VVCi/Graduate_Thesis/04_Multimedia/02_Images/2_08_2020/118745707_314784669589244_3505886685573848428_n.jpg

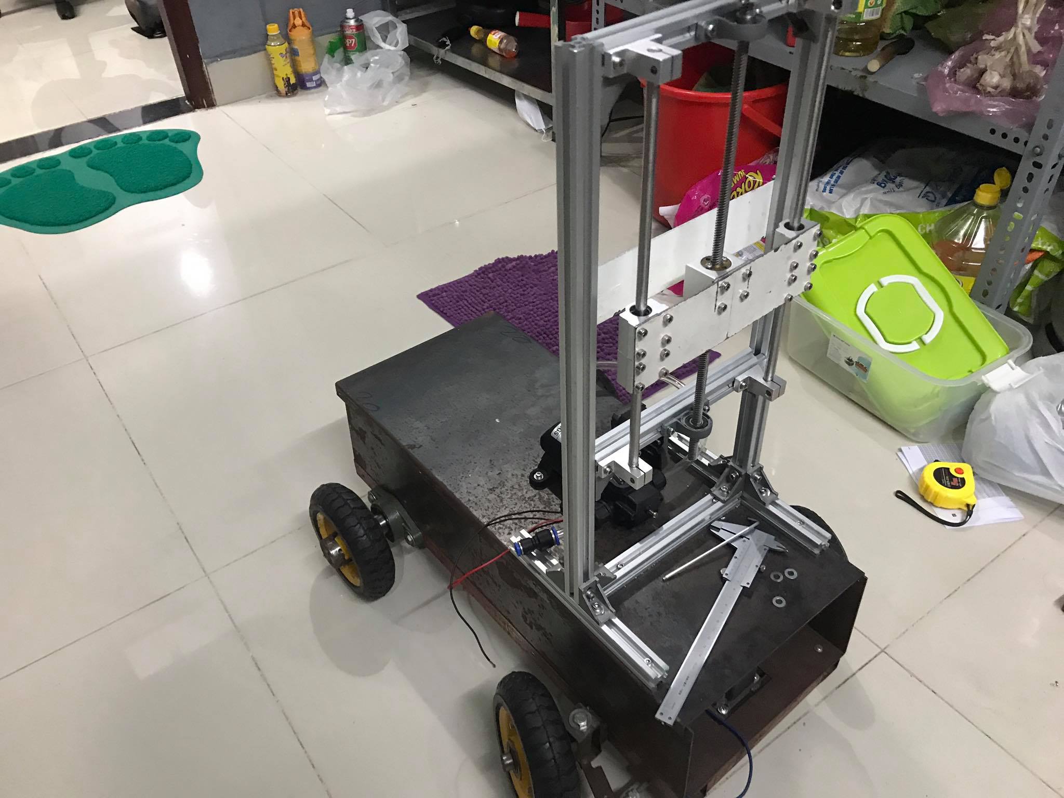
04_Multimedia/02_Images/2_08_2020/118745707_314784669589244_3505886685573848428_n.jpg
