VVCi/Graduate_Thesis/README.md

# Graduate_Thesis

/*
* @Mentor: PhD.Nguyen Vien Quoc - IUH
* @Research Subject: Semi-Automatic Pesticide Spraying Robot With Computer Vision Application (Thesis)
* @Author:
* - Vu Van Co
* - Nguyen Bao An
* - Nguyen Minh Hung
* - Nguyen Phuc Tho
* @Date: 12/2019 - 12/2020
*/
