VVCi/Graduate_Thesis/08_Report/Chapter05/Chapter05.docx

Chương 5 TÍNH TOÁN VÀ THIẾT KẾ GIẢI THUẬT ĐIỀU KHIỂN

5.1 Giới thiệu về giải thuật điều khiển động cơ

5.1.1 Giới thiệu tổng quan

Hệ thống (System) bao gồm nhiều phần tử vật lí được sắp xếp trật tự theo một thể thống nhất nhằm đáp ứng các yêu cầu cụ thể. Hệ thống này có thể là nhân tạo: Hệ thống điều khiển nhà máy thủy điện, Hệ thống pin năng lượng mặt trời, Hệ Cơ điện tử,.. hoặc là tự nhiên: Hệ mặt trời, Hệ thần kinh con người,…

Về điều khiển (Control) thường được mang nghĩa là hành động điều chỉnh, hành động này hướng đến những tác vụ hay mục tiêu nào đó có chủ ý. Điều khiển có thể là sự chủ động của con người và cả sự vận hành tự nhiên. Đối với tầm nhìn của đề tài, chúng ta chỉ xét đến những Hệ thống điều khiển nhân tạo do con người làm chủ.

Như vậy, hệ thống điều khiển được hiểu là một tập hợp sắp xếp trật tự các phần tử vật lý theo một thể, để nó có thể tự điều chỉnh, định hướng và thực thi tác vụ cho riêng bản thân nó hoặc cho các hệ thống khác.

Đối với mỗi hệ thống điều khiển tự động thì việc tìm ra giải thuật điều khiển là vô cùng quan trọng. Nó quyết định tính đúng đắn và khả năng đáp ứng của hệ thống. Về thực tế, hệ thống có thể “đơn giản” hay “phức tạp” cũng phụ thuộc vào mức độ phức tạp của giải thuật điều khiển.

Tuy nhiên, một hệ thống có thể hoạt động được mà không cần có một giải thuật điều khiển tốt hoặc thậm chí không cần đến giải thuật điều khiển, ta nói nó thuộc dạng hệ thống điều khiển hở hoặc hệ thống tự do hoạt động theo mức logic, theo sự điều khiển trực tiếp bằng con người. Các hệ thống muốn hoạt động ổn định hơn hoặc cần phải xử lí nhiều tác vụ cho các ngõ vào/ra khác nhau thì nên xem xét và được đưa vào các hệ thống điều khiển riêng biệt.

5.1.2 Thành phần cơ bản của hệ thống điều khiển

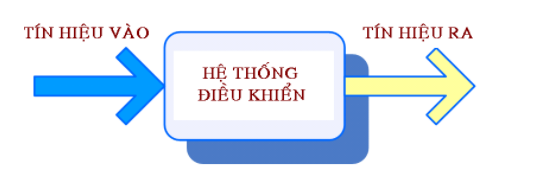
[picture p7: figure]

Hình 5 – Tổng quan về hệ thống điều khiển

Mục tiêu điều khiển còn được gọi là tín hiệu vào (input), hay các tín hiệu kích thích và kết quả nhận được từ hệ thống điều khiển còn được gọi là tín hiệu ra (output) hay các biến điều khiển.

Một cách tổng quát, đối tượng của hệ thống điều khiển được điều khiển để có các tín hiệu ra tuân theo qui định của tín hiệu vào thông qua các phần tử trong hệ thống điều khiển.

Tín hiệu vào là các tác nhân (hay kích thích) từ nguồn năng lượng ngoài cấp đến hệ thống điều khiển để tạo ra các đáp ứng mong muốn. Tín hiệu ra là các đáp ứng thực sự từ hệ thống điều khiển, có thể giống hay không giống đáp ứng mong muốn được xác định bởi các tín hiệu vào.

5.1.3 Lựa chọn giải thuật, phương pháp đề xuất

Đối với đề tài nghiên cứu, do đặc thù phải sử dụng nhiều loại động cơ với những chức năng khác nhau nên đòi hỏi cần phối hợp các bộ điều khiển khác nhau phù hợp với đặc tính tải của động cơ (được trình bày ở chương 2), có thể là “đơn giản” và cả “phức tạp”. Về cơ bản, chúng tôi sử dụng 2 bộ điều khiển chính, tạm thời được gọi là Bộ điều khiển vòng hở (open - loop) và Bộ điều khiển vòng kín (closed-loop). Cả hai bộ điều khiển này cũng thường được sử dụng trong kĩ thuật điều khiển, ứng dụng thực tiễn trong các hệ thống tự động của các ngành điện tử, viễn thông, cơ khí, ..

Bộ điều khiển vòng hở được sử dụng cho các động cơ sau trong đề tài:

- Động cơ bước DC (Stepper DC Motor) dùng cho cơ cấu nâng hạ dàn phun.

- Động cơ DC máy bơm (Normal DC Motor) dùng cho bộ phận bơm thuốc.

- Động cơ DC giảm tốc (Greared DC Motor) dùng cho tải chính robot.

Bộ điều khiển vòng kín được sử dụng cho các động cơ sau trong đề tài: Động cơ DC Servo (DC Servo Motor) cho bộ phận chuyển hướng robot.

5.1.4 Bộ điều khiển vòng hở

Đặc thù điều khiển của các dạng động cơ Stepper DC Motor, Normal DC Motor, Greared DC Motor như đã trình bày ở trên về cơ bản là gần giống nhau. Hơn thế, động cơ DC giảm tốc là động cơ chính của hệ robot nên chúng tôi chỉ khảo sát và trình bày rõ về bộ điều khiển hở cho động cơ này.

Về cơ bản, Bộ điều khiển vòng hở có tác động điều khiển độc lập với tín hiệu ngõ ra. Ưu điểm hơn cả của bộ điều khiển này là có khả năng đạt độ chính xác bằng phương pháp thử (calibrate). Việc thử là thành lập hoặc tái thiết quan hệ giữa ngõ ra và ngõ vào theo mức chính xác mong muốn. Hệ thống điều khiển vòng hở có ưu điểm nối trổi là dễ thiết lập quy tắc điều khiển và gọn nhẹ. Tuy nhiên, độ chính xác điều khiển thấp và không đem đến khả năng đáp ứng tốt của hệ thống là nhược điểm cố hữu của bộ điều khiển dạng này.

Controller
Object

Tín hiệu tác động (u)

Biến được kiểm soát (c)

Tín hiệu tham chiếu (r)

Hình 5 Tổng quan về bộ điều khiển hở

Để điều khiển động cơ Greared DC Motor (tạm gọi là động cơ DC), chúng tôi sử dụng phương pháp PWM (Điều chế độ rộng xung – Pulse Width Modulation).

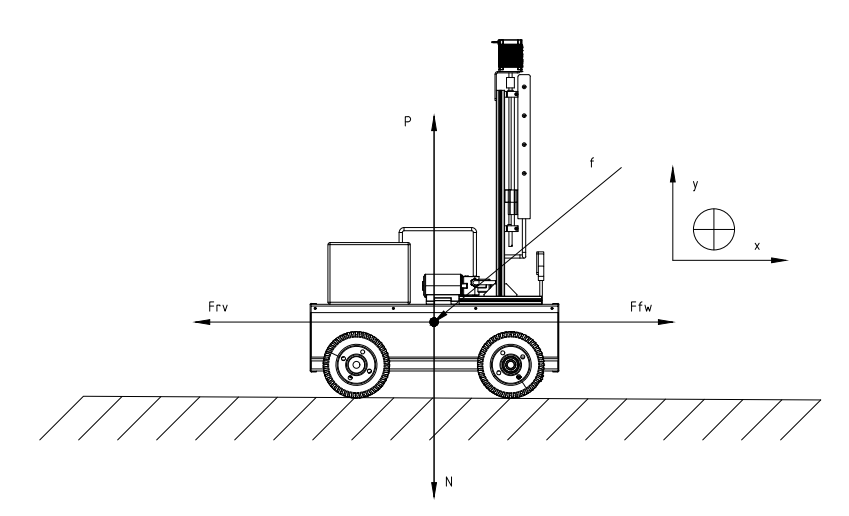
[picture p8: figure]

Hình 5 Mô hình chuyển động tới – lui của robot phun thuốc BVTV với các nội lực và ngoại lực

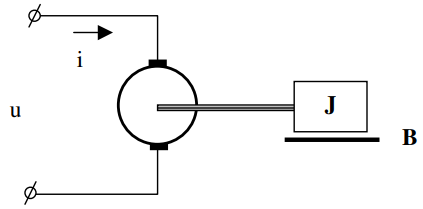
[picture p9: figure]

Trước hết, ta sẽ tìm hàm truyền đạt của động cơ, một mô hình của động cơ DC được khái quát với dạng như sau:

Giả sử từ thông Φ=const , J là moment quán tính quy về trục động cơ, B là hệ số ma sát của trục.

Phương trình quan hệ điện áp phần ứng:

u=Ri+L(di)/(dt)+e_u

e_u = K_e Φω

Suy ra:

u=Ri+L(di)/(dt)+ K_e Φω (5.1)

Phương trình quan hệ moment trên trục động cơ:

K_i Φω=J(dω)/(dt)+Bω (5.2)

Thay (5.1) vào (5.2), ta được:

u= R/(K_i) ( J(dω)/(dx)+Bω)+L/(K_i Φ) (J(d^2 ω)/(dt^2)+B(dω)/(dx))+ K_e Φω

- u=(LJ)/(K_i Φ) (d^2 ω)/(dt^2)+ (RJ+LB)/(K_i Φ) (dω)/(dt)+ ((RB)/(K_i Φ)+ K_e Φ)ω

Vậy:

U(p)= (a_2 p^2 +a_2 p+a_o ) ω(p)

Với a_2 = (LJ)/(K_i Φ) ; a_1 = (RJ+LB)/(K_i Φ) ; a_0 = ((RB)/(K_i Φ)+ K_e Φ)

Vậy hàm truyền đạt của động cơ là:

W(p)= (ω (p))/(U (p))= 1/(a_2 p^2 + a_2 p+ a_0) (5.3)

Ta sẽ thiết lập nguyên lí điều khiển động cơ với:

u: Tín hiệu vào là điện áp phần ứng động cơ

ω: Tín hiệu ra là góc quay của trục động cơ

e(t)=u.(t_H)/T (5.4)

Trong đó:

t_H (Time HIGH): Tần số động cơ được vận hành (s)

T : Chu kì điều khiển (s)

e(t): Hàm truyền đạt

Quan hệ ngõ vào – ra này trên lí thuyết có thể xem là tuyến tính, tuy nhiên trong điều kiện thực tế, giá trị đáp ứng của động cơ DC sẽ là phi tuyến, đồ thị duty sẽ xuất hiện nhiễu gai.

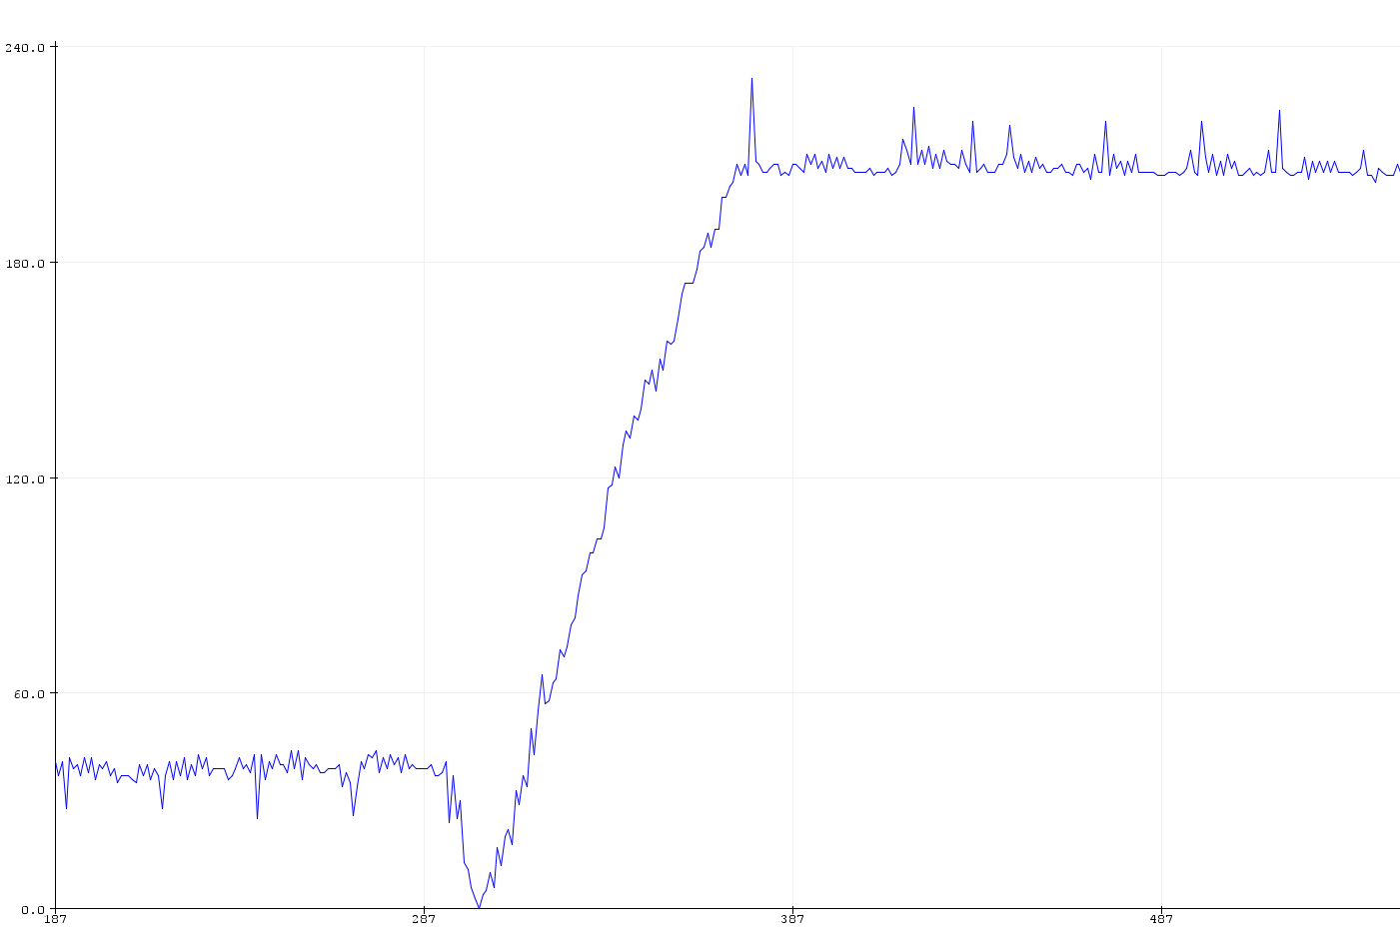
[picture p10: figure]

Nhiễu phi tuyến

Vùng hoạt động

Timing

Duty

Vùng “điểm chết” (dead zone) của động cơ

Hình 5 Đồ thị đáp ứng dạng phi tuyến của động cơ DC trong thực tế

Có thể tham khảo phần khảo sát đặc tính tải của động cơ DC tại chương 2 và phần thực nghiệm tại chương 6 để hiểu rõ hơn. Do đó với bộ điều khiển hở cho động cơ DC, cần có phương pháp tuyến tính hóa (Liner Regession) để quy về dạng tuyến tính, thuận tiện cho việc điều khiển.

Theo như sơ đồ nguyên lí của hệ thống được thiết kế từ đầu, động cơ DC hoàn toàn được điều khiển từ xung PPM từ tay cầm. Do đó chúng ta sẽ xét sự ảnh hưởng của xung này đến duty của động cơ theo thời gian. Xung PPM từ tay cầm FlySky FS – TH9X được trả về giá trị timing (ms) ( thời gian tín hiệu ở mức cao hoặc xung thấp)

Khảo sát lí thuyết từ MCU bằng hàm pulseIn(channel, timeout), trong đó

- channel: Kênh tín hiệu trả về từ bộ thu Reciever (chúng tôi sử dụng channel 1 ~ channel 4)

- timeout: Thời gian chờ

Hàm pulseIn() sẽ trả về data là một giá trị số (s) biến thiên tuyến tính từ thấp đến cao. Do đó chúng tôi dễ dàng mô hình phương thức điều khiển từ tay cầm về động cơ DC bằng bảng tham số của 3 trường hợp điều khiển như sau:

Trạng thái tay cầm | Gạt xuống thấp | Trạng thái ban đầu | Gạt lên cao
Xung PPM(s) - HIGH | 1050 | 1490 - 1510 | 1910
Duty Cycle (%) | 100 | 0 | 100
Điện áp cung cấp cho DC Motor (V) | 24 | 0 | 24
Trạng thái vận hành động cơ DC | Nhanh – Chạy nghịch | Chờ (Standby) - OFF | Nhanh – Chạy thuận

Việc chuyển đổi từ tín hiệu xung PPM từ tay cầm FlySky FS – TH9X sang tín hiệu Duty như mong muốn được thực hiện theo tiến trình như sau:

Digital I/O - Hàm đọc PPM pulseIn() từ Reciever
Chặn biên xung PPM - hàm chặn biên constrain()
Chuyển đổi tam suất tuyến tính - hàm chuyển đổi map()
Điều chế độ rộng xung PWM digitalWrite()Hình 5 – Tiến trình xử lí tín hiệu PPM thành tín hiệu PWM

Hàm đọc PPM pulseIn(): Hàm số đọc tín hiệu PPM từ bộ thu Reciever.

Hàm chặn biên constrain(): Hàm số ràng buộc giá trị nằm trong khoảng cho trước thường được sử dụng trong MCU Mega2560.

Cú pháp constrain (x, a, b);

- x: giá trị cần xét
- a: Chặn dưới (a là giá trị nhỏ nhất của khoảng)
- b: Chặn trên (b là giá trị lớn nhất của khoảng)

Hàm chuyển đổi tuyến tính map(): Hàm số chuyển đổi thang đo từ giá trị này sang thang đo khác, giá trị trả về của hàm này là một số nguyên.

Cú pháp map(value, a1, a2, b1, b2);

- value: Giá trị cần chuyển đổi
- a1, a2: Giới hạn trên dưới của thang đo cần chuyển đổi
- b1, b2: Giới hạn trên dưới của thang đó hiện tại

Hàm chiều đế độ rộng xung analogWrite(): Hàm số xuất tín hiệu analog (phát xung PWM) thường được dùng trên MCU Mega2560

Cú pháp analogWrite([chân phát xung PWM], [giá trị xung PWM]);

Giá trị xung PWM nằm khoảng 0 đến 255, tương ứng mức Duty Cycle từ 0% đến 100%

Từ phương trình điều khiển hở cho Greared DC Motor (5.4) và quan hệ giữa tín hiệu PPM - Duty Cycle của động cơ DC Motor đã trình bày ở trên, ta có thể sử dụng để điều khiển lực thông qua Duty Cycle.

Bảng dưới mô tả cách thức sử dụng tay cầm FlySky FS – TH9X điều khiển vòng hở động cơ DC với kênh số 2. Tín hiệu truyền đi thông qua sóng RF phát từ tay cầm.

Trạng thái tay cầm | | Duty

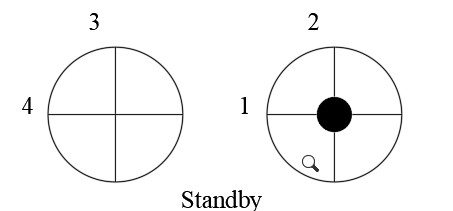
[picture p11: figure]
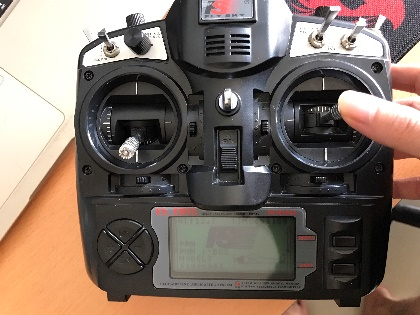
[picture p12: figure]

| | 0%

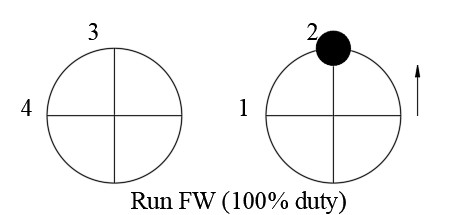
[picture p13: figure]
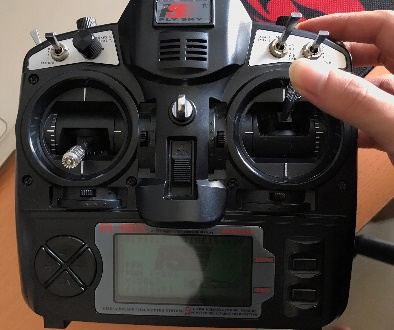
[picture p14: figure]

| | 100% (chạy thuận)

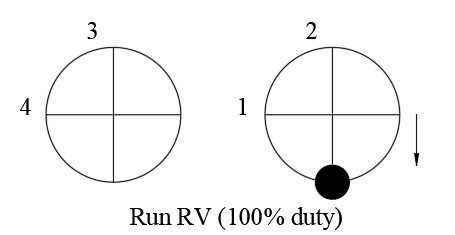
[picture p15: figure]
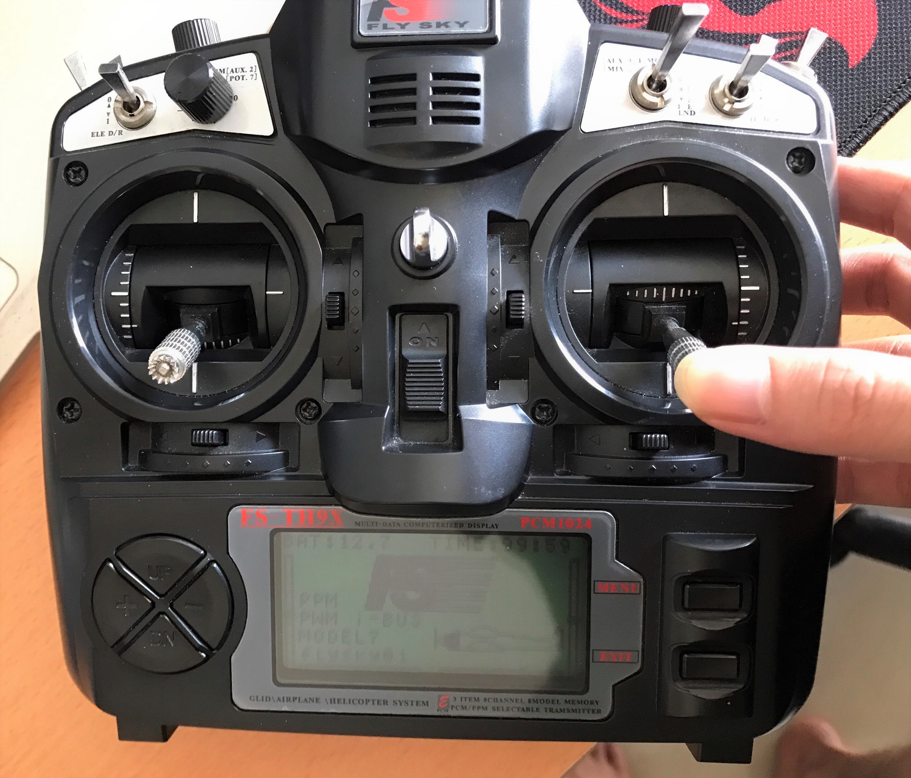
[picture p16: figure]

| | 100% (chạy nghịch)

Tuy nhiên thí nghiệm chương 2 đã chứng tỏ khả năng điều khiển động cơ bằng phương pháp PWM thông thường đem đến độ chính xác không cao. Do đó, nó chỉ phù hợp cho các cơ cấu không đòi hỏi độ chính xác cao trong đề tài: Cơ cấu tải chính, Cơ cấu nâng hạ dàn phun, Bộ phận máy bơm. Vì bản thân độ chính xác của hệ thống cơ khí là không lí tưởng như điều kiện của phương trình và bản thân của phương trình điều khiển lực theo Duty Cycle chỉ chính xác tương đối do các sai số trong đo lường.

5.1.5 Bộ điều khiển kín – Giải thuật PID/PI/PD

5.1.5.1 Bộ điều khiển kín

Xét một mô hình điều khiển vòng kín chuẩn như sau:

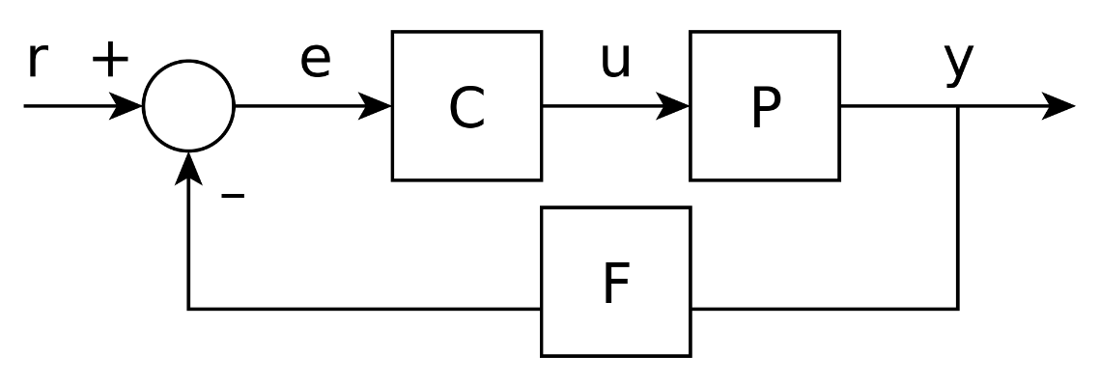
[picture p17: figure]

Hình 5 – Mô hình hệ thống điều khiển chuẩn thường dùng trong kĩ thuật

Trong đó:

- P (Object): Đối tượng điều khiển của hệ thống
- C (Controller): Bộ điều khiển, hiệu chỉnh
- F (Measurement): Cơ cấu đo lường

Các tín hiệu có trong hệ thống điều khiển dạng này thường thấy:

- u: Tín hiệu vào (Tín hiệu điều khiển)
- y: Tín hiệu ra
- f: Các tác động ngoại lực bên ngoài
- z: Tín hiệu phản hồi (đối với hệ thống điều khiển vòng kín)
- e: Sai lệch điều khiển (đối với hệ thống điều khiển vòng kín)

Đầu ra của hệ thống y(t) được hồi tiếp qua một cảm biến đo lường F (có thể là encoder, tahometer,..) để so sánh với giá trị đặt trước r(t). Bộ điều khiển C lấy sai số e (độ chênh lệch) giữa giá trị đặt và tín hiệu đầu ra để thay đổi đầu vào u(t) cho đối tượng mục tiêu P. Điều này được thể hiện như trong hình vẽ bên trên. Loại này là điều khiển vòng kín hay còn gọi là điều khiển hồi tiếp.

Nếu chúng ta giả thiết bộ điều khiển C, cơ cấu P, và cảm biến F là tuyến tính và bất biến theo thời gian (ví dụ: các yếu tố trong hàm truyền C(s), P(s), và F(s) của chúng không phụ thuộc vào thời gian), hệ thống trên có thể được phân tích sử dụng phép biến đổi Laplace vào các biến. Điều này đưa tới những quan hệ sau:

Y(s)=P(s)U(s)

U(s)=C(s)E(s)

E(s)=R(s)E(s)

Tìm Y(s) theo R(s) ta được:

Y(s)= ((P(s)C(s))/(1+F(s)P(s)C(s)))R(s)=H(s)R(s)

Biểu thức H(s)=(P(s)C(s))/(1+F(s)P(s)C(s)) chính là hàm truyền vòng kín của hệ thống. Tử số là độ lợi phía trên (vòng hở) thu được từ r đến y, mẫu số là 1 cộng dồn với độ lợi xung quanh hồi tiếp (gọi là độ lợi vòng lặp). Nếu P(s)C(s) >> 1 có nghĩa là nó có một tiêu chuẩn lớn với mỗi giá trị của s, và nếu |F(s)| ≈0 thì Y(s) xấp xỉ bằng R(s) . Do đó hệ thống này thường được cài giá trị đặt trước để điều khiển ngõ ra.

Hệ trên là một hệ điều khiển một đầu vào, một đầu ra (SISO); hệ thống MIMO (Nhiều đầu vào, nhiều đầu ra), với nhiều hơn một đầu vào/đầu ra thì phổ biến hơn. Trong trường hợp này các biến được biểu diễn qua các vector thay vì các giá trị vô hướng đơn giản. Trong vài hệ thống tham số phân thán, các vector có thể là có chiều vô hạn (các hàm đặc trưng – hàm truyền). Tuy nhiên xét về phạm vi của đề tài, chúng tôi chỉ sử dụng hệ SISO cho duy nhất động cơ bẻ lái DC Servo Motor (tạm gọi là động cơ Servo) với bộ điều khiển hồi tiếp PI.

5.1.5.2 Bộ điều khiển PID/PI/PD

5.1.5.2.1 Tổng quan

Bộ điều khiển PID viết tắt của Proportional (tỉ lệ) – Integral (tích phân) – Derivative (đạo hàm), được xem là bộ điều khiển hồi tiếp được sử dụng nhiều nhất trong ứng dụng điều khiển tự động với độ chính xác (accurate), đáp ứng nhanh (fast response) với độ ổn định cao (small overshoot). PID là từ đề cập đến 3 khâu hoạt động trên tín hiệu sai số để tạo ra một tín hiệu điều khiển.

Nếu u(t) là tín hiệu điều khiển gửi tới hệ thống, y(t) là đầu ra đo được và r(t) là đầu ra mong muốn, thì sai số theo dõi được hình thành là e(t)=r(t)-y(t) . Việc triển khai bộ điều khiển với sự đáp ứng nhanh thì đơn giản hóa là sử dụng hàm tuyến tính:

u(t)=K_P e(t)

Viết lại với hệ thống điều khiển động cơ Servo: F(t)=K_P e(t)

Trong đó:

u(t) : Hàm ngõ ra (hàm F(t) )

K_P : Độ lợi tỉ lệ

e : Độ sai lệch ( e(t)=r(t)-y(t) )

t : Thời gian

K_P là một hằng số (dương) nào đó mà chúng ta gọi là P (Proportional Gain), e là sai số cần điều khiển. Mục tiêu ở đây là đưa e (sai số) tiến về 0 càng nhanh càng tốt. Chúng ta nhận thấy, nếu K_P lớn thì sự tác động nhanh của bộ điều khiển cũng lớn. Tuy nhiên, do quán tính nên việc điều khiển nhanh này dễ gây ra hiện tượng mất ổn định, điều này xảy ra do lực quán tính của động cơ và lực điều khiển tạo ra 2 dao động liên tiếp nhau, điều này gây ra dao động mất kiểm soát và ảnh hưởng cực kì xấu đến chất lượng điều khiển cũng như tuổi thọ của động cơ.

Như vậy, chúng ta sẽ sử dụng đạo hàm của sai số e để làm tăng giá trị nhưng ngược chiều lực của động cơ. Đạo hàm này sẽ hãm lại vọt lố (overshoot) trong quá trình điều khiển. Đây chính là thành phần D (Derivative Gain) trong bộ PID. Chúng ta thu được bộ điều khiển như sau: F(t)=K_P e(t)+ K_D d/(dt)e(t)

Trong đó:

u(t) : Hàm ngõ ra (hàm F(t) )

K_D : Độ lợi vi phân

e : Độ sai lệch ( e(t)=r(t)-y(t) )

t : Thời gian

Trong đó, d/(dt)e(t) chính là vận tốc thay đổi của sai số e(t) theo thời gian và K_D là một hằng số không âm, gọi là hệ số D. Thành phần hệ số D này làm giảm overshoot của đối tượng điều khiển khi nó tiến về trạng thái cân bằng – vị trí ổn định. Lực F bao gồm 2 thành phần K_P e >= 0 (thành phần P) và K_D d/(dt)e(t) <= 0 (thành phần D). Đôi khi thành phần D có giá trị lớn hơn hẳn thành phần P và lực F của động cơ đổi chiều, hãm tốc lại, lúc này yếu tố cần điều khiển (vị trí, tốc độ,…) của đối tượng giảm mạnh tại vị trí cân bằng. Điều này dẫn đến vấn đề nảy sinh là nếu thành phần D lớn hơn thành phần P hoặc bản thân thành phần P nhỏ thì sẽ xảy ra hiện tượng khi tiến gần đến vị trí cân bằng (thực tế là trong trường hợp này sẽ không bao giờ đến vị trí cân bằng) thì động cơ đã dừng, thành phần D về 0 (vì e không còn thay đổi nữa). Khi này lực của động cơ là F = K_P e(t) , thêm vào đó, K_P và e lúc này đều nhỏ nên không thắng được ma sát tĩnh của động cơ (điểm chết - Dead Zone của động cơ). Sai số e lúc này được gọi là sai số trạng thái tĩnh (Steady State Error). Để tránh xảy ra trường hợp này, người ta lại thêm một thành phần có khả năng cộng dồn sai số.

Khi steady state error xảy ra, 2 thành phần P và D mất tác dụng điều khiển, thành phần điều khiển mới này sẽ cộng dồn sai số theo thời gian, do đó lực F sẽ tăng lên theo thời gian. Đến một lúc nào đó, lực F đủ lớn để thắng ma sát tĩnh, đẩy đối tượng đến vị trí mong muốn. Thành phần cộng dồn này chính là I (Intergral Gain) trong bộ điều khiển PID. Đến đây, chúng ta đã hoàn thiện bộ điều khiển PID với dạng tổng quát như sau:

F(t)=K_P e(t)+K_I ∫ e(t)dt+ K_D d/(dt)e(t)

Trong đó:

u(t) : Hàm ngõ ra (hàm F(t) )

K_I : Độ lợi tích phân

e : Độ sai lệch ( e(t)=r(t)-y(t) )

t : Thời gian

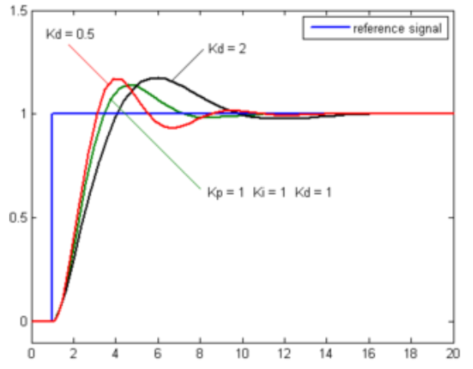
[picture p18: figure]
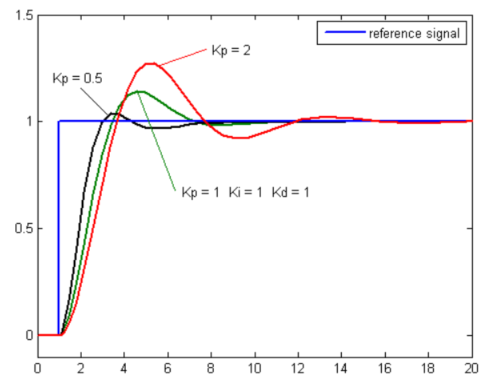
[picture p19: figure]

Tuy nhiên, tùy vào mục đích sử dụng cụ thể, có thể tùy chỉnh sử dụng bộ PID, PD, PI bằng cách cho các hệ số không dùng về 0.

Figure 2 Đồ thị hàm số theo thời gian,
ba giá trị Kd (Ki, Kp là hằng số)

Figure 3 – Đồ thị hàm số theo thời gian,
ba giá trị Kp (Ki, Kd là hằng số)

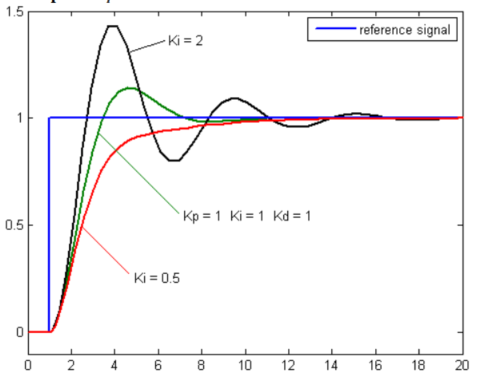
[picture p20: figure]

Figure 4 Đồ thị hàm số theo thời gian,
ba giá trị Ki (Kd, Kp là hằng số)

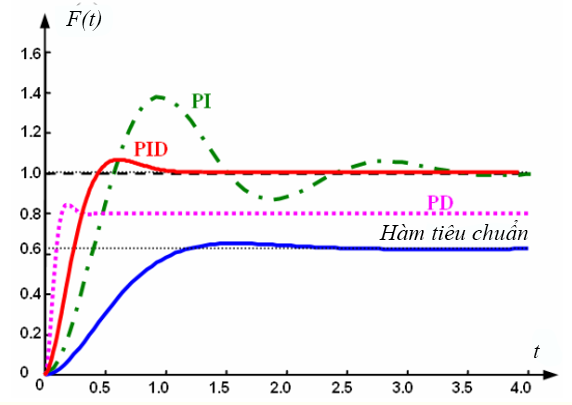
[picture p21: figure]

Hình 5 – Đồ thị mô phỏng đáp ứng của bộ PID, PD, PI và bộ điều khiển hở tiêu chuẩn

Đối với đề tài nghiên cứu, chúng tôi sử dụng bộ điều khiển PI vì những lí do sau:

- Giảm tính phức tạp của bộ điều khiển
- Robot di chuyển chậm với tốc độ dao động 1.3 ~ 3km/h do đó không cần yêu cầu xử lí bẻ lái động cơ nhanh. Yêu cầu về thời gian xác lập không cao.
- Robot cần bẻ lái với góc tương đối chính xác do yêu cầu thực địa từ nhà màng với diện tích nhỏ, bán kính bẻ lái bị giới hạn.

Bộ PI tuy có thời gian xác lập chậm nhưng đem đến khả năng đáp ứng chính xác, do đó sẽ lựa chọn phù hợp cho đề tài để giảm thiểu độ phức tạp và gánh nặng cho MCU. Đến đây, công việc chính của việc thiết kế là chuyển đổi (porting) lí thuyết của hàm PID vào mã nguồn của MCU và lựa chọn các hệ số K_P , K_I , K_D sao cho hợp lí nhất.

Việc lựa chọn K_P , K_I , K_D thực ra đòi hỏi tuân theo các tiêu chuẩn ổn định (stability criteria) hoặc các phương pháp chọn hệ số (Ziegler – Nichols, bằng tay, bằng phần mềm,…). Tuy nhiên, việc áp dụng các tiêu chuẩn này thường phức tạp và mất thời gian, thay vào đó, chúng tôi sử dụng phương án chọn hệ số bằng tay (chọn theo kinh nghiệm).

Quả khảo sát đã thực nghiệm được xem xét ở chương số 6 và kinh nghiệm chọn hệ số K_P , K_I , K_D đã tổng hợp được, chúng tôi xin được tóm tắt cơ bản cách chọn hệ số như sau:

- Đặt hệ số K_P K_D , K_I = 0.
- Chọn hệ số K_P trước, thử hệ thống với đối tượng thật (động cơ DC Servo) và đọc các giá trị hồi tiếp (Encoder, biến trở..). Chọn giá trị nhỏ nhất cho K_P (thông thường là từ 0.01 đối với hệ thống thông dụng). Tăng K_P đến khi vọt lố (overshoot) xảy ra. Điều chỉnh tăng K_P sao cho thời gian đáp ứng đủ nhanh và overshoot nhỏ trong mức cho phép (vọt lố không còn xuất hiện hoặc chu kì xuất hiện vọt lố thấp nhất có thể). Việc chọn K_P ngay từ ban đầu được xem là quan trọng nhất, kinh nghiệm là tăng K_P đến khi overshoot thì giảm đi 1/2, tiến hành tăng K_I .
- Nếu sử dụng bộ PD thì không chọn K_I và ngược lại, sử dụng bộ PI thì không chọn K_D .
- Tăng K_I từ bé đến lớn (thông thường là từ 0.01 đối với hệ thống thông dụng) và ngăn không cho overshoot xuất hiện.
- Tăng K_D để loại bỏ hẳn overshoot, tăng K_D từ từ kết hợp thử sai để chọn giá trị thích hợp. Khả năng hiện tượng Steady State Error sẽ xảy ra, lúc này dừng chọn K_D . Theo kinh nghiệm, nên chọn K_D ≈1/1000 K_P .

Như đã trình bày, nếu có thể chọn các hệ số K_P , K_I , K_D bằng các tiêu chuẩn ổn định hoặc bằng phương pháp hiệu chỉnh Ziegler – Nichols thì sẽ cho ra các hệ số chính xác và tốt hơn hẳn phương pháp chọn bằng kinh nghiệm.

5.1.5.2.2 Ứng dụng bộ điều khiển PI vào DC Servo Motor trong Robot

Bộ PI sẽ được chọn sử dụng điều khiển trong đề tài, nhưng trước hết cần có phương pháp chuyển đổi (porting) lí thuyết điều khiển PI về dạng số rời rạc để thuận tiện cho việc lập trình trên MCU. Ở đây, để tổng quát hóa, chúng tôi vẫn sẽ trình bày cách thức chuyển đổi số cả bộ PID, mặc định khi chọn hệ số K_D chúng tôi sẽ cho bằng 0.

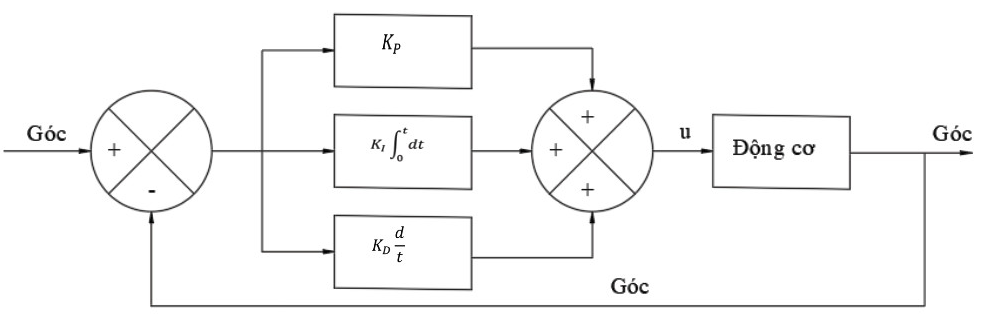
[picture p22: figure]

Encoder

Figure 5 Mô hình điều khiển DC Servo bẻ lái

Dạng mô hình điều khiển PID liên tục có được:

G_(PID) (s)= K_P + (K_I)/s+ K_D s (1)

Trong đó:

- K_P (hệ số tỉ lệ)
- K_I (hệ số tích phân), K_I = (K_P)/(T_i)
- K_D (hệ số vi phân), K_D = K_P * T_D
- T_i : Thời gian tích phân

Chuyển đổi thành bộ PID rời rạc:

- Rời rạc hóa khâu tích phân: s→ 2/T× (z-1)/(z+1)

- Rời rạc hóa khâu vi phân: s→ (z-1)/(T*z)

Thay vào bộ điều khiển PID liên tục (1), ta được:

G_(PID) (z)= (U(z))/(E(z))=K_P + K_I × T/2 × (z+1)/(z-1)+ (K_D)/T× (z-1)/z

G_(PID) (z)= (a_0 + a_1 ×z^(-1) + a_2 × z^(-2))/(1- z^(-1))

Trong đó:

Đặt a_0 = K_P + (K_I T)/2+ (K_D)/T ;

a_1 =-K_P + (K_I T)/2- (K_D)/T

a_2 = (K_D)/(2T)

Khi này, hàm ngõ ra điều khiển sẽ có dạng: u(k)= G_(PID) (z)e(k)

→ Công thức hàm điều khiển PID số:

u(k)=u(k-1)+ a_0 e(k)+ a_1 e(k-1)+a_2 e(k-2) ) (2)

Trong đó:

e(k) : Sai số hiện tại

e(k-1) : Sai số trước lần thứ k

e(k-2) : Sai số trước lần thứ k-1

Trên thực tế sử dụng, đôi khi người ta sử dụng bộ PID số mà chỉ lấy mẫu sai số hiện tại e(k) , bỏ qua các sai số quá khứ, điều này là không sai nhưng chưa phát huy hết tính chính xác và khả năng lấy mẫu của bộ điều khiển. Bộ PID số theo công thức (2) trên có thành phần I càng ngày càng nhỏ và phù hợp hơn. Do đó với đặc thù của đề tài, chúng tôi điều khiển động cơ DC Servo với setpoint thay đổi lớn và liên tục (trong trường hợp này là điều khiển vị trí encoder với độ phân giải lên đến 1000 xung/vòng), nếu chỉ dùng phương pháp lấy mẫu một lần thì sai số tích lũy cộng dồn sẽ rất lớn, lớn đến một mức nào đó mà khi đã xác lập rồi thành phần I vẫn dương dẫn đến vọt lố, sau một thời gian vọt lố, thành phần I mới giảm dần về trạng thái cân bằng. Sử dụng bộ PID số theo công thức (2) sẽ hạn chế được điểm yếu này.

Thời gian lấy mẫu: Bộ PID số rời rạc trình bày theo công thức (2) và cũng như các bộ PID lí thuyết khác ngoài việc phụ thuộc rất lớn vào các hệ số K_P , K_I , K_D thì còn phụ thuộc vào chu kì lấy mẫu T (chu kì T càng nhỏ là càng tốt). Trong MCU Mega2560, chúng tôi sử dụng cơ chế ngắt (Interrupt) với hàm attachInterrupt() và thư viện định thời timer3.h(open source), bộ ngắt này tuy chúng tôi chưa thể can thiệp sâu vào quá trình như trên các dòng MCU lõi ARM mới hơn như STM32, TI nhưng có thể cài đặt timeout định thời lấy mẫu.

Cú pháp hàm ngắt lấy mẫu Encoder: attachInterrupt( interrupt, ISR, mode )

- Interrupt: Số thứ tự chân ngắt, ở đây sử dụng 1 chân ngắt số 2 cho kênh A của Encoder, chân digital thông thường số 4 sử dụng cho kênh B của Encoder
- ISR(Interrupt Service Routine): Trình phục vụ ngắt, tên hàm gọi đến khi sự kiện ngắt xảy ra sẽ được thực thi (ở đây là chuỗi hàm target xử lí tính toán PI)
- mode: Kiểu kích hoạt ngắt

+ LOW: Kích hoạt liên tục khi trạng thái chân digital mức thấp.

+ HIGH: Kích hoạt liên tục khi trạng thái chân digital mức cao.

+ RISING: Kích hoạt khi trạng thái của chân digital chuyển từ mức điện áp thấp sang mức điện áp cao.

+ FALLING: Kích hoạt khi trạng thái của chân digital chuyển từ mức điện áp cao sang mức điện áp thấp.

Ở đây chúng tôi sử dụng cấu hình: attachInterrupt( channelA, PIDCompute(), HIGH ). Trong đó, channelA được cấu hình là chân digital số 2 để đọc xung channel A từ đĩa encoder quang của động cơ DC Servo, PIDCompute() là chuỗi hàm xử lí bộ điều khiển sau ngắt, kiểu kích hoạt ngắt là HIGH.

Các hàm ngắt và định thời này sẽ được đặt kết hợp trong phần setup của chương trình (bên ngoài chương trình chính) và bên trong chương trình chính. Hình bên dưới mô tả quá trình sự kiện ngắt diễn ra trên chương trình với một chu kì T.

Bật cờ, cài định thời:
Timer3.initialize()

Cho phép ngắt: interrupts()

Đọc giá trị Encoder hồi tiếp
Hàm xử lí số liệu PI
Hàm PWM động cơ Servo
Các hàm cần thiết, thời gian dự phòng
Chu kì mới

Thanh ghi MCU

Hủy ngắt:
noInterrupts()

Chu trình xử lí
hàm ISR

Hàm ngắt đọc Encoder:
Timer3.attachInterrupt()

`

Chu kì T

t_1

t_2

t_3

t_4

Đối với cách thức điều khiển động cơ DC Servo, động cơ có 2 chế độ vận hành là tự động dẫn hướng bằng hình ảnh và điều khiển bằng tay cầm. Hình dưới đây mô tả 2 cách thức điều khiển động cơ bằng cách đặt setpoint (ở đây là góc đặt) cho động cơ.

Hình dưới mô tả cách sử dụng tay cầm FlySky FS – TH9X điều khiển động cơ vòng kín động cơ DC Servo với kênh số 4. Tín hiệu truyền đi thông qua sóng RF phát đi từ tay cầm.

Trạng thái tay cầm | | Góc

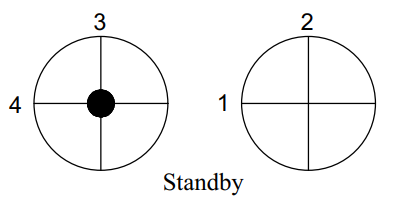
[picture p23: figure]
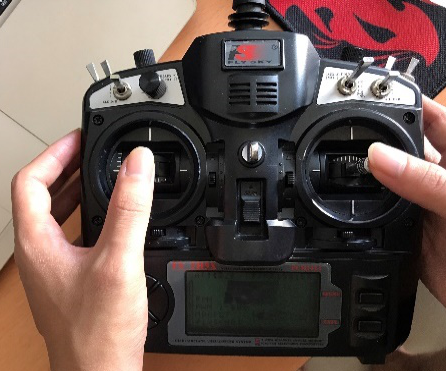
[picture p24: figure]

| | 0°

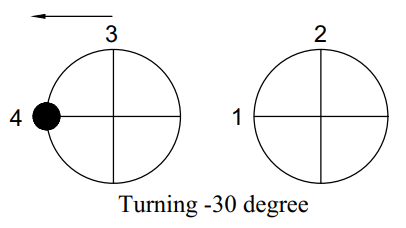
[picture p25: figure]
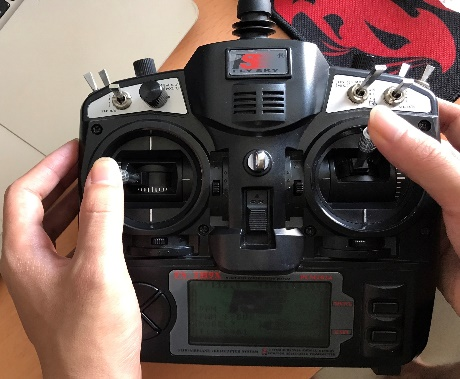
[picture p26: figure]

| | -30°

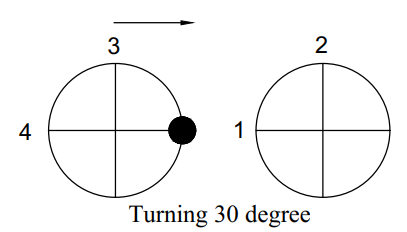
[picture p27: figure]
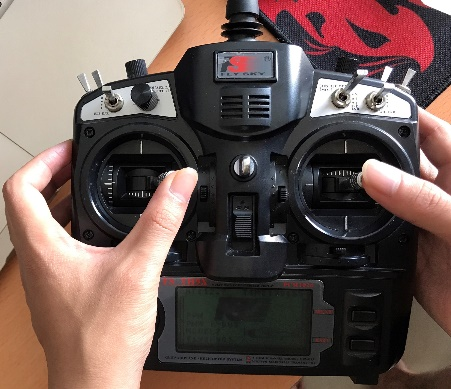
[picture p28: figure]

| | 30°

Hình dưới mô tả cách robot tự điều khiển động cơ servo thông qua tín hiệu UART hồi tiếp từ camera. Hình ảnh tín hiệu được trích xuất từ giao diện đồ họa Qt Creator trên Linux OS.

Trạng thái hình ảnh của đối tượng | Góc

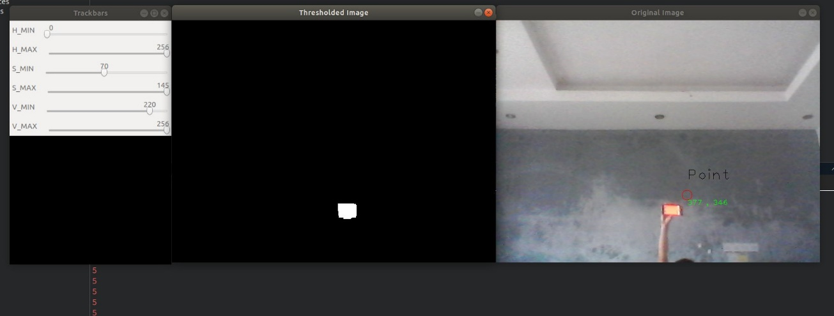
[picture p29: figure]

| 0°

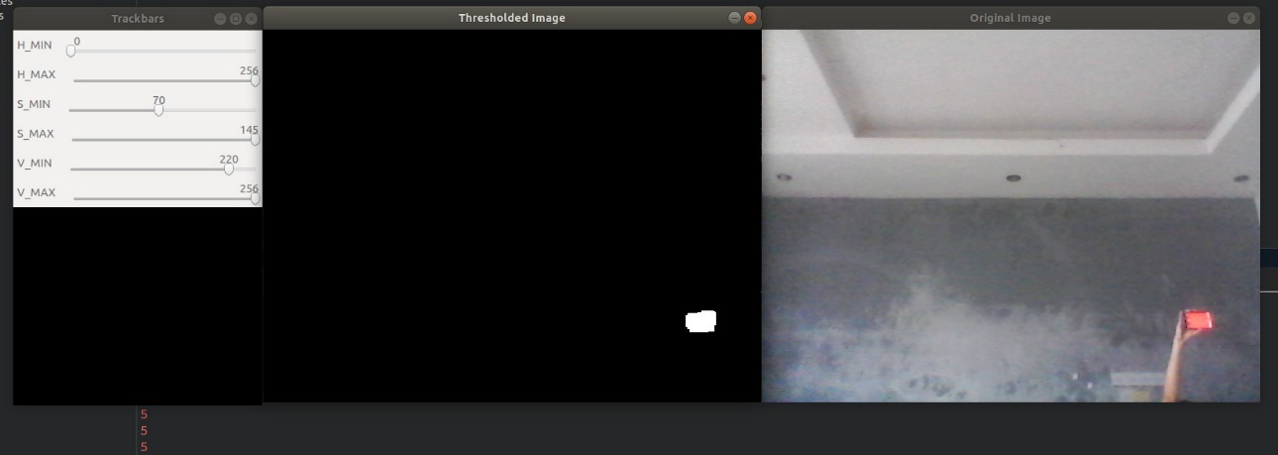
[picture p30: figure]

| -30°

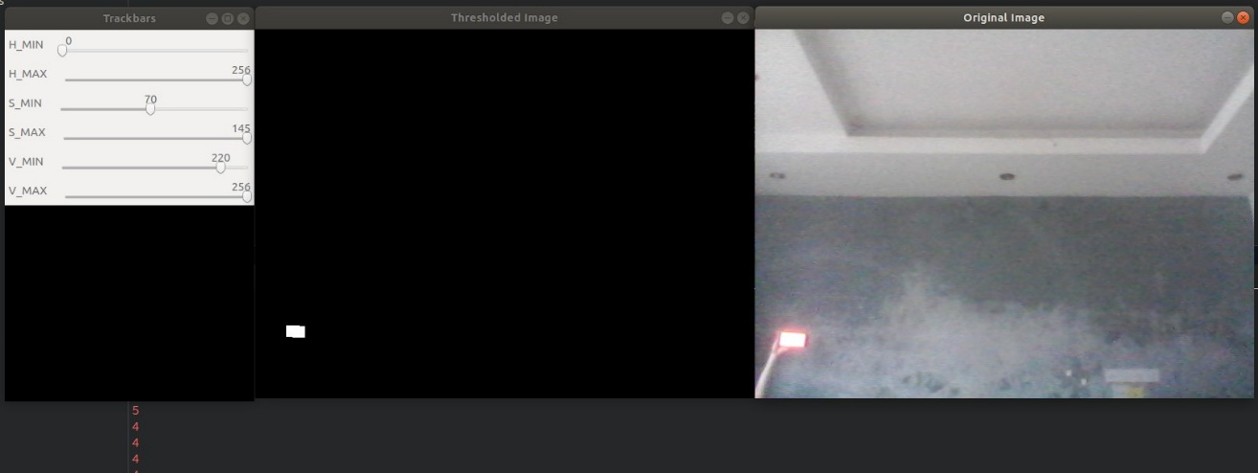
[picture p31: figure]

| 30°
