VVCi/Graduate_Thesis/08_Report/Chapter06/Chapter6.docx

THÍ NGHIỆM VÀ KẾT QUẢ THỰC NGHIỆM

6.1 Thực nghiệm đặc tính tải và giải thuật điều khiển

6.1.1 Bộ điều khiển hở

Kiểm nghiệm đặc tính tải động cơ DC giảm tốc với điều kiện ban đầu:

- Điện áp cung cấp: 12VDC, tốc độ vòng quay ước lượng tối đa 150 vòng/phút (giảm ~ ½ so với vòng quay tối đa định mức).
- Bộ điều khiển hở, MCU Mega2560, driver mạch cầu H BTS7960.
- Điều khiển thông qua tay cầm FlySky FS – TH9X
- Phương pháp thu thập dữ liệu: Giao tiếp UART Serial Plotter tích hợp sẵn trên IDE

Trường hợp 1: Trạng thái chờ (Standy), Duty đặt: 17.5% ~ AnalogWirte: 50

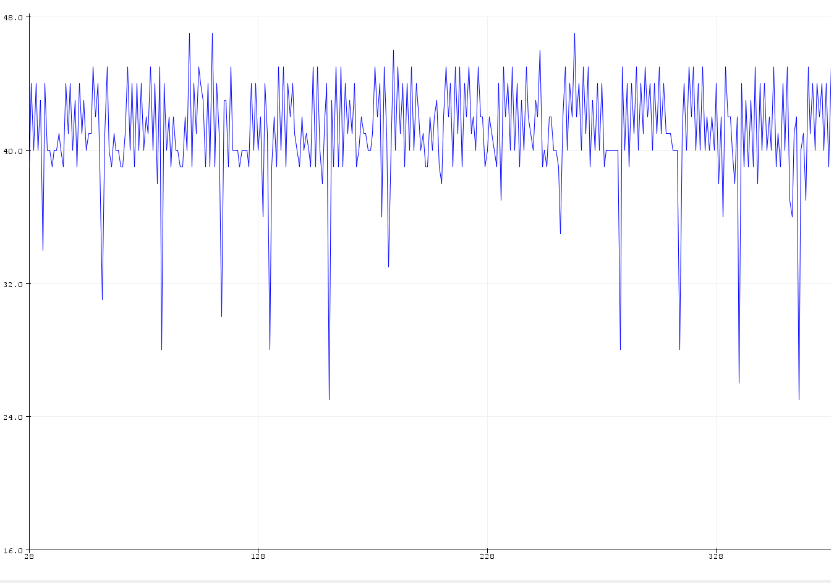
[picture p32: figure]

Xung PPM trung bình: Duty 15.6%

Các nhiễu phi tuyến không mong muốn

Kết quả:

Trạng thái | Duty (%) | AnalogWrite(0 ~ 255) | Điện áp động cơ | Sai số (%)
Trước | 17.5 | 45 | 2.11V | 11.1
Sau | 15.6 | 40 | 1.88V

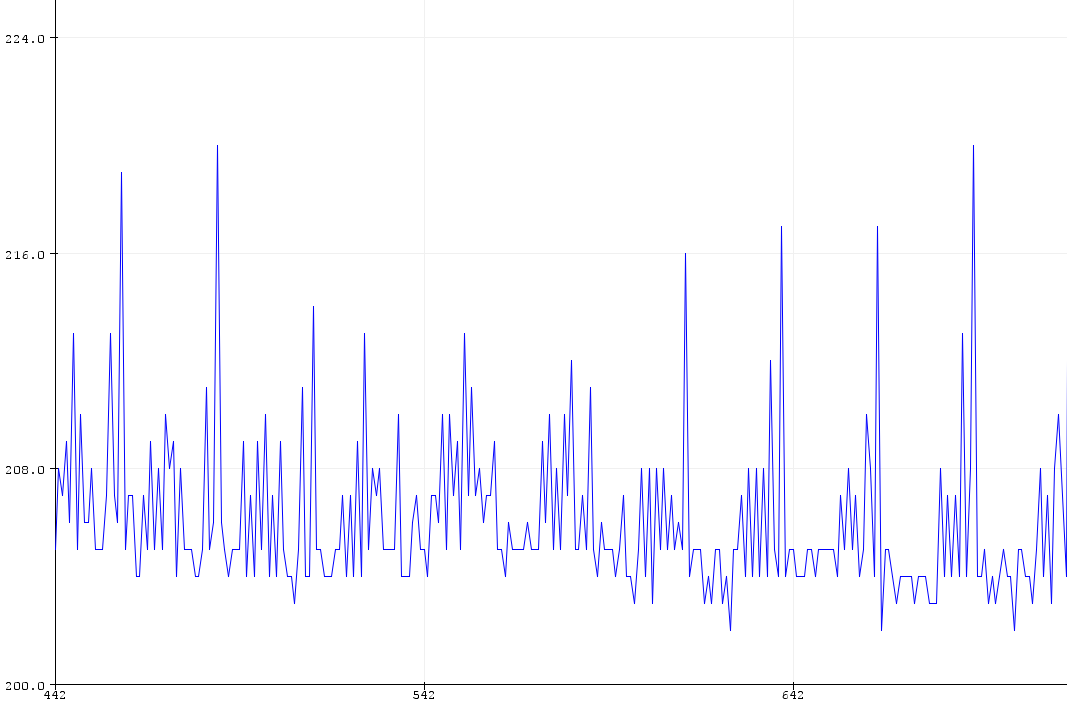
[picture p33: figure]

Trường hợp 2: Trạng thái hoạt động full-load, Duty đặt 90% ~ AnalogWrite: 225

Xung PPM trung bình: Duty: 80.1%

Kết quả:

Trạng thái | Duty (%) | AnalogWrite(0 ~ 255) | Điện áp động cơ | Sai số (%)
Vào | 90 | 225 | 10.59V | 8.4
Ra | 80.1 | 206 | 9.69V

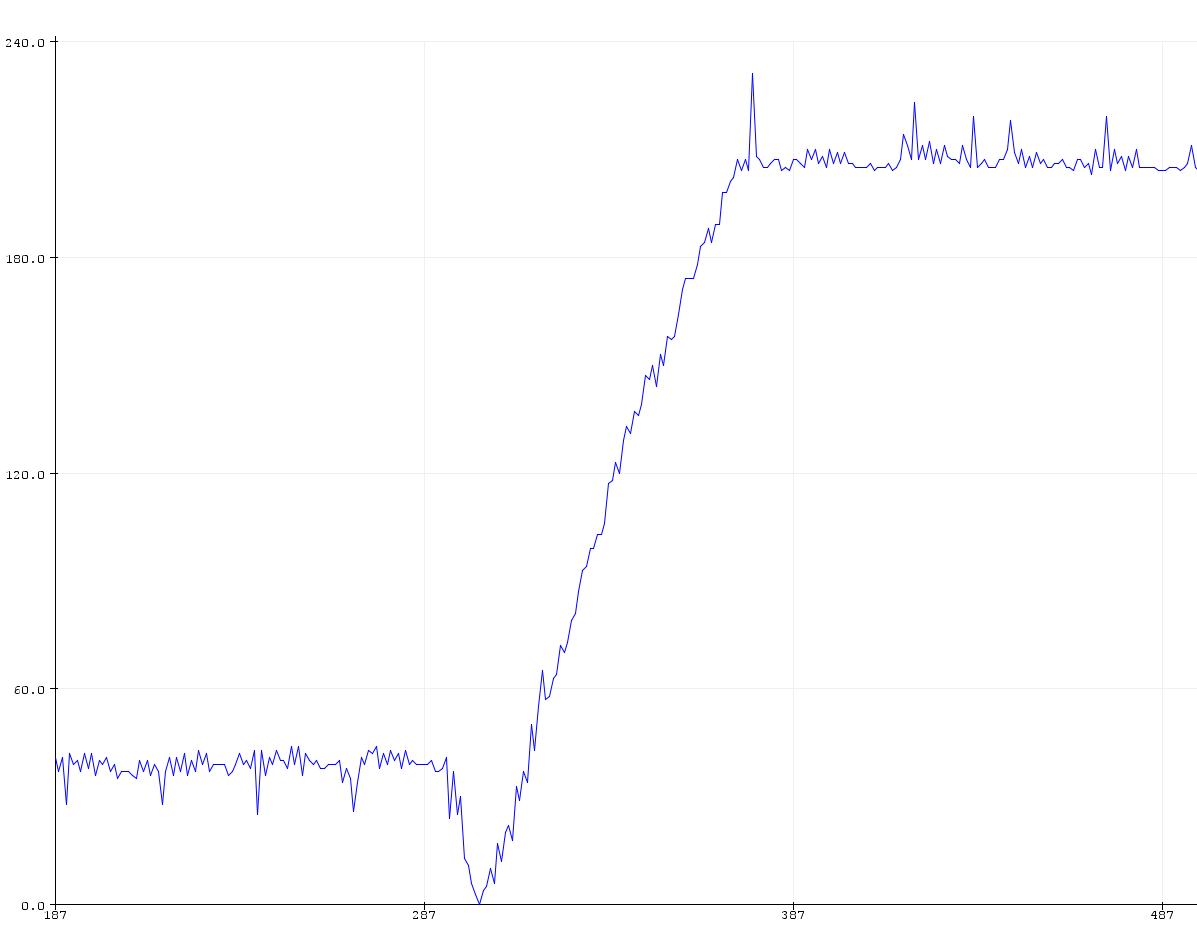
[picture p34: figure]

Trường hợp 3: Trạng thái chuyển tiếp tốc độ chậm lên tốc độ nhanh

Xung PPM mức thấp: Duty 15.6%

Nhiễu xung do tín hiệu kích PPM từ tay cầm

Thời gian chuyển tiếp trạng thái

t ~ 100ms

Xung PWM mức cao: Duty: 80.1%

Trường hợp 4: Trạng thái chuyển tiếp từ tốc độ nhanh xuống tốc độ chậm

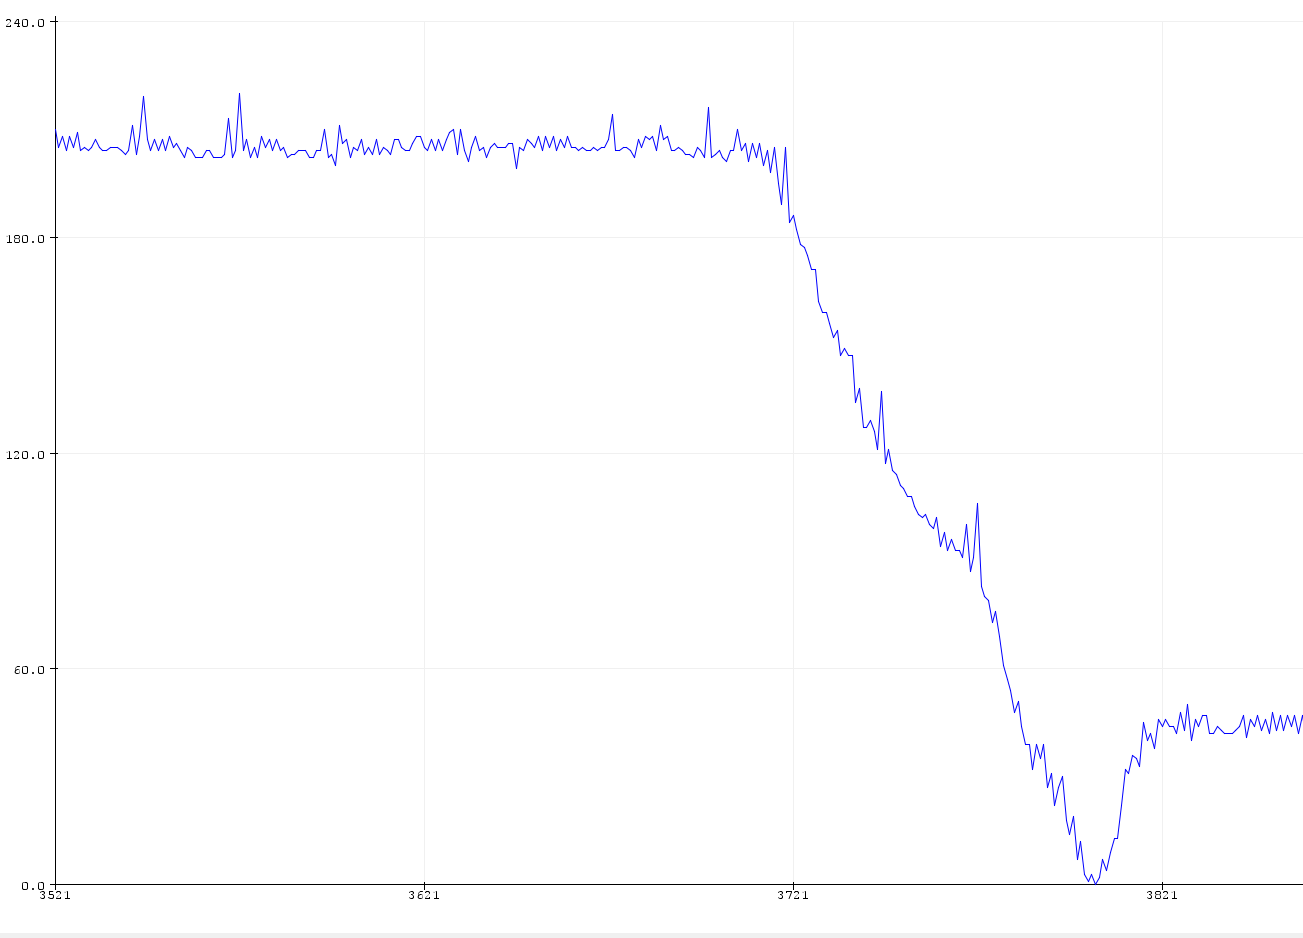
[picture p35: figure]

Nhiễu xung do tín hiệu kích PPM từ tay cầm

Thời gian chuyển tiếp trạng thái

t ~ 100ms

Xung PWM mức thấp: Duty 15.6%

Xung PWM mức cao: Duty: 80.1%

Nhận xét:

- Phương pháp điều khiển vòng hở mô phỏng được đường đặc tuyến mong muốn điều khiển cho động cơ tải chính phía sau robot, tuy nhiên xảy ra nhiễu phi tuyến không mong muốn. Thêm vào đó, tín hiệu nhiễu (xung gai) khách quan từ tay cầm (do nhà sản xuất) đem đến sai số điều khiển lớn.
- Về mặt thực tế, các nhiễu xung sẽ chỉ thấy thông qua đo lường, khi vận hành robot thực tế các nhiễu này ít gây ảnh hưởng đến quá trình điều khiển.

Phương án cải tiến:

- Nếu có thể áp dụng phương pháp điều khiển vòng kín thì đường đáp ứng bám theo hình dạng của đường đặc tuyến mong muốn của động cơ.
- Nâng cấp các dòng động cơ DC giảm tốc Servo công suất lớn cho động cơ tải chính.
- Tìm phương án giảm nhiễu tối đa từ xung PPM từ tay cầm FlySky FS – TH9X hoặc nâng cấp bộ tay cầm chất lượng hơn.

6.1.2 Bộ điều khiển kín

Kiểm nghiệm đặc tính tải động cơ bẻ lái DC Servo RH-11D với các điều kiện ban đầu

- Điện áp cung cấp: 12VDC, tốc độ vòng quay ước lượng tối đa 35 vòng/phút (giảm ~ ½ so với vòng quay tối đa định mức).
- Bộ điều khiển kín PI, MCU Mega2560, driver mạch cầu H BTS7960, Encoder quang tích hợp 1000 xung/vòng.
- Phương pháp điều khiển đo đạc: Đặt góc quay bằng giao tiếp UART
- Phương pháp điều khiển thực tế: Thông qua tay cầm FlySky FS – TH9X.
- Phương pháp thu thập dữ liệu: Giao tiếp UART Serial Plotter tích hợp sẵn trên IDE

a. Khảo sát lựa chọn hệ số KP, KI

Khảo sát lựa chọn hệ số KP, KI với góc đặt 3.6⁰ tương đương 1000 xung encoder.

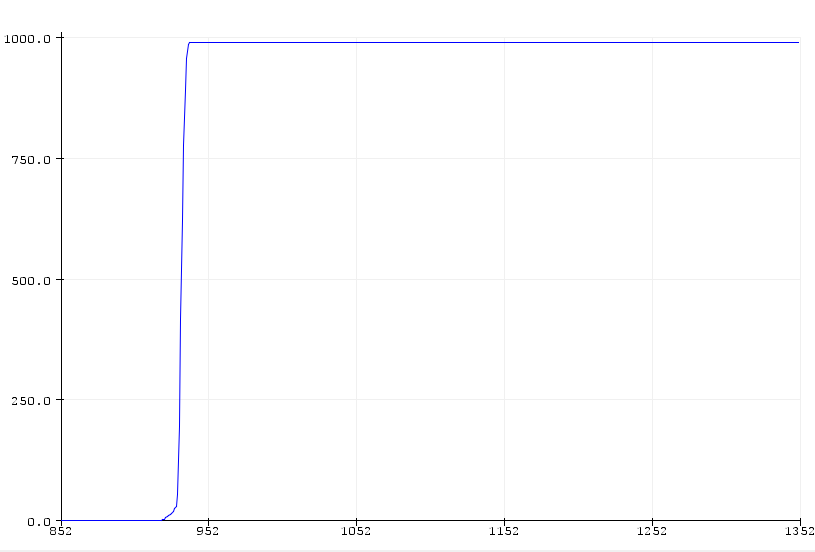
[picture p36: figure]

Trường hợp 1: Chọn hệ số KP = 0.198, KI = 0, KD = 0

Kết quả:

- Thời gian xác lập: txl = (ms)
- Xung đáp ứng: ~990 xung
- Vọt lố: PO ~ 0

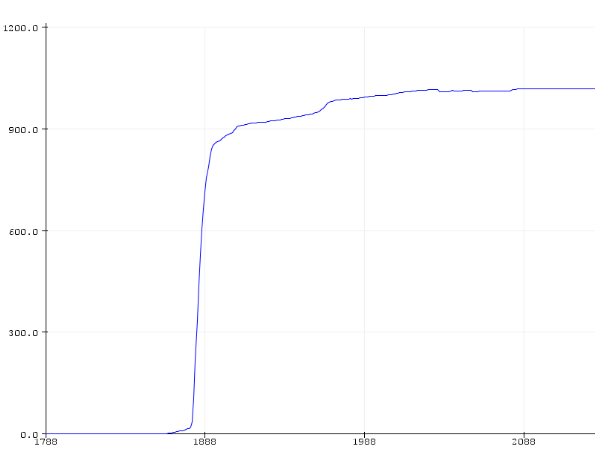
[picture p37: figure]

Trường hợp 2: Chọn hệ số KP = 0.099, KI = 0.0001, KD = 0

Kết quả:

- Thời gian xác lập:
- Xung đáp ứng: 1018 xung
- Vọt lố:

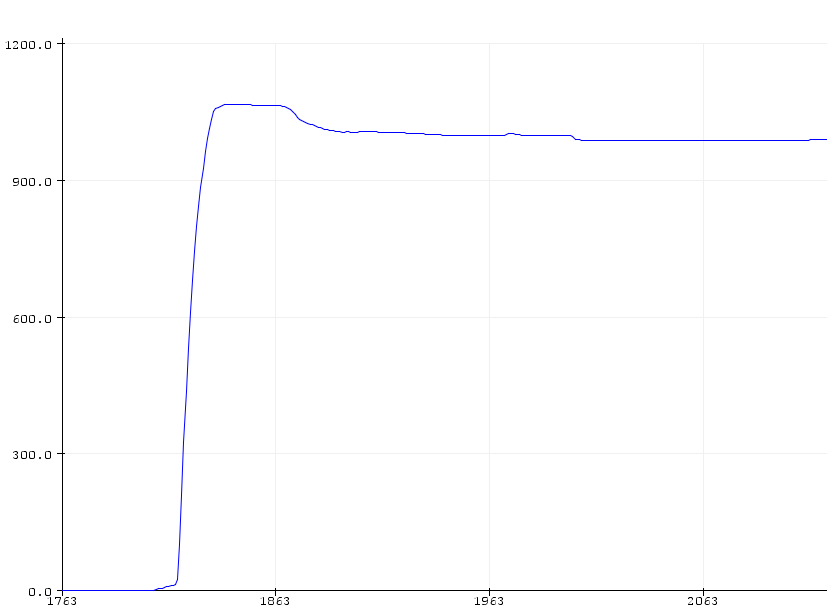
[picture p38: figure]

Trường hợp 3: Chọn hệ số KP = 0.099, KI = 0.001, KD = 0

Kết quả:

- Thời gian xác lập:
- Xung đáp ứng: 1021 xung
- Vọt lố PO:

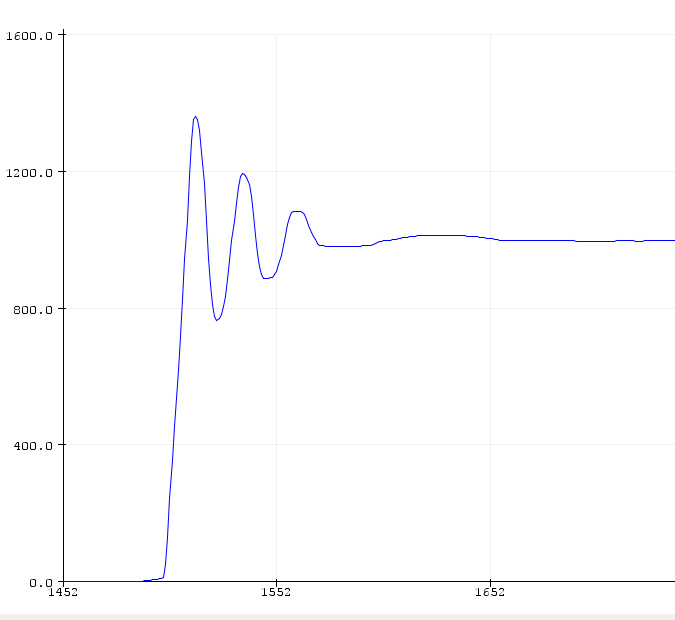
[picture p39: figure]

Trường hợp 4: Chọn hệ số KP = 0.099, KI = 0.00011, KD = 0

Kết quả:

- Thời gian xác lập:
- Xung đáp ứng: 1008 xung
- Vọt lố:

Nhận xét:

Bộ PI số 3 và số 4 có xung đáp ứng tốt nhất nhưng xảy ra vọt lố PO do thành phân KI cao (vọt lố cao hơn cả là bộ số 4) và thời gian xác lập cũng cao.

Bộ P số 1 và PI số 2 có độ vọt lố thấp, thời gian xác lập trong mức cho phép. Tuy nhiên để tránh trạng thái Steady State Error xảy ra như đã đề cập ở chương số 5, chúng tôi lựa chọn bộ PI trong trường hợp số 2 với các thông số sau:

Hệ số: KP = 0.099, KI = 0.0001, KD = 0

Thời gian xác lập:

Độ vọt lố:

Xung đáp ứng: 1018 xung

b. Khảo sát đáp ứng đảo chiều quay động cơ

Trường hợp 1: Góc đặt 3.6⁰ tương đương 1000 xung encoder, chiều thuận

Thông số khảo sát | Giá trị
Góc | 3.6⁰
Xung mong muốn | +1000 pulse
Hệ số KP, KI, KD | 0.099, 0.0001, 0

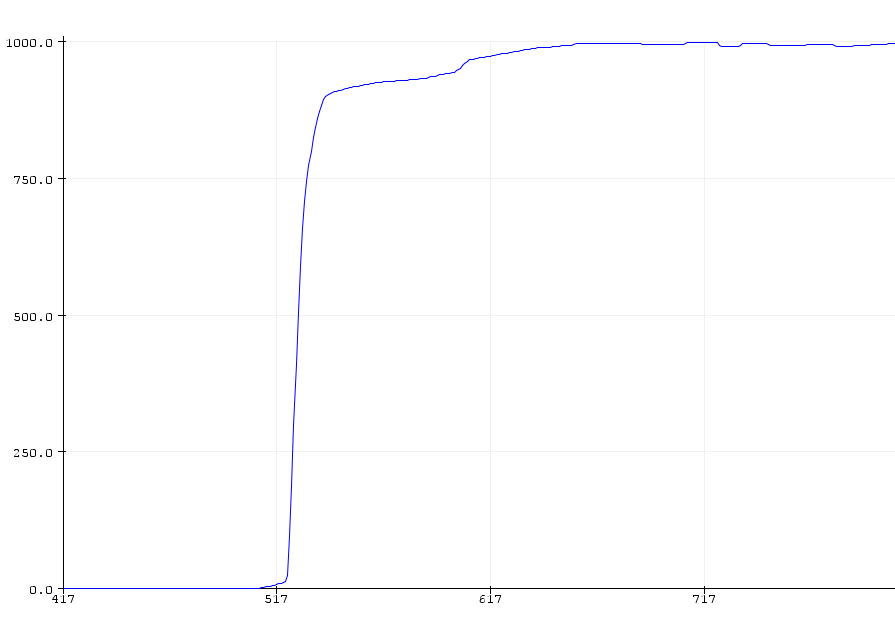
[picture p40: figure]
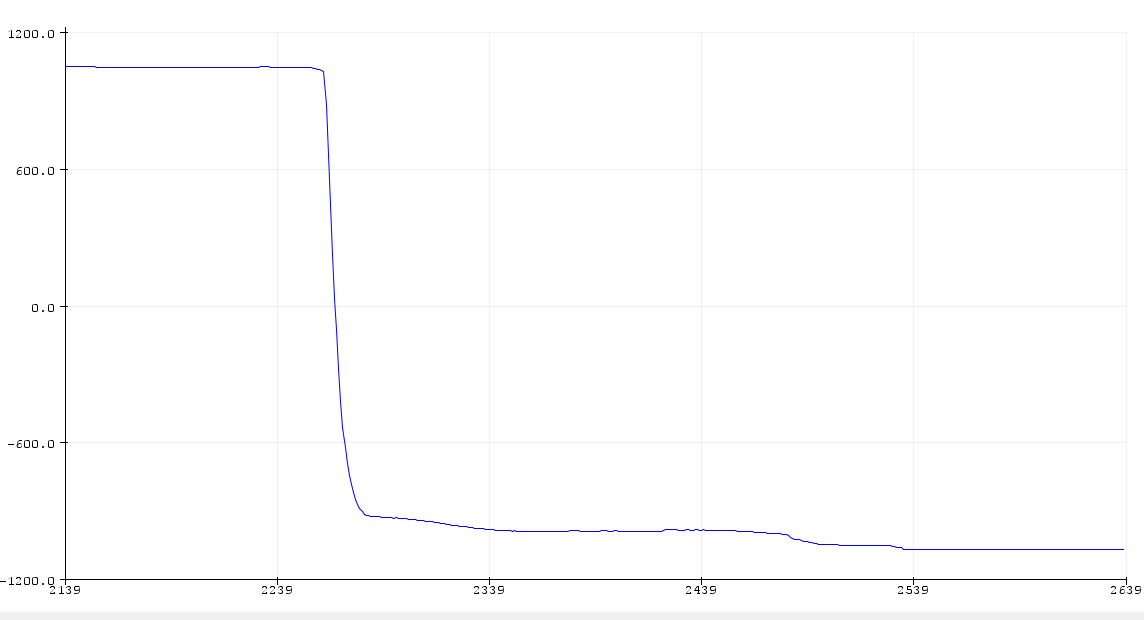
[picture p41: figure]

Trường hợp 2: Góc đặt -3.6⁰, tương đương 1000 xung encoder, chiều nghịch

Thông số khảo sát | Giá trị
Góc | -3.6⁰
Xung mong muốn | -1000 pulse
Hệ số KP, KI, KD | 0.099, 0.0001, 0

Trường hợp 3: Góc đặt -7.2⁰, tương đương 2000 xung encoder, chiều nghịch

Thông số khảo sát | Giá trị
Góc | -7.2⁰
Xung mong muốn | -2000 pulse
Hệ số KP, KI, KD | 0.099, 0.0001, 0

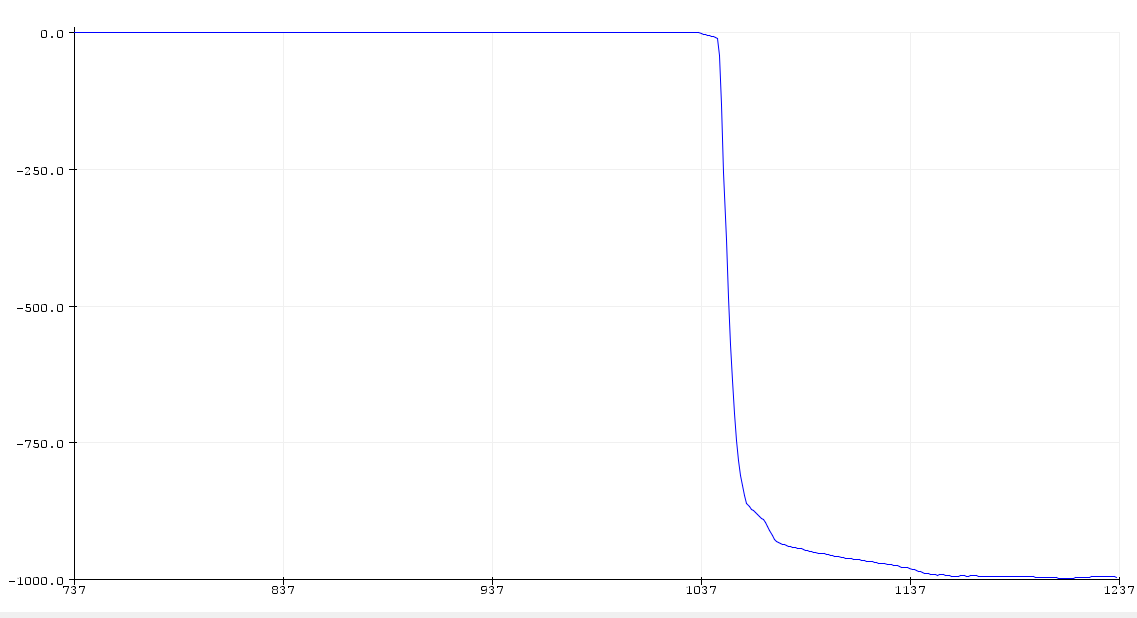
[picture p42: figure]
