VVCi/Graduate_Thesis/05_Reference_Documents/02_Report/01_Bia_bao_cao.docx

BỘ CÔNG THƯƠNG

TRƯỜNG ĐẠI HỌC CÔNG NGHIỆP TP.HCM

KHOA CÔNG NGHỆ CƠ KHÍ

BỘ MÔN CƠ ĐIỆN TỬ

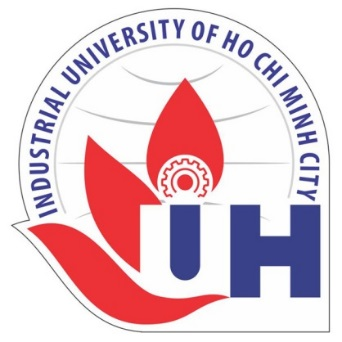
[picture p86: figure]
UInWMhe
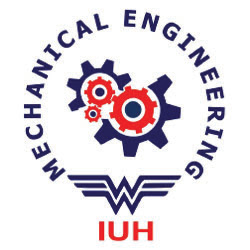
[picture p87: figure]
KHOA CƠ KHÍ - ĐẠI HỌC CÔNG NGHIỆP TPHCM

----o0o----

ĐỒ ÁN TỐT NGHIỆP

TÊN ĐỀ TÀI: THIẾT KẾ VÀ CHẾ TẠO CÁNH

TAY SCARA ROBOT ỨNG DỤNG THUẬT TOÁN PID ĐIỀU KHIỂN GÓC QUAY

Giảng viên hướng dẫn: ThS. HOÀNG VĂN VINH

Sinh viên thực hiện:

TRẦN THANH SỬ MSSV: 16033451

ĐOÀN MINH TOÀN MSSV: 16062901

LÊ SƠN DY MSSV: 16069841

VŨ TÙNG DƯƠNG MSSV: 16048221

DƯƠNG VĂN CƯỜNG MSSV: 16038821

Thông tin liên lạc: ĐT: 0944447328

Email:tranthanhsu0902@gmail.com

TP. Hồ Chí Minh, tháng 7 năm 2020
