VVCi/Graduate_Thesis/01_Deliverable/01_Report/Report_v0.4/Chapter07.docx

# CHƯƠNG 7 KẾT LUẬN VÀ KIẾN NGHỊ

## 7.1 Kết luận

Sau quá trình nghiên cứu, tính toán và thiết kế, nhóm đã chế tạo ra mô hình robot thực tế đáp ứng được cơ bản yêu cầu bài toán.

Bảng dưới đây mô tả chi tiết thông số kĩ thuật của robot

Thông số | Giá trị | Đơn vị
Kích thước | 600 × 400 × 1000 | D × R × C (mm)
Trọng lượng lớn nhất (khi cấp đủ thuốc BVTV) | 45 | kg
Dung tích bình chứa | 10 | lít
Thời gian vận hành cho một chu kì xạc accu | 30 | phút
Năng suất vận hành (trung bình) | 0.35 | ha/ giờ
Điện áp sử dụng | 24 | volt

Kết quả mong muốn:

- Hệ thống điều khiển: robot có thể tự hành trong đường luống dưa thẳng, có thể tự động bẻ lái và bám mục tiêu bằng việc lấy tín hiệu xử lý từ cảm biến gia tốc góc nghiêng MPU6050. Cơ cấu bẻ lái chủ động có thể vận hành không bị lỗi, chuyển từ tự động sang bẻ lái chủ động tốt và ngược lại.

- Hệ thống cơ khí: Hệ thống cơ khí chế tạo trên thực tế hoàn thiện trên 90% như trên thiết kế. Trong quá trình vận hành, các khâu khớp của robot hoạt động ổn định, độ chịu tải và cứng vững tốt.

## 7.2 Nhược điểm

- Đáp ứng của hệ thống dẫn hướng chưa tốt, còn xảy ra rung động.

- Chưa thể thiết kế robot hoàn toàn tự động bẻ lái tại các khúc cua.

- Robot vận hành thường xuyên xảy ra hiện tượng trơn trượt

- Độ thẩm mĩ của robot chưa cao.

## 7.3 Phương án cải tiến

- Nâng cấp thiết bị cảm biến bằng việc sử dụng các camera chuyên dụng.

- Cải tiến thiết kế hệ thống cơ khí đáp ứng tốt hơn yêu cầu thực địa, thay đổi các loại bánh xe nhằm hạn chế trơn trượt.

- Giảm trơn trượt tại địa hình bằng việc tăng cường độ thông thoáng của nền trải bạt.

TÀI LIỆU THAM KHẢO

[1] Nguyễn Hữu Lộc, Giáo trình cơ sở thiết kế máy, NXB. ĐHQG TP.HCM, 2016.

[2] Trịnh Chất, Lê Văn Uyển, Tính toán thiết kế hệ dẫn động cơ khí tập 1, 2, NXB Giáo dục Việt Nam.

[3] Nguyễn Viễn Quốc, Bài giảng kĩ thuật điều khiển, ĐH Công nghiệp TP.HCM.

[4] Ümit Özgüner, Tankut Acarman, Keith Alan Redmill, Autonomous Ground Vehicles¸ Artech House, 2011.

[5] Roland S.Burns, Advanced Control Engineering, 2001

[6] The MPU6050 Explained, https://mjwhite8119.github.io/Robots
