VVCi/Graduate_Thesis/01_Deliverable/01_Report/Report_v0.4/Chapter03_02.docx

  3.2 Tính toán hệ thống dẫn động cơ khí
    3.2.1 Tính toán tải chính động cơ

Dựa theo những gì đã tham khảo và cơ sở lý thuyết ở chương 2, chúng tôi đã đưa ra các quyết định sau:

Đối với động cơ dẫn động cầu sau chúng tôi sẽ lựa chọn động cơ DC có hộp giảm tốc và sẽ sử dụng động cơ servo cho cơ cấu dẫn động phía trước.

    3.2.2 Yêu cầu kỹ thuật của robot

Giới hạn kích thước (mm) | Vận tốc m/s | Đường kính bánh xe (mm) | Trọng lượng (kg) | Công suất động cơ | Nguồn cấp
<800x1000x1500 (mm) | 0.3-0.8m/s | <200 mm | <60kg | <120w | 12V

N_G =(v.60)/(π.D)=((300÷800).60)/(π.160)=(35.8~95.4) (vòng/phút)

Trong đó:

- N_G : Tốc độ tại trục đầu ra
- v : Vận tốc đi được (m/s)
- D: Đường kính bánh xe (mm)

Chọn sơ bộ tỷ số của hệ thống:

TST | 6 | 8 | 10 | 12 | 14 | 16 | 18 | 20 | 22 | 24 | 26 | 28 | 30

- Ta chọn 26

Số vòng quay cần thiết của động cơ

N_(CT) = N_G .U_(ht) =(35.8~95.4).26=(930,8~2480) (vòng/phút)

# Ta chọn Động cơ GR-08SGN Hộp số M9GA18B

STT | Thông số kỹ thuật | Trị số | Đơn vị
1 | Điện áp sử dụng | 12 | V
2 | Kích thước | | mm
3 | Tỉ số truyền | 26:1
4 | Dòng không tải: | 60 | mA
5 | Dòng chịu đựng tối đa khi có tải: | 5,5 | A
6 | Tốc độ không tải: | 100 | Rpm
8 | Lực kéo Moment định mức: | 5,6 | Kg.cm
9 | Lực léo Moment tối đa: | 24 | Kg.cm
10 | Vận tốc quay | 2500 | Vòng/phút

Bảng 2.0 Thông số động cơ GR-08SGN và hộp giảm tốc M9GA18B

# Vận tốc thực tế khi chọn động cơ GR-08SGN Hộp số M9GA18B

N=(D.π.N_0)/(60000.i)=(160.π.2500)/60000.26=0,8((mm)/s)(Thỏa điều kiện ban đầu)

Trong đó:

- N: vận tốc quay thực tế (mm/s)
- N_0 : Vận tốc quay của động cơ (vòng/phút)
- i: tỷ số truyền

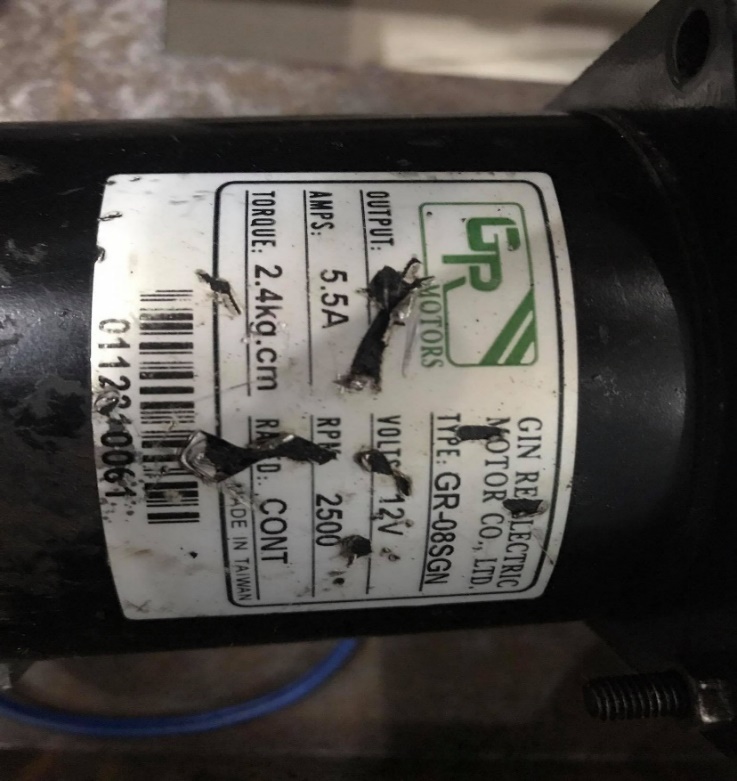
[picture p89: figure]

Hình 2.0 Động cơ GR-08SGN

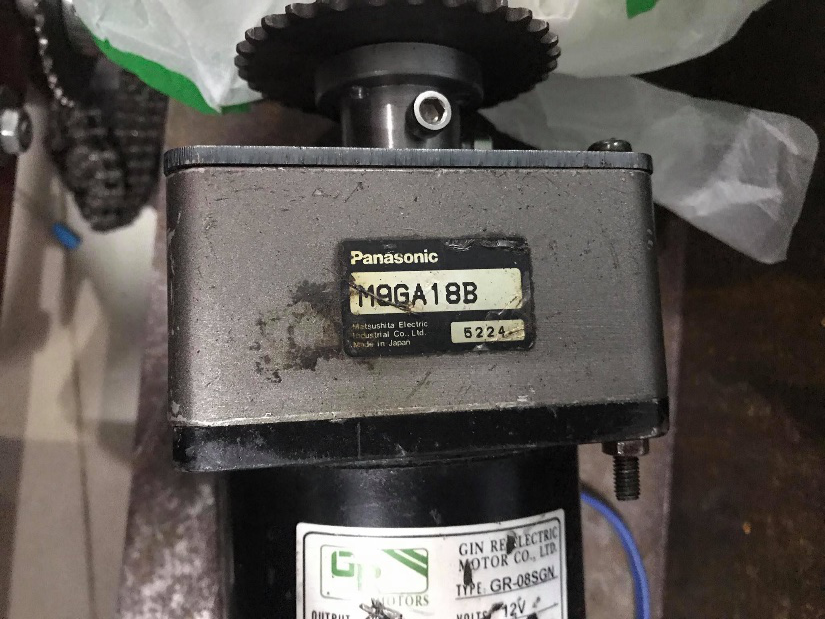
[picture p90: figure]

Hình 2.1 Hộp số M9GA18B

# Hệ số ma sát của mặt trượt F

F=F_A +m.g(sinθ+0,3.cosθ)=0+45.10(sin0°+0,3.cos0°)=135(N)

# Khảo sát công suất động cơ

Thông số | Kí hiệu | Trị số | Đơn vị
Tổng khối lượng của đai và tải | m | 45 | kg
Ngoại lực | F_A | 0 | N
Hệ số ma sát của bề mặt trượt | μ | 0.3
Đường kính bánh xe | D | 160 | mm
Hệ số con lăn | η | 0.8
Tốc độ | V | 150 | mm/s

Trong đó :

- F: hệ số ma sát trượt (N)
- F_A : Ngoại lực
- m: trọng lượng riêng (kg)
- g: gia tốc trọng trường

# Tải mô-men xoắn

T_L^(') =(F.D)/(2.η)=(135.160.10^(-3))/(2.0,9)=12 (M.m)

Trong đó

- T_L^(') : Tải momen xoắn
- F: Hệ số ma sát trượt (N)
- D: Đường kính bánh xe (mm)
- η: Hiệu suất con lăn
- S_f : Hệ số an toàn

# Cho phép hệ số an toàn là 2 lần.

T_L =T_L^(') .S_f =12.1,5=18(N.m)

Dựa trên tải mômen xoắn T_L =18 (N.m) ta tìm được động cơ phù hợp

# Công suất của động cơ

P_0 =(2π.N_M .T_L)/60=(2π.295,4.24)/60=179(W)

    3.2.3 Tính toán truyền động xích
      3.2.3.1 Các yêu cầu để chọn xích

- Với vận tốc làm việc bằng 0,8 m/s nhỏ hơn 10 đến 15 m/s nên ta chọn xích ống
con lăn. Xích ống con lăn gọi tắt là xích con lăn, về kết cấu giống như xích ống, chỉ
khác phía ngoài lắp thêm con lăn, nhờ đó có thể thay thế ma sát trượt giữa ống và
răng đĩa (ở xích ống) bằng ma sát lăn giữa con lăn và răng đĩa (ở xích con lăn).
Kết quả là độ bền mòn của xích con lăn cao hơn xích ống, chế tạo nó không phức
tạp bằng xích răng, do đó xích con lăn được dùng khá rộng rãi. Nó thích hợp khi
vận tốc làm việc dưới khoảng 10 đến 15 m/s nên ưu tiên dùng xích một dãy, nhưng ở các bộ truyền quay nhanh, tải trọng lớn nếu dùng xích 2, 3 hoặc 4 dãy sẽ làm giảm tải trọng động và kích thước khuôn khổ của bộ truyền. Trang 191 [1]

      3.2.3.2 Tính toán xích

3.2.3.2.1 Chọn số răng đĩa xích

Nếu số răng càng nhỏ thì góc xoay bản lề lớn làm xích mòn nhanh. Ngoài ra, khi số răng đĩa xích nhỏ làm tăng tải trọng động, gây nên va đập, xích và đĩa xích mau hỏng, gây nên tiếng ồn lớn.

Khi làm việc xích bị mòn cho nên để tránh tuông xích hoặc ( (∆P_c)/(P_c) ≤ 3%), ta phải
chọn giới hạn số răng đĩa xích : Trang 192 [1]

Chọn z_(max) ≤ 100 ÷ 120 đối với xích con lăn- Z_(max) ≤ 120 ÷ 140 đối với xích răng.
Số răng đĩa xích nên lấy số lẻ vì khi đó mỗi răng của đĩa xích sẽ ăn khớp lần lượt với tất cả mắt xích và do đó răng đĩa xích sẽ mòn đều hơn. Tuy nhiên trong thực tế, người ta sử dụng số răng chẵn. ví dụ, cặp dĩa xích xe đạp Z1=48, Z2=18. Cặp đĩa xích xe máy là Z1=14; Z2=32 hoặc Z1=13, Z2=36

=> Để tối ưu hóa chi phí và thời gian gia công nhóm chúng tôi đã quyết định sử dụng cặp đĩa xích bộ cam xe máy dùng trong robot, cùng với đó để không thay đổi tốc độ quá nhiều nên đã lựa chọn 2 cặp bánh răng giống nhau Z1=Z2=32 răng

      3.2.3.3 Xác định các hệ số

- Hệ số k được tính từ các hệ số thành phần : K=K_0 .K_a .K_(đc) .K_(bt) .K_đ .K_c

Với : K_0 =1 hệ số ảnh hưởng của vị trí bộ truyền (đường nối hai tâm đĩa xích so với đường nằm ngang <60°).

Trong đó:

K_a = 1 hệ số kể đến khoảng cách trục và chiều dài xích, a = (30÷ 50) p_c .

K_(đc) = 1 hệ số ảnh hưởng của việc điều chỉnh lực căng xích (vị trí điều chỉnh được).
K_đ = 1 (tải trọng ngoài tác động lên bộ truyền tương đối êm).

K_(bt) = 1,5 hệ số ảnh hưởng của bôi trơn (định kì, gián đoạn)

K_c = 1 (làm việc 1 ca)

→ K=1.1.1.1.1,5.1=1,5

Hệ số K_x = 1 (xích 1 dãy)

❖ Công suất tính toán xích :

P_t =(K.K_z .K_n .P_3)/(K_x)=(1,5.1.0,416.0,179)/1=0,117 (Kw)≤ [P]trang81[3]

Với {, n_01 =50 (vòng/phút), [P]≥5,357Kw)

Ta chọn công suất cho phép [P]= 0,75Kw và bước xích p_c =8 (mm) tra bảng 5.5[3].

      3.2.3.4 Kiểm tra điều kiện quay tới hạn

n_x < n_(th) ↔120,207<630 (thỏa) với n_(th) số vòng quay tới hạn, Tra bảng 5.2[1]
Vận tốc trung bình

v =(n_x .z_1 .p_c)/60000=(95,4.32.8)/60000=0,4(m/s) Trong đó,

❖ n_x : số vòng quay đĩa xích (vg/ph).

❖ z_1 : số răng đĩa xích nhỏ

❖ p_c : số bước xích (mm)

Lực vòng có ích Ft

F_t =(1000.p_x)/v=(1000.0,179)/(0,4)=447,5(KN) trang195[1] Tính toán kiểm nghiệm bước xích pc

Chọn [ P_0 ]=29 dựa vào n_1 và bước xích bảng P_c 5.3 [1]

P_c ≥600.³√((P_3 .K)/(z_1 .n_x .[P_0 ].K_x))=600.³√((0,179.1,5)/(32.95,4.29.1))=8,6(mm) chọn 8

## 3.2.3.5 Các thông số hình học cơ bản của xích.

Vận tốc trung bình

## v =(n_x .z_1 .p_c)/60000=(95,4.32.8)/60000=0,4(m/s)

Khoảng cách trục a sơ bộ.

a=(30÷ 50). P_c = 30 . 8 = 240(mm) trang 192 [1]

## 3.2.3.6 Số mắt xích X

X=L/(P_c)=(2a)/(P_c)+(Z_1 + Z_2)/2+(Z_2 - Z_1)/(2π))^2 .(P_c)/a

=2.240/8+(32+32)/2+(32-32)/(2π))^2 .8/240=92(mm)

Giá trị X làm tròn đến số chẵn gần nhất (để thuận tiện nối xích), tốt nhất không
được chọn là bội số của số răng đĩa xích ta chọn X= 92 (mm) trang 193 [1].

## 3.2.3.7 Chiều dài xích L

X=L/(P_c)→L=X. P_c =92.8=736 (mm)

## 3.2.3.8 Khoảng cách trục chính xác a

a = 0,25. P_c [X-(Z_1 +Z_2)/2+√((X-(Z_1 +Z_2)/2)^2 -8.((Z_2 - Z_1)/(2π))^2)]

=0,25.8.[92-(32+32)/2+√((92-(32+32)/2)^2 -8.((32-32)/(2π))^2)]=240 (mm)

    3.2.4 Tính tải động cơ, cơ cấu dẫn hướng

Yêu cầu kĩ thuật cơ cấu dẫn hướng

Tổng khối lượng của tải m=25 (kg)

Gia tốc a=1m/s^2

Hệ số ma sát của bề mặt trượt μ=0,02

Gia tốc trọng trường g=10m/s^2

Hiệu suất khớp nối η=0,9

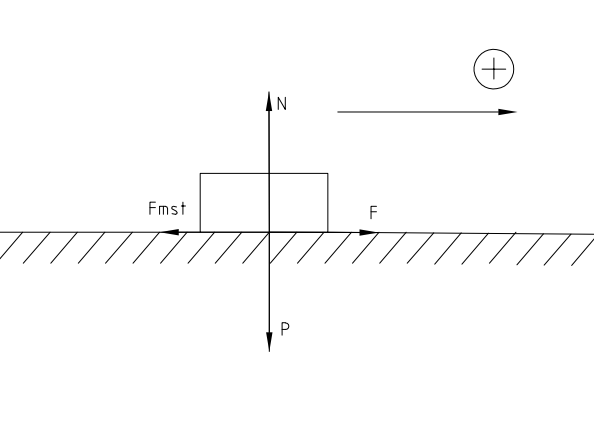
[picture p91: figure]

Hình 2.5 Hệ tọa độ

N=P=m.g

F_(mst) =μ.m.g=0,02.45.10=5 (N)

F_(hl) =m.a=25.1=25(N)

F_(hl) =F-F_(mst) ↔F=F_(hl) +F_(mst) =30+9=39 (N)

M=F.159/2=39.159/2= 3.177(kg.cm)

Kết luận nếu ta tác động một lực 3,177Kg.cm thì có thể dẫn động được vật có trọng lượng 25kg

Từ đó ta chọn động cơ Động Cơ DC Servo RH-11D

STT | Thông số kỹ thuật | Trị số | Đơn vị
1 | Điện áp định mức | 24 | V
2 | Dòng điện định mực | 2.1 | A
3 | Dòng chịu đựng tối đa khi có tải | 5 | A
4 | Tốc độ không tải | 50 | RPM
5 | Tốc độ chịu đựng tối đa khi có tải | 30 | RPM
6 | Lực kéo moment định mức | 4 | N.m
7 | Lực kéo moment tối đa | 4.4 | N.m

Bảng 2.2 Thông số động cơ DC Servo RH-11D

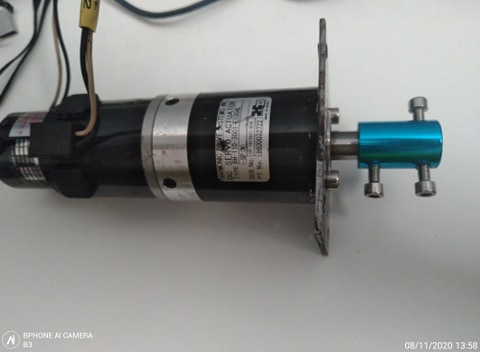
[picture p92: figure]

Hình 2.6 Hình ảnh thực tế động cơ DC Servo RH-11D

    3.2.5 Sơ đồ phân bố momen ở trục chính

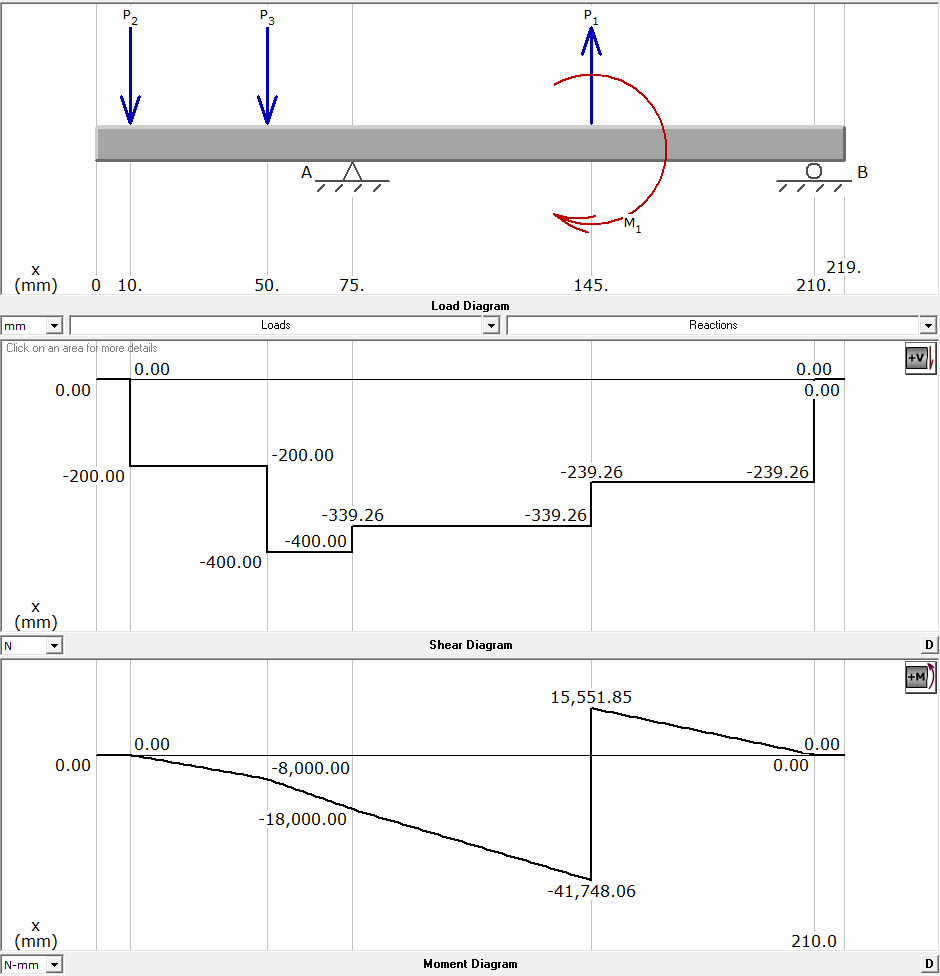
[picture p93: figure]

Hình 2.7 Biểu đồ momen trục chính

    3.2.6 Sơ đồ phân bố momen trục bị động

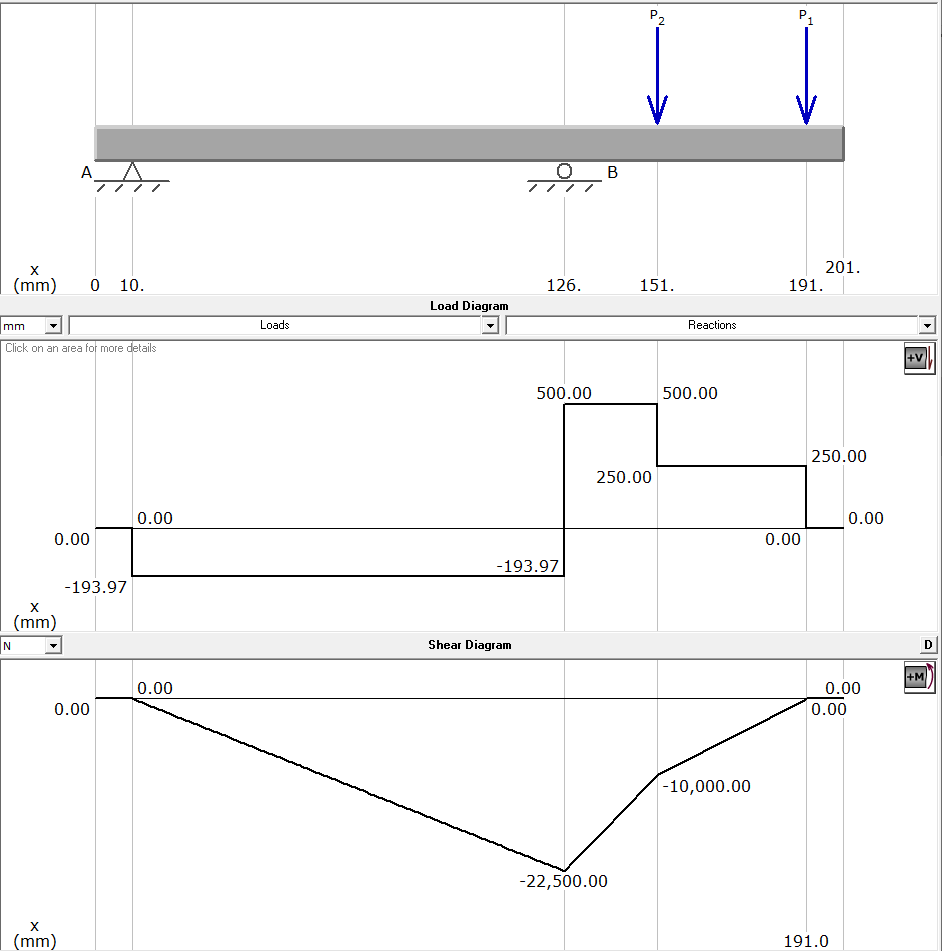
[picture p94: figure]

Hình 2.8 Biểu đồ momen trục bị động sau

    3.2.7 Sơ đồ phân bố momen cơ cấu lái trục phải

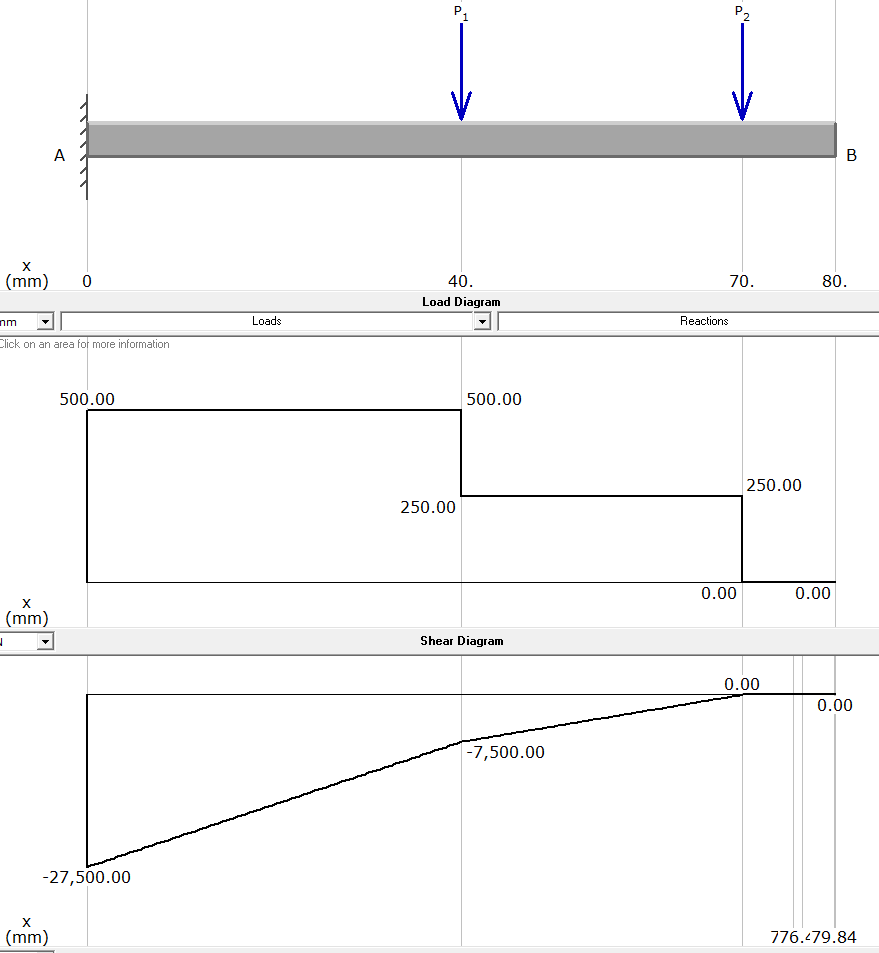
[picture p95: figure]

Hình 2.9 Biểu đồ momen bánh lái phải

    3.2.8 Sơ đồ phân bố momen cơ cấu lái trục trái

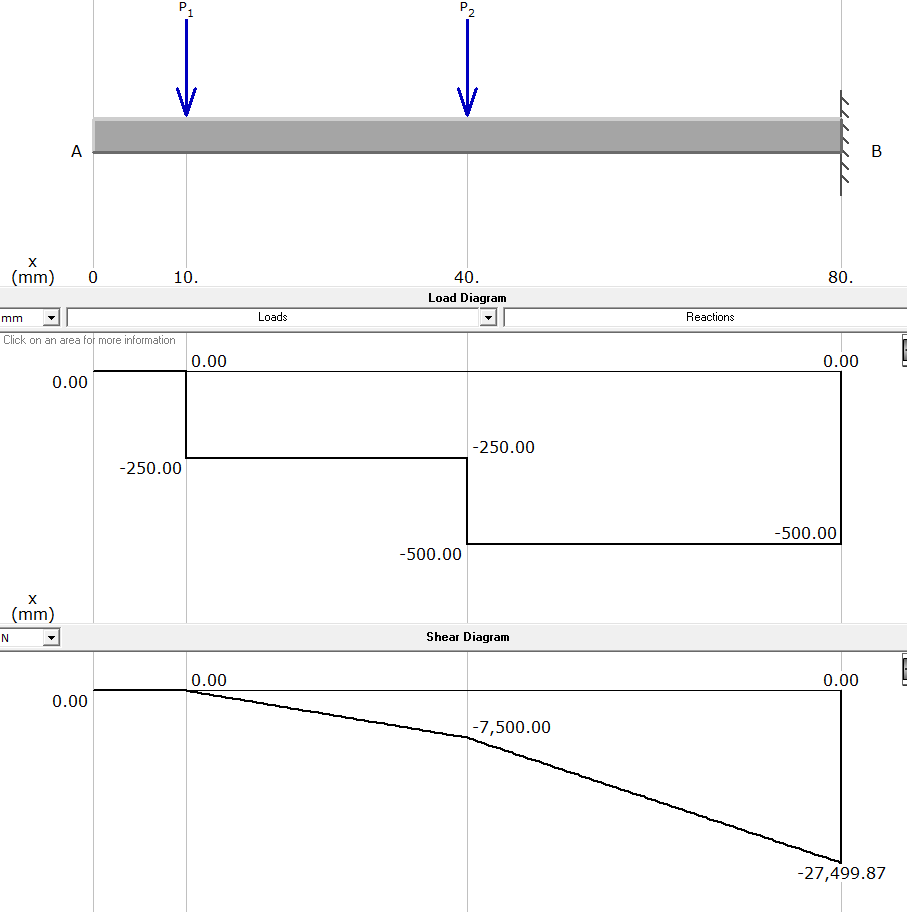
[picture p96: figure]

Hình 2.10 Biểu đồ momen bánh lái trái

3.2 Tính toán và lựa chọn máy bơm phun sương

Bơm phun sương hay còn gọi là bơm tạo sương được kết hợp bởi những ưu điểm của máy bơm tự mồi và bơm hóa chất. Trong đề tài này, với yêu cầu về lựa chọn máy bơm không quá khắt khe nên chúng tôi lựa chọn luôn dòng máy bơm phun sương DC 12V 60W BOJIN.

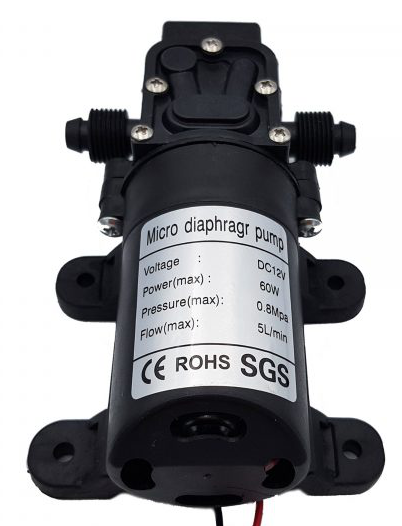
[picture p97: figure]

(máy bơm phun sương 12 VDC 60W BOJIN)

Bơm được sản xuất bằng nhiều loại vật liệu nhập khẩu có khả năng chống ăn mòn. Bơm có kích thước nhỏ gọn, dòng điện tiêu thụ thấp, áp suất cao, tiếng ồn thấp, tuổi thọ dài. Với khả năng chịu dầu, chịu nhiệt, kháng axit, kháng kiềm, kháng hóa chất, chống ăn mòn… Thân máy bơm được tách ra khỏi động cơ và không có bộ phận cơ học nên không có sự ăn mòn trong thân máy bơm.

Thông số kĩ thuật chi tiết máy bơm phun sương 12 VDC 60W BOJIN

STT | Thông số kỹ thuật | Trị số | Đơn vị
1 | Điện áp định mức | 12 | V
2 | Dòng điện định mực | 2.1 | A
3 | Công suất | 60 | W
4 | Lực hút | 1 | m
5 | Lực đẩy tối đa | 35 | m
6 | Lưu lượng | 2.6 | lít/phút
7 | Trọng lượng | 0.58 | kg

(thông số kĩ thuật máy bơm phun sương 12 VDC 60W BOJIN)

3.4 Tính toán thời gian sử dụng ắc quy

Việc tính toán thời gian sử dụng ắc quy khá quan trọng trong điều kiện vận hành tại nhà màng. Chúng ta sẽ phải tính toán và chuẩn bị các bình ắc quy thay thể để phù hợp cho một lần vận hành tại trang trại.

Thông qua các bước tính toán và lựa chọn động cơ, chúng tôi đưa ra bảng kết luận các động cơ đã lựa chọn được như sau:

Động cơ | Công suất (W)
Động cơ giảm tốc Động cơ GR-08SGN và hộp giảm tốc M9GA18B | 60W
Động cơ Servo RH – 11D | 13W
Động cơ máy bơm phun sương 12VDC BOJIN | 60W

Chúng ta có các thông số của ắc quy như sau:

Thông số | Kí hiệu | Trị số | Đơn vị
Hiệu suất ắc quy | η | 0.7
Điện áp ắc quy | U | 24 | V
Dung lượng ắc quy | Ah | 3

Ta có công thức tính thời gian sử dụng ắc quy (theo https://acquy.info/):

T_(sd) =(V.A.η)/(P _(tổng tải))=(24.3.0,7)/133=0,378(giờ)=22.68 (phút)

Trong đó:

T_(sd) : Thời gian sử dụng ắc quy

A: Dung lượng ắc quy (Ah)

V: Điện áp ắc quy (W)

η : Hệ số sử dụng ắc quy, thông thường được chọn là η = 0.7

Thời gian sạc đầy ắc quy:

T_(sạc) =A/(dòng điện nạp)=(3Ah)/(dòng điện nạp)=3/3=1(giờ)

Trong đó:

T_(sạc) : Thời gian sạc của ắc quy

A: Dung lượng ắc quy (Ah)

Dòng điện nạp: Dòng điện nạp vào ắc quy
