VVCi/Graduate_Thesis/04_Multimedia/02_Images/2_08_2020/2020_08_02_10_46_IMG_2630.JPG

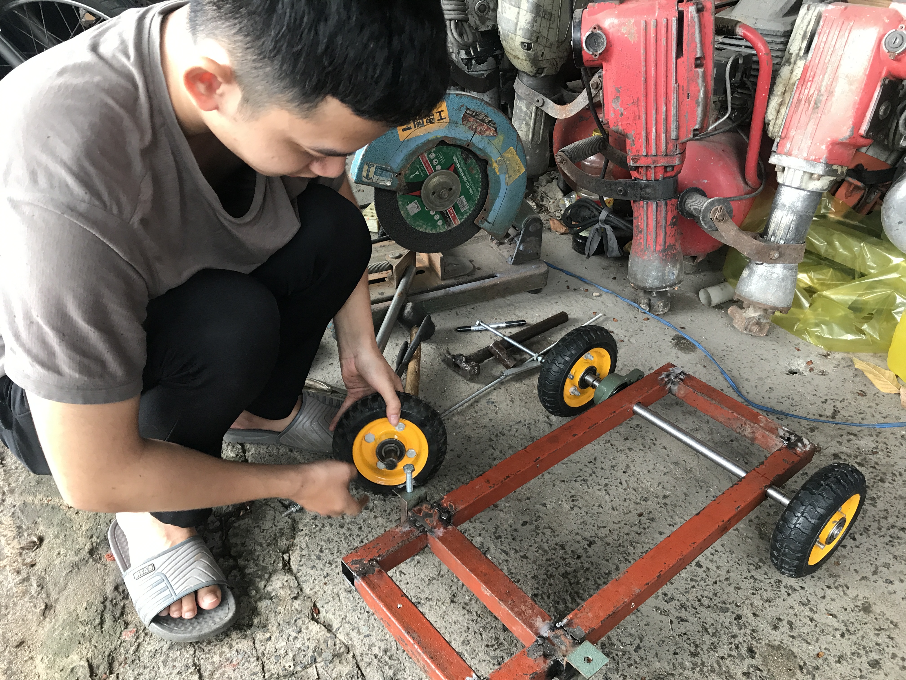
04_Multimedia/02_Images/2_08_2020/2020_08_02_10_46_IMG_2630.JPG
