VVCi/Graduate_Thesis/04_Multimedia/02_Images/2_08_2020/2020_08_02_12_55_IMG_2636.JPG

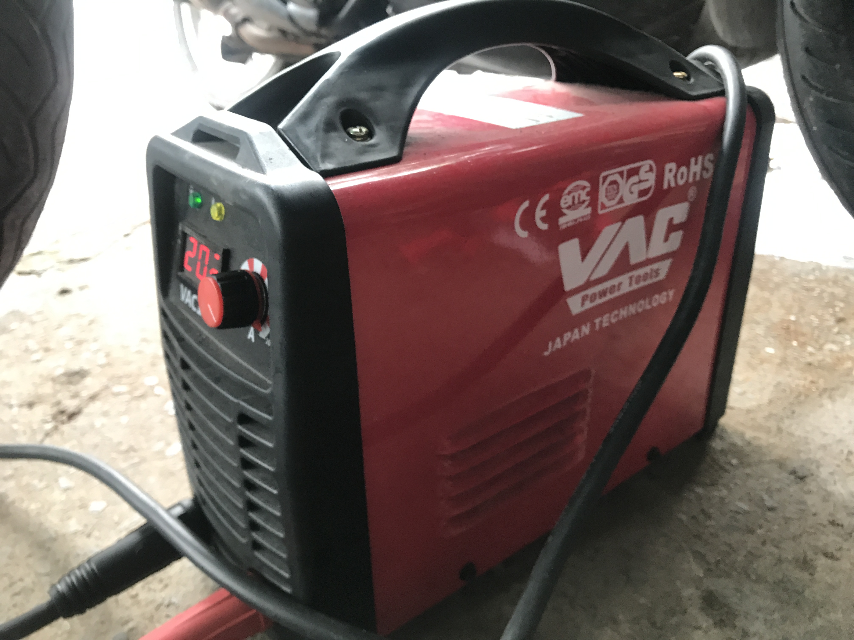
04_Multimedia/02_Images/2_08_2020/2020_08_02_12_55_IMG_2636.JPG
