VVCi/Graduate_Thesis/04_Multimedia/02_Images/2_08_2020/2020_08_02_14_32_IMG_2637.JPG

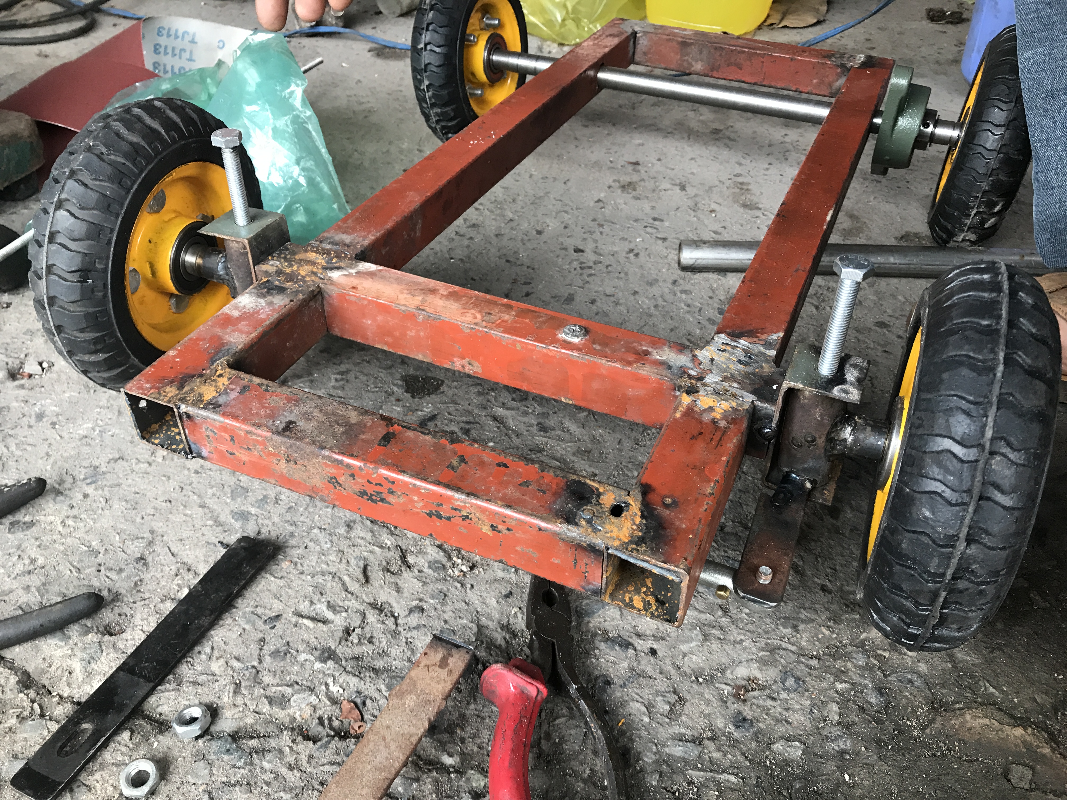
04_Multimedia/02_Images/2_08_2020/2020_08_02_14_32_IMG_2637.JPG
