VVCi/Graduate_Thesis/04_Multimedia/02_Images/2_08_2020/118119074_745801166255777_1977283931276239185_n.jpg

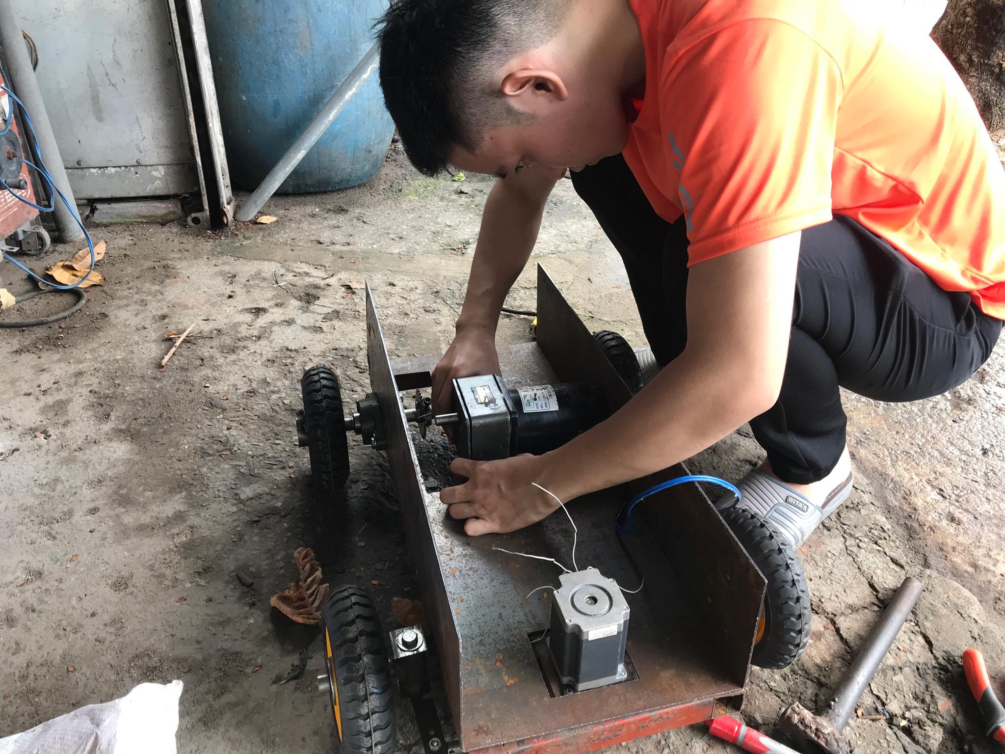
04_Multimedia/02_Images/2_08_2020/118119074_745801166255777_1977283931276239185_n.jpg
