VVCi/Graduate_Thesis/04_Multimedia/02_Images/2_08_2020/118123040_1194866364217402_2873226219597705747_n.jpg

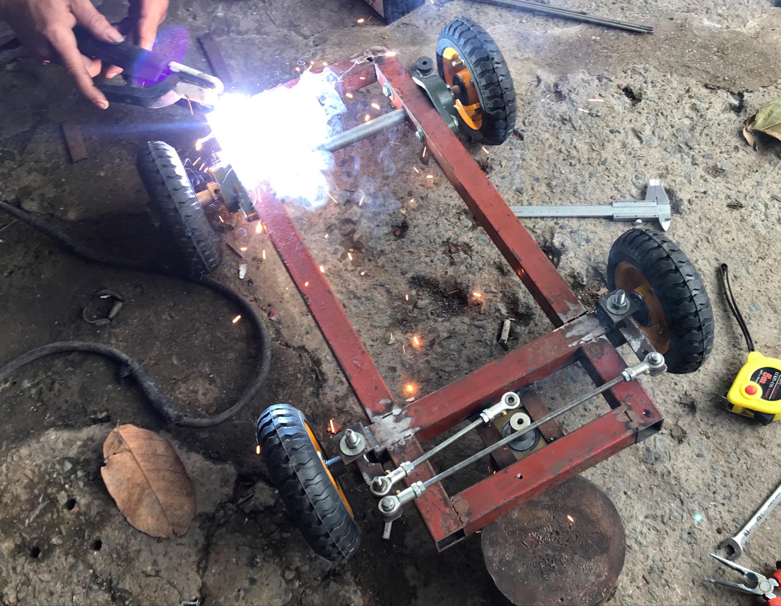
04_Multimedia/02_Images/2_08_2020/118123040_1194866364217402_2873226219597705747_n.jpg
