VVCi/Graduate_Thesis/04_Multimedia/02_Images/2_08_2020/118873934_742301743290310_1053837143780202273_n.jpg

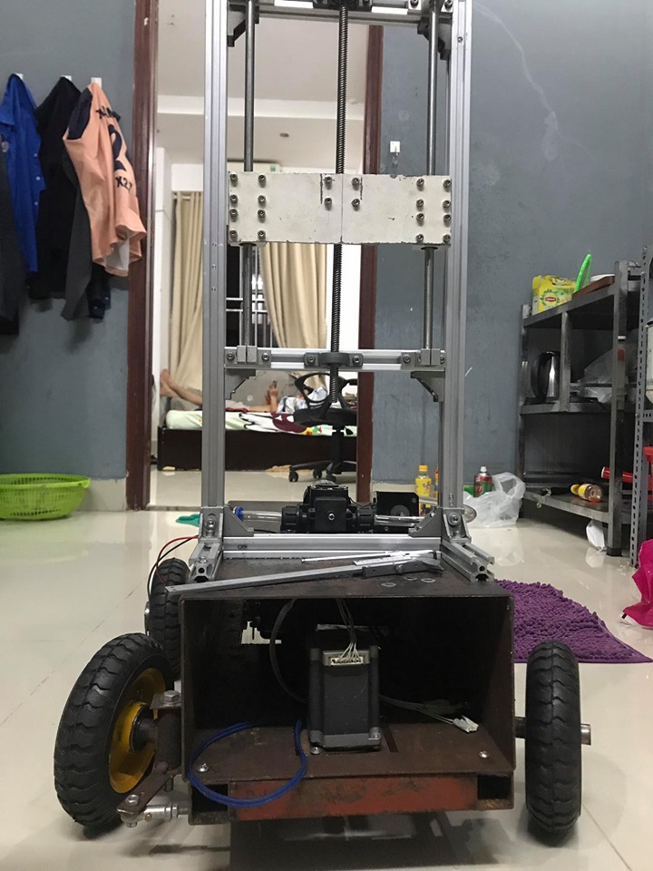
04_Multimedia/02_Images/2_08_2020/118873934_742301743290310_1053837143780202273_n.jpg
