VVCi/Graduate_Thesis/04_Multimedia/02_Images/10_18_2020/2020_08_23_14_09_IMG_2926.JPG

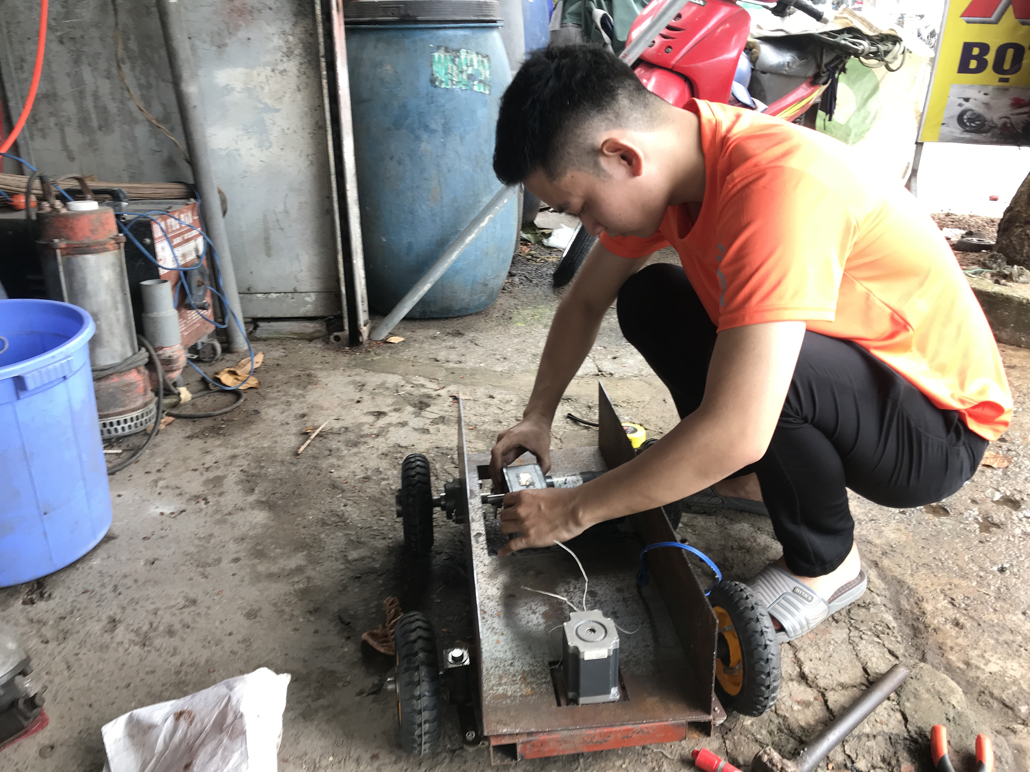
04_Multimedia/02_Images/10_18_2020/2020_08_23_14_09_IMG_2926.JPG
