VVCi/Graduate_Thesis/04_Multimedia/02_Images/10_18_2020/2020_09_06_16_52_IMG_3023.JPG

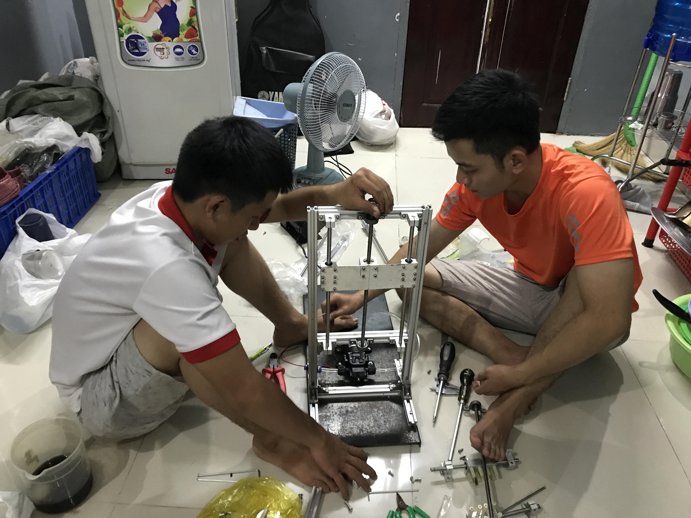
04_Multimedia/02_Images/10_18_2020/2020_09_06_16_52_IMG_3023.JPG
