VVCi/Graduate_Thesis/04_Multimedia/02_Images/10_18_2020/2020_10_18_11_05_IMG_3364.JPG

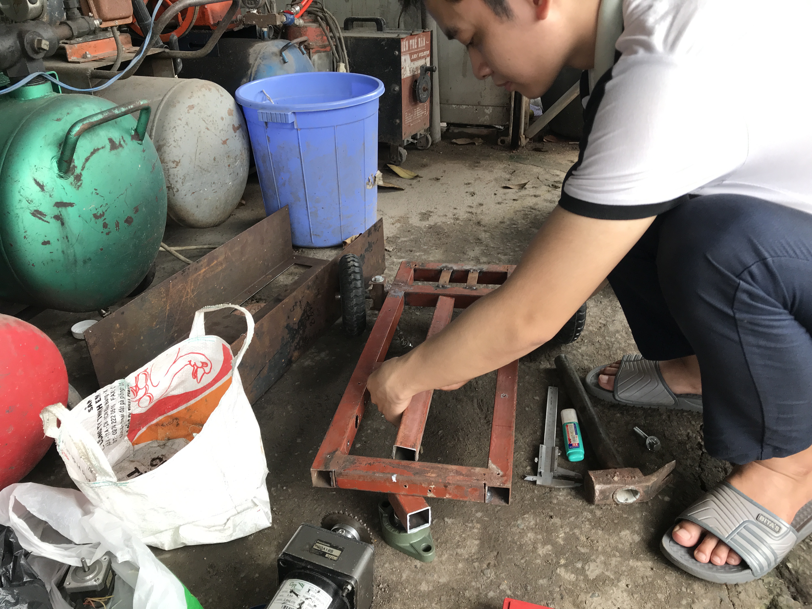
04_Multimedia/02_Images/10_18_2020/2020_10_18_11_05_IMG_3364.JPG
