VVCi/Graduate_Thesis/04_Multimedia/02_Images/10_18_2020/2020_10_18_12_15_IMG_3365.JPG

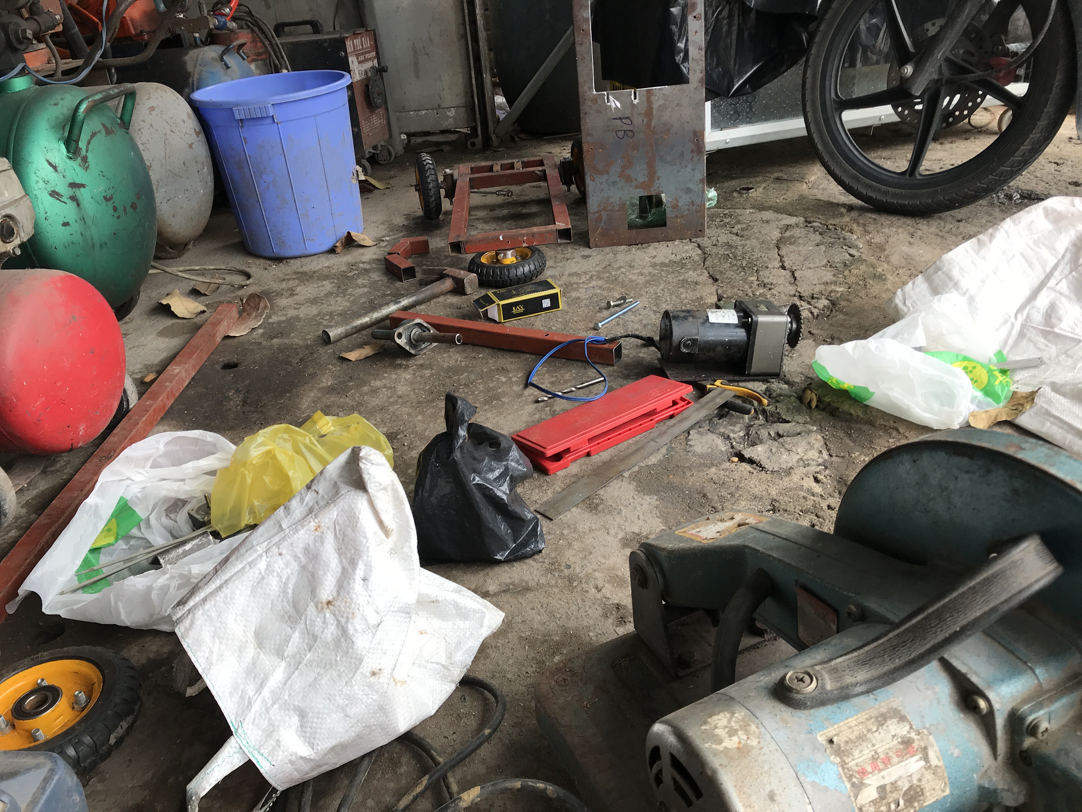
04_Multimedia/02_Images/10_18_2020/2020_10_18_12_15_IMG_3365.JPG
