VVCi/Graduate_Thesis/04_Multimedia/02_Images/10_18_2020/2020_10_18_13_15_IMG_3366.JPG

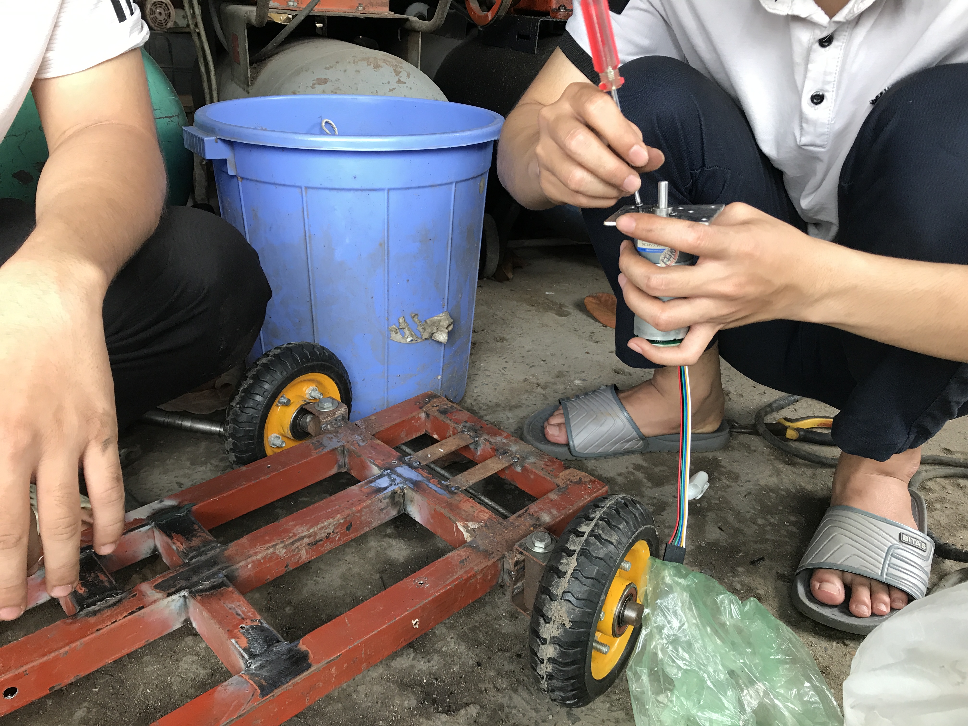
04_Multimedia/02_Images/10_18_2020/2020_10_18_13_15_IMG_3366.JPG
