VVCi/Graduate_Thesis/04_Multimedia/02_Images/10_18_2020/2020_10_18_14_22_IMG_3368.JPG

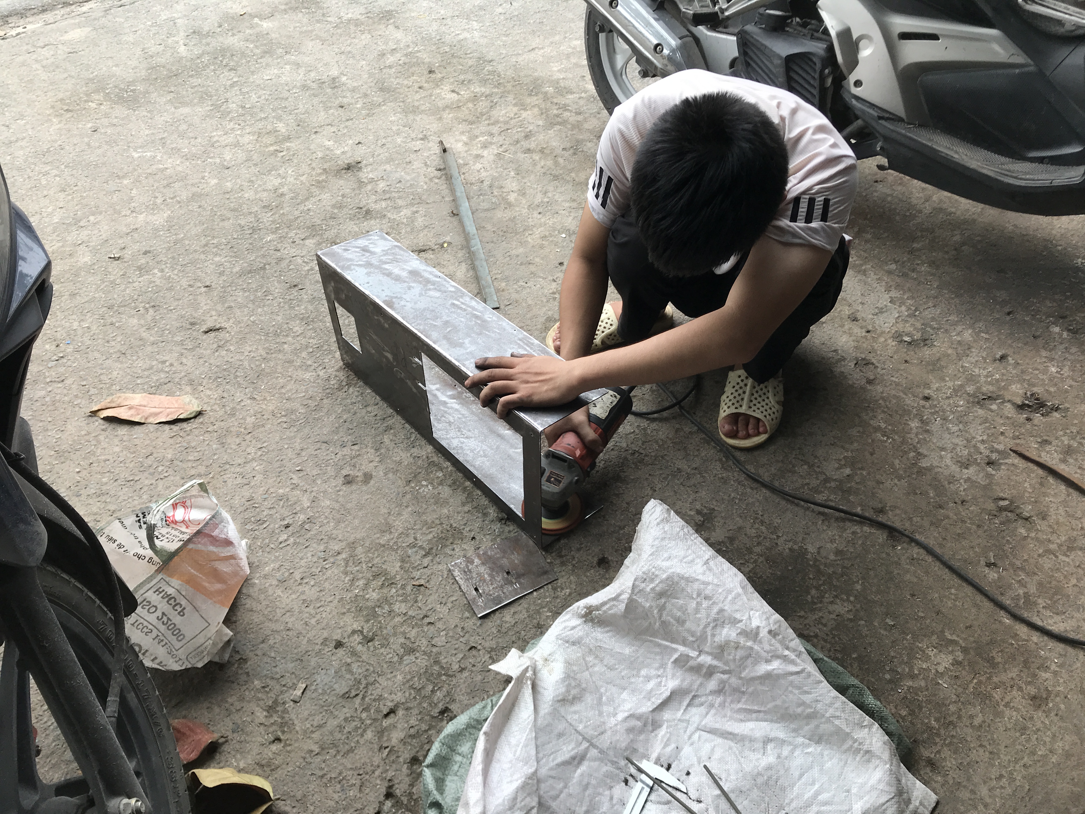
04_Multimedia/02_Images/10_18_2020/2020_10_18_14_22_IMG_3368.JPG
