VVCi/Graduate_Thesis/04_Multimedia/02_Images/Lab/914be6b64270b32eea61.jpg

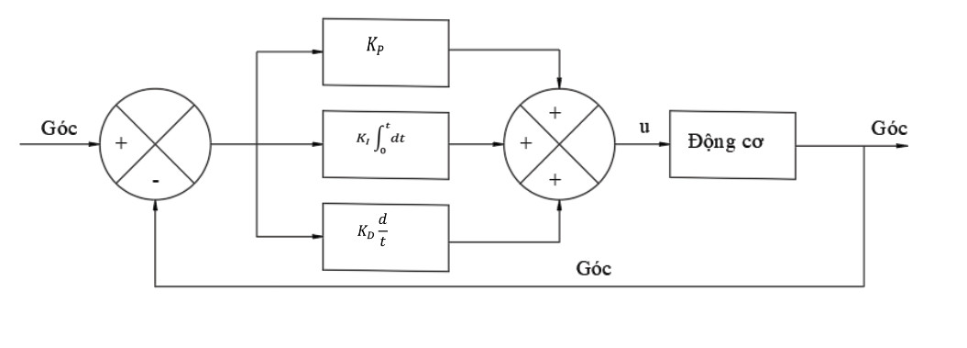
04_Multimedia/02_Images/Lab/914be6b64270b32eea61.jpg
