VVCi/Graduate_Thesis/04_Multimedia/02_Images/Lab/bshcbs.PNG

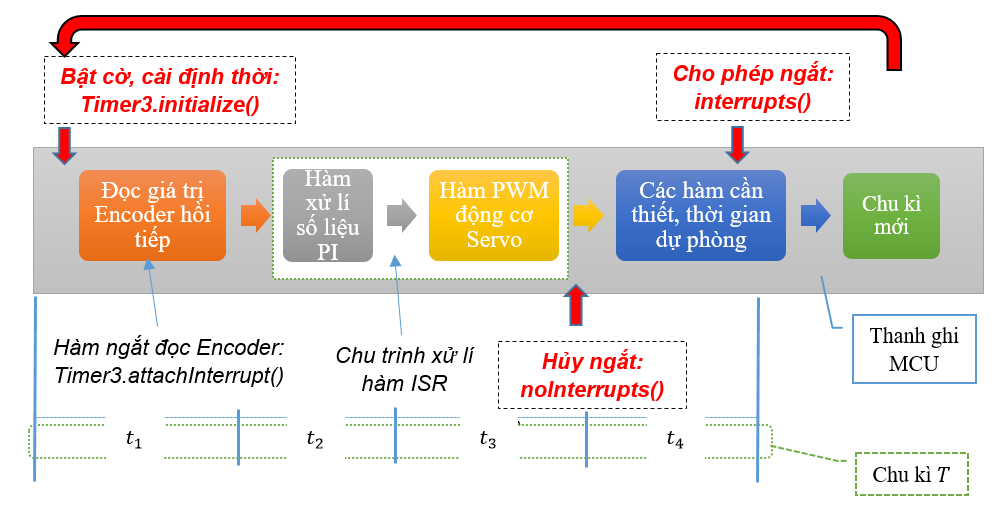
04_Multimedia/02_Images/Lab/bshcbs.PNG
