VVCi/Graduate_Thesis/04_Multimedia/02_Images/Lab/FS-TH9X_03.jpeg

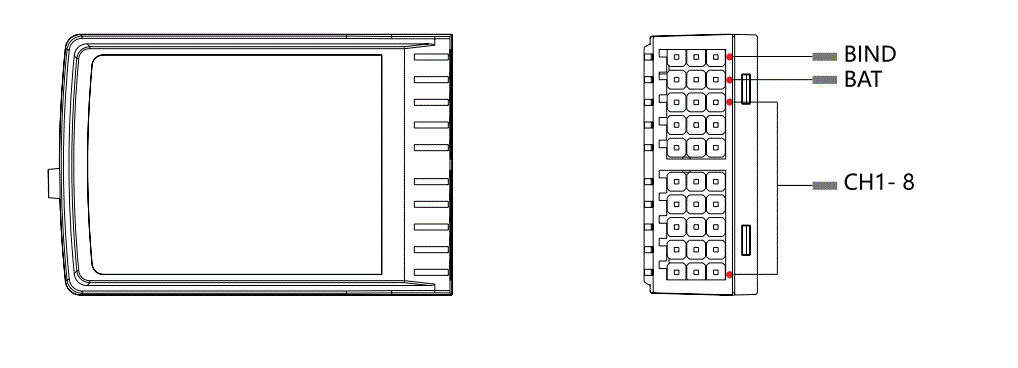
04_Multimedia/02_Images/Lab/FS-TH9X_03.jpeg
