VVCi/Graduate_Thesis/04_Multimedia/02_Images/Lab/Pi-Camera-NoIR-V2-2.jpg

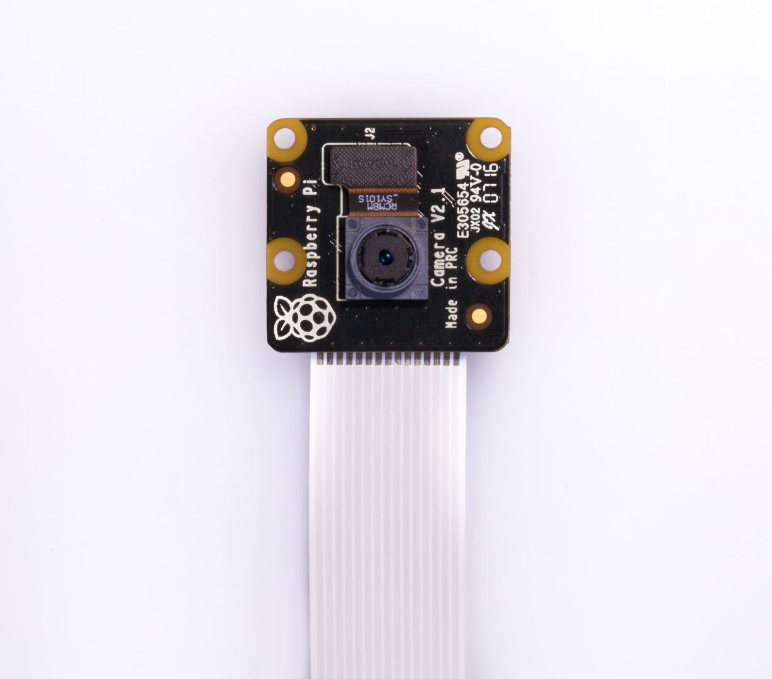
04_Multimedia/02_Images/Lab/Pi-Camera-NoIR-V2-2.jpg
