VVCi/Graduate_Thesis/04_Multimedia/02_Images/Open_Control_Lab/6ba27b56c49235cc6c83.jpg

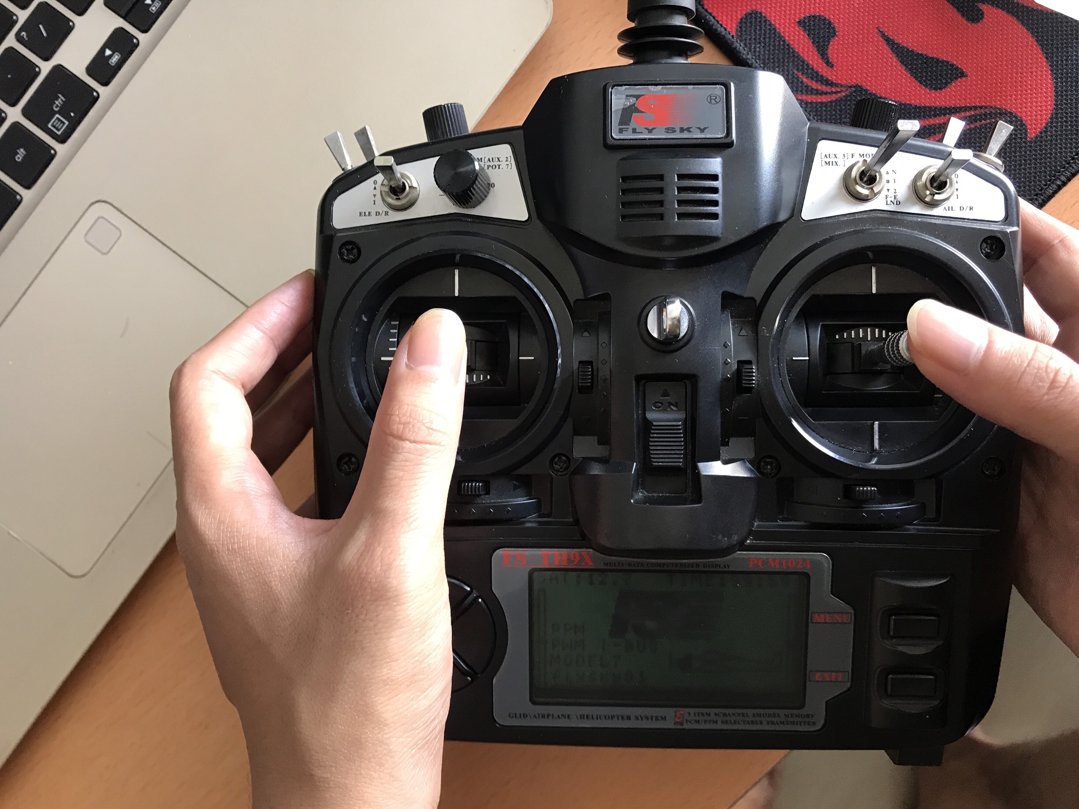
04_Multimedia/02_Images/Open_Control_Lab/6ba27b56c49235cc6c83.jpg
