VVCi/Graduate_Thesis/04_Multimedia/02_Images/Open_Control_Lab/30ee2e1c91d8608639c9.jpg

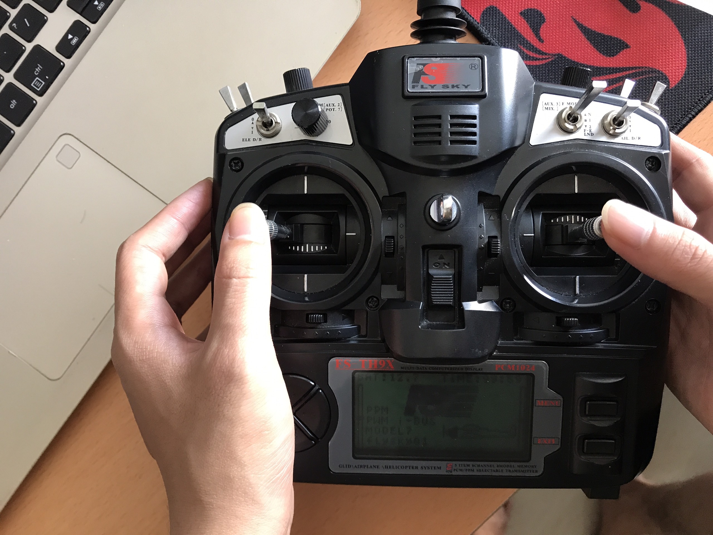
04_Multimedia/02_Images/Open_Control_Lab/30ee2e1c91d8608639c9.jpg
