VVCi/Graduate_Thesis/04_Multimedia/02_Images/Open_Control_Lab/DC_BaseMax.png

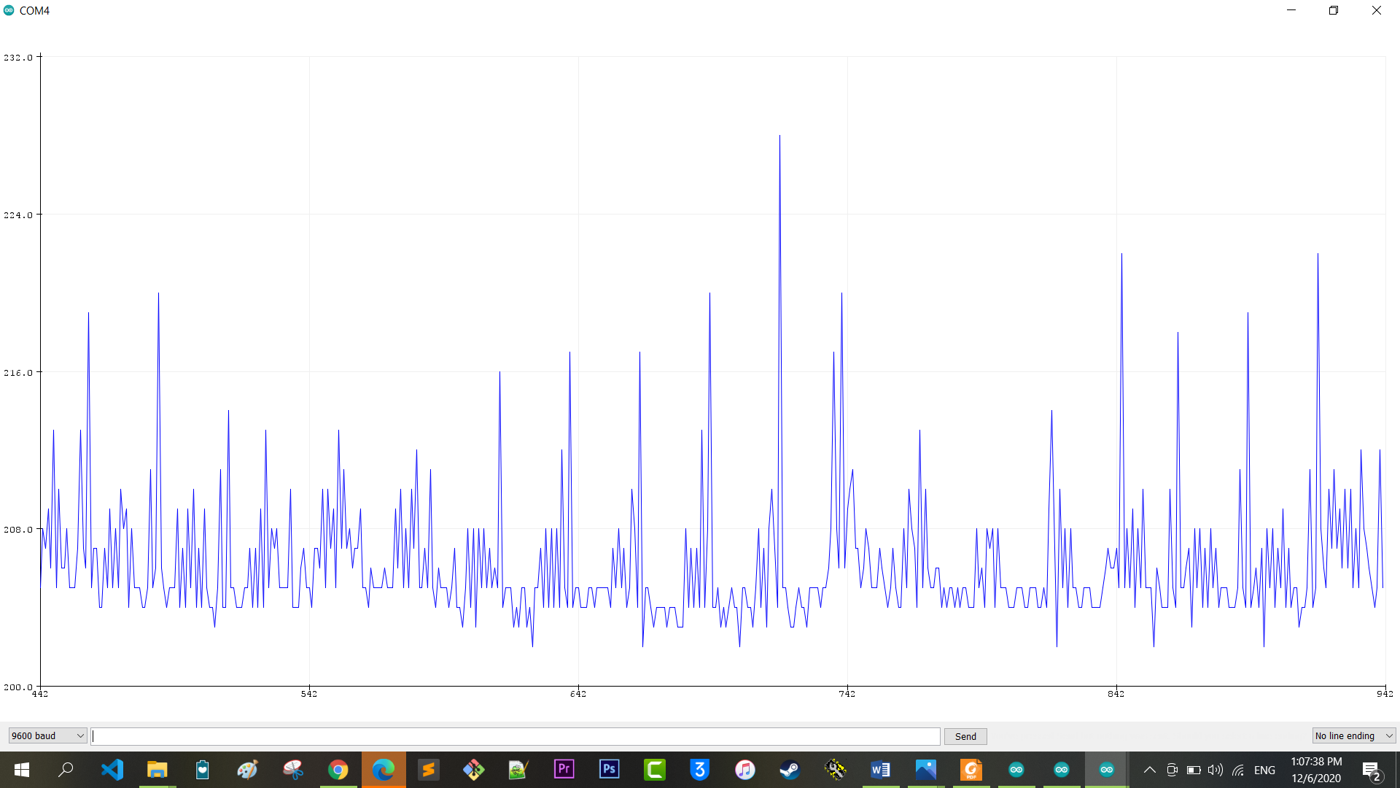
04_Multimedia/02_Images/Open_Control_Lab/DC_BaseMax.png
