VVCi/Graduate_Thesis/04_Multimedia/02_Images/Open_Control_Lab/DC_BaseUp.png

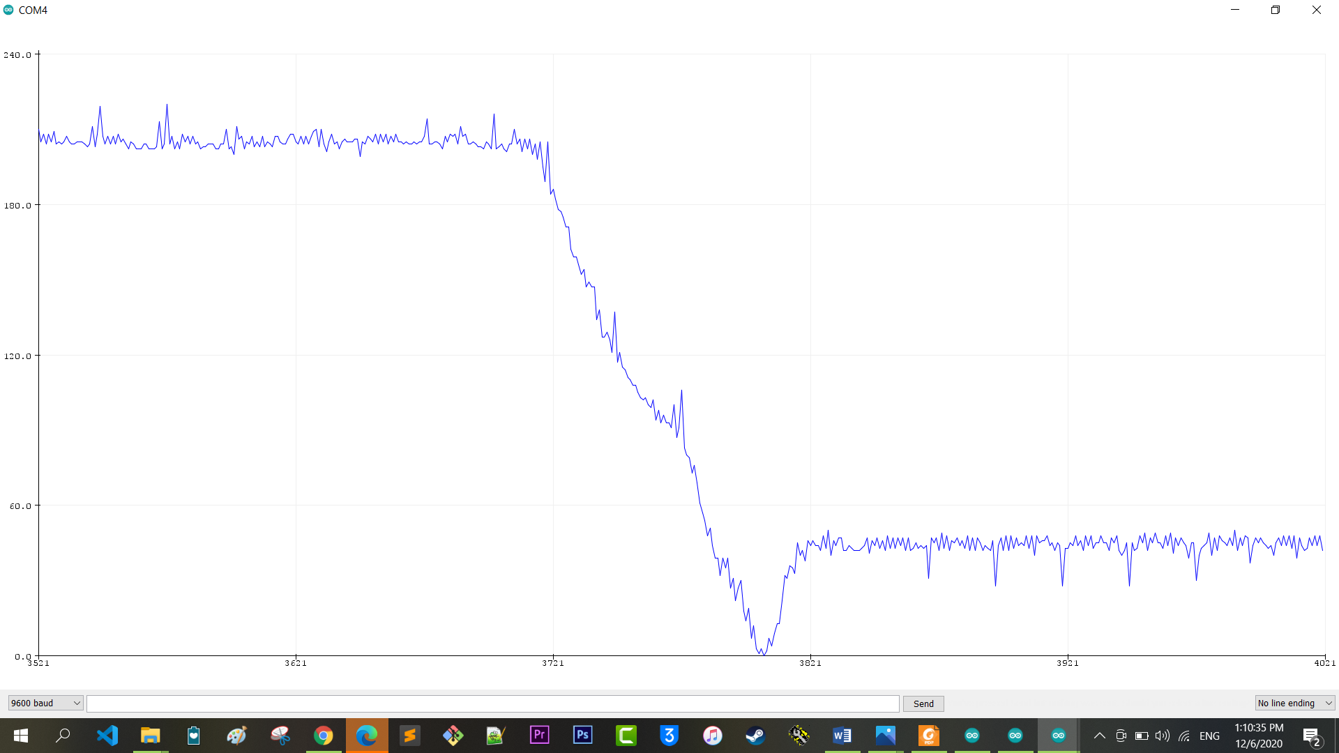
04_Multimedia/02_Images/Open_Control_Lab/DC_BaseUp.png
