VVCi/Graduate_Thesis/04_Multimedia/02_Images/PID_Control_Lab/1(0.01-0.5-100).png

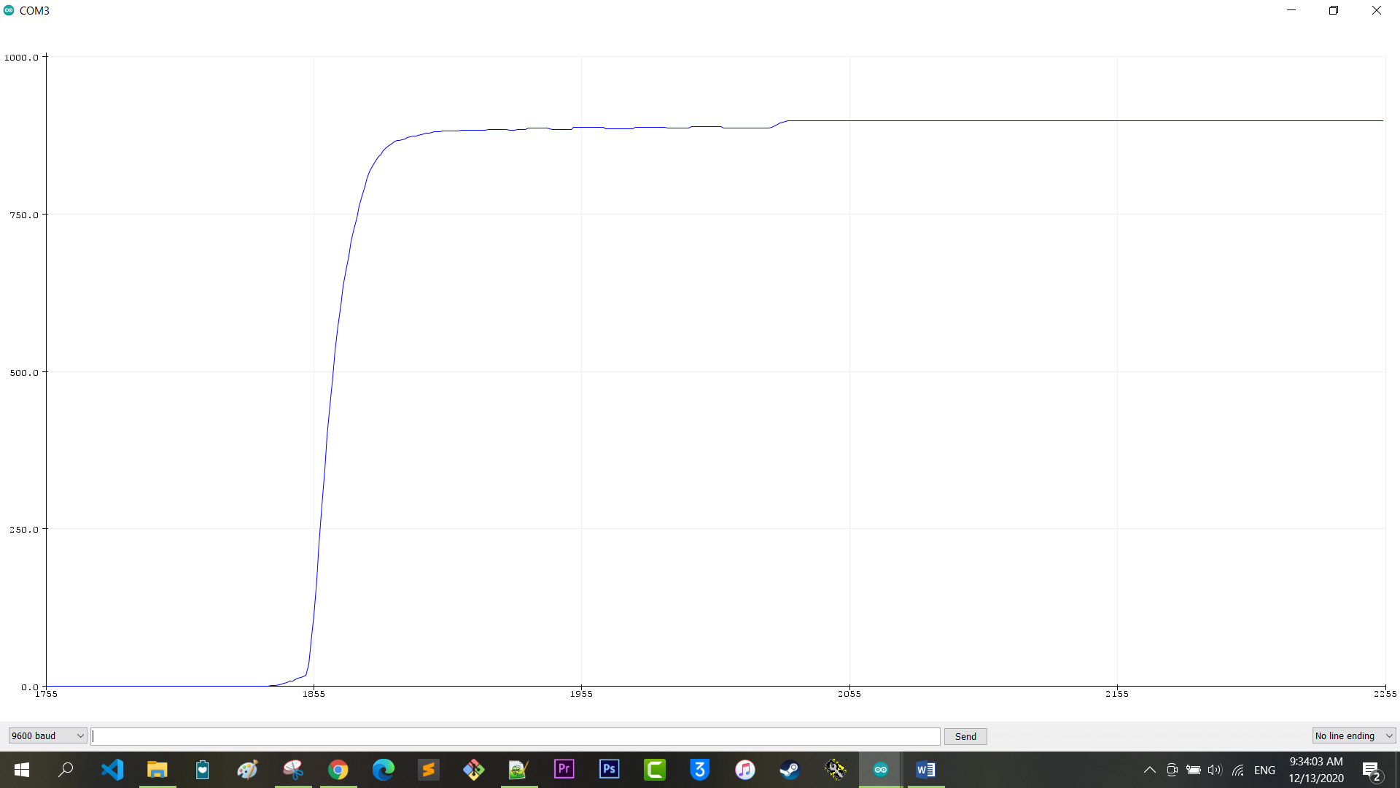
04_Multimedia/02_Images/PID_Control_Lab/1(0.01-0.5-100).png
