VVCi/Graduate_Thesis/04_Multimedia/02_Images/PID_Control_Lab/1_3.png

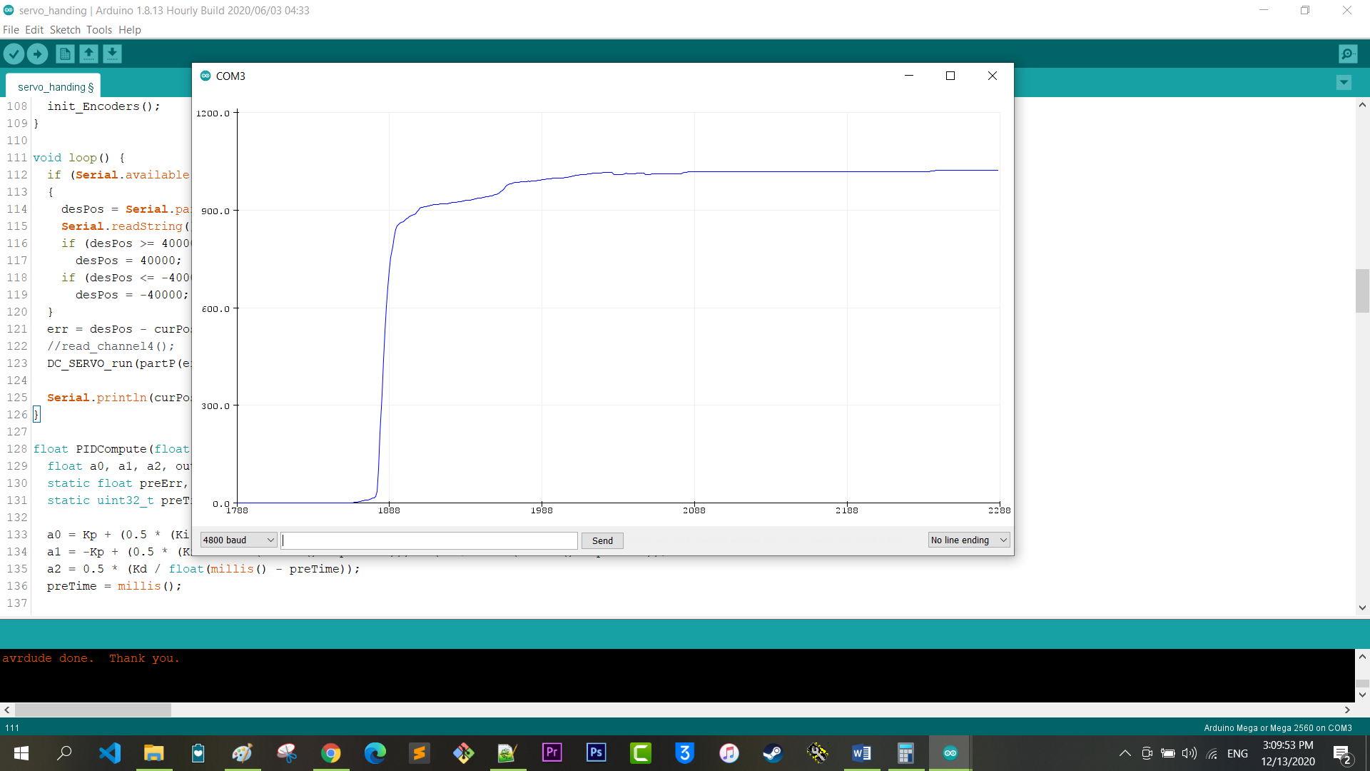
04_Multimedia/02_Images/PID_Control_Lab/1_3.png
