VVCi/Graduate_Thesis/04_Multimedia/02_Images/PID_Control_Lab/Nghich_PI3.png

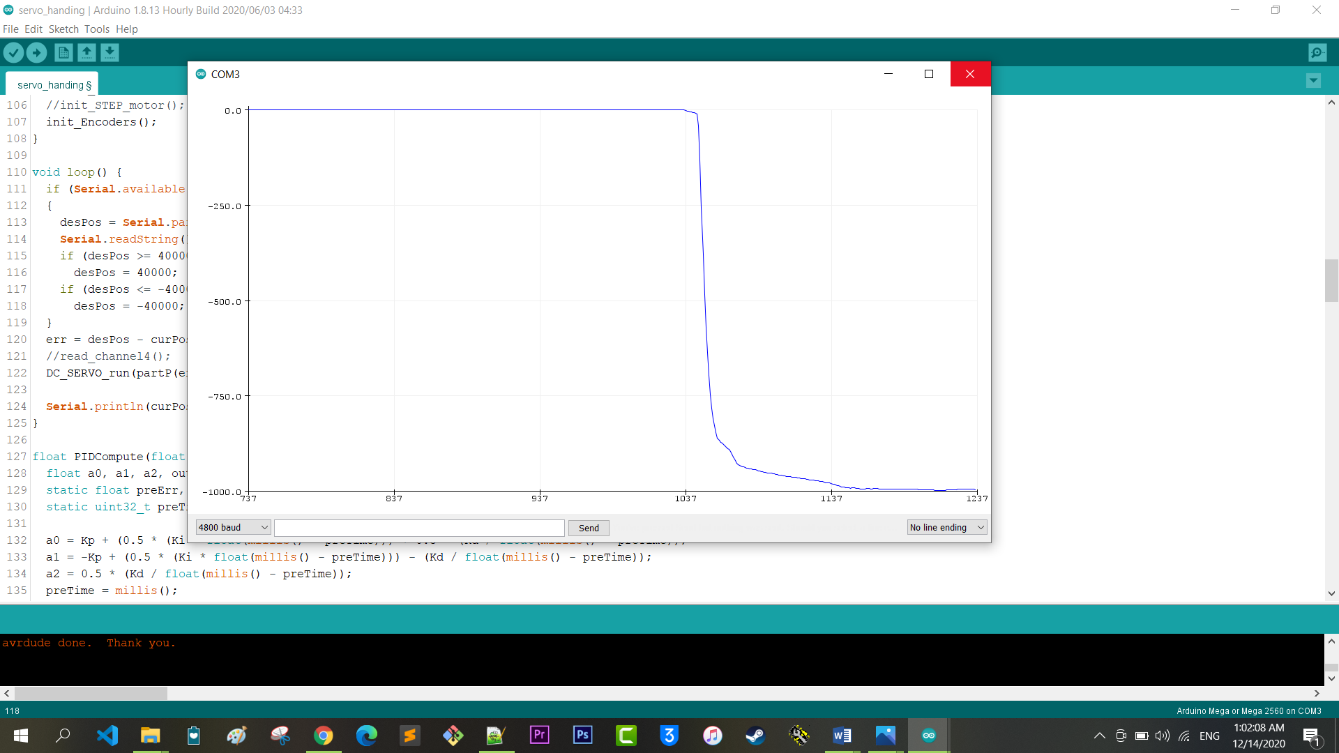
04_Multimedia/02_Images/PID_Control_Lab/Nghich_PI3.png
