VVCi/Graduate_Thesis/04_Multimedia/02_Images/Target_Sample_Farm/122807139_10158562412457696_9049287381240732057_n.jpg

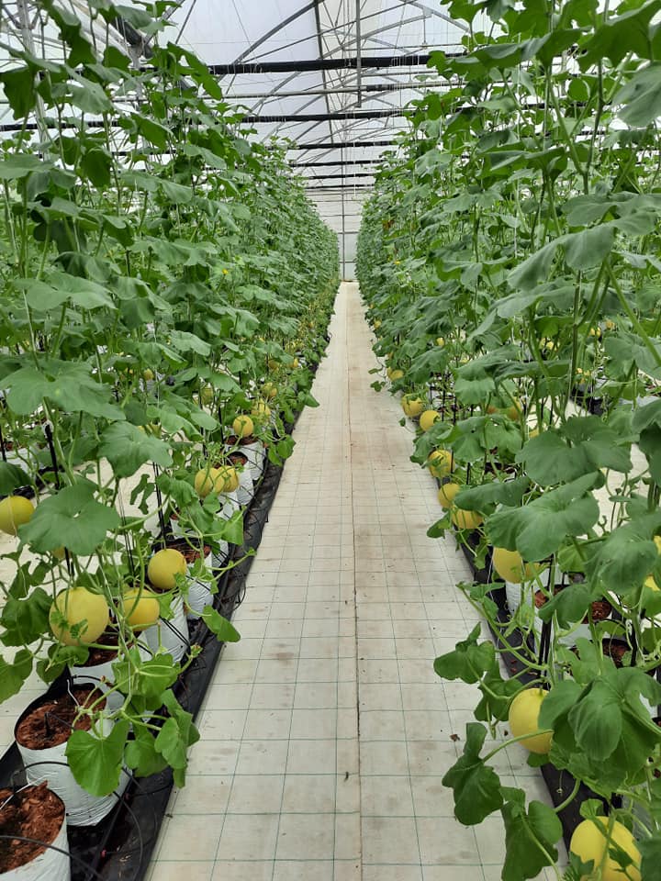
04_Multimedia/02_Images/Target_Sample_Farm/122807139_10158562412457696_9049287381240732057_n.jpg
