VVCi/Graduate_Thesis/04_Multimedia/02_Images/Target_Sample_Farm/123052480_10158562412667696_1506999510866760232_n.jpg

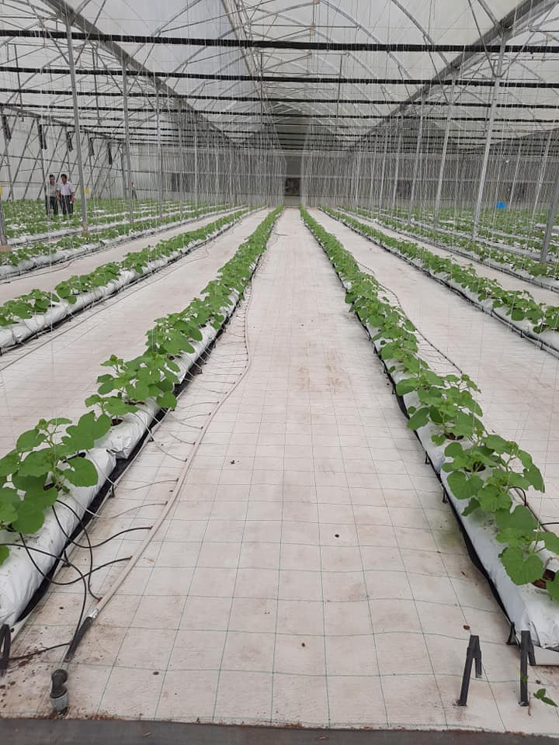
04_Multimedia/02_Images/Target_Sample_Farm/123052480_10158562412667696_1506999510866760232_n.jpg
