VVCi/Graduate_Thesis/04_Multimedia/02_Images/Target_Sample_Farm/123136608_10158562412572696_4543292786012771199_n.jpg

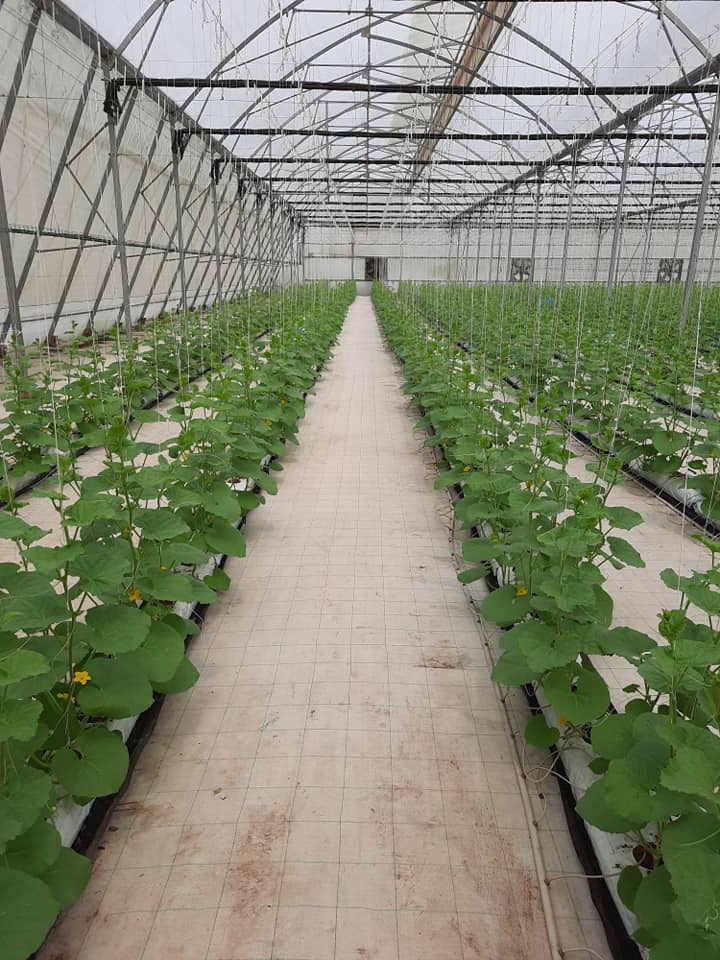
04_Multimedia/02_Images/Target_Sample_Farm/123136608_10158562412572696_4543292786012771199_n.jpg
