VVCi/Graduate_Thesis/03_CAD/CAM/de-camera-3.stl

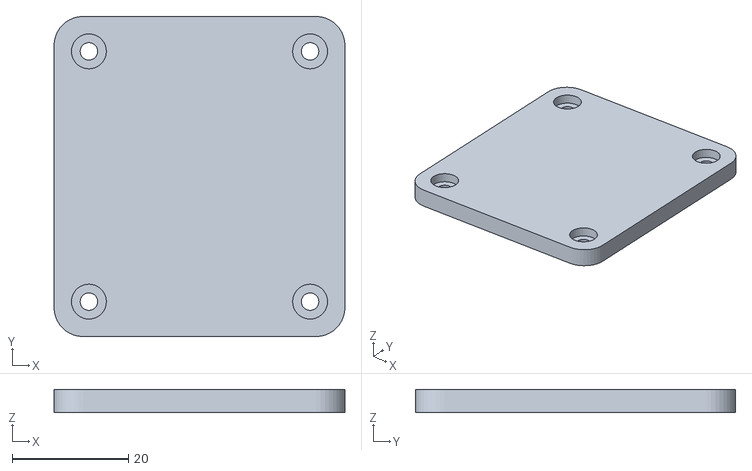
[picture p202: CAD file, 2020-12-15]
03_CAD/CAM/de-camera-3.stl
50.0 x 55.0 x 4.00
