VVCi/Graduate_Thesis/06_Src/temp/MPU6050/Toxiclib/toxiclibscore/examples/mesh/STLImportTest/mesh-flipped.stl

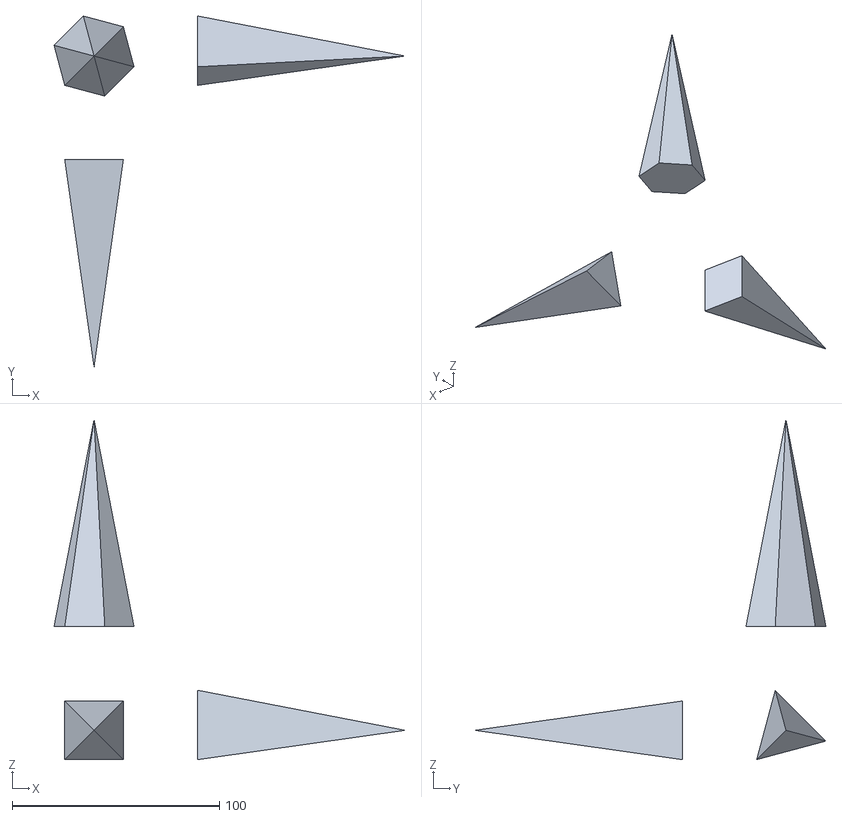
[picture p203: CAD file, 2020-12-28]
06_Src/temp/MPU6050/Toxiclib/toxiclibscore/examples/mesh/STLImportTest/mesh-flipped.stl
169.3 x 169.3 x 164.1
