VVCi/Graduate_Thesis/03_CAD/CAM/de-camera-2.stl

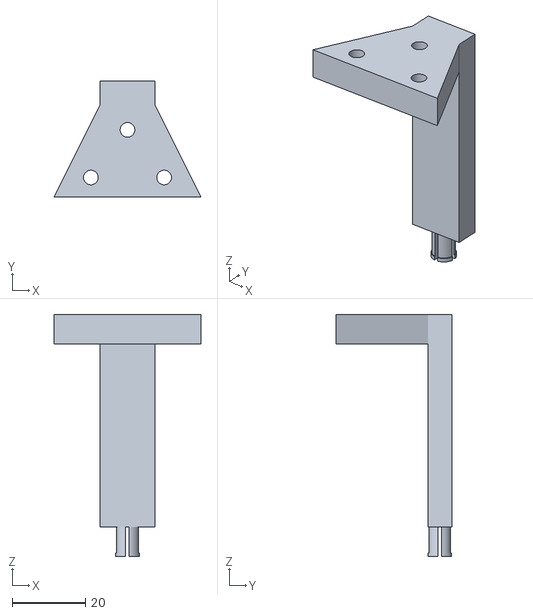
[picture p204: CAD file, 2020-12-15]
03_CAD/CAM/de-camera-2.stl
40.0 x 31.5 x 66.0
