VVCi/Graduate_Thesis/03_CAD/CAM/de-camera-1.stl

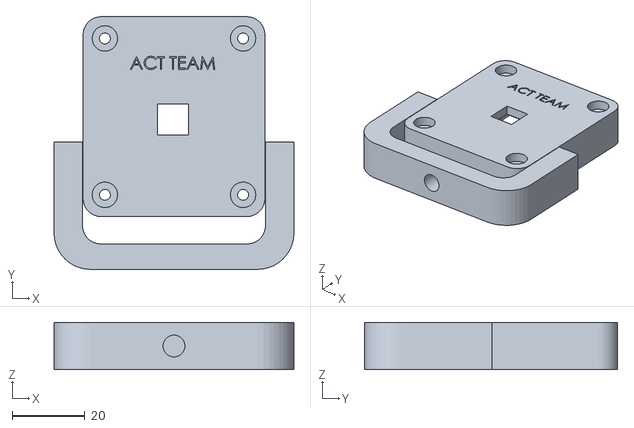
[picture p205: CAD file, 2020-12-15]
03_CAD/CAM/de-camera-1.stl
66.0 x 69.5 x 13.0
