VVCi/Graduate_Thesis/(list of files, cad)

Other CAD files:
06_Src/temp/MPU6050/Toxiclib/toxiclibscore/examples/mesh/STLImportTest/mesh.stl
