VVCi/Graduate_Thesis/05_Reference_Documents/Food_3D_Printer/CD/Tập bản vẽ.PDF

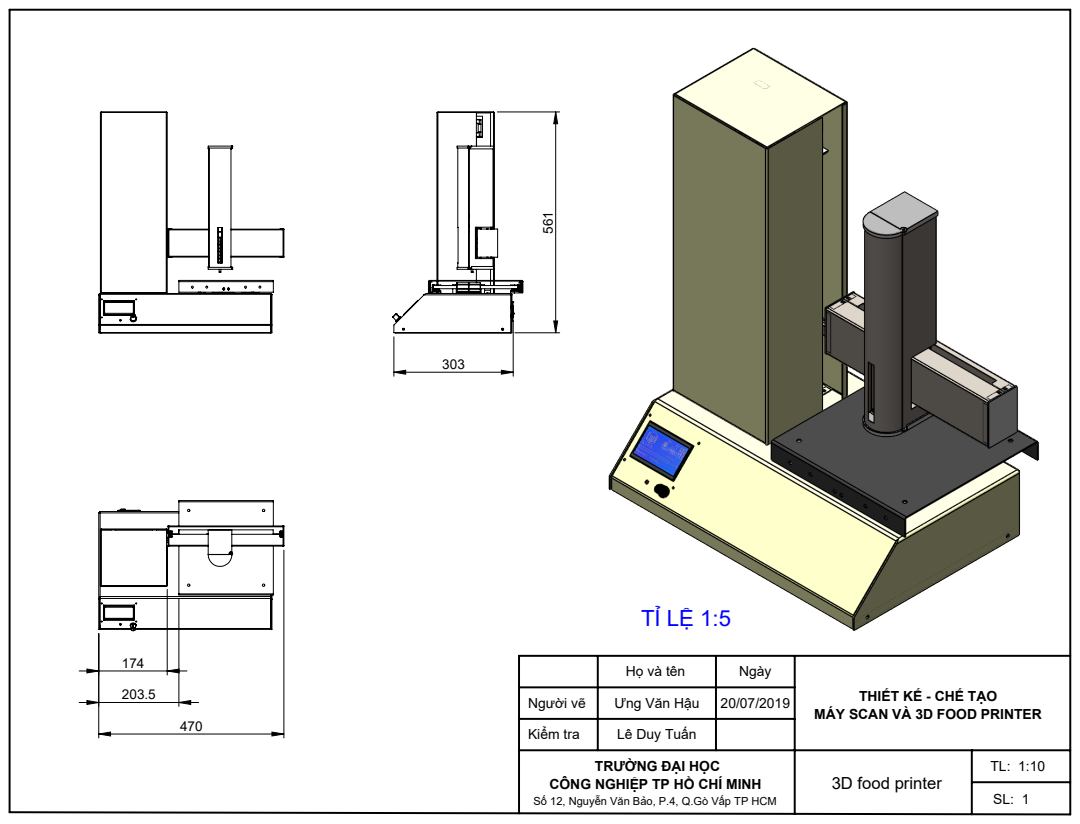
[picture p206: page 1]

Họ và tên | Ngày | THIẾT KẾ - CHẾ TẠO MÁY SCAN VÀ 3D FOOD PRINTER

Người vẽ | Ưng Văn Hậu | 20/07/2019
Kiểm tra | Lê Duy Tuấn
TRƯỜNG ĐẠI HỌC CÔNG NGHIỆP TP HỒ CHÍ MINH Số 12, Nguyễn Văn Bảo, P.4, Q.Gò Vấp TP HCM | 3D food printer | TL: 1:10

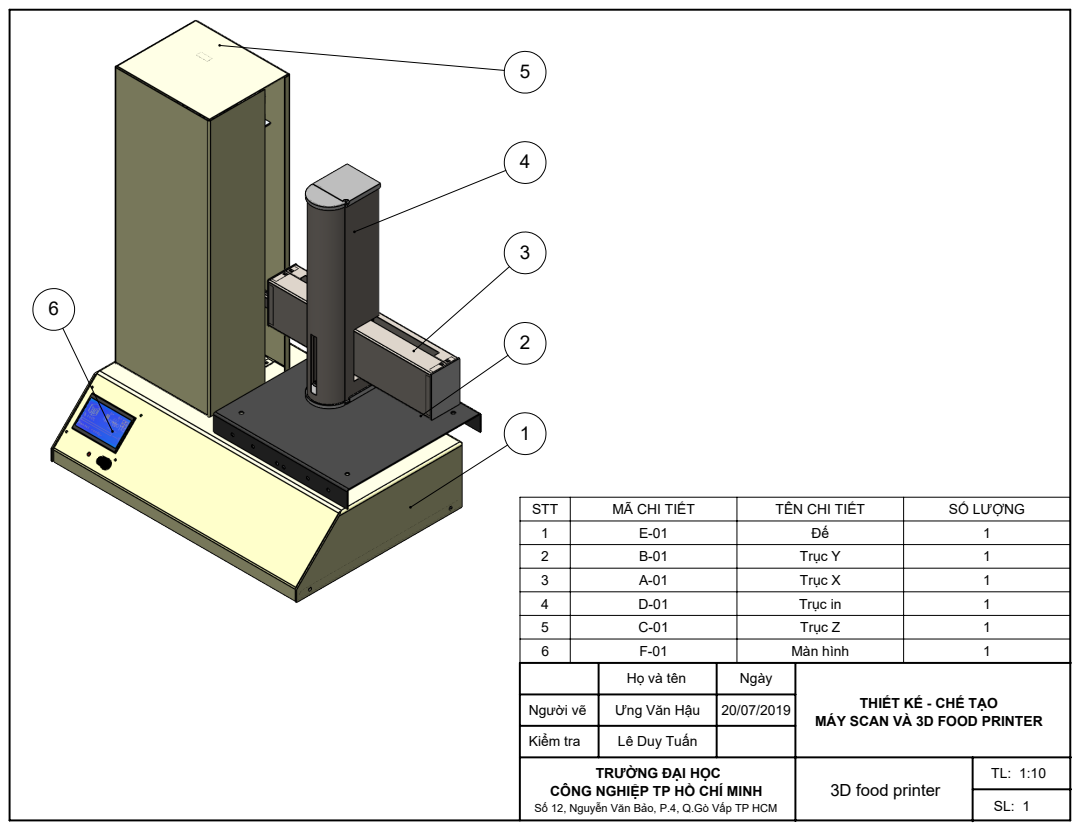
[picture p207: page 2]

STT | MÃ CHI TIẾT | TÊN CHI TIẾT | SỐ LƯỢNG
1 | E-01 | Đế | 1
2 | B-01 | Trục Y | 1
3 | A-01 | Trục X | 1
4 | D-01 | Trục in | 1
5 | C-01 | Trục Z | 1
6 | F-01 | Màn hình | 1

Họ và tên | Ngày | THIẾT KẾ - CHẾ TẠO MÁY SCAN VÀ 3D FOOD PRINTER

Người vẽ | Ưng Văn Hậu | 20/07/2019
Kiểm tra | Lê Duy Tuấn

TRƯỜNG ĐẠI HỌC | 3D food printer | TL: 1:10

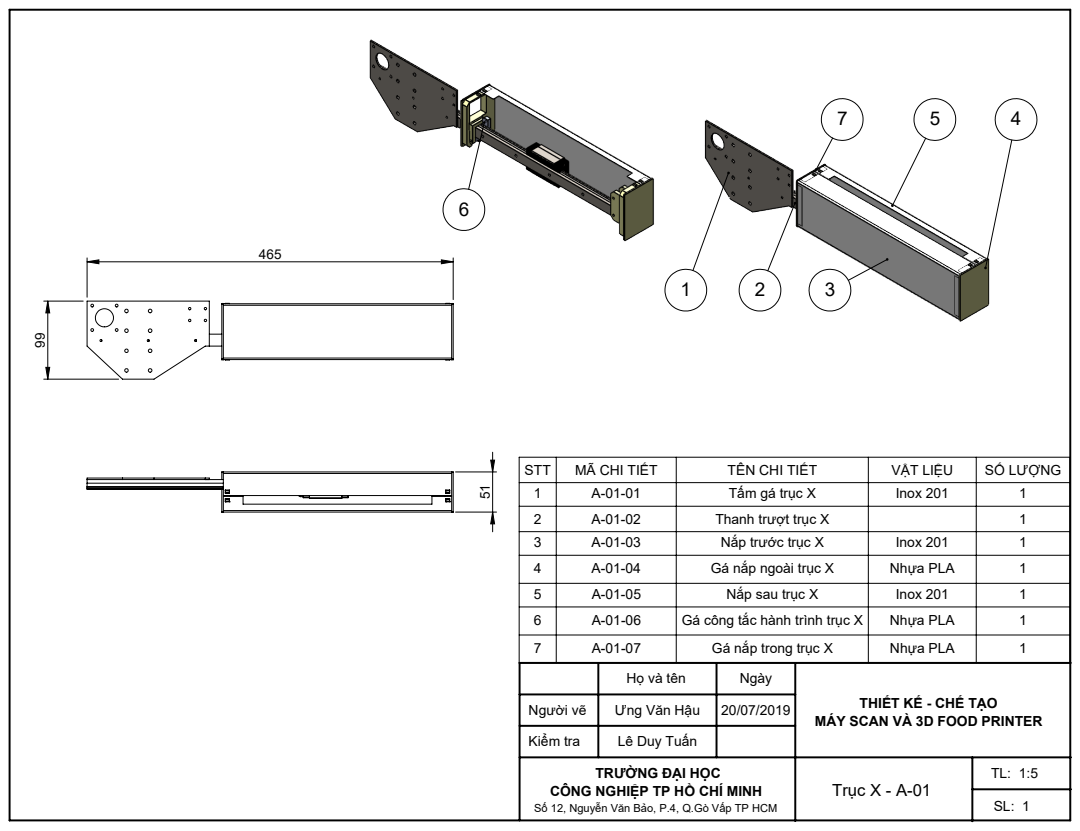
[picture p208: page 3]

STT | MÃ CHI TIẾT | TÊN CHI TIẾT | VẬT LIỆU | SỐ LƯỢNG
1 | A-01-01 | Tấm gá trục X | Inox 201 | 1
2 | A-01-02 | Thanh trượt trục X | | 1
3 | A-01-03 | Nắp trước trục X | Inox 201 | 1
4 | A-01-04 | Gá nắp ngoài trục X | Nhựa PLA | 1
5 | A-01-05 | Nắp sau trục X | Inox 201 | 1
6 | A-01-06 | Gá công tắc hành trình trục X | Nhựa PLA | 1
7 | A-01-07 | Gá nắp trong trục X | Nhựa PLA | 1

Họ và tên | Ngày | THIẾT KẾ - CHẾ TẠO MÁY SCAN VÀ 3D FOOD PRINTER

Người vẽ | Ưng Văn Hậu | 20/07/2019
Kiểm tra | Lê Duy Tuấn

TRƯỜNG ĐẠI HỌC | Trục X - A-01

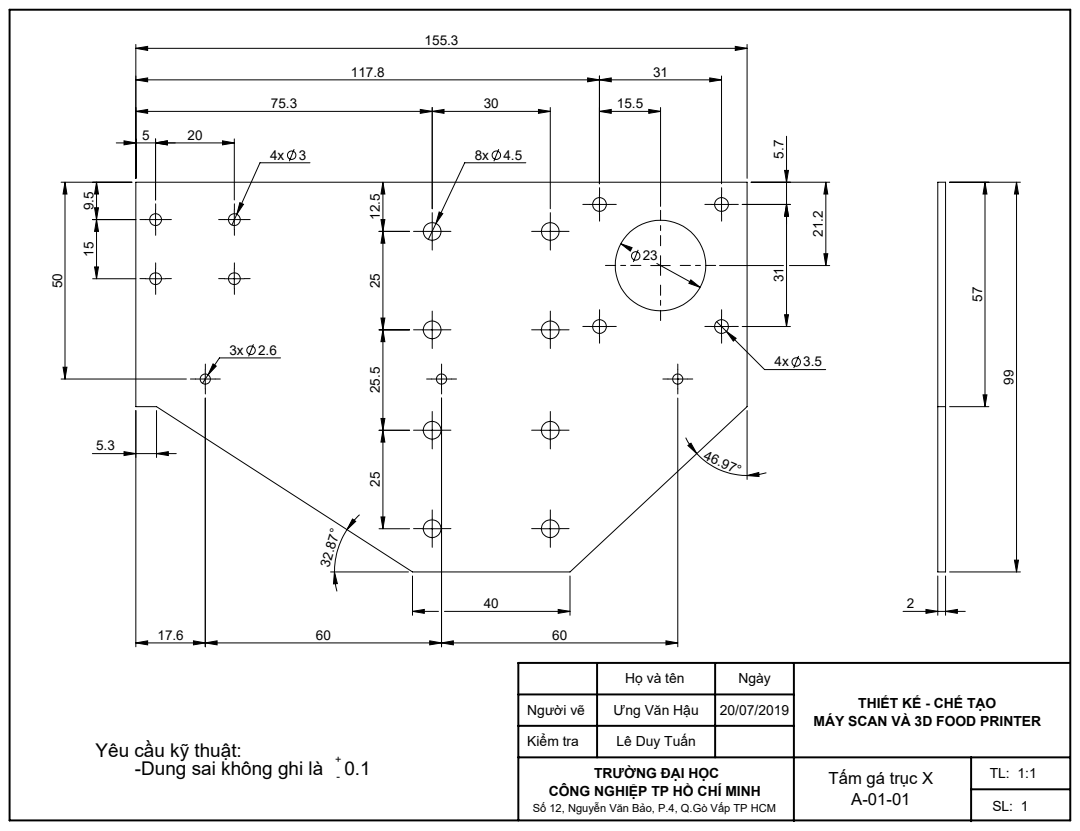
[picture p209: page 4]

Họ và tên | Ngày | THIẾT KẾ - CHẾ TẠO MÁY SCAN VÀ 3D FOOD PRINTER

Người vẽ | Ưng Văn Hậu | 20/07/2019
Kiểm tra | Lê Duy Tuấn

Yêu cầu kỹ thuật:
-Dung sai không ghi là 0.1 +

- Tấm gá trục X

TRƯỜNG ĐẠI HỌC

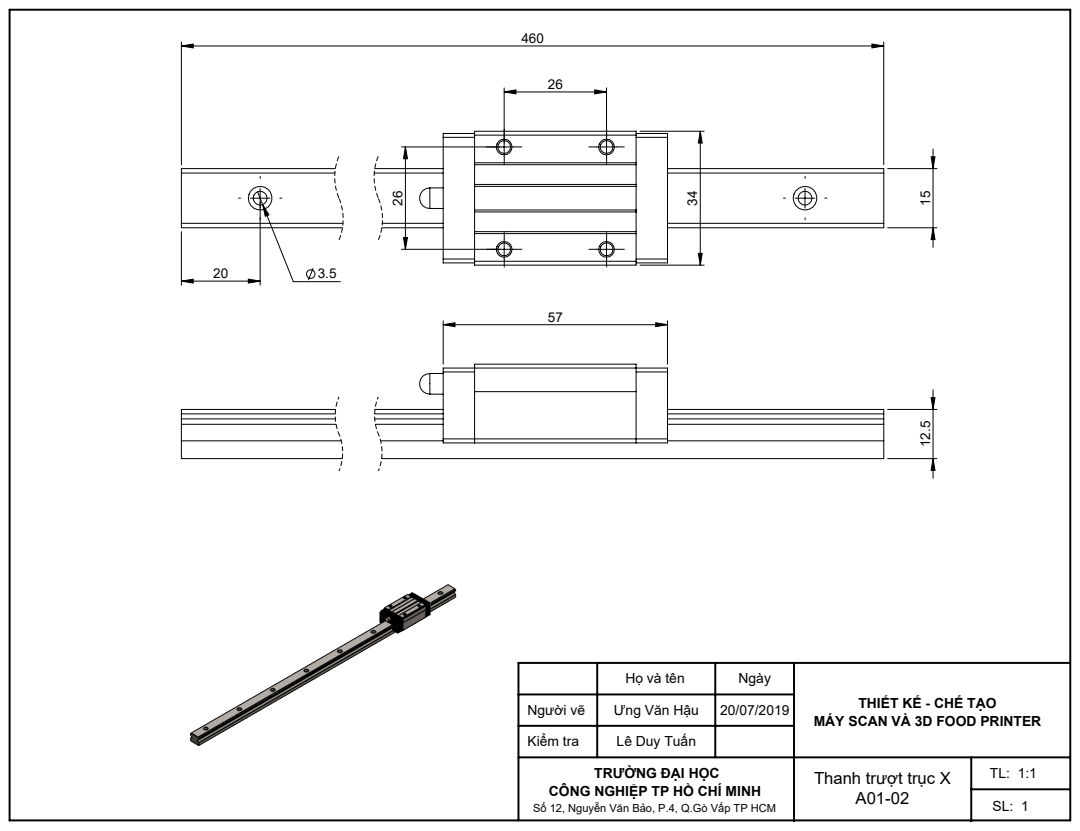
[picture p210: page 5]

Họ và tên | Ngày | THIẾT KẾ - CHẾ TẠO MÁY SCAN VÀ 3D FOOD PRINTER

Người vẽ | Ưng Văn Hậu | 20/07/2019
Kiểm tra | Lê Duy Tuấn
TRƯỜNG ĐẠI HỌC | Thanh trượt trục X A01-02

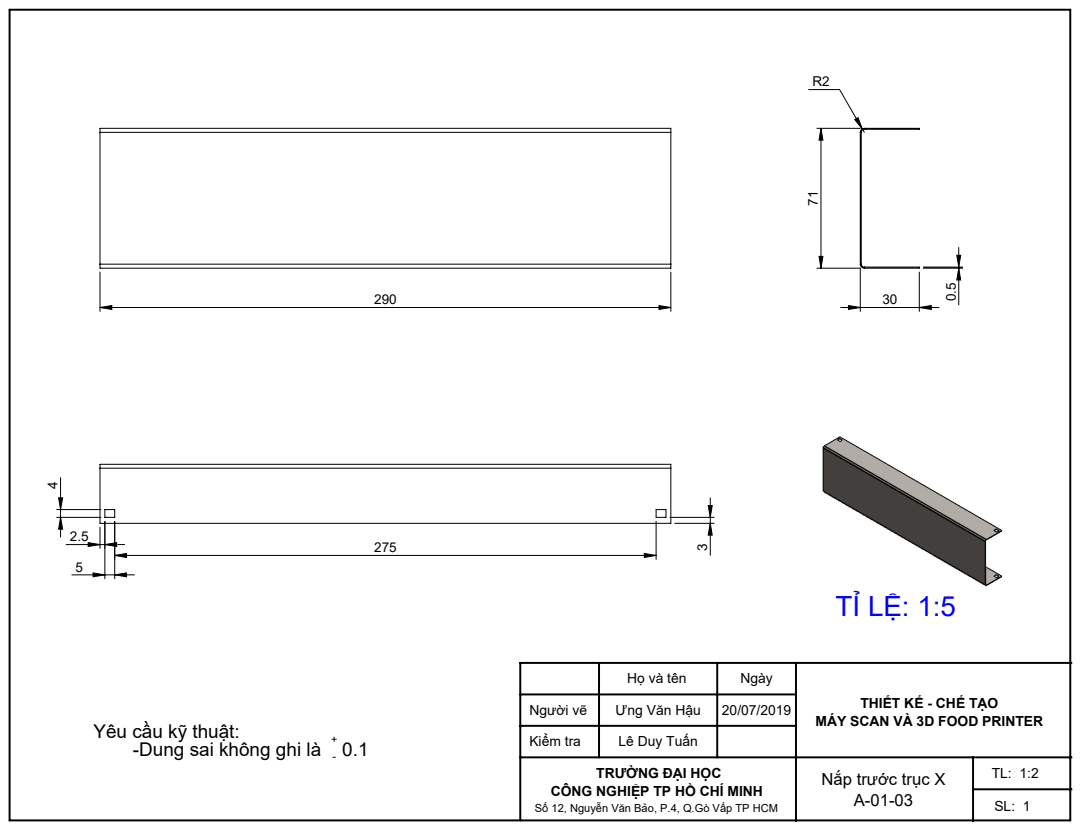
[picture p211: page 6]

Họ và tên | Ngày | THIẾT KẾ - CHẾ TẠO MÁY SCAN VÀ 3D FOOD PRINTER

Người vẽ | Ưng Văn Hậu | 20/07/2019
Kiểm tra | Lê Duy Tuấn
TRƯỜNG ĐẠI HỌC | Nắp trước trục X A-01-03

Yêu cầu kỹ thuật:
-Dung sai không ghi là 0.1

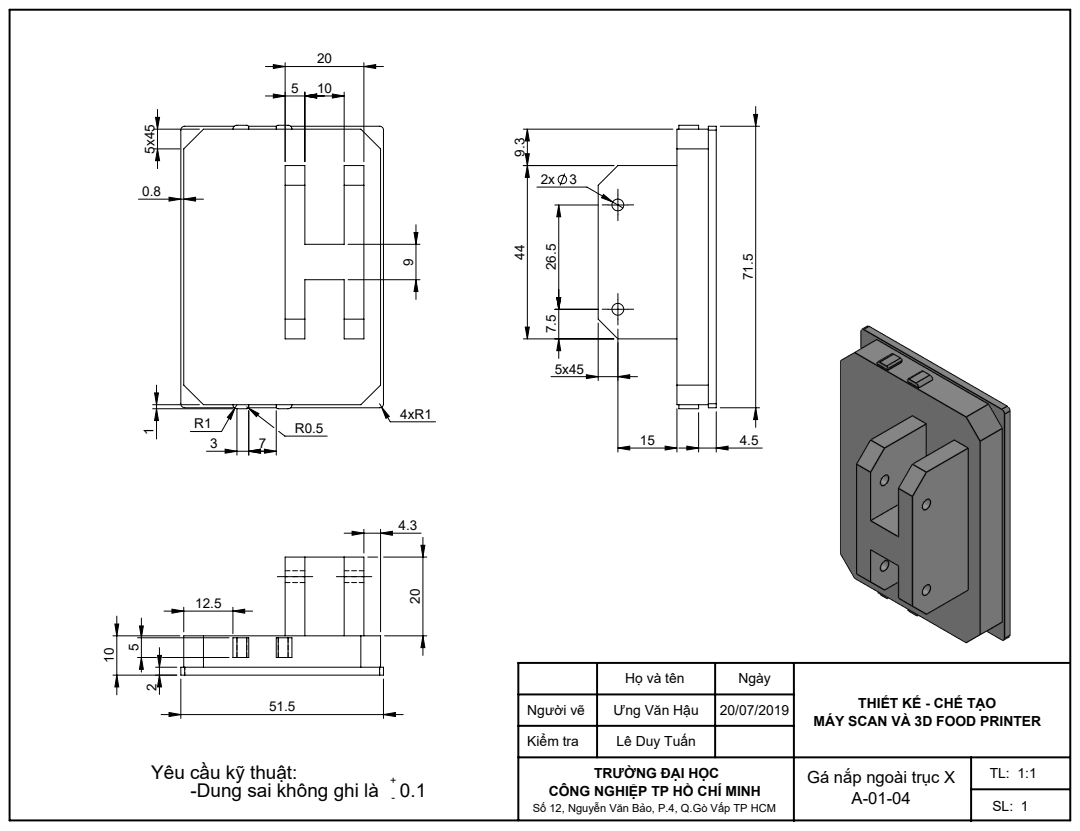
[picture p212: page 7]
-Dung sai không ghi là 0.1; Gá nắp ngoài trục X

Họ và tên | Ngày | THIẾT KẾ - CHẾ TẠO MÁY SCAN VÀ 3D FOOD PRINTER

Người vẽ | Ưng Văn Hậu | 20/07/2019
Kiểm tra | Lê Duy Tuấn

Yêu cầu kỹ thuật:

TRƯỜNG ĐẠI HỌC

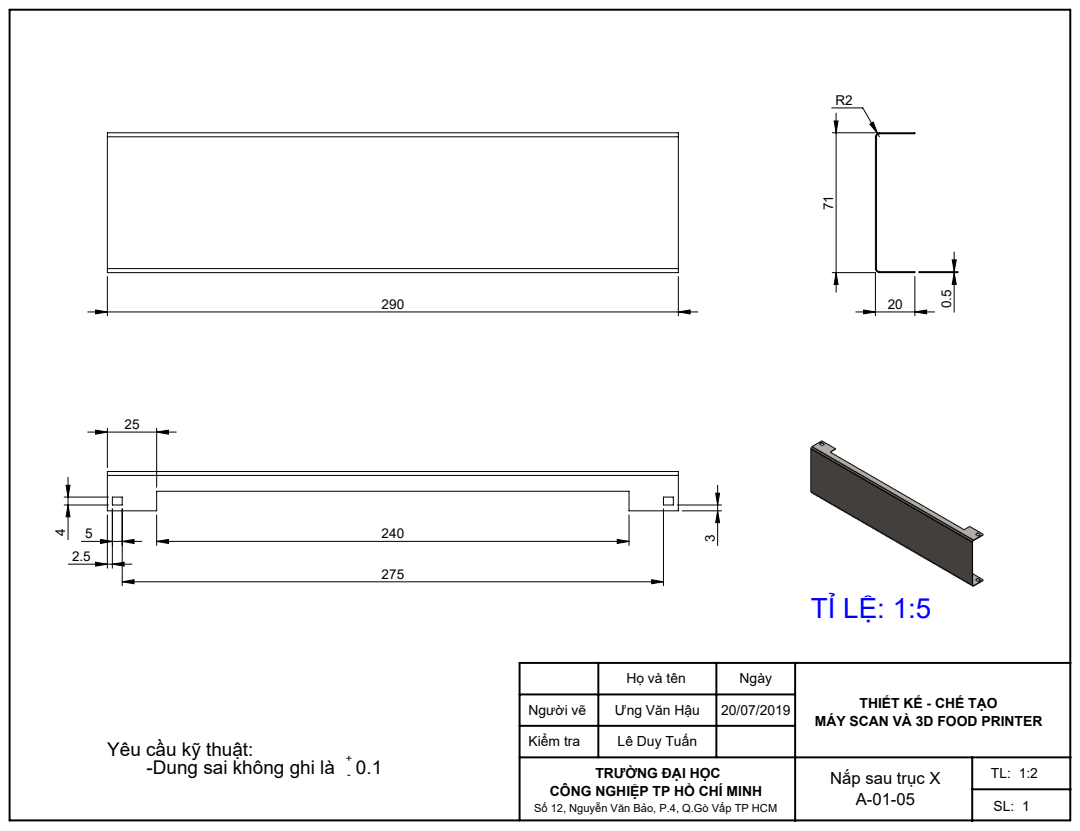
[picture p213: page 8]
-Dung sai không ghi là 0.1; Nắp sau trục X

Họ và tên | Ngày | THIẾT KẾ - CHẾ TẠO MÁY SCAN VÀ 3D FOOD PRINTER

Người vẽ | Ưng Văn Hậu | 20/07/2019
Kiểm tra | Lê Duy Tuấn
TRƯỜNG ĐẠI HỌC | A-01-05

Yêu cầu kỹ thuật:

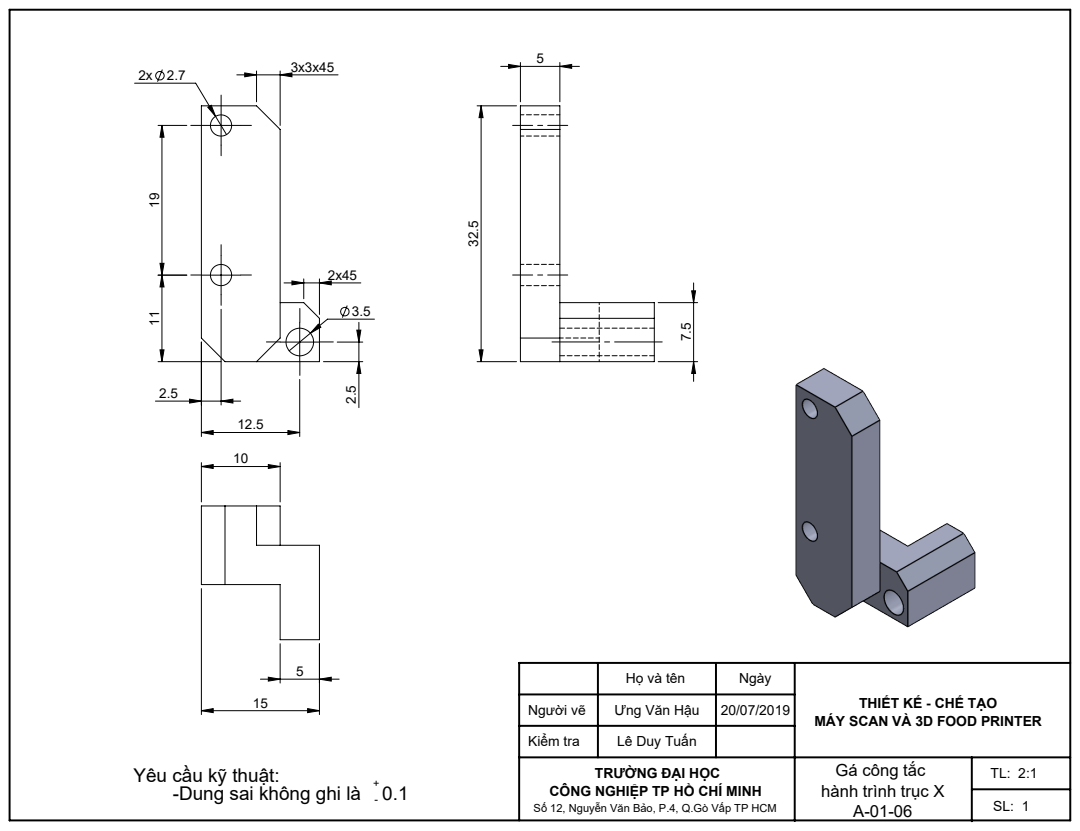
[picture p214: page 9]

Họ và tên | Ngày | THIẾT KẾ - CHẾ TẠO MÁY SCAN VÀ 3D FOOD PRINTER

Người vẽ | Ưng Văn Hậu | 20/07/2019
Kiểm tra | Lê Duy Tuấn
TRƯỜNG ĐẠI HỌC | Gá công tắc hành trình trục X A-01-06 | TL: 2:1

Yêu cầu kỹ thuật:
-Dung sai không ghi là 0.1

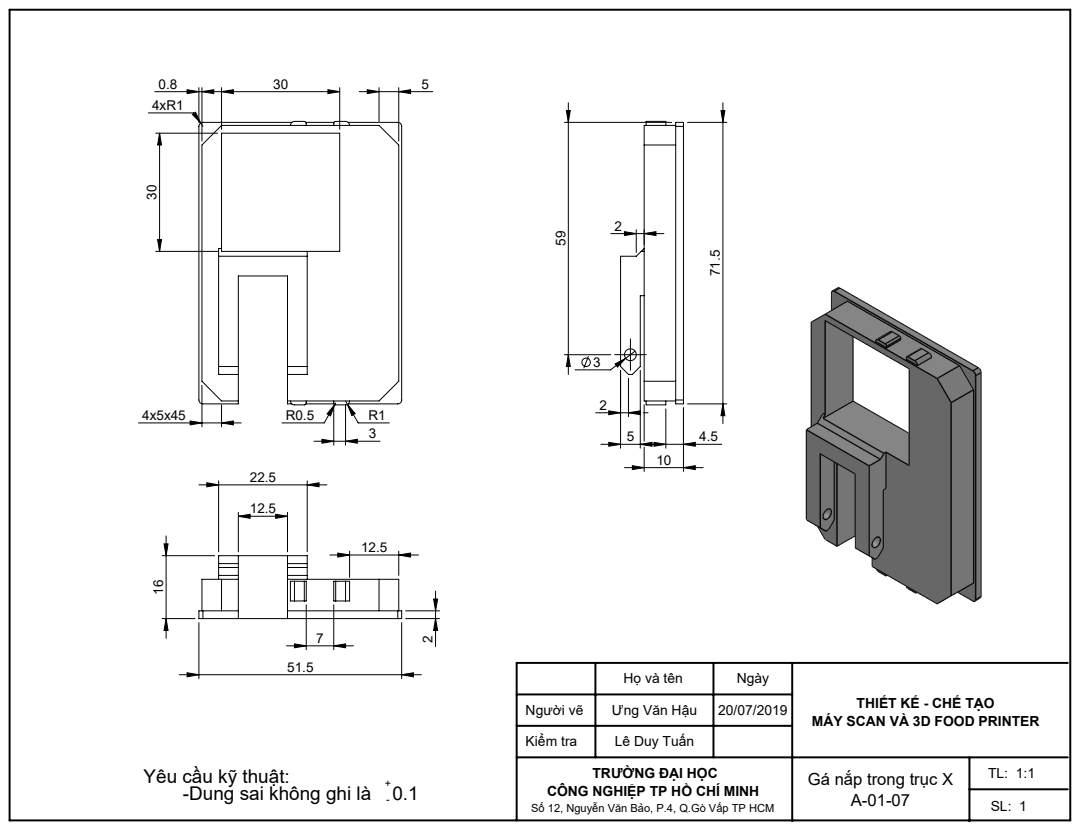
[picture p215: page 10]
-Dung sai không ghi là 0.1; Gá nắp trong trục X

Họ và tên | Ngày | THIẾT KẾ - CHẾ TẠO MÁY SCAN VÀ 3D FOOD PRINTER

Người vẽ | Ưng Văn Hậu | 20/07/2019
Kiểm tra | Lê Duy Tuấn
TRƯỜNG ĐẠI HỌC | A-01-07

Yêu cầu kỹ thuật:

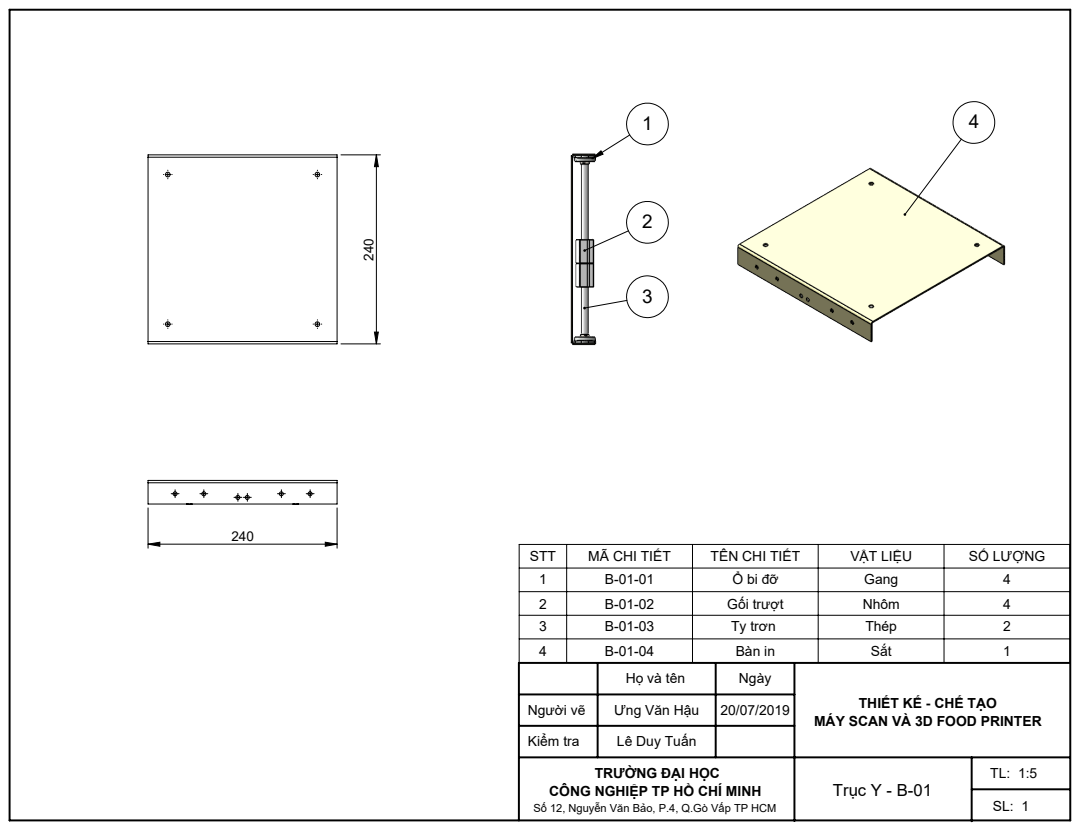
[picture p216: page 11]

STT | MÃ CHI TIẾT | TÊN CHI TIẾT | VẬT LIỆU | SỐ LƯỢNG
1 | B-01-01 | Ổ bi đỡ | Gang | 4
2 | B-01-02 | Gối trượt | Nhôm | 4
3 | B-01-03 | Ty trơn | Thép | 2
4 | B-01-04 | Bàn in | Sắt | 1

Họ và tên | Ngày | THIẾT KẾ - CHẾ TẠO MÁY SCAN VÀ 3D FOOD PRINTER

Người vẽ | Ưng Văn Hậu | 20/07/2019
Kiểm tra | Lê Duy Tuấn
TRƯỜNG ĐẠI HỌC | Trục Y - B-01

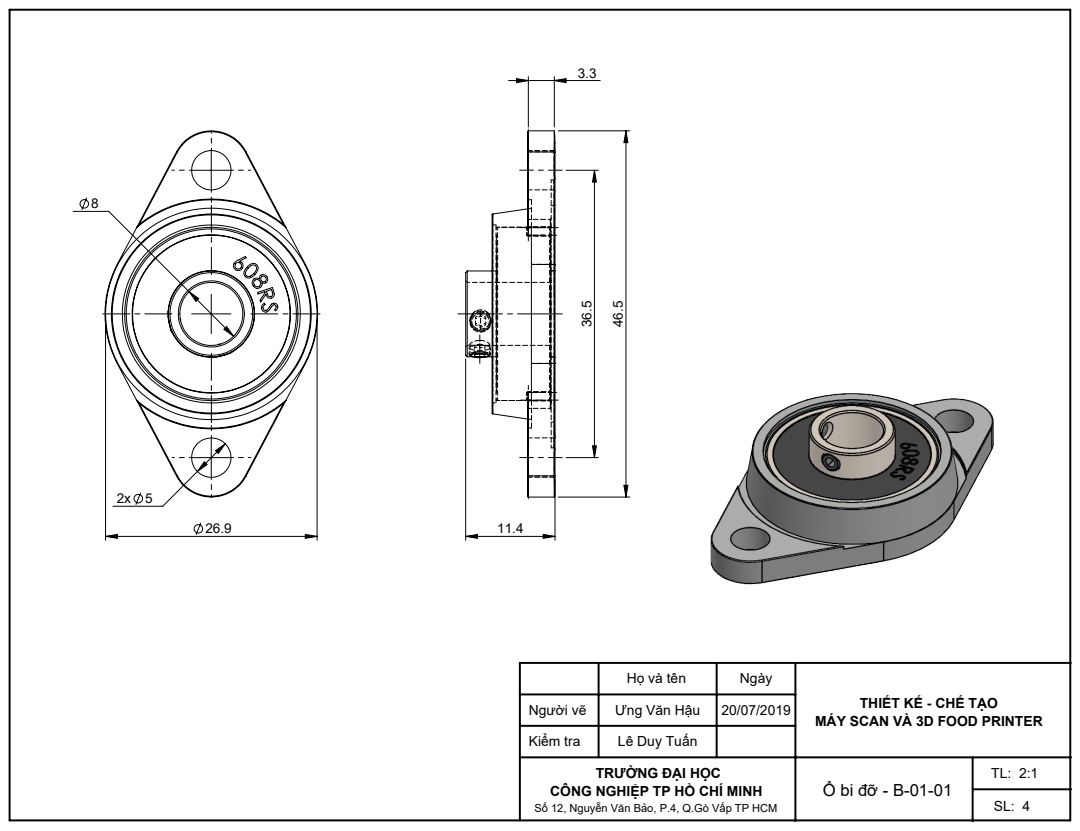
[picture p217: page 12]

Họ và tên | Ngày | THIẾT KẾ - CHẾ TẠO MÁY SCAN VÀ 3D FOOD PRINTER

Người vẽ | Ưng Văn Hậu | 20/07/2019
Kiểm tra | Lê Duy Tuấn
TRƯỜNG ĐẠI HỌC | Ổ bi đỡ - B-01-01 | TL: 2:1

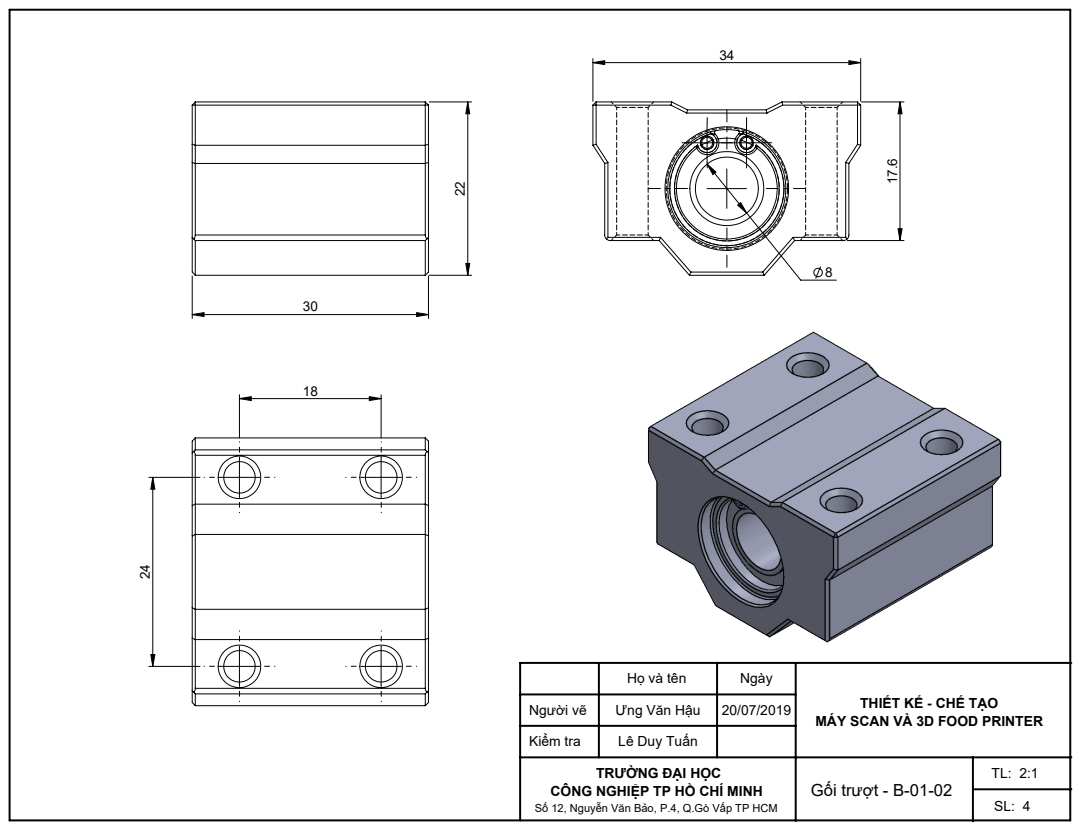
[picture p218: page 13]

Họ và tên | Ngày | THIẾT KẾ - CHẾ TẠO MÁY SCAN VÀ 3D FOOD PRINTER

Người vẽ | Ưng Văn Hậu | 20/07/2019
Kiểm tra | Lê Duy Tuấn
TRƯỜNG ĐẠI HỌC | Gối trượt - B-01-02 | TL: 2:1

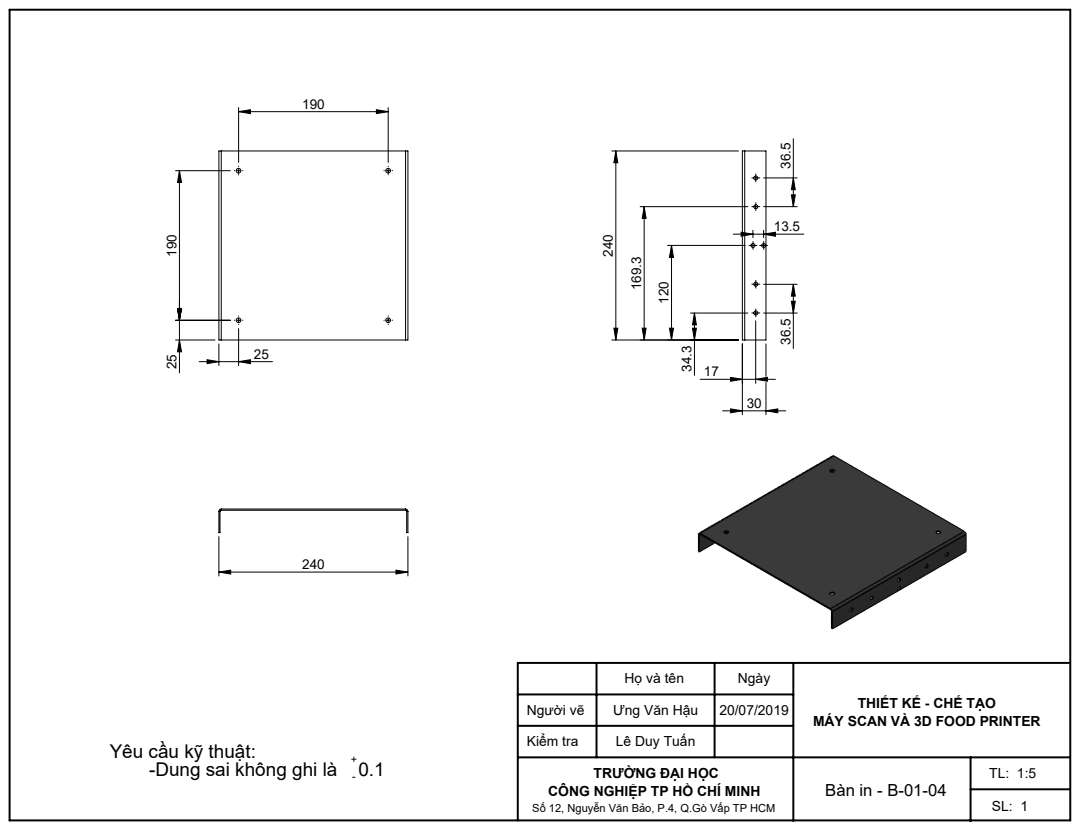
[picture p219: page 14]

Họ và tên | Ngày | THIẾT KẾ - CHẾ TẠO MÁY SCAN VÀ 3D FOOD PRINTER

Người vẽ | Ưng Văn Hậu | 20/07/2019
Kiểm tra | Lê Duy Tuấn
TRƯỜNG ĐẠI HỌC | Bàn in - B-01-04

Yêu cầu kỹ thuật:
-Dung sai không ghi là 0.1 +

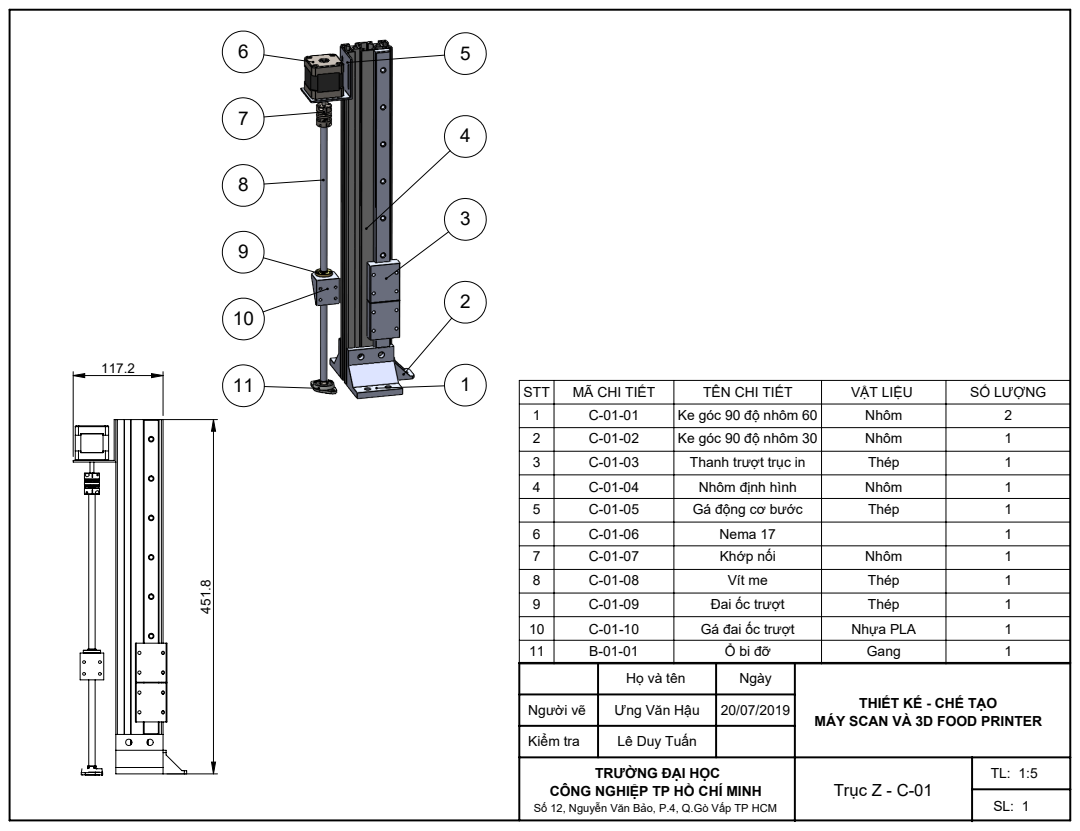
[picture p220: page 15]
STT; MÃ CHI TIẾT; TÊN CHI TIẾT; VẬT LIỆU; SỐ LƯỢNG

1 | C-01-01 | Ke góc 90 độ nhôm 60 | Nhôm | 2
2 | C-01-02 | Ke góc 90 độ nhôm 30 | Nhôm | 1
3 | C-01-03 | Thanh trượt trục in | Thép | 1
4 | C-01-04 | Nhôm định hình | Nhôm | 1
5 | C-01-05 | Gá động cơ bước | Thép | 1
6 | C-01-06 | Nema 17 | | 1
7 | C-01-07 | Khớp nối | Nhôm | 1
8 | C-01-08 | Vít me | Thép | 1
9 | C-01-09 | Đai ốc trượt | Thép | 1
10 | C-01-10 | Gá đai ốc trượt | Nhựa PLA | 1
11 | B-01-01 | Ổ bi đỡ | Gang | 1

Họ và tên | Ngày | THIẾT KẾ - CHẾ TẠO MÁY SCAN VÀ 3D FOOD PRINTER

Người vẽ | Ưng Văn Hậu | 20/07/2019
Kiểm tra | Lê Duy Tuấn
TRƯỜNG ĐẠI HỌC | Trục Z - C-01

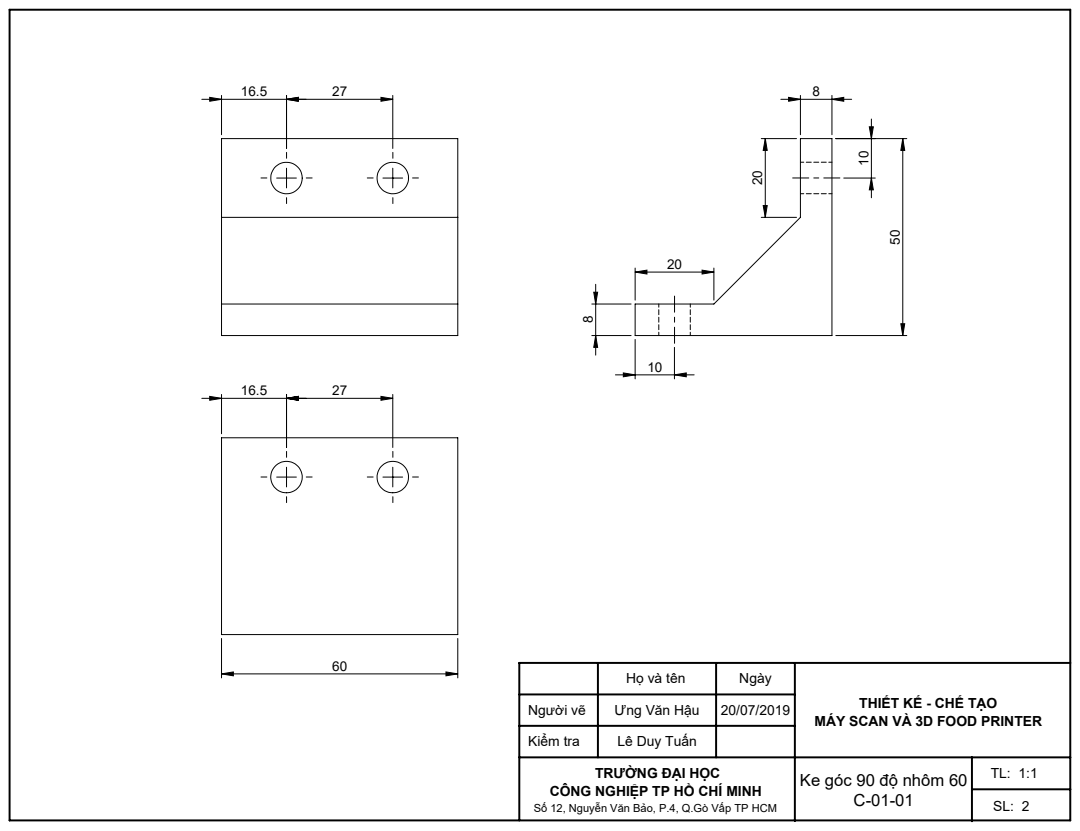
[picture p221: page 16]

Họ và tên | Ngày | THIẾT KẾ - CHẾ TẠO MÁY SCAN VÀ 3D FOOD PRINTER

Người vẽ | Ưng Văn Hậu | 20/07/2019
Kiểm tra | Lê Duy Tuấn
TRƯỜNG ĐẠI HỌC | Ke góc 90 độ nhôm 60 C-01-01

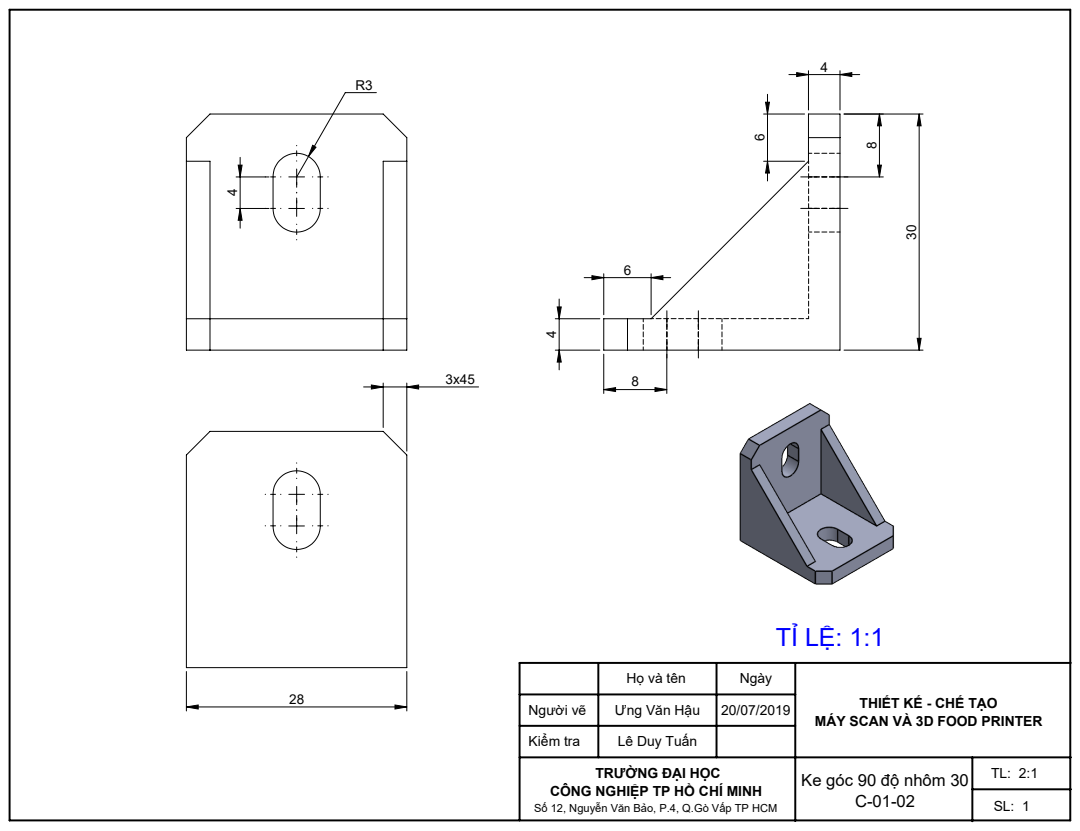
[picture p222: page 17]

Họ và tên | Ngày | THIẾT KẾ - CHẾ TẠO MÁY SCAN VÀ 3D FOOD PRINTER

Người vẽ | Ưng Văn Hậu | 20/07/2019
Kiểm tra | Lê Duy Tuấn
TRƯỜNG ĐẠI HỌC | Ke góc 90 độ nhôm 30 C-01-02 | TL: 2:1

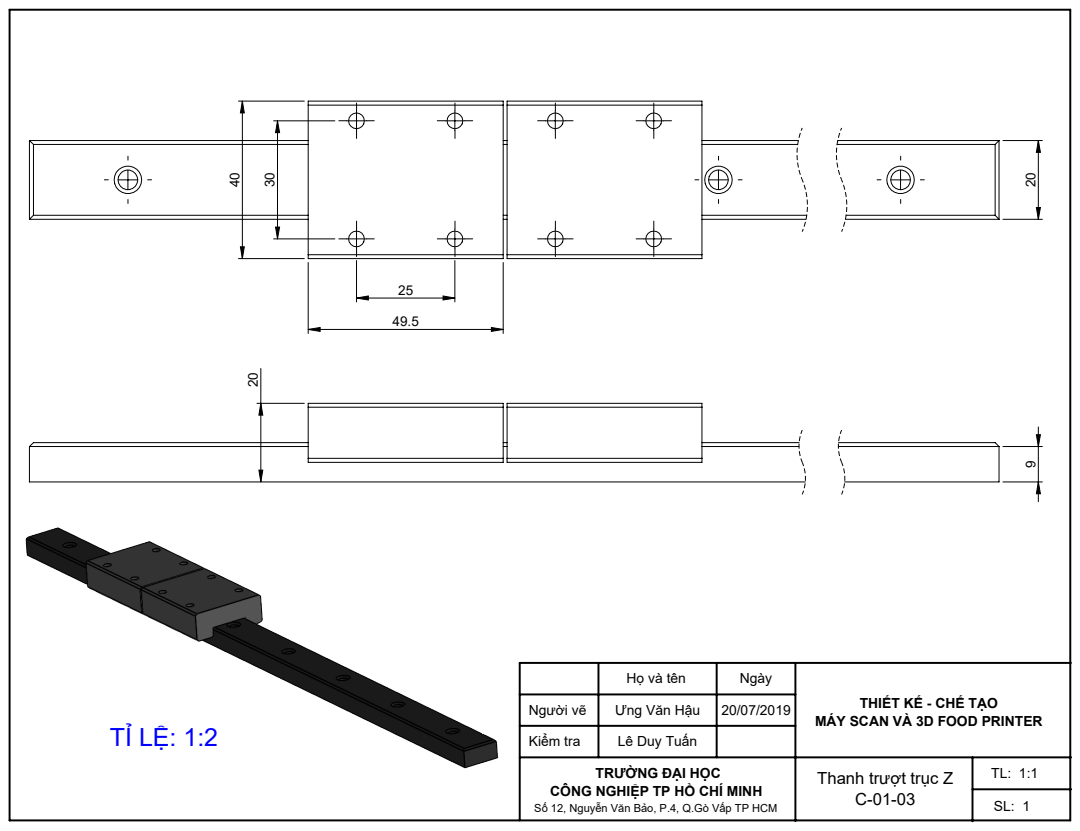
[picture p223: page 18]

Họ và tên | Ngày | THIẾT KẾ - CHẾ TẠO MÁY SCAN VÀ 3D FOOD PRINTER

Người vẽ | Ưng Văn Hậu | 20/07/2019
Kiểm tra | Lê Duy Tuấn
TRƯỜNG ĐẠI HỌC | Thanh trượt trục Z C-01-03

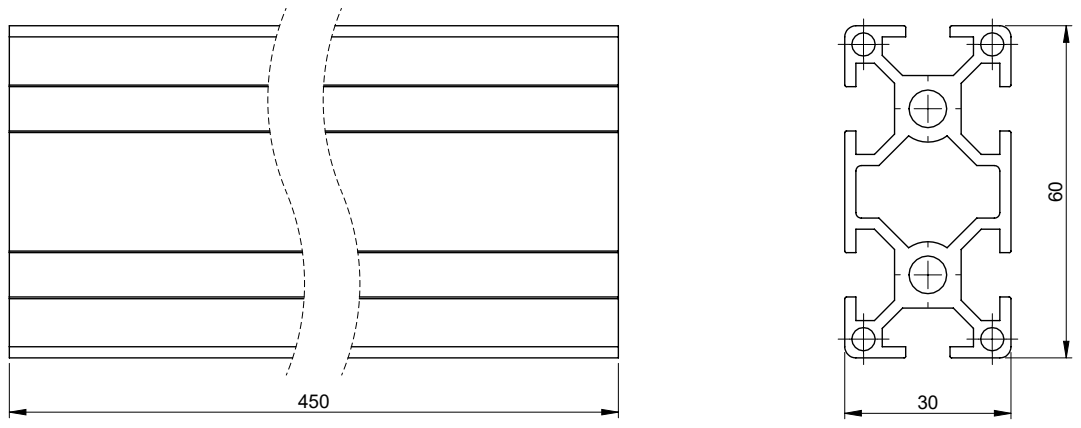
[picture p224: page 19]

Họ và tên | Ngày | THIẾT KẾ - CHẾ TẠO MÁY SCAN VÀ 3D FOOD PRINTER

Người vẽ | Ưng Văn Hậu | 20/07/2019
Kiểm tra | Lê Duy Tuấn
TRƯỜNG ĐẠI HỌC | Nhôm định hình C-01-04

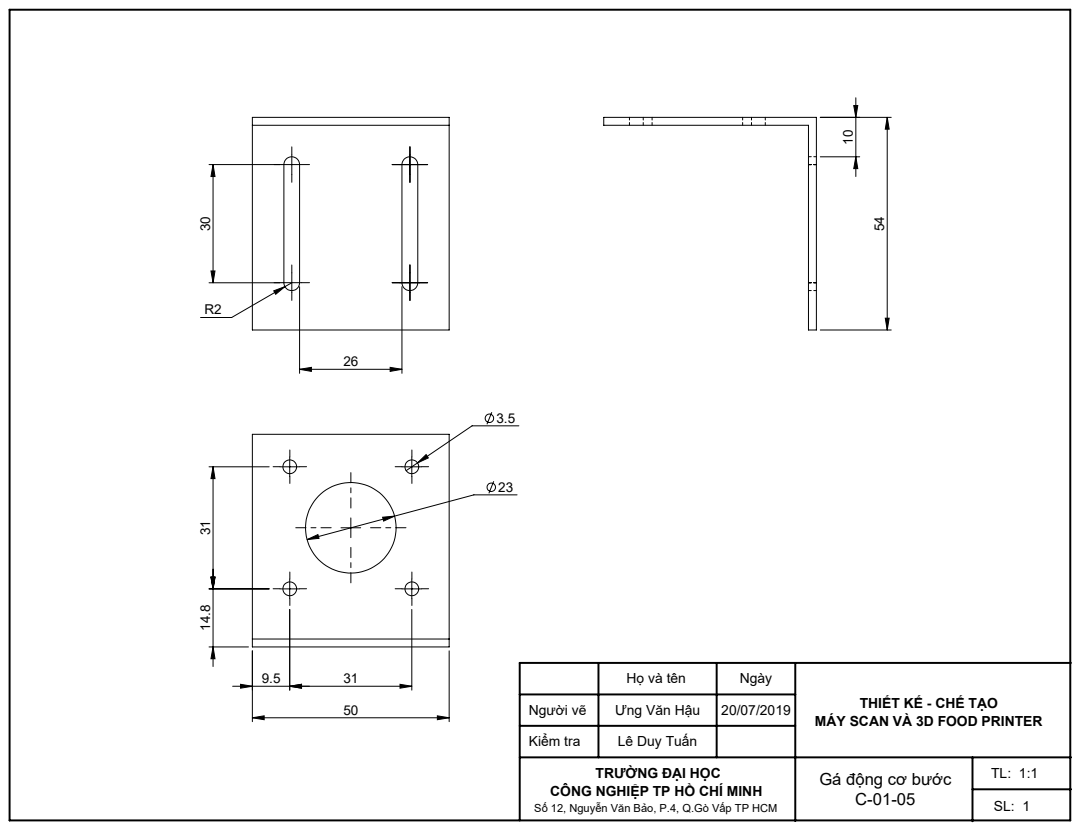
[picture p225: page 20]

Họ và tên | Ngày | THIẾT KẾ - CHẾ TẠO MÁY SCAN VÀ 3D FOOD PRINTER

Người vẽ | Ưng Văn Hậu | 20/07/2019
Kiểm tra | Lê Duy Tuấn
TRƯỜNG ĐẠI HỌC | Gá động cơ bước C-01-05

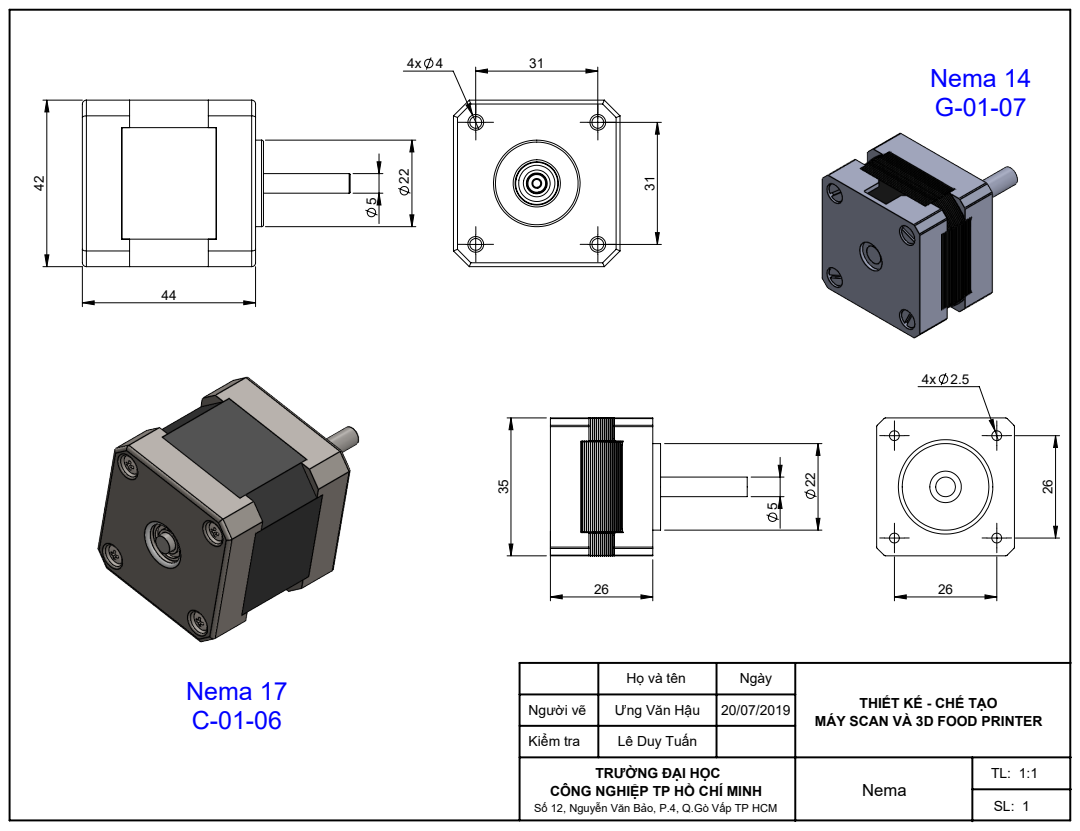
[picture p226: page 21]
Nema 14; Nema 17

Họ và tên | Ngày | THIẾT KẾ - CHẾ TẠO MÁY SCAN VÀ 3D FOOD PRINTER

Người vẽ | Ưng Văn Hậu | 20/07/2019
Kiểm tra | Lê Duy Tuấn
TRƯỜNG ĐẠI HỌC | Nema

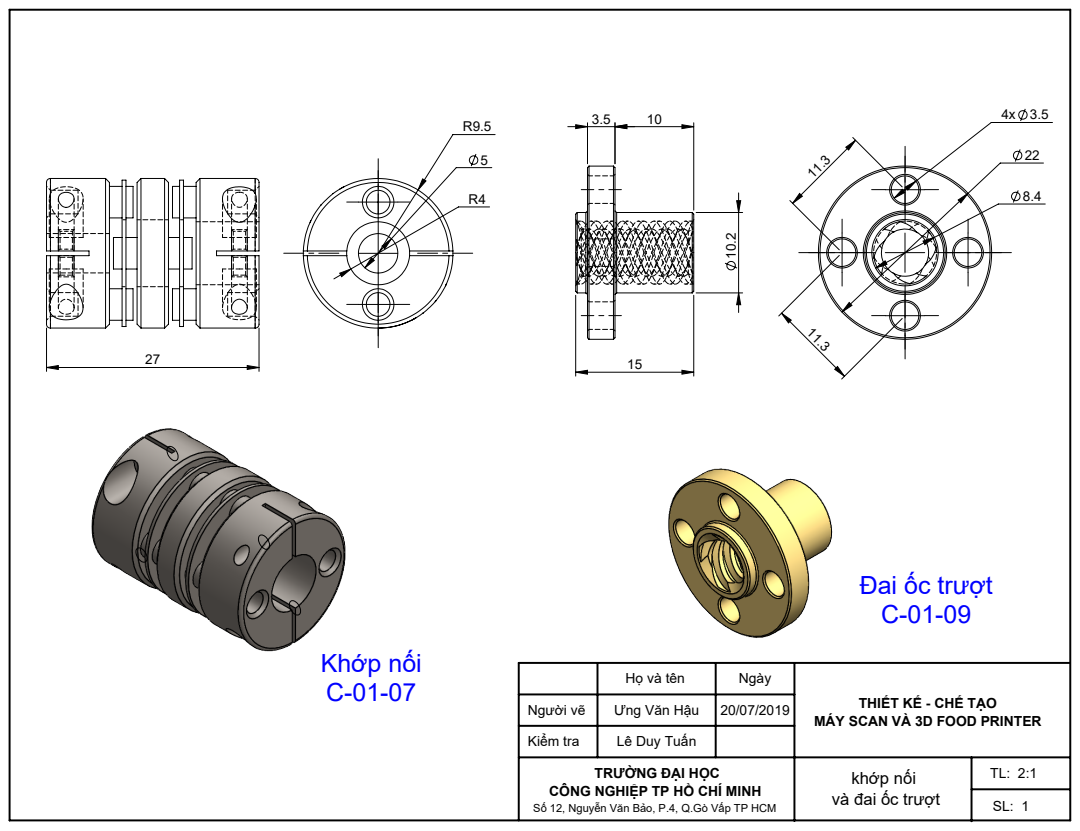
[picture p227: page 22]
Khớp nối

Đai ốc trượt

Họ và tên | Ngày | THIẾT KẾ - CHẾ TẠO MÁY SCAN VÀ 3D FOOD PRINTER

Người vẽ | Ưng Văn Hậu | 20/07/2019
Kiểm tra | Lê Duy Tuấn
TRƯỜNG ĐẠI HỌC | khớp nối và đai ốc trượt | TL: 2:1

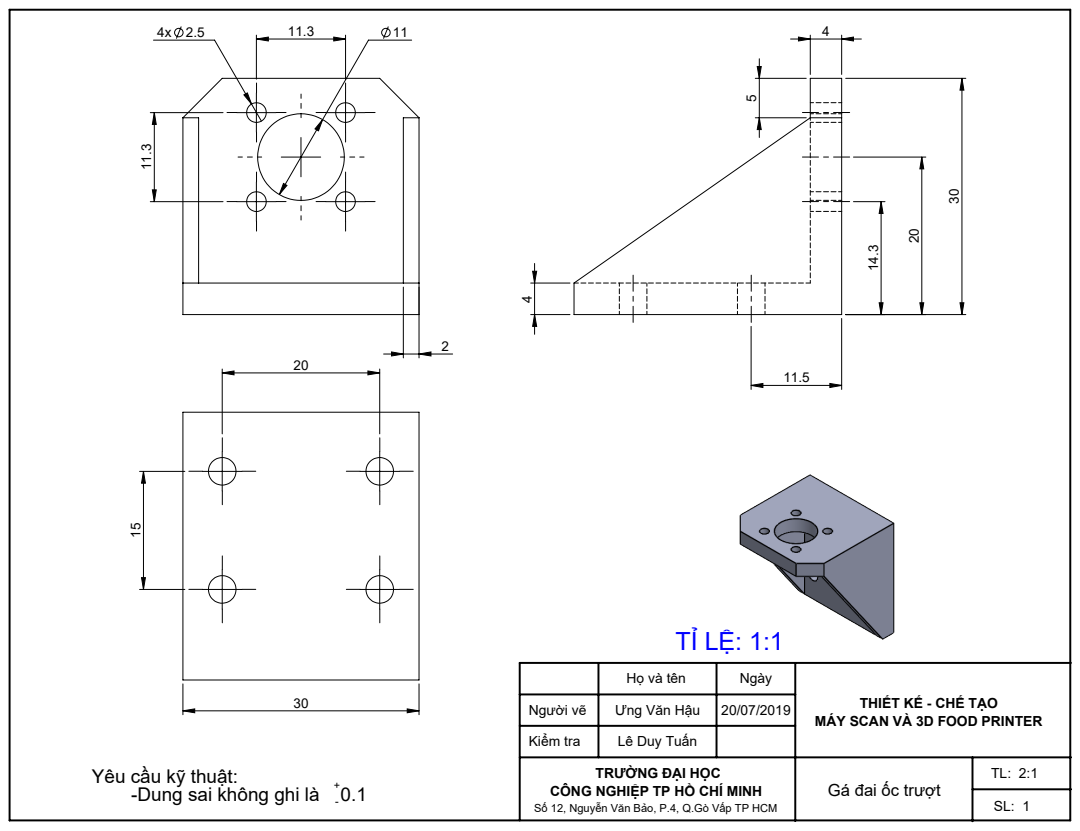
[picture p228: page 23]

Họ và tên | Ngày | THIẾT KẾ - CHẾ TẠO MÁY SCAN VÀ 3D FOOD PRINTER

Người vẽ | Ưng Văn Hậu | 20/07/2019
Kiểm tra | Lê Duy Tuấn

Yêu cầu kỹ thuật:
-Dung sai không ghi là 0.1 +

TRƯỜNG ĐẠI HỌC

- Gá đai ốc trượt

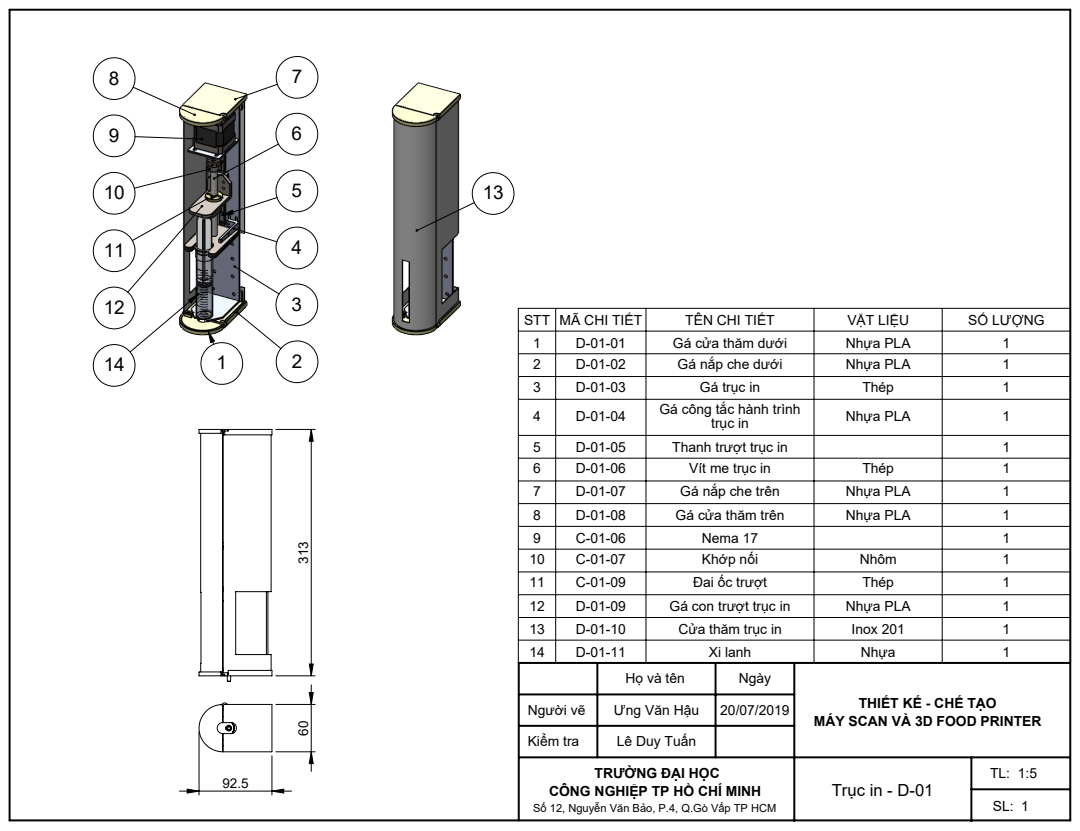
[picture p229: page 24]

STT | MÃ CHI TIẾT | TÊN CHI TIẾT | VẬT LIỆU | SỐ LƯỢNG
1 | D-01-01 | Gá cửa thăm dưới | Nhựa PLA | 1
2 | D-01-02 | Gá nắp che dưới | Nhựa PLA | 1
3 | D-01-03 | Gá trục in | Thép | 1
4 | D-01-04 | Gá công tắc hành trình trục in | Nhựa PLA | 1

5 | D-01-05 | Thanh trượt trục in | | 1
6 | D-01-06 | Vít me trục in | Thép | 1
7 | D-01-07 | Gá nắp che trên | Nhựa PLA | 1
8 | D-01-08 | Gá cửa thăm trên | Nhựa PLA | 1
9 | C-01-06 | Nema 17 | | 1
10 | C-01-07 | Khớp nối | Nhôm | 1
11 | C-01-09 | Đai ốc trượt | Thép | 1
12 | D-01-09 | Gá con trượt trục in | Nhựa PLA | 1
13 | D-01-10 | Cửa thăm trục in | Inox 201 | 1
14 | D-01-11 | Xi lanh | Nhựa | 1

Họ và tên | Ngày | THIẾT KẾ - CHẾ TẠO MÁY SCAN VÀ 3D FOOD PRINTER

Người vẽ | Ưng Văn Hậu | 20/07/2019
Kiểm tra | Lê Duy Tuấn
TRƯỜNG ĐẠI HỌC | Trục in - D-01

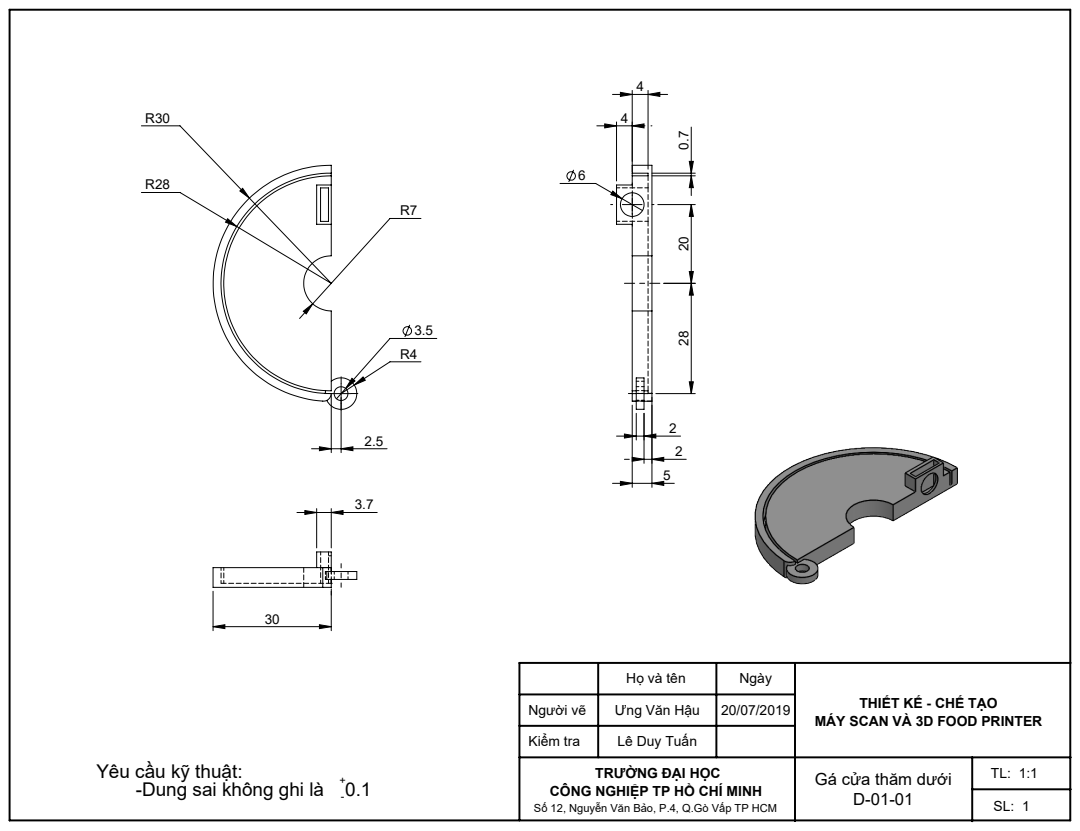
[picture p230: page 25]

Họ và tên | Ngày | THIẾT KẾ - CHẾ TẠO MÁY SCAN VÀ 3D FOOD PRINTER

Người vẽ | Ưng Văn Hậu | 20/07/2019
Kiểm tra | Lê Duy Tuấn
TRƯỜNG ĐẠI HỌC | Gá cửa thăm dưới D-01-01

Yêu cầu kỹ thuật:
-Dung sai không ghi là 0.1 +

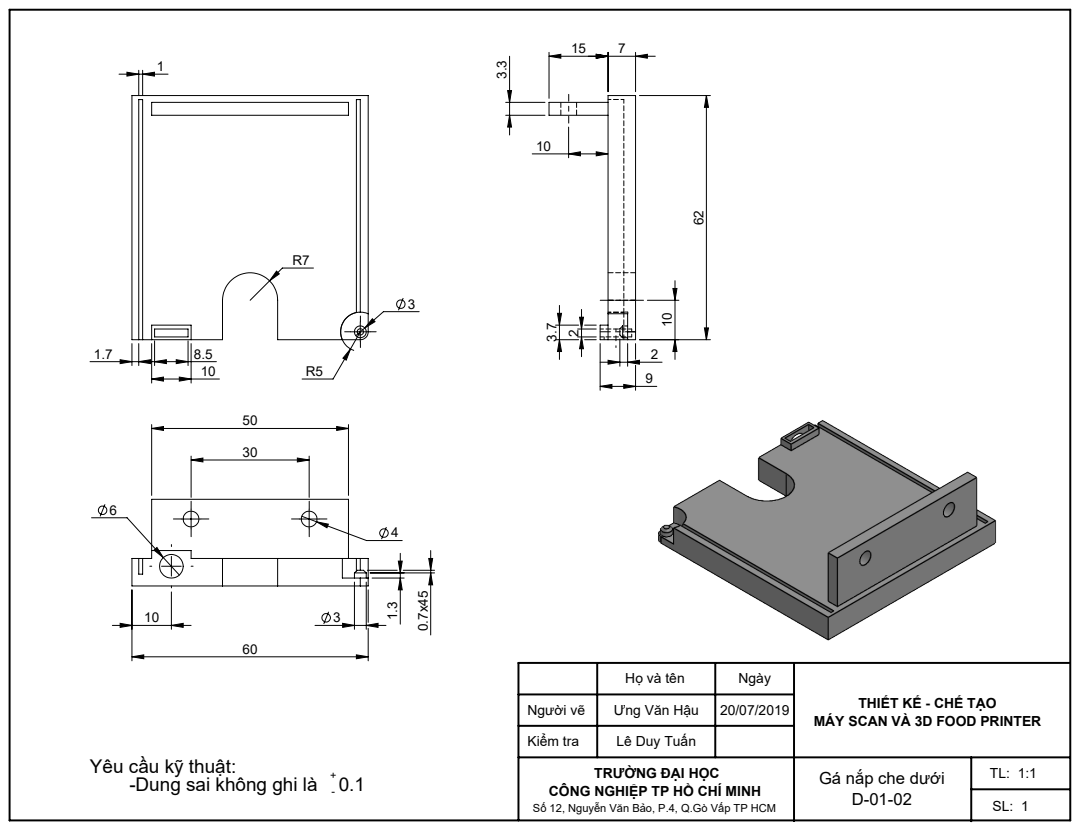
[picture p231: page 26]

Họ và tên | Ngày | THIẾT KẾ - CHẾ TẠO MÁY SCAN VÀ 3D FOOD PRINTER

Người vẽ | Ưng Văn Hậu | 20/07/2019
Kiểm tra | Lê Duy Tuấn
TRƯỜNG ĐẠI HỌC | Gá nắp che dưới D-01-02

Yêu cầu kỹ thuật:
-Dung sai không ghi là 0.1 +

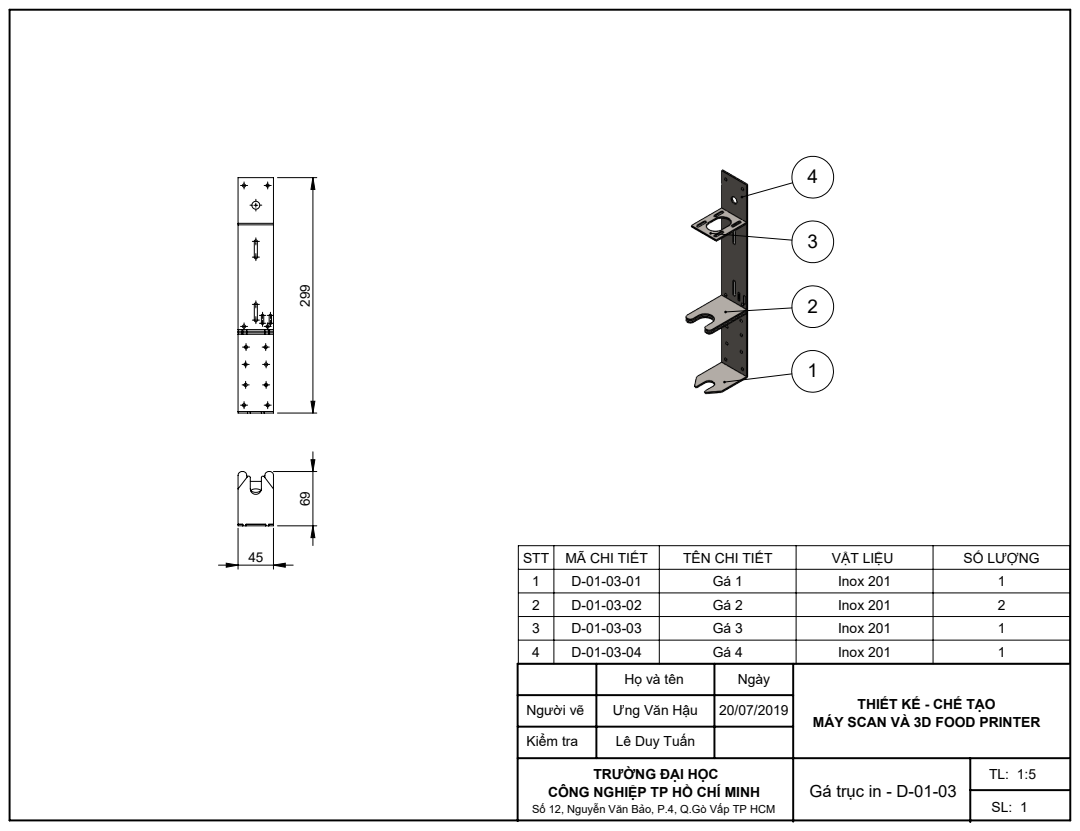
[picture p232: page 27]

STT | MÃ CHI TIẾT | TÊN CHI TIẾT | VẬT LIỆU | SỐ LƯỢNG
1 | D-01-03-01 | Gá 1 | Inox 201 | 1
2 | D-01-03-02 | Gá 2 | Inox 201 | 2
3 | D-01-03-03 | Gá 3 | Inox 201 | 1
4 | D-01-03-04 | Gá 4 | Inox 201 | 1

Họ và tên | Ngày | THIẾT KẾ - CHẾ TẠO MÁY SCAN VÀ 3D FOOD PRINTER

Người vẽ | Ưng Văn Hậu | 20/07/2019
Kiểm tra | Lê Duy Tuấn
TRƯỜNG ĐẠI HỌC | Gá trục in - D-01-03

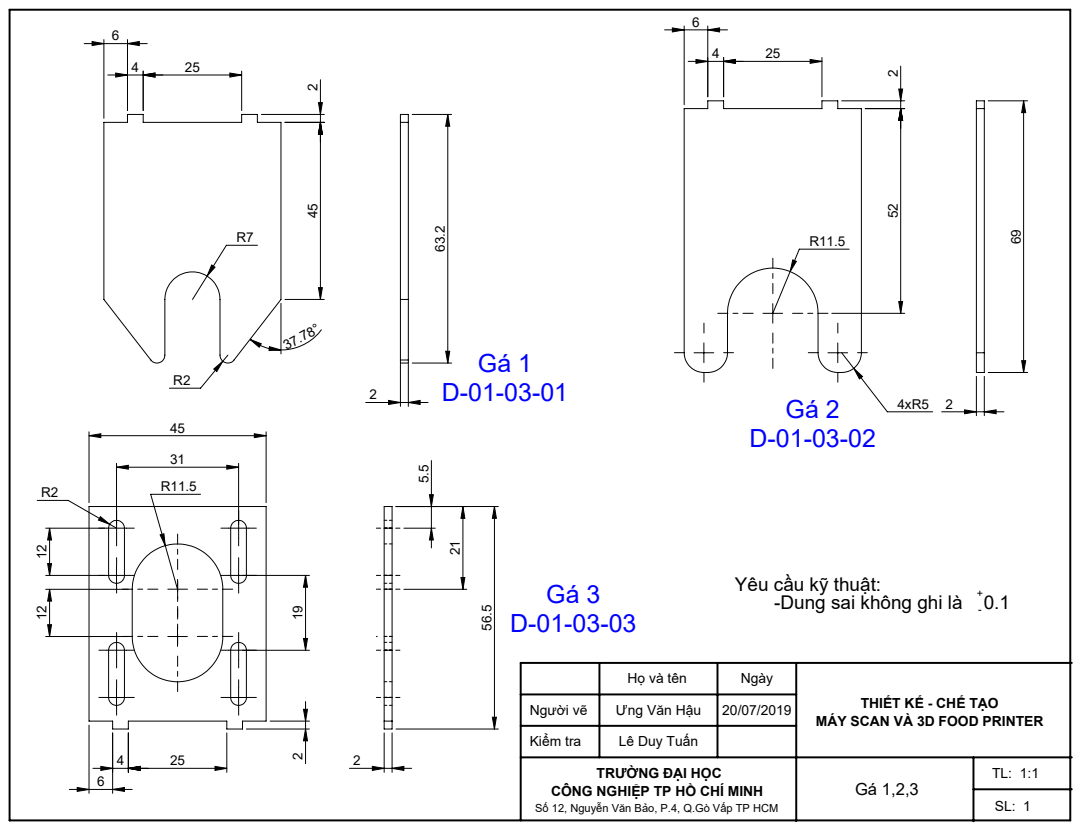
[picture p233: page 28]

Yêu cầu kỹ thuật:
-Dung sai không ghi là 0.1 +

Họ và tên | Ngày | THIẾT KẾ - CHẾ TẠO MÁY SCAN VÀ 3D FOOD PRINTER

Người vẽ | Ưng Văn Hậu | 20/07/2019
Kiểm tra | Lê Duy Tuấn
TRƯỜNG ĐẠI HỌC | Gá 1,2,3

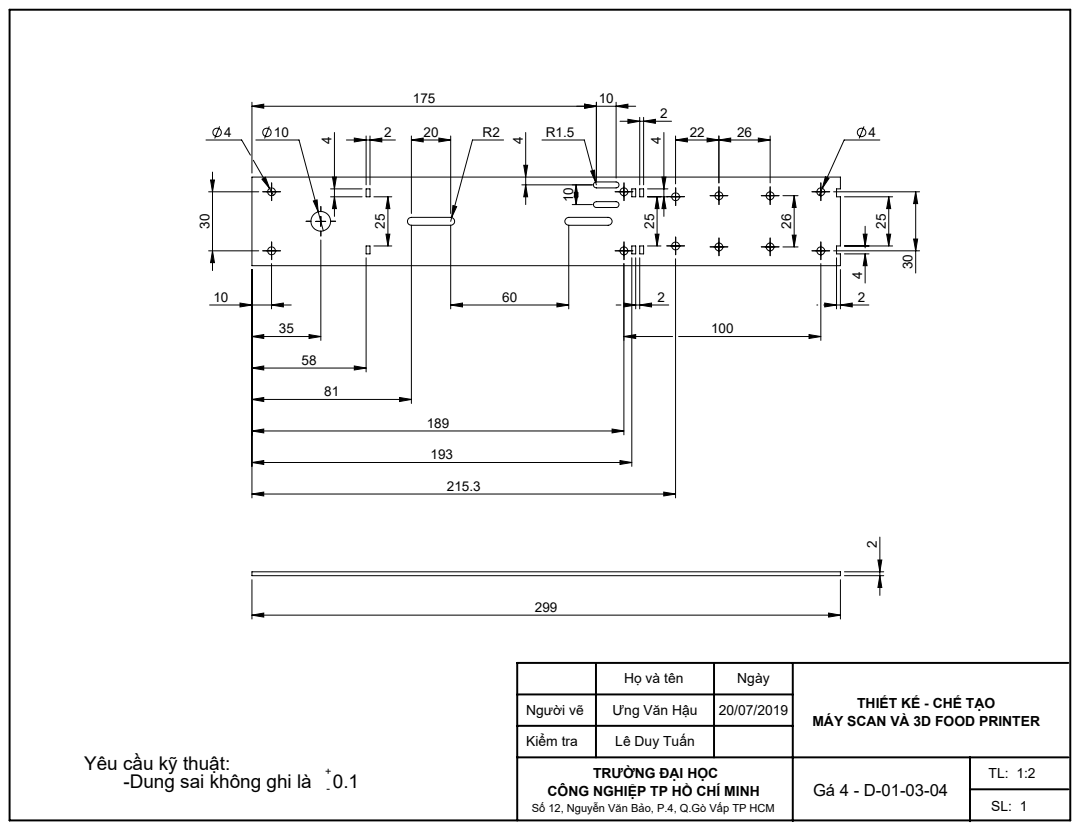
[picture p234: page 29]

Họ và tên | Ngày | THIẾT KẾ - CHẾ TẠO MÁY SCAN VÀ 3D FOOD PRINTER

Người vẽ | Ưng Văn Hậu | 20/07/2019
Kiểm tra | Lê Duy Tuấn

Yêu cầu kỹ thuật:
-Dung sai không ghi là 0.1 +

TRƯỜNG ĐẠI HỌC

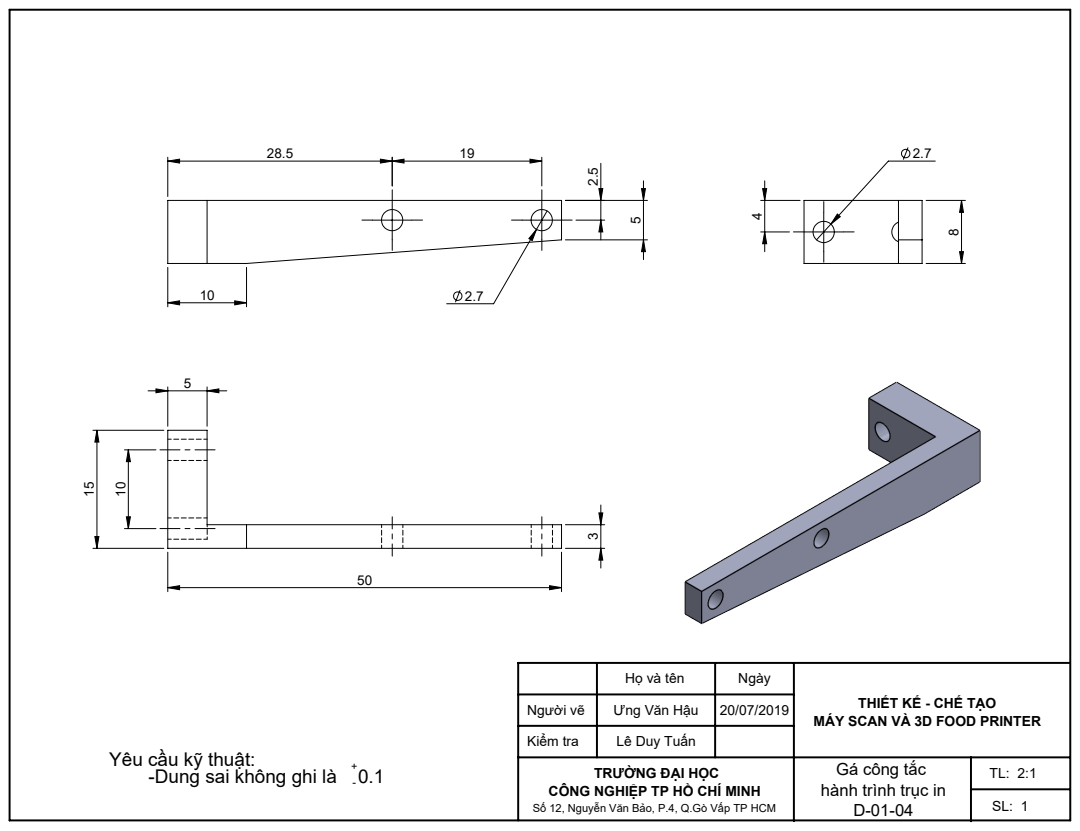
[picture p235: page 30]

Họ và tên | Ngày | THIẾT KẾ - CHẾ TẠO MÁY SCAN VÀ 3D FOOD PRINTER

Người vẽ | Ưng Văn Hậu | 20/07/2019
Kiểm tra | Lê Duy Tuấn
TRƯỜNG ĐẠI HỌC | Gá công tắc hành trình trục in D-01-04 | TL: 2:1

Yêu cầu kỹ thuật:
-Dung sai không ghi là 0.1 +

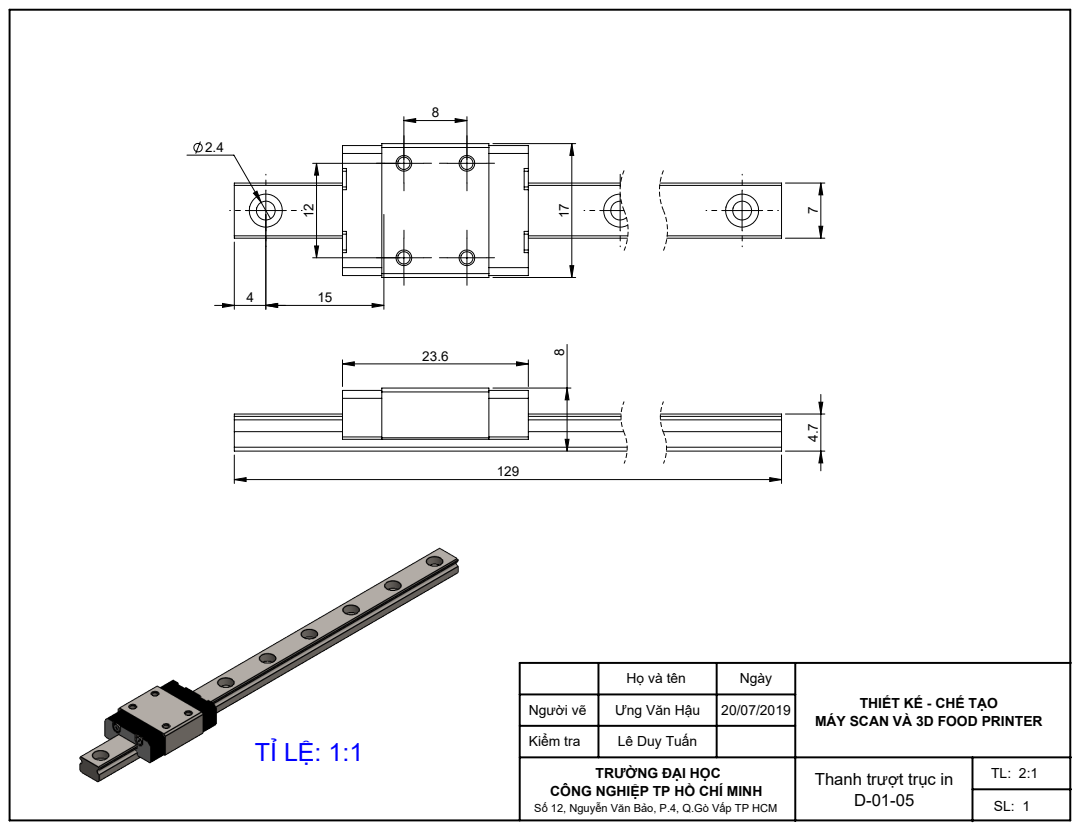
[picture p236: page 31]

Họ và tên | Ngày | THIẾT KẾ - CHẾ TẠO MÁY SCAN VÀ 3D FOOD PRINTER

Người vẽ | Ưng Văn Hậu | 20/07/2019
Kiểm tra | Lê Duy Tuấn
TRƯỜNG ĐẠI HỌC | Thanh trượt trục in D-01-05 | TL: 2:1

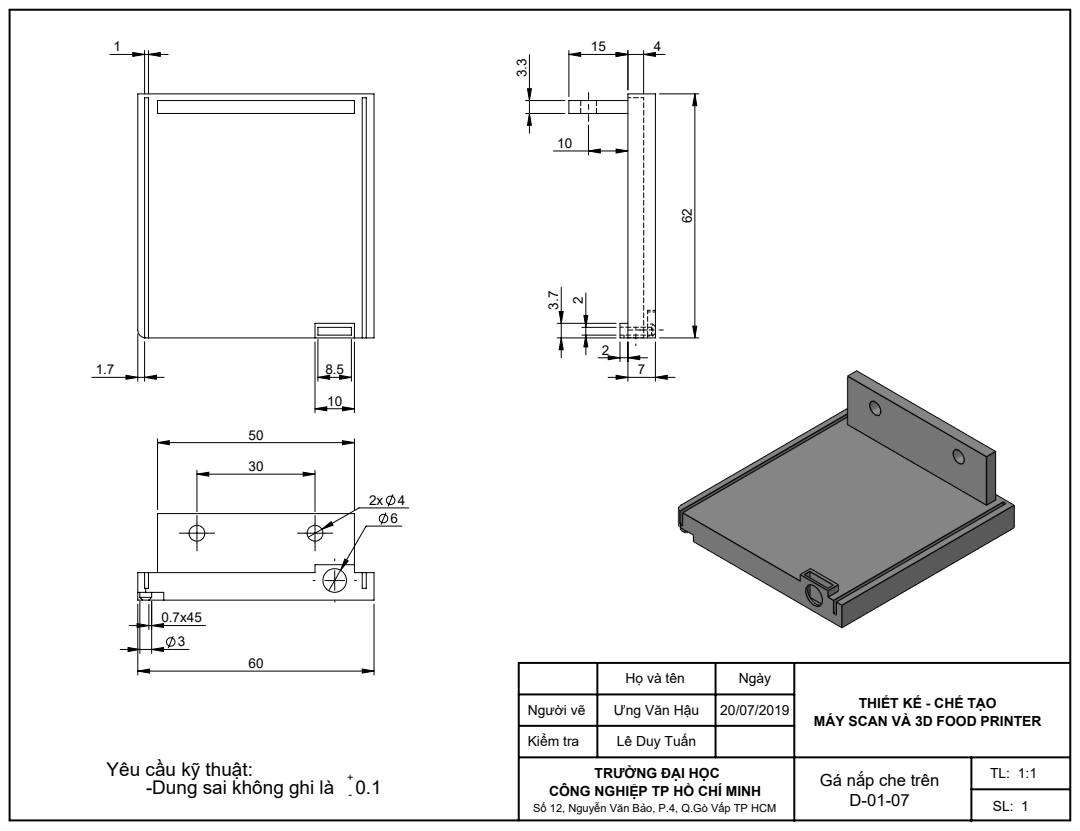
[picture p237: page 32]

Họ và tên | Ngày | THIẾT KẾ - CHẾ TẠO MÁY SCAN VÀ 3D FOOD PRINTER

Người vẽ | Ưng Văn Hậu | 20/07/2019
Kiểm tra | Lê Duy Tuấn
TRƯỜNG ĐẠI HỌC | Gá nắp che trên D-01-07

Yêu cầu kỹ thuật:
-Dung sai không ghi là 0.1 +

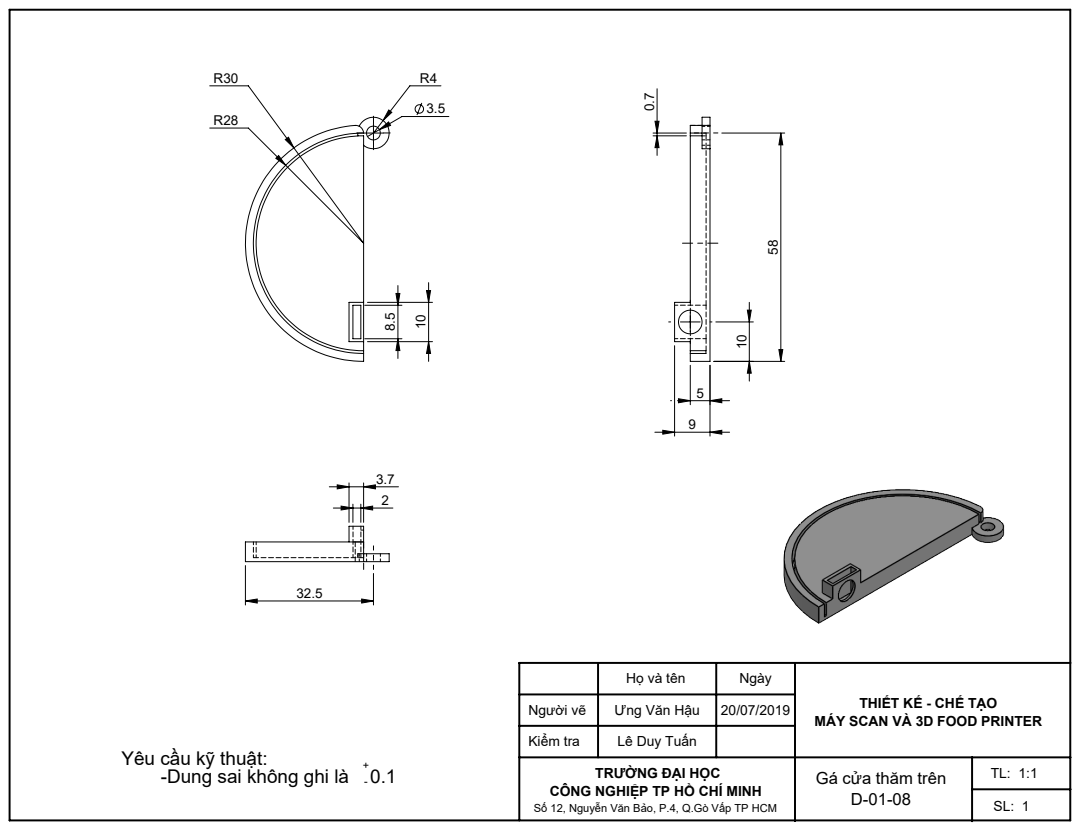
[picture p238: page 33]

Họ và tên | Ngày | THIẾT KẾ - CHẾ TẠO MÁY SCAN VÀ 3D FOOD PRINTER

Người vẽ | Ưng Văn Hậu | 20/07/2019
Kiểm tra | Lê Duy Tuấn

Yêu cầu kỹ thuật:
-Dung sai không ghi là 0.1 +

- Gá cửa thăm trên

TRƯỜNG ĐẠI HỌC

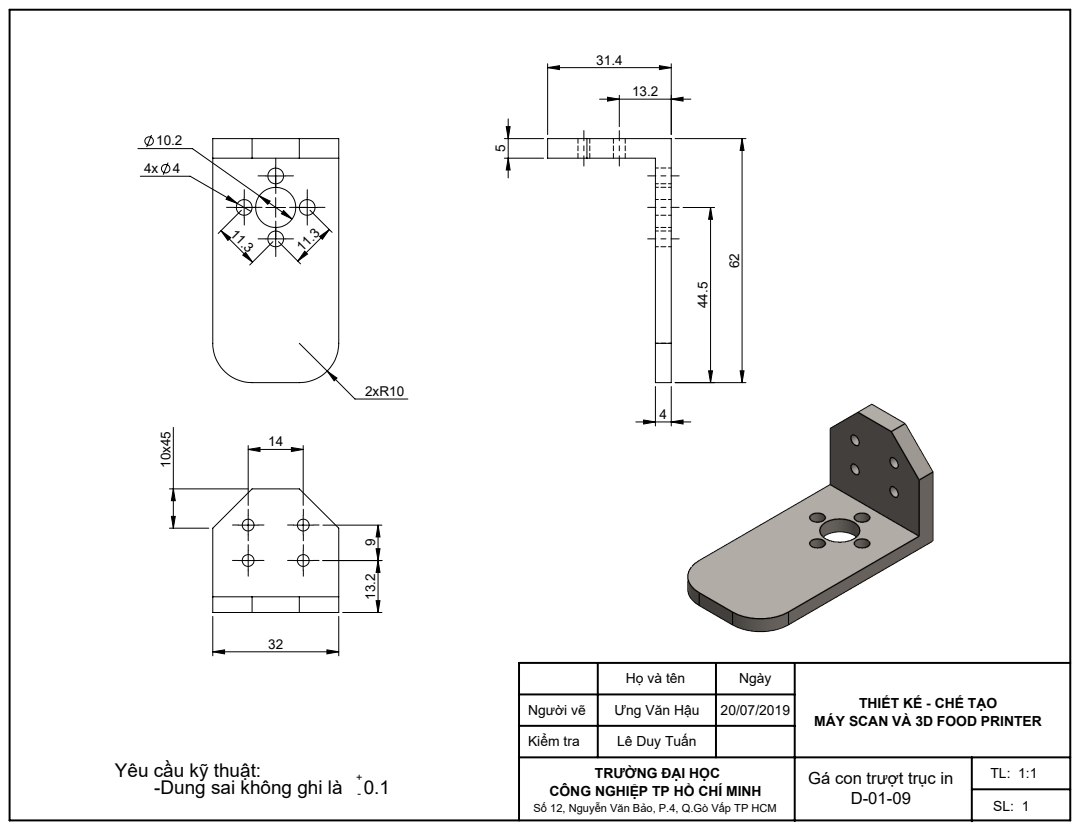
[picture p239: page 34]

Họ và tên | Ngày | THIẾT KẾ - CHẾ TẠO MÁY SCAN VÀ 3D FOOD PRINTER

Người vẽ | Ưng Văn Hậu | 20/07/2019
Kiểm tra | Lê Duy Tuấn
TRƯỜNG ĐẠI HỌC | Gá con trượt trục in D-01-09

Yêu cầu kỹ thuật:
-Dung sai không ghi là 0.1 +

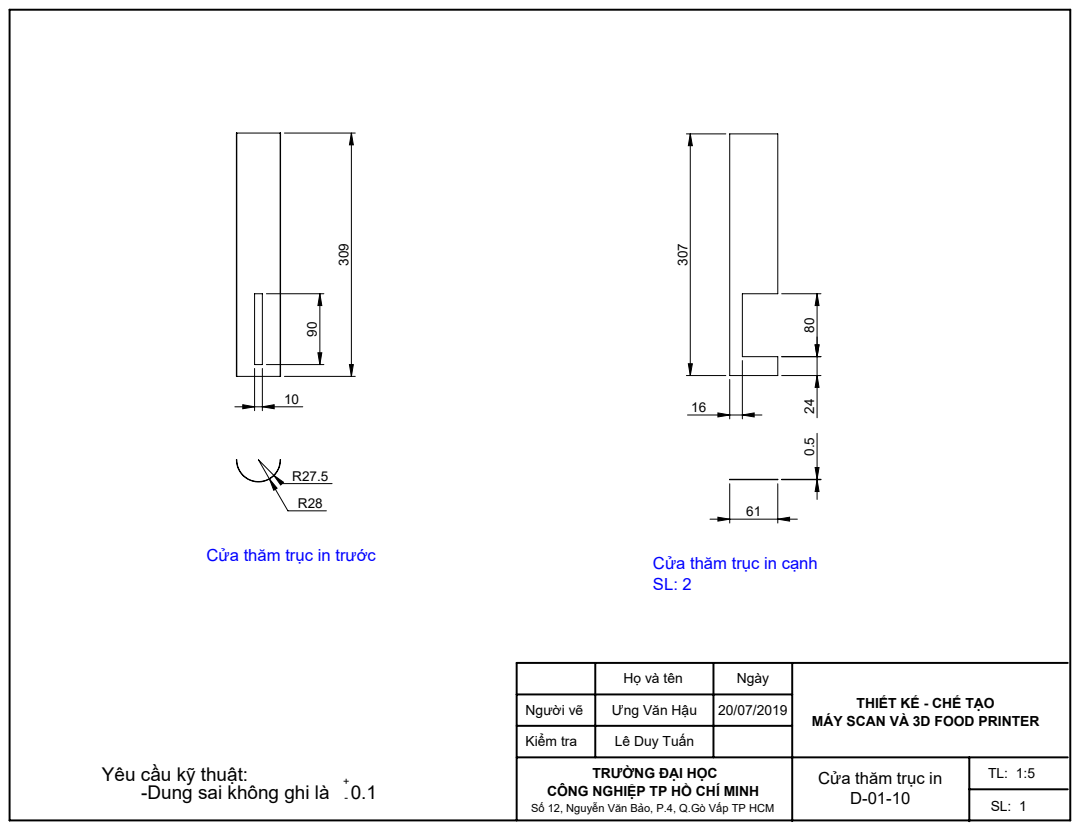
[picture p240: page 35]
Cửa thăm trục in trước; Cửa thăm trục in cạnh

Họ và tên | Ngày | THIẾT KẾ - CHẾ TẠO MÁY SCAN VÀ 3D FOOD PRINTER

Người vẽ | Ưng Văn Hậu | 20/07/2019
Kiểm tra | Lê Duy Tuấn
TRƯỜNG ĐẠI HỌC | Cửa thăm trục in D-01-10

Yêu cầu kỹ thuật:
-Dung sai không ghi là 0.1 +

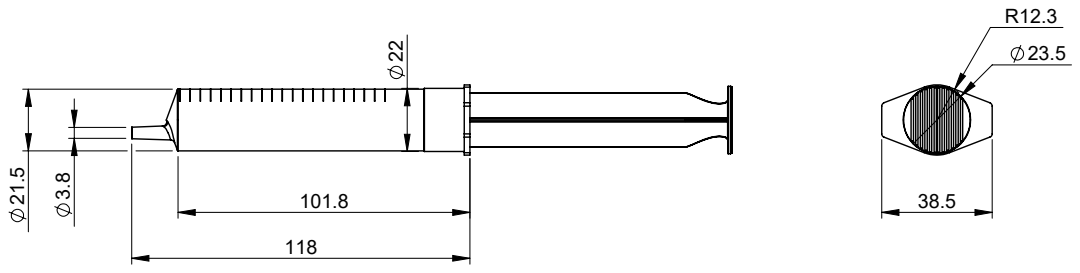
[picture p241: page 36]

Họ và tên | Ngày | THIẾT KẾ - CHẾ TẠO MÁY SCAN VÀ 3D FOOD PRINTER

Người vẽ | Ưng Văn Hậu | 20/07/2019
Kiểm tra | Lê Duy Tuấn
TRƯỜNG ĐẠI HỌC | Xi lanh - D-01-11

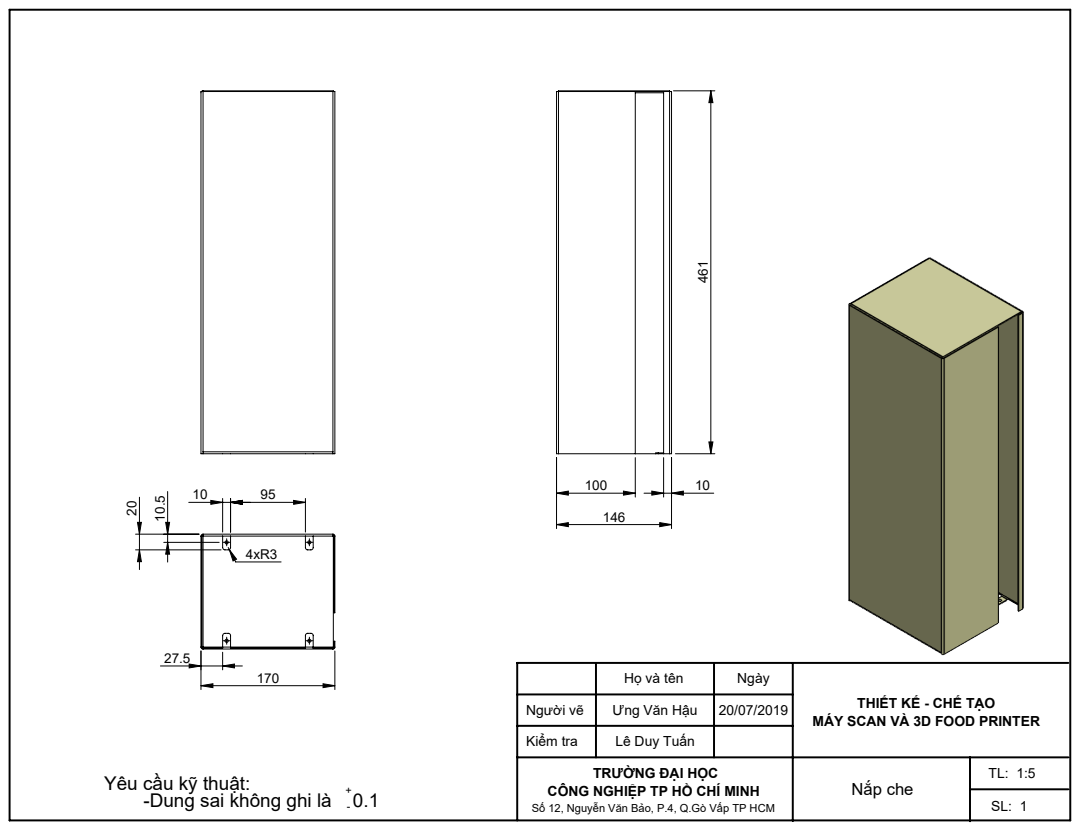
[picture p242: page 37]

Họ và tên | Ngày | THIẾT KẾ - CHẾ TẠO MÁY SCAN VÀ 3D FOOD PRINTER

Người vẽ | Ưng Văn Hậu | 20/07/2019
Kiểm tra | Lê Duy Tuấn
TRƯỜNG ĐẠI HỌC | Nắp che

Yêu cầu kỹ thuật:
-Dung sai không ghi là 0.1 +

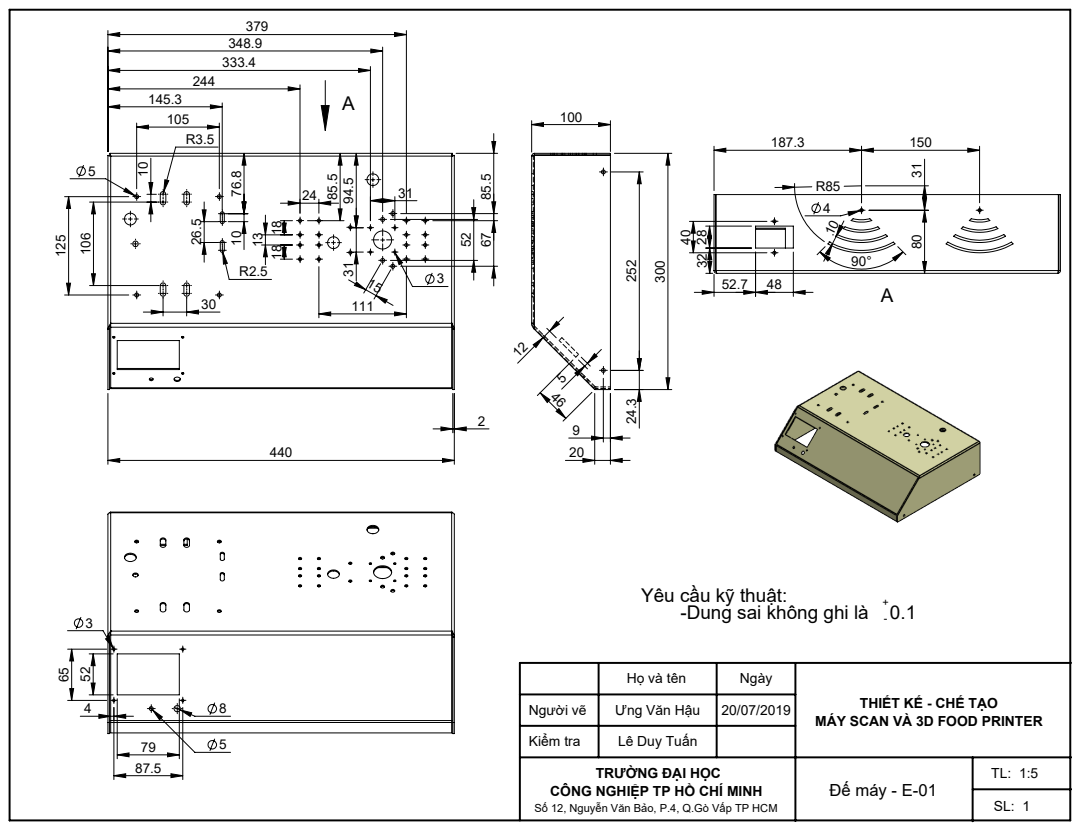
[picture p243: page 38]
Đế máy - E-01

Yêu cầu kỹ thuật:
-Dung sai không ghi là 0.1 +

Họ và tên | Ngày | THIẾT KẾ - CHẾ TẠO MÁY SCAN VÀ 3D FOOD PRINTER

Người vẽ | Ưng Văn Hậu | 20/07/2019
Kiểm tra | Lê Duy Tuấn

TRƯỜNG ĐẠI HỌC

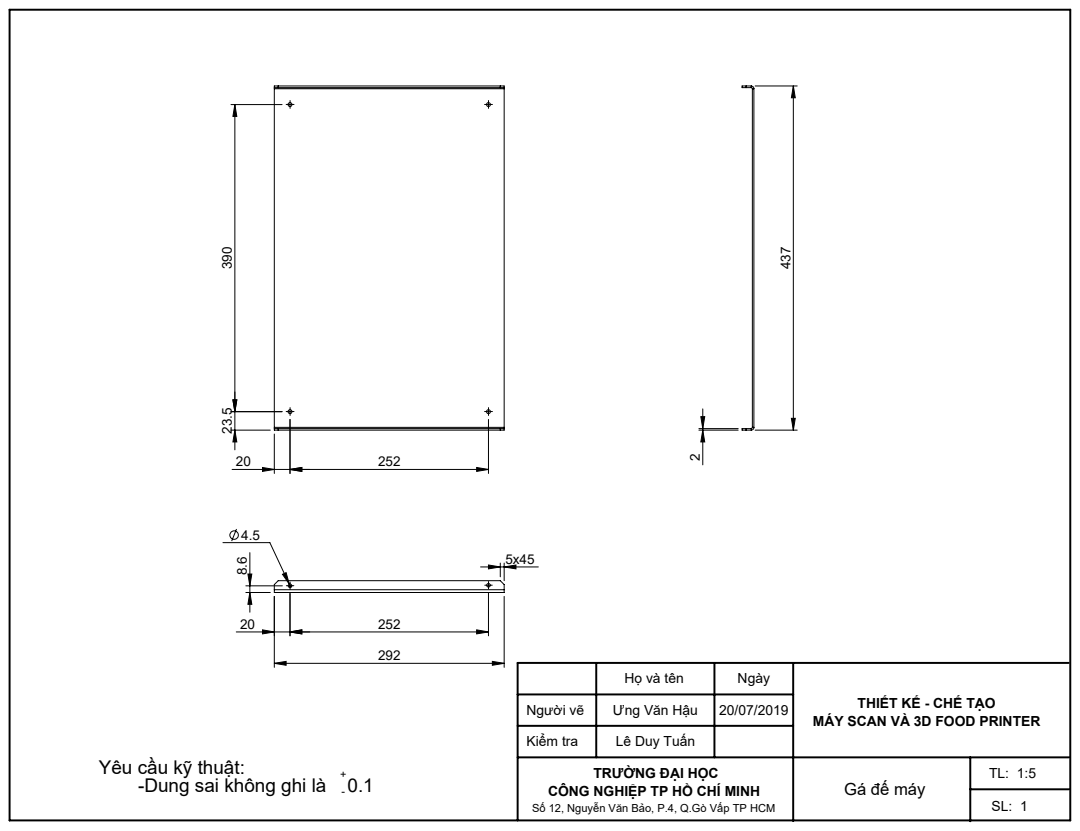
[picture p244: page 39]

Họ và tên | Ngày | THIẾT KẾ - CHẾ TẠO MÁY SCAN VÀ 3D FOOD PRINTER

Người vẽ | Ưng Văn Hậu | 20/07/2019
Kiểm tra | Lê Duy Tuấn

Yêu cầu kỹ thuật:
-Dung sai không ghi là 0.1 +

TRƯỜNG ĐẠI HỌC

- Gá đế máy

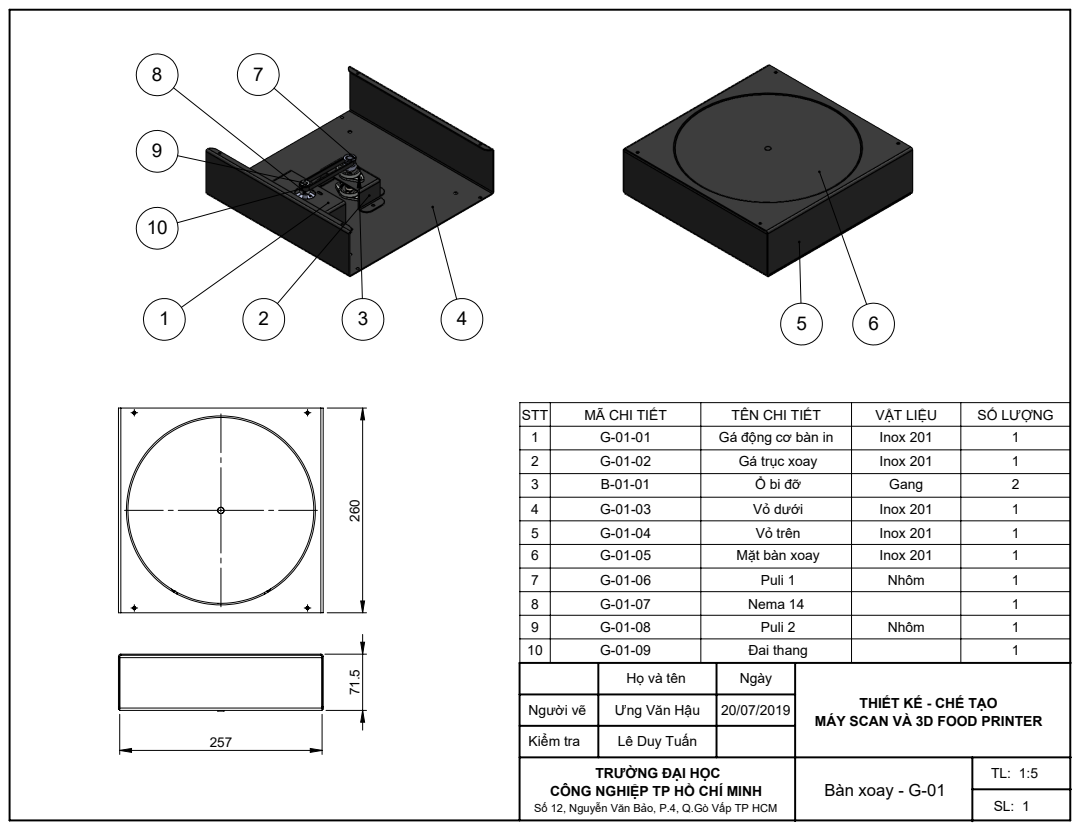
[picture p245: page 40]

STT | MÃ CHI TIẾT | TÊN CHI TIẾT | VẬT LIỆU | SỐ LƯỢNG
1 | G-01-01 | Gá động cơ bàn in | Inox 201 | 1
2 | G-01-02 | Gá trục xoay | Inox 201 | 1
3 | B-01-01 | Ổ bi đỡ | Gang | 2
4 | G-01-03 | Vỏ dưới | Inox 201 | 1
5 | G-01-04 | Vỏ trên | Inox 201 | 1
6 | G-01-05 | Mặt bàn xoay | Inox 201 | 1
7 | G-01-06 | Puli 1 | Nhôm | 1
8 | G-01-07 | Nema 14 | | 1
9 | G-01-08 | Puli 2 | Nhôm | 1
10 | G-01-09 | Đai thang | | 1

Họ và tên | Ngày | THIẾT KẾ - CHẾ TẠO MÁY SCAN VÀ 3D FOOD PRINTER

Người vẽ | Ưng Văn Hậu | 20/07/2019
Kiểm tra | Lê Duy Tuấn
TRƯỜNG ĐẠI HỌC | Bàn xoay - G-01

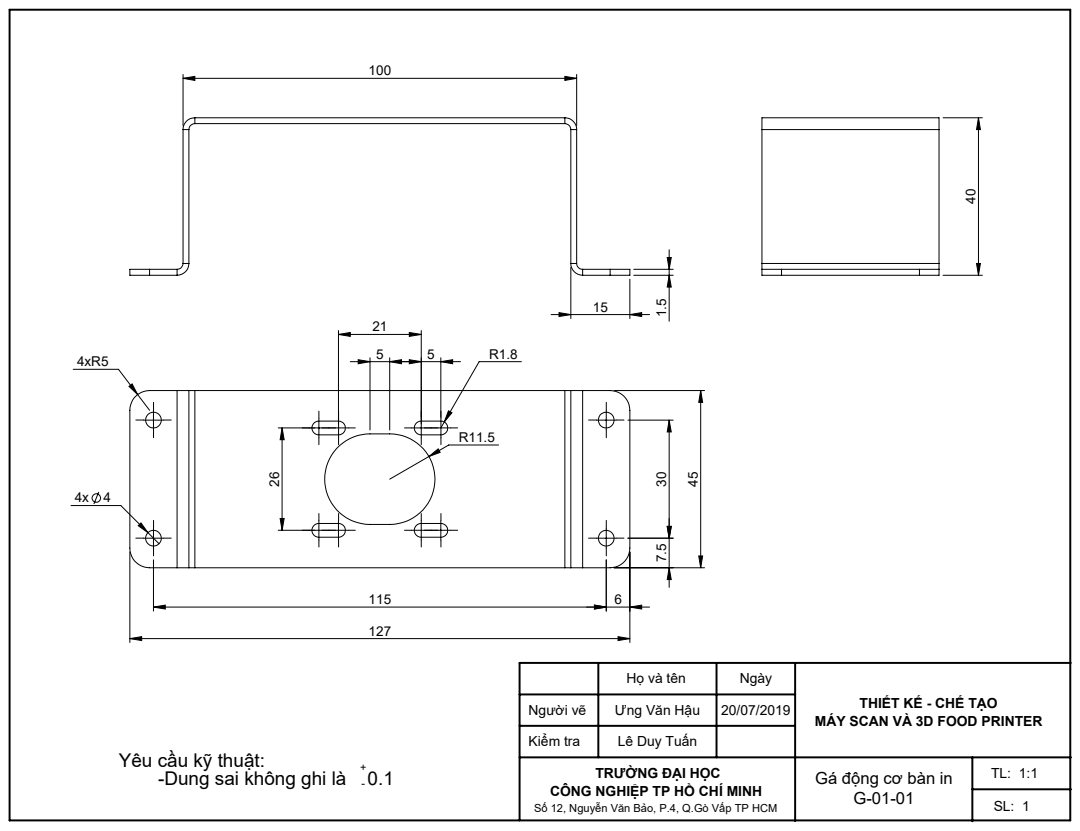
[picture p246: page 41]

Họ và tên | Ngày | THIẾT KẾ - CHẾ TẠO MÁY SCAN VÀ 3D FOOD PRINTER

Người vẽ | Ưng Văn Hậu | 20/07/2019
Kiểm tra | Lê Duy Tuấn

Yêu cầu kỹ thuật:
-Dung sai không ghi là 0.1 +

- Gá động cơ bàn in

TRƯỜNG ĐẠI HỌC

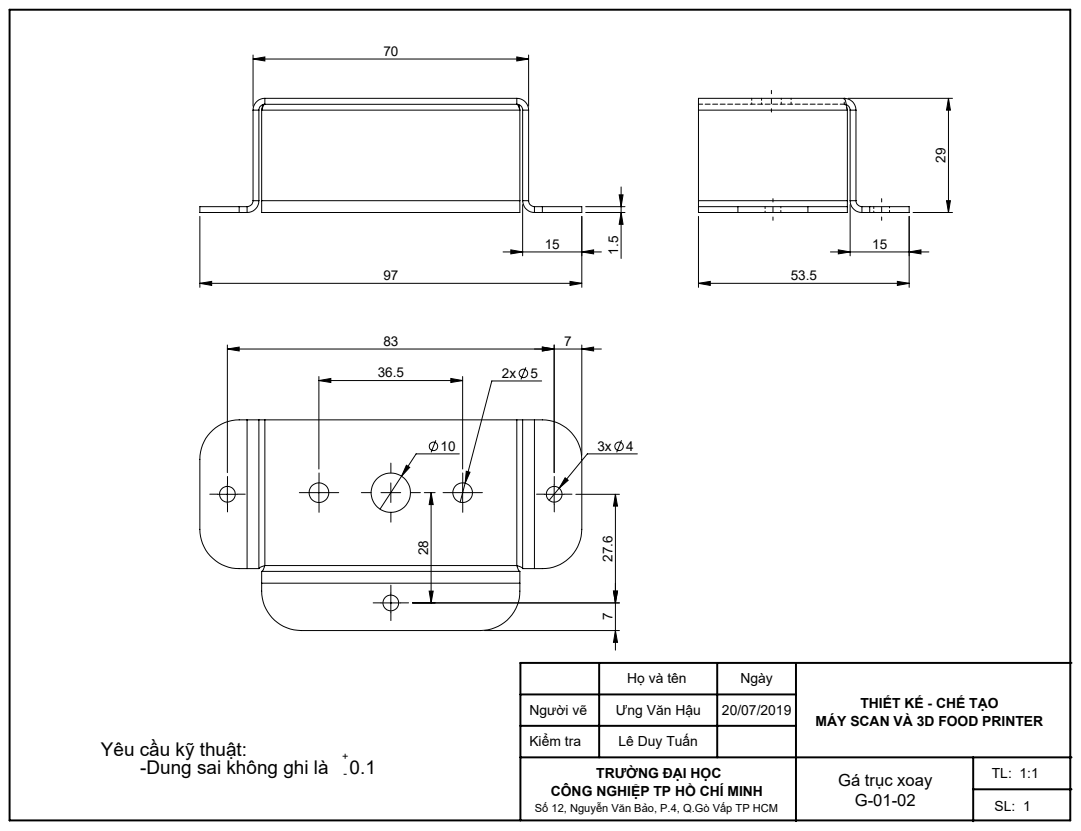
[picture p247: page 42]

Họ và tên | Ngày | THIẾT KẾ - CHẾ TẠO MÁY SCAN VÀ 3D FOOD PRINTER

Người vẽ | Ưng Văn Hậu | 20/07/2019
Kiểm tra | Lê Duy Tuấn

Yêu cầu kỹ thuật:
-Dung sai không ghi là 0.1 +

- Gá trục xoay

TRƯỜNG ĐẠI HỌC

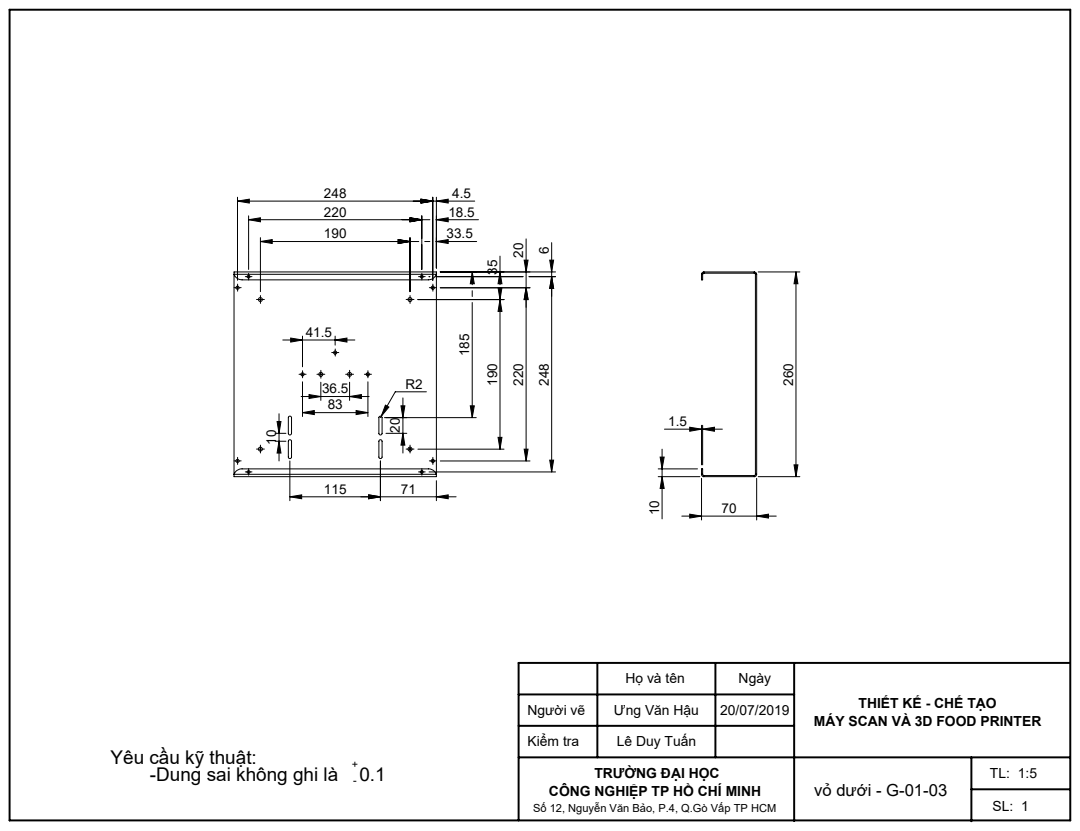
[picture p248: page 43]

Họ và tên | Ngày | THIẾT KẾ - CHẾ TẠO MÁY SCAN VÀ 3D FOOD PRINTER

Người vẽ | Ưng Văn Hậu | 20/07/2019
Kiểm tra | Lê Duy Tuấn
TRƯỜNG ĐẠI HỌC | vỏ dưới - G-01-03

Yêu cầu kỹ thuật:
-Dung sai không ghi là 0.1 +

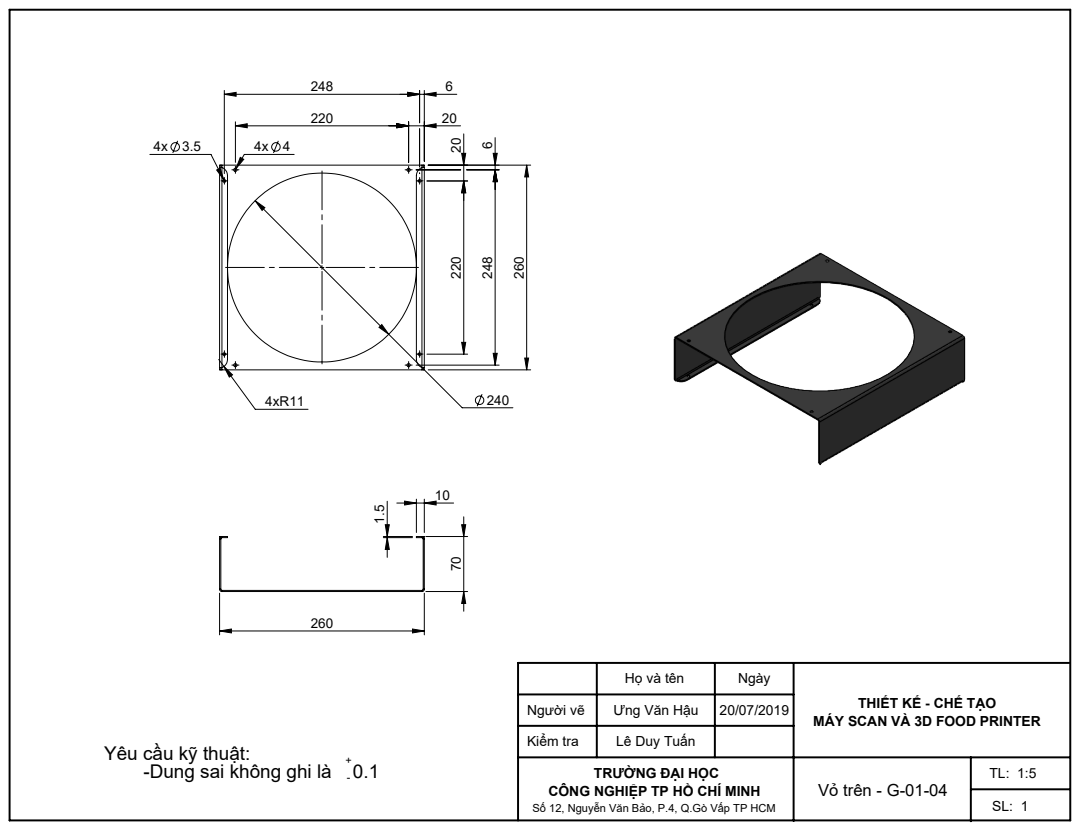
[picture p249: page 44]

Họ và tên | Ngày | THIẾT KẾ - CHẾ TẠO MÁY SCAN VÀ 3D FOOD PRINTER

Người vẽ | Ưng Văn Hậu | 20/07/2019
Kiểm tra | Lê Duy Tuấn
TRƯỜNG ĐẠI HỌC | Vỏ trên - G-01-04

Yêu cầu kỹ thuật:
-Dung sai không ghi là 0.1 +

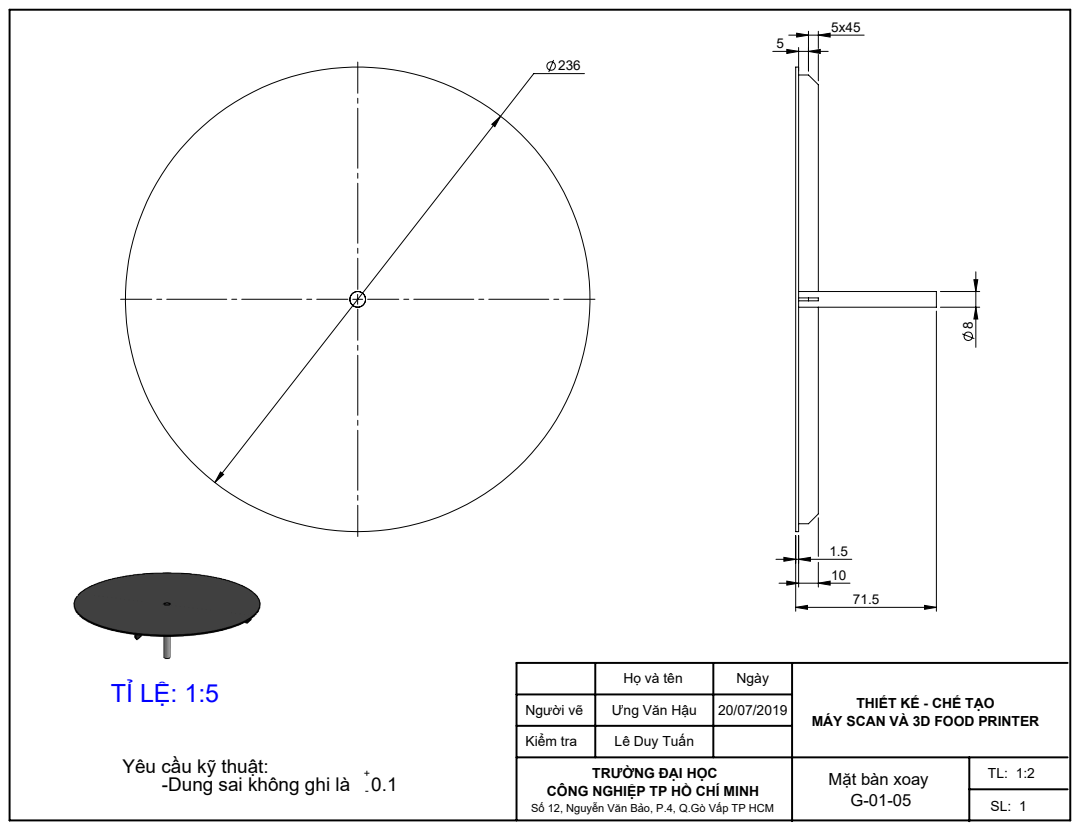
[picture p250: page 45]

Họ và tên | Ngày | THIẾT KẾ - CHẾ TẠO MÁY SCAN VÀ 3D FOOD PRINTER

Người vẽ | Ưng Văn Hậu | 20/07/2019
Kiểm tra | Lê Duy Tuấn

Yêu cầu kỹ thuật:
-Dung sai không ghi là 0.1 +

- Mặt bàn xoay

TRƯỜNG ĐẠI HỌC

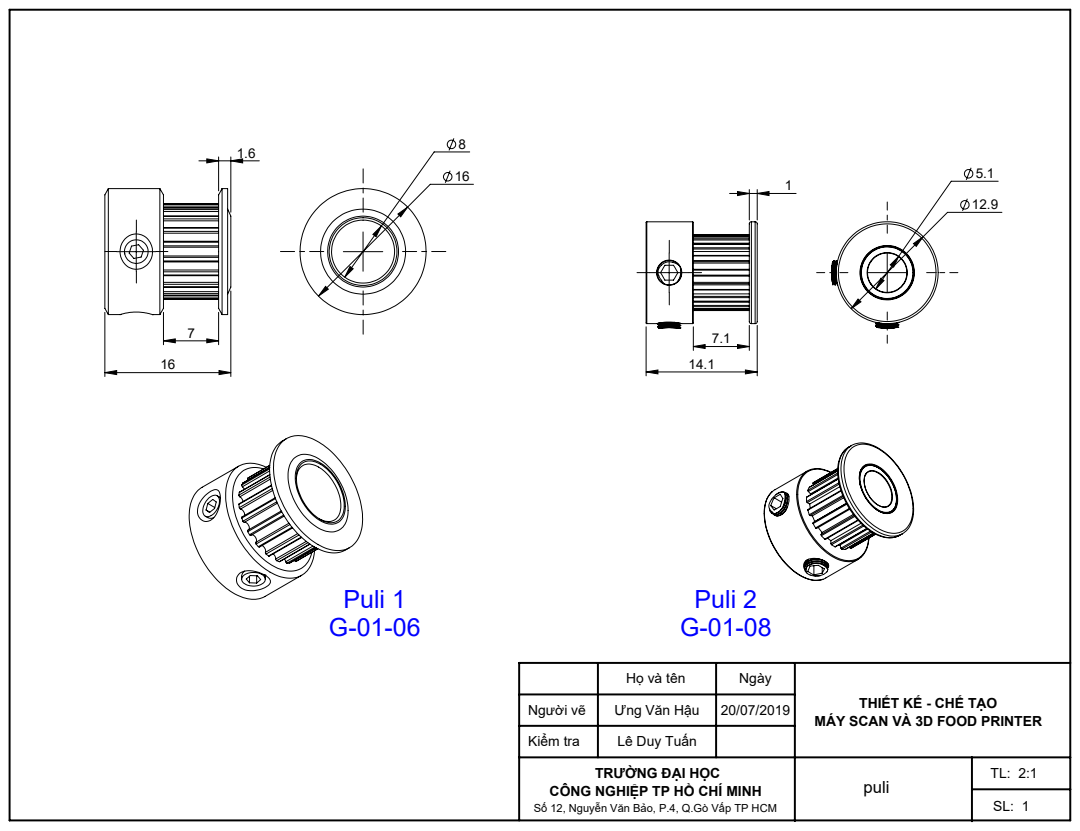
[picture p251: page 46]
Puli 1; Puli 2

Họ và tên | Ngày | THIẾT KẾ - CHẾ TẠO MÁY SCAN VÀ 3D FOOD PRINTER

Người vẽ | Ưng Văn Hậu | 20/07/2019
Kiểm tra | Lê Duy Tuấn
TRƯỜNG ĐẠI HỌC | puli | TL: 2:1
