VVCi/Graduate_Thesis/05_Reference_Documents/Food_3D_Printer/CD/BIA.docx

BỘ CÔNG THƯƠNG

TRƯỜNG ĐẠI HỌC CÔNG NGHIỆP TP. HCM

KHOA CƠ KHÍ

BỘ MÔN CÔNG NGHỆ CƠ ĐIỆN TỬ

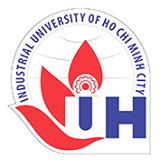
[picture p252: figure]
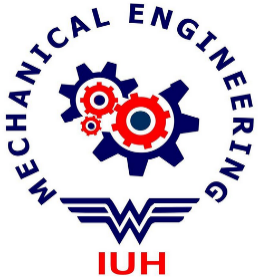
[picture p253: figure]

ĐỒ ÁN TỐT NGHIỆP NGÀNH CƠ ĐIỆN TỬ

ĐỀ TÀI: THIẾT KẾ CHẾ TẠO MÁY QUÉT 3D VÀ MÁY IN 3D THỰC PHẨM

Giảng viên hướng dẫn: ThS. LÊ DUY TUẤN

Sinh viên thực hiện:

ĐẶNG HOÀNG NHẤT VY 15063681

ƯNG VĂN HẬU 15064861

TRẦN CÔNG ĐỨC 15046341

VÕ HOÀNG MẪN 15066171

TP. Hồ Chí Minh, tháng 08, năm2019
