VVCi/Graduate_Thesis/01_Deliverable/01_Report/Report_v0.3/hung/hung/PID_TEST.xlsx

Sheet: Sheet1
26.925 | 0
26.925 | 0
26.925 | 0
26.925 | 2
26.925 | 4
26.925 | 6
26.959 | 8
26.959 | 12
26.959 | 15
26.959 | 19
26.993 | 24
26.993 | 30
26.993 | 136
26.993 | 446
27.027 | 772
27.027 | 1014
27.027 | 1146
27.061 | 1159
27.061 | 1146
27.095 | 1126
27.095 | 1101
27.095 | 1081
27.129 | 1069
27.129 | 1061
27.129 | 1057
27.163 | 1053
27.163 | 1051
27.163 | 1049
27.196 | 1048
27.196 | 1046
27.23 | 1043
27.23 | 1041
27.23 | 1040
27.264 | 1041
27.264 | 1039
27.297 | 1038
27.297 | 1037
27.297 | 1036
27.331 | 1036
27.331 | 1034
27.331 | 1032
27.367 | 1032
27.367 | 1032
27.367 | 1031
27.4 | 1032
27.4 | 1032
27.4 | 1031
27.434 | 1031
27.434 | 1031
27.468 | 1030
27.468 | 1030
27.468 | 1030
27.503 | 1030
27.503 | 1030
27.503 | 1030
27.536 | 1030
27.536 | 1030
27.57 | 1034
27.57 | 1034
27.57 | 1034
27.604 | 1033
27.604 | 1033
27.604 | 1034
27.638 | 1034
27.638 | 1034
27.638 | 1032
27.672 | 1032
27.672 | 1032
27.705 | 1032
27.705 | 1034
27.705 | 1035
27.74 | 1035
27.74 | 1035
27.74 | 1035
27.774 | 1035
27.774 | 1030
27.808 | 1030
27.808 | 1030
27.808 | 1030
27.841 | 1030
27.841 | 1030
27.841 | 1030
27.875 | 1030
27.875 | 1030
27.875 | 1030
27.909 | 1030
27.909 | 1030
27.943 | 1030
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
