VVCi/Graduate_Thesis/05_Reference_Documents/02_Report/Thiet_ke_co_khi.pdf

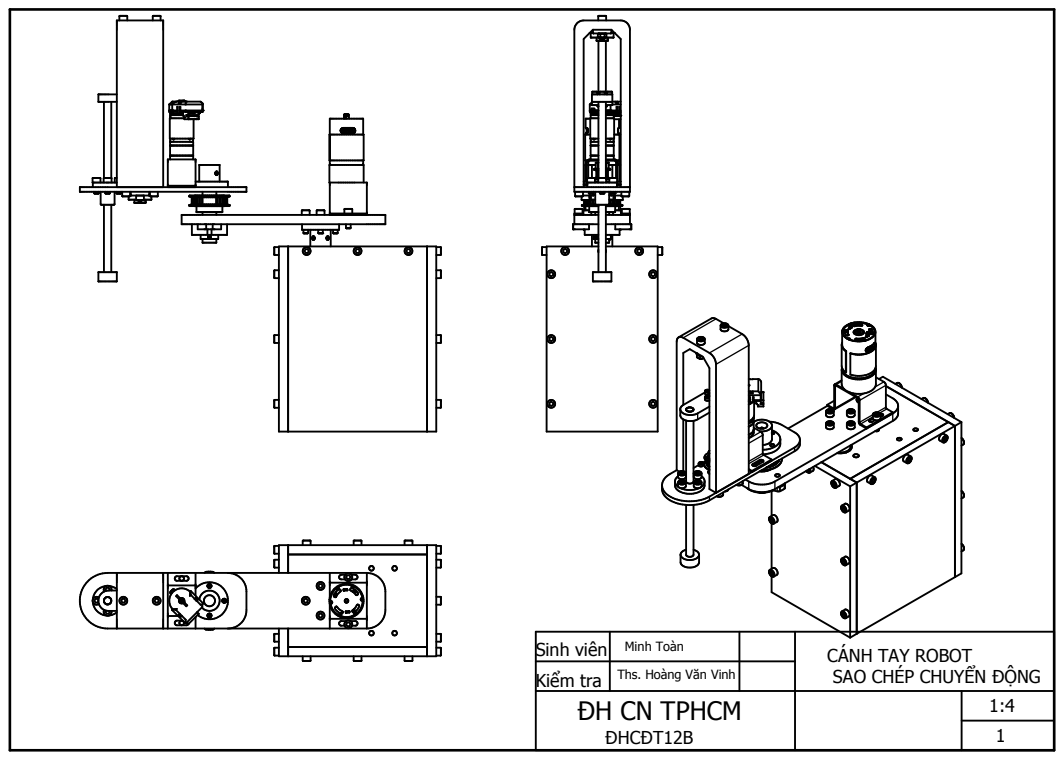
[picture p254: page 1]
Minh Toàn

Sinh viên
Kiểm tra
ĐH CN TPHCM
ĐHCĐT12B

CÁNH TAY ROBOT
SAO CHÉP CHUYỂN ĐỘNG

Ths. Hoàng Văn Vinh

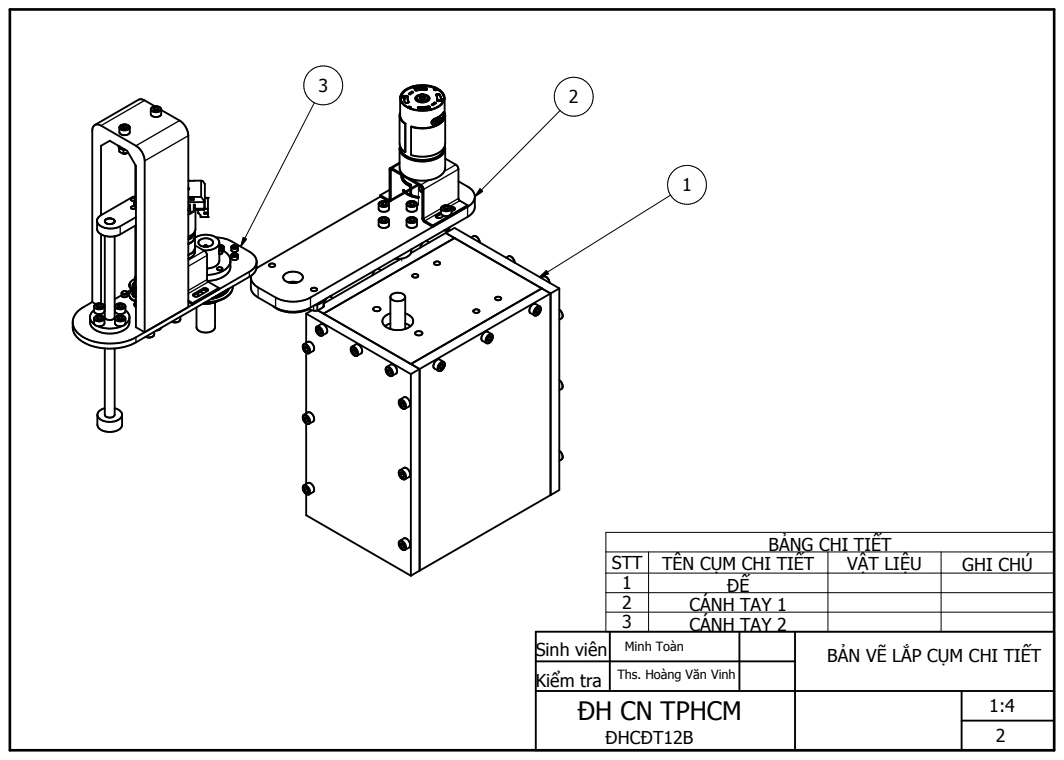
[picture p255: page 2]
Sinh viên; Kiểm tra; Minh Toàn; STT TÊN CỤM CHI TIẾT; VẬT LIỆU; GHI CHÚ; CÁNH TAY 1; CÁNH TAY 2

BẢNG CHI TIẾT

BẢN VẼ LẮP CỤM CHI TIẾT

Ths. Hoàng Văn Vinh

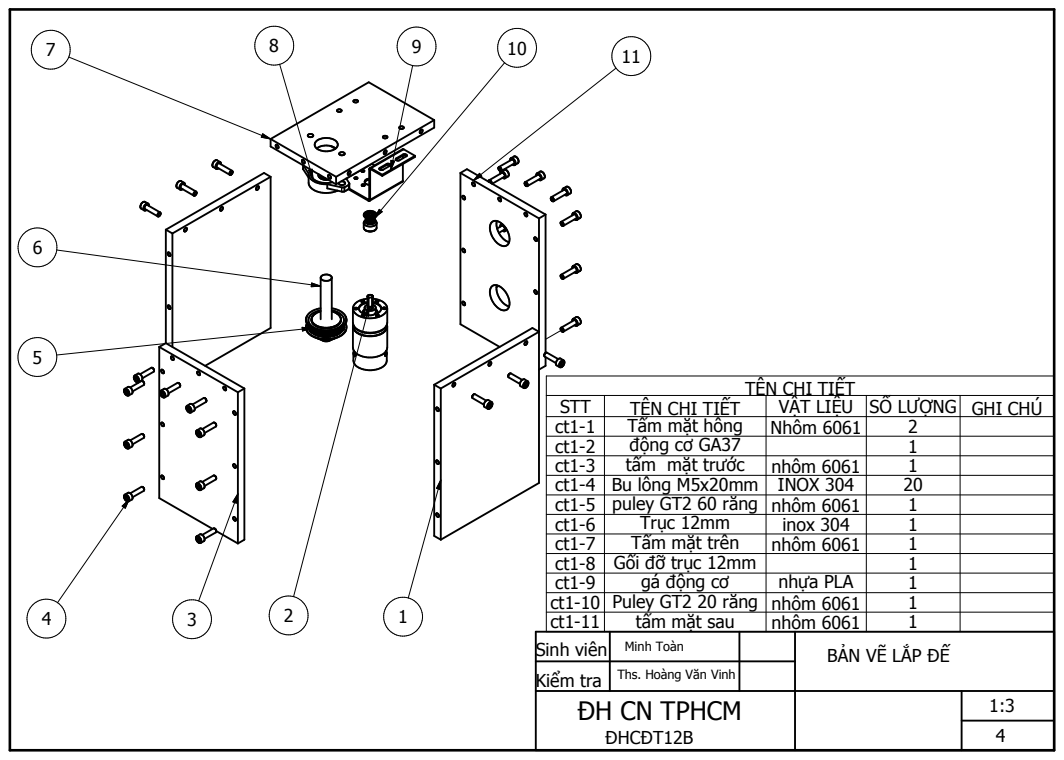
[picture p256: page 3]
STT; TÊN CHI TIẾT; VẬT LIỆU SỐ LƯỢNG GHI CHÚ; Tấm mặt hông; Nhôm 6061; động cơ GA37; tấm mặt trước; nhôm 6061; ct1-4 Bu lông M5x20mm INOX 304; ct1-5 puley GT2 60 răng nhôm 6061; Trục 12mm; inox 304; Tấm mặt trên; ct1-8 Gối đỡ trục 12mm; gá động cơ; nhựa PLA; ct1-10 Puley GT2 20 răng nhôm 6061; tấm mặt sau

TÊN CHI TIẾT

Sinh viên | Minh Toàn | | BẢN VẼ LẮP ĐẾ
Kiểm tra | Ths. Hoàng Văn Vinh

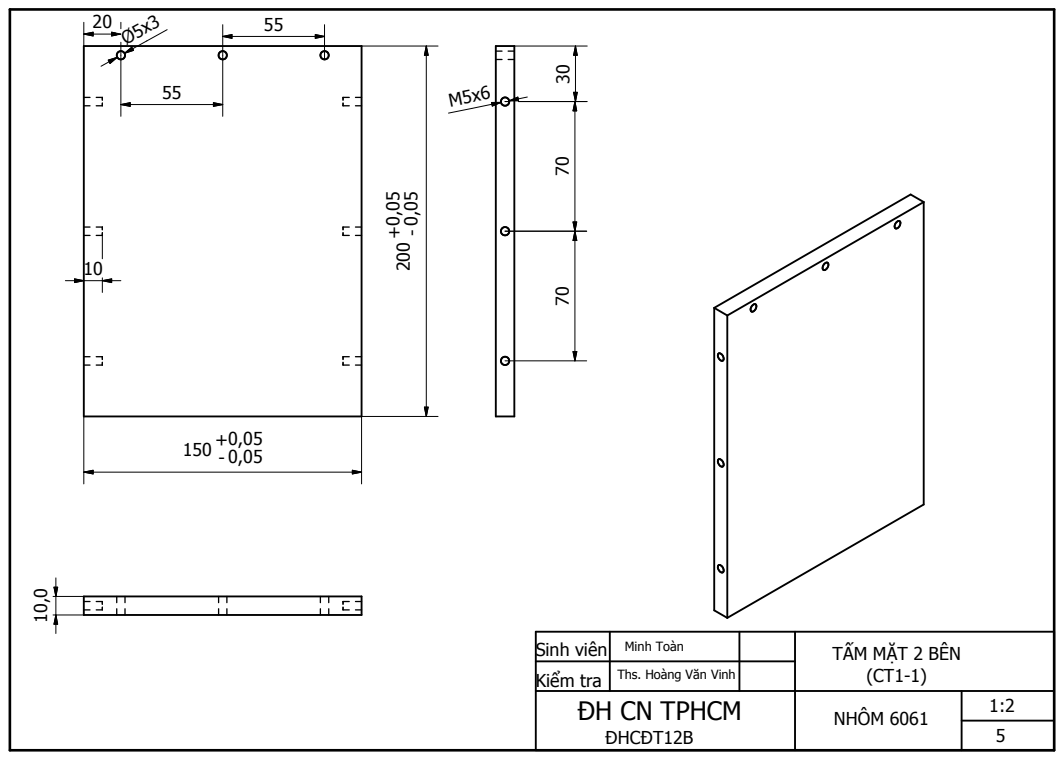
[picture p257: page 4]

Sinh viên | Minh Toàn | | TẤM MẶT 2 BÊN (CT1-1)
Kiểm tra | Ths. Hoàng Văn Vinh

NHÔM 6061 | 1:2

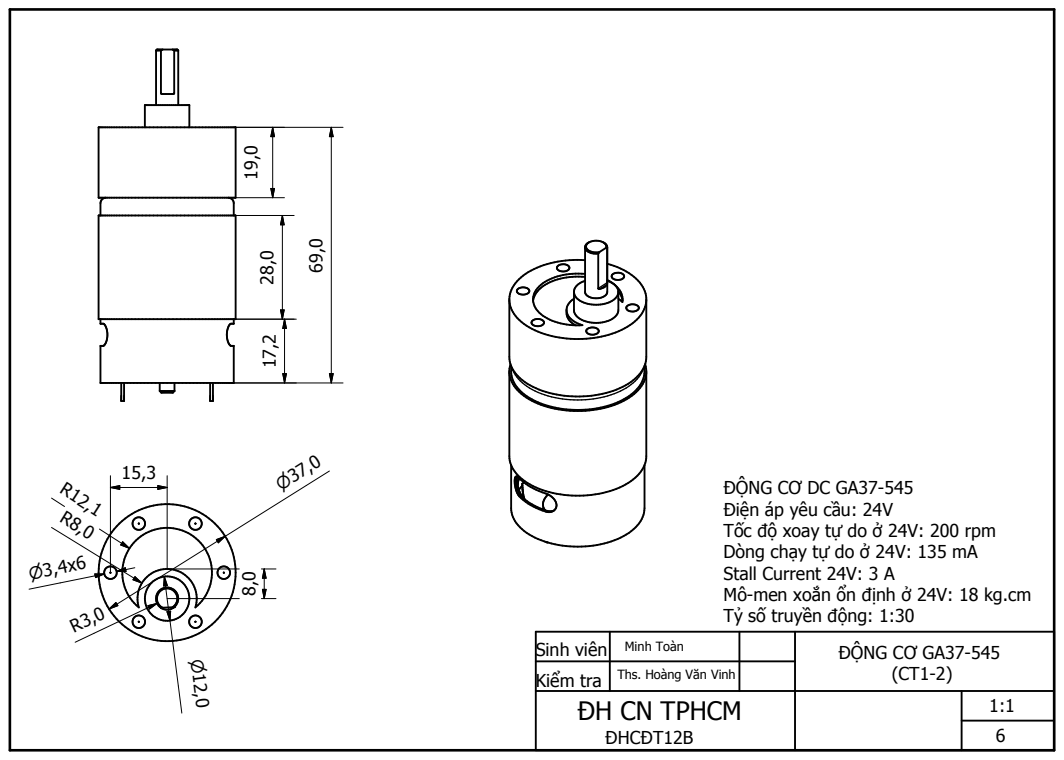
[picture p258: page 5]

ĐỘNG CƠ DC GA37-545
Điện áp yêu cầu: 24V
Tốc độ xoay tự do ở 24V: 200 rpm
Dòng chạy tự do ở 24V: 135 mA
Stall Current 24V: 3 A
Mô-men xoắn ổn định ở 24V: 18 kg.cm
Tỷ số truyền động: 1:30

Sinh viên | Minh Toàn | | ĐỘNG CƠ GA37-545 (CT1-2)
Kiểm tra | Ths. Hoàng Văn Vinh

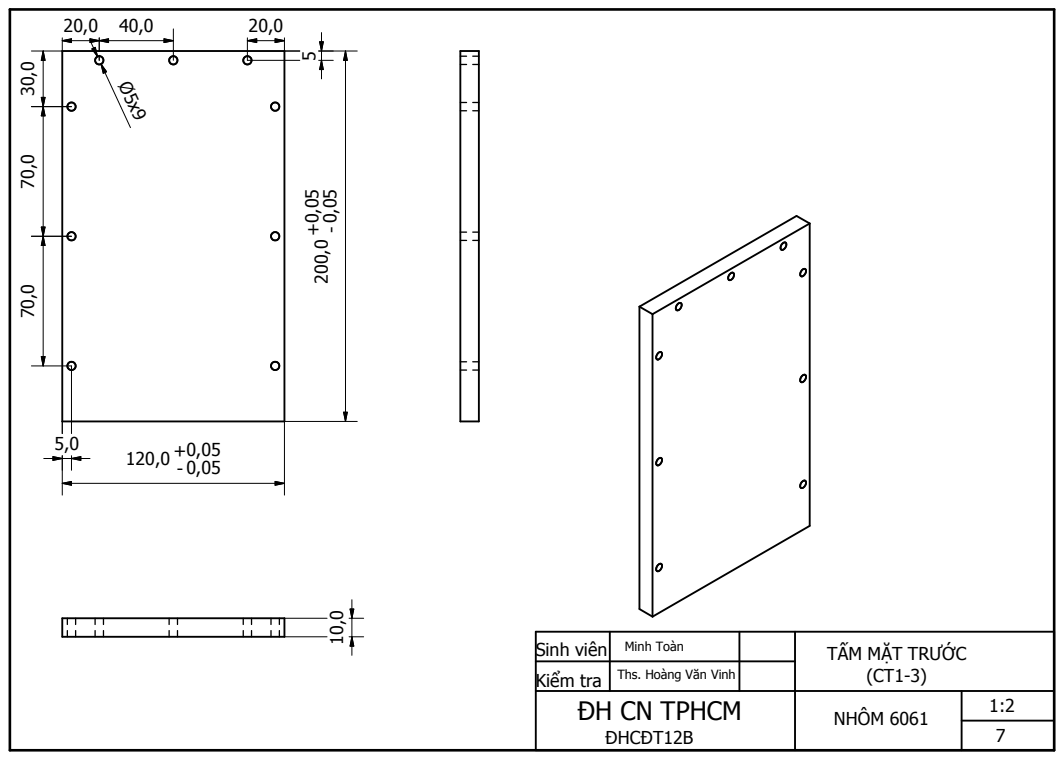
[picture p259: page 6]

Sinh viên | Minh Toàn | | TẤM MẶT TRƯỚC (CT1-3)
Kiểm tra | Ths. Hoàng Văn Vinh

NHÔM 6061 | 1:2

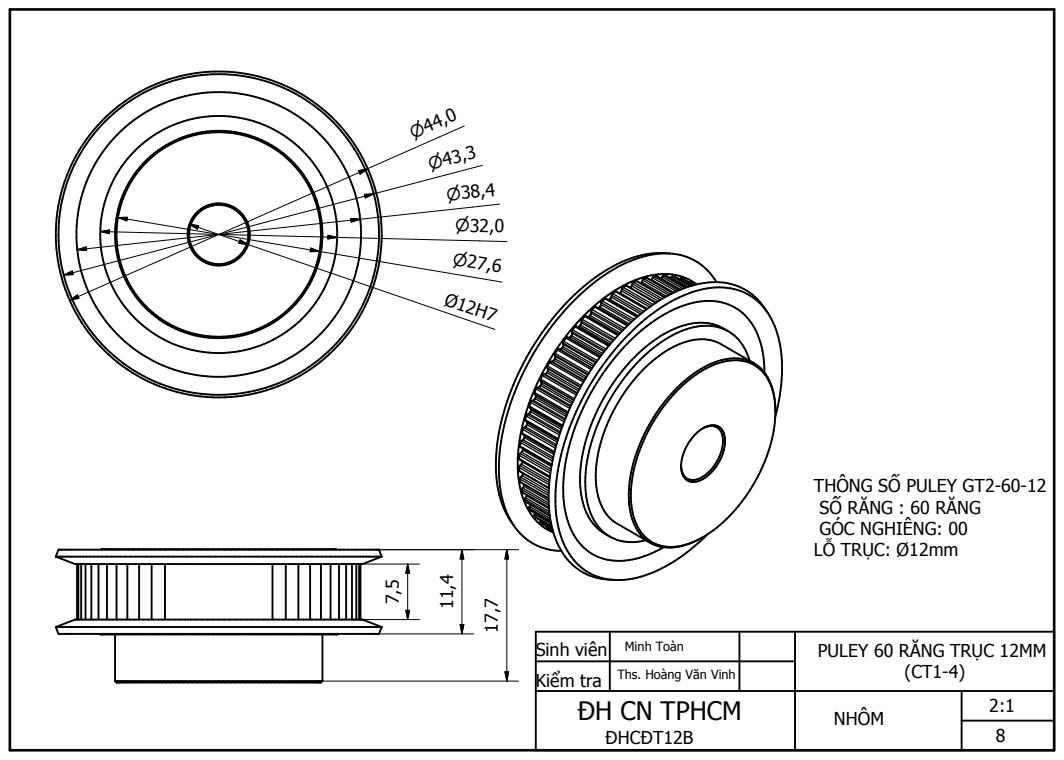
[picture p260: page 7]

THÔNG SỐ PULEY GT2-60-12
SỐ RĂNG : 60 RĂNG
GÓC NGHIÊNG: 00
LỖ TRỤC: Ø12mm

Sinh viên | Minh Toàn | | PULEY 60 RĂNG TRỤC 12MM (CT1-4)
Kiểm tra | Ths. Hoàng Văn Vinh

NHÔM | 2:1

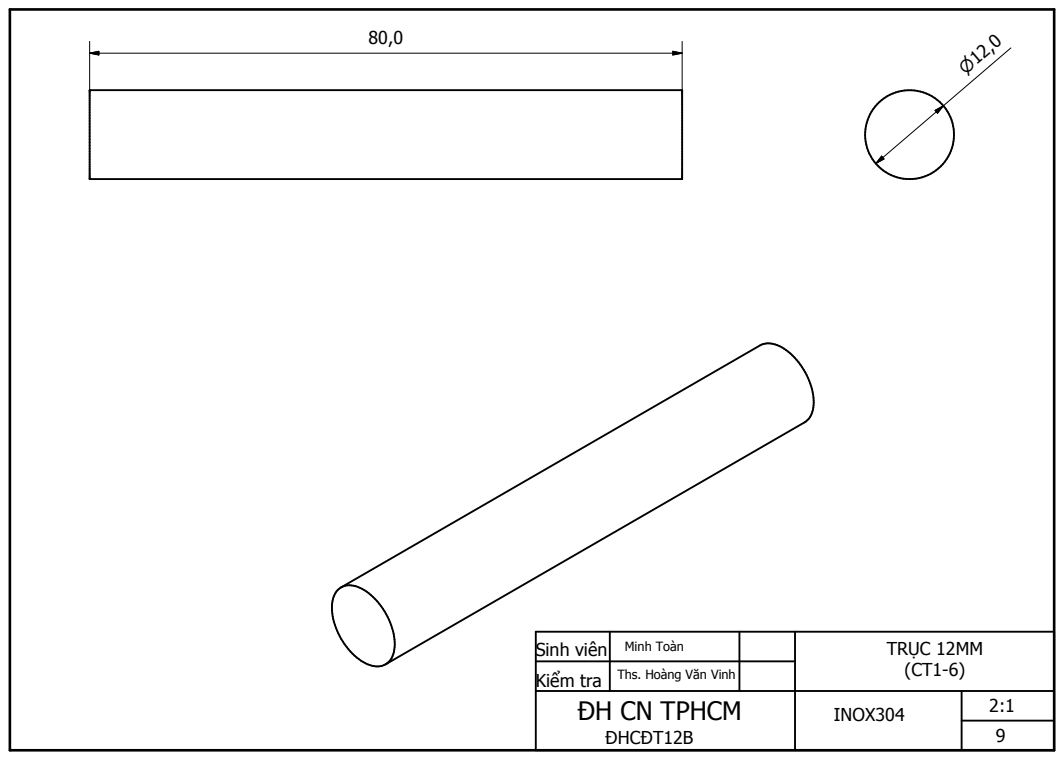
[picture p261: page 8]

Sinh viên | Minh Toàn | | TRỤC 12MM (CT1-6)
Kiểm tra | Ths. Hoàng Văn Vinh

INOX304 | 2:1

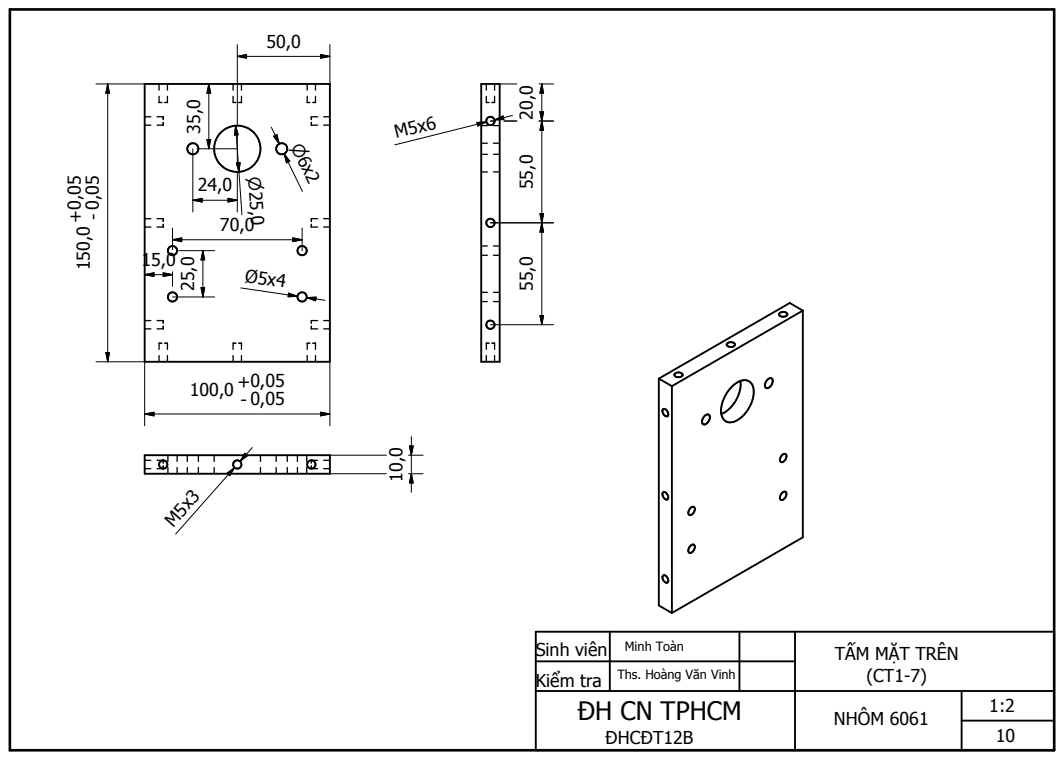
[picture p262: page 9]

Sinh viên | Minh Toàn | | TẤM MẶT TRÊN (CT1-7)
Kiểm tra | Ths. Hoàng Văn Vinh

NHÔM 6061 | 1:2

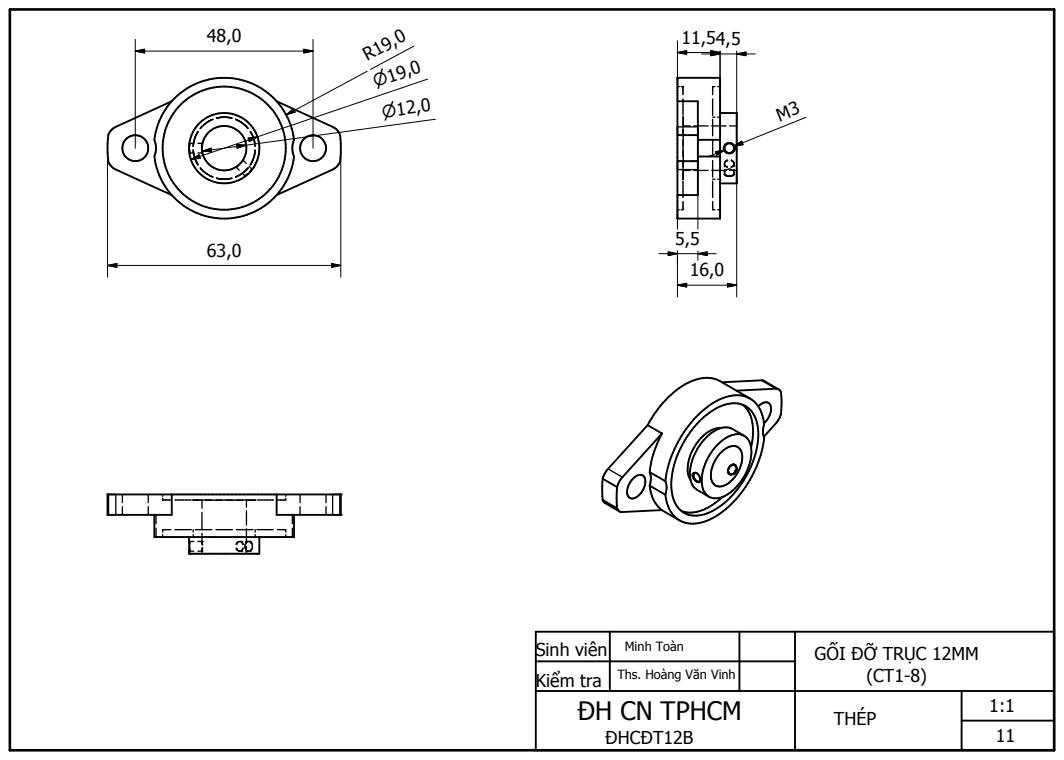
[picture p263: page 10]

Sinh viên | Minh Toàn | | GỐI ĐỠ TRỤC 12MM (CT1-8)
Kiểm tra | Ths. Hoàng Văn Vinh

THÉP | 1:1

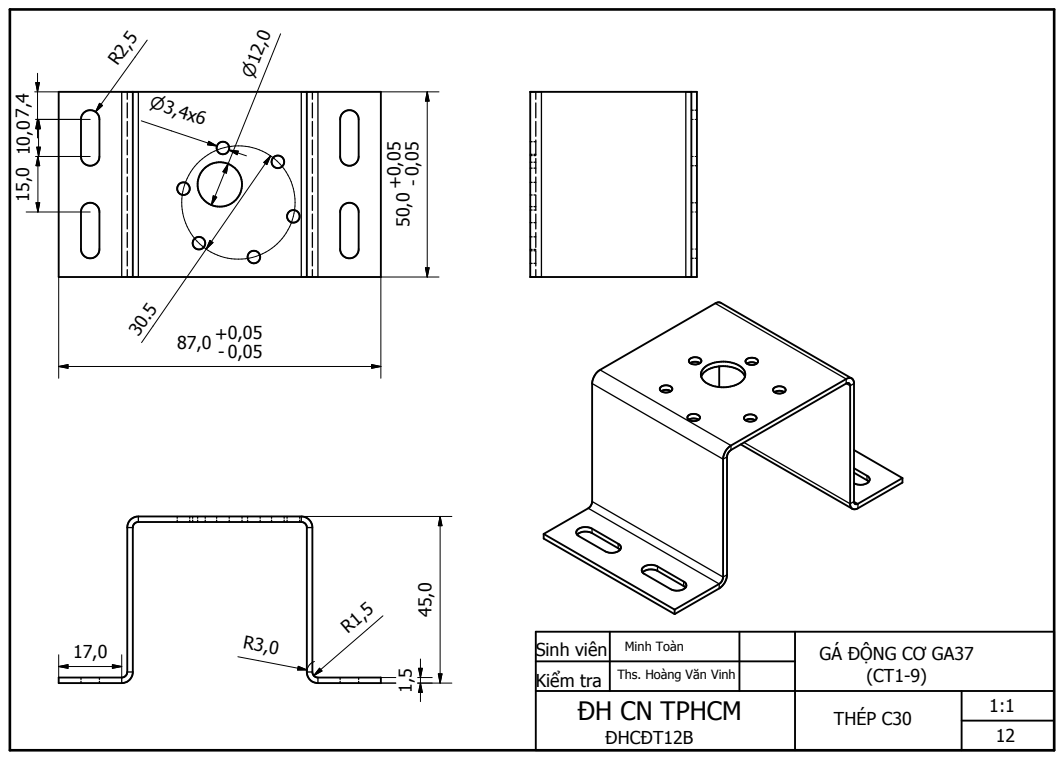
[picture p264: page 11]

Sinh viên | Minh Toàn | | GÁ ĐỘNG CƠ GA37 (CT1-9)
Kiểm tra | Ths. Hoàng Văn Vinh

THÉP C30 | 1:1

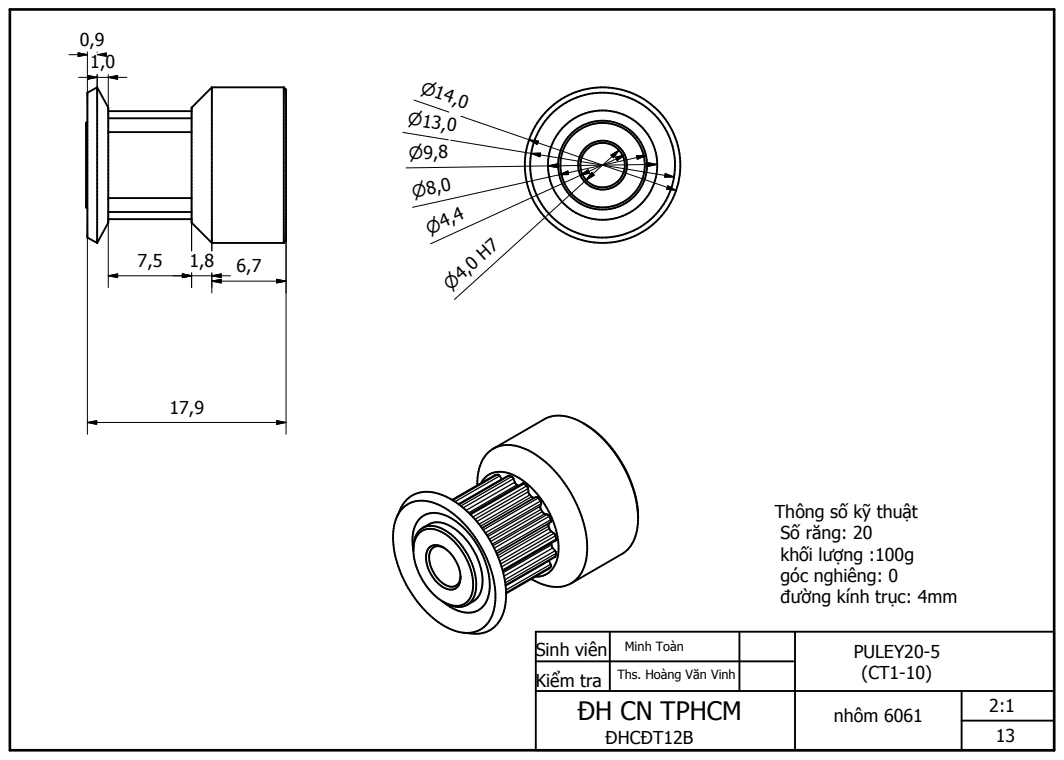
[picture p265: page 12]

Thông số kỹ thuật
Số răng: 20
khối lượng :100g
góc nghiêng: 0
đường kính trục: 4mm

Sinh viên | Minh Toàn | | PULEY20-5 (CT1-10)
Kiểm tra | Ths. Hoàng Văn Vinh

nhôm 6061 | 2:1

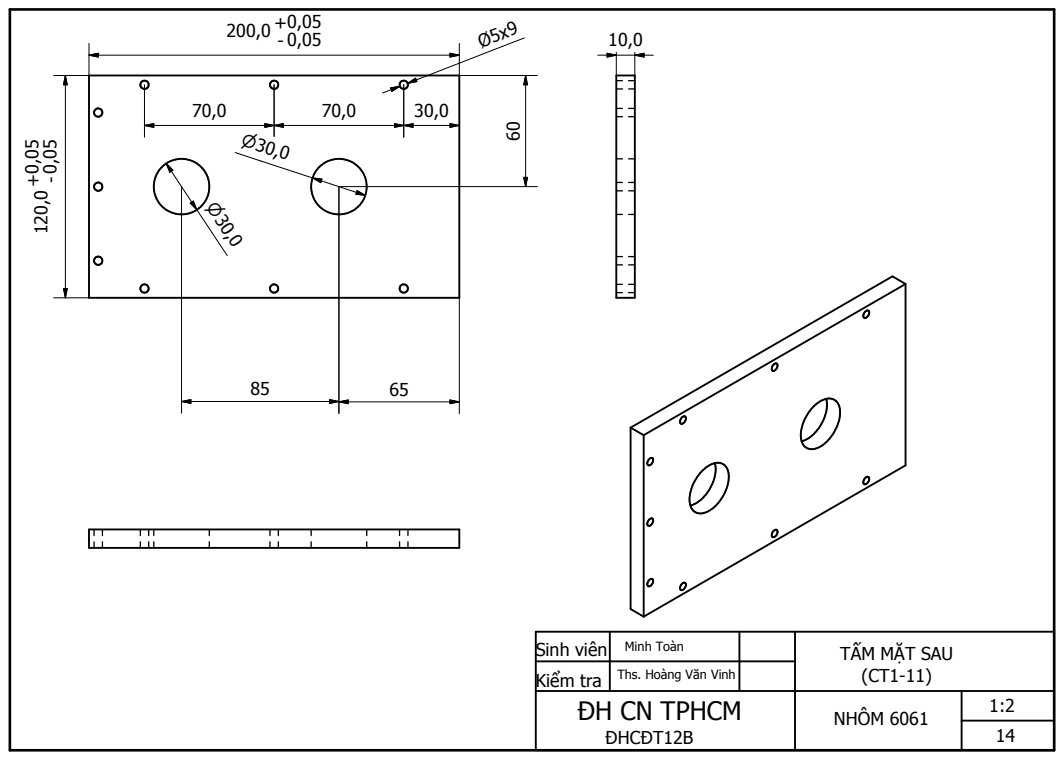
[picture p266: page 13]

Sinh viên | Minh Toàn | | TẤM MẶT SAU (CT1-11)
Kiểm tra | Ths. Hoàng Văn Vinh

NHÔM 6061 | 1:2

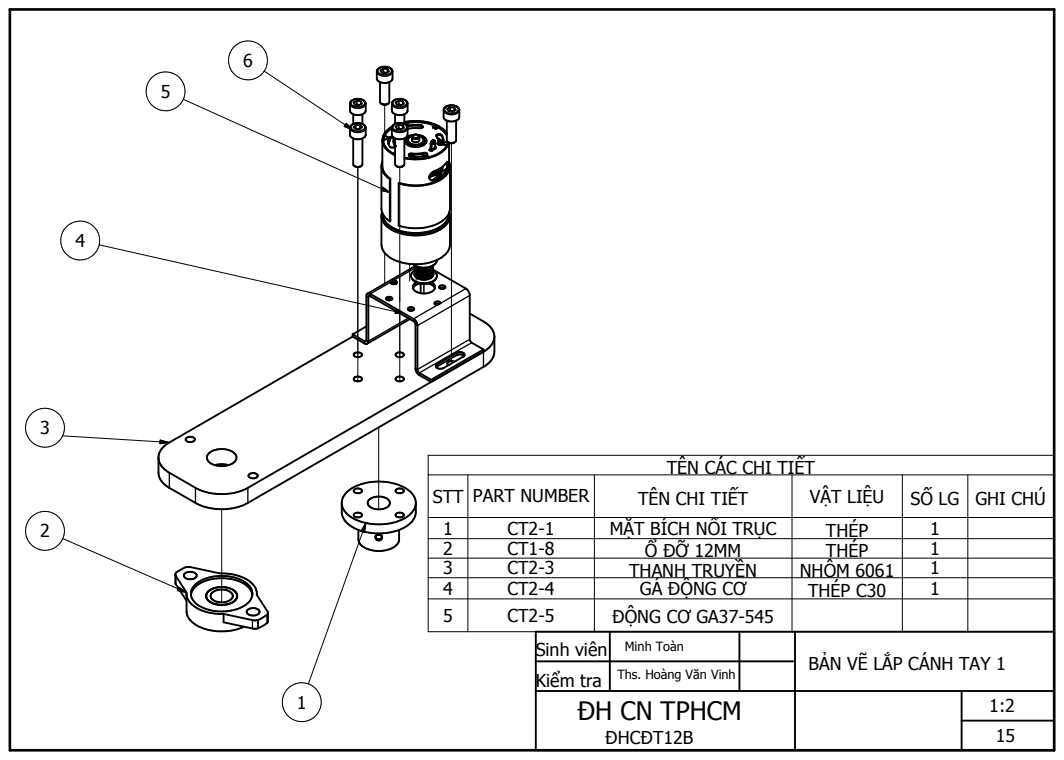
[picture p267: page 14]

TÊN CÁC CHI TIẾT

STT | PART NUMBER | TÊN CHI TIẾT | VẬT LIỆU | SỐ LG | GHI CHÚ
1 | CT2-1 | MẶT BÍCH NỐI TRỤC | THÉP | 1
2 | CT1-8 | Ổ ĐỠ 12MM | THÉP | 1
3 | CT2-3 | THANH TRUYỀN | NHÔM 6061 | 1
4 | CT2-4 | GÁ ĐỘNG CƠ | THÉP C30 | 1
5 | CT2-5 | ĐỘNG CƠ GA37-545

Sinh viên | Minh Toàn | | BẢN VẼ LẮP CÁNH TAY 1
Kiểm tra | Ths. Hoàng Văn Vinh

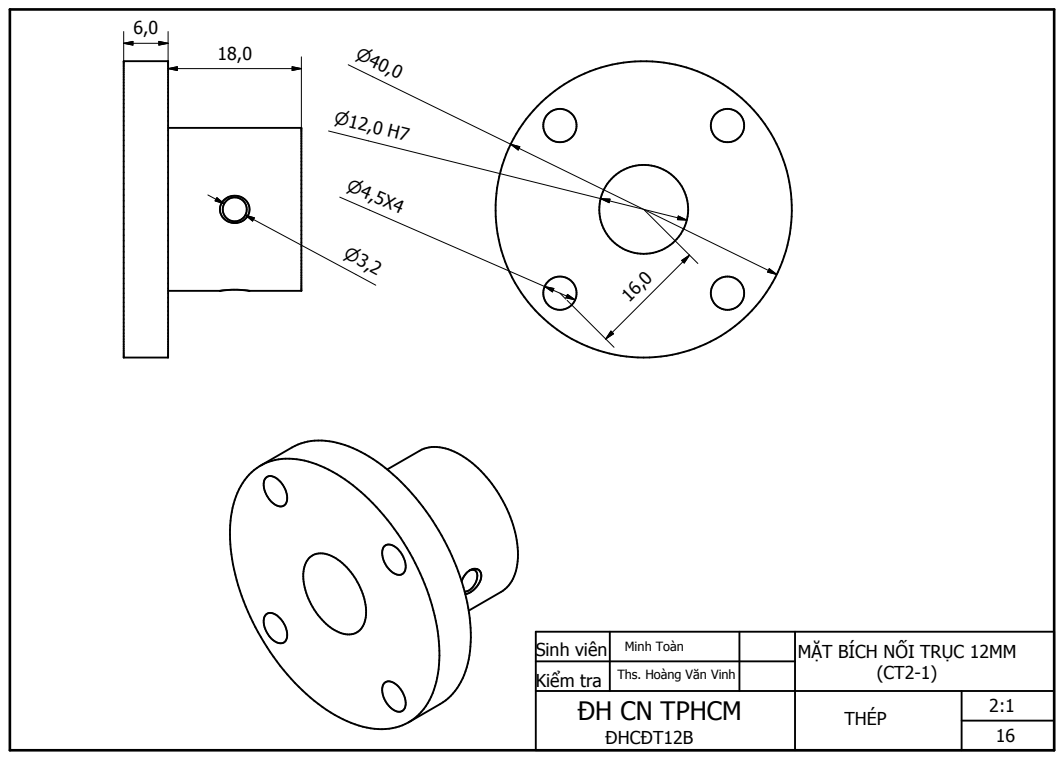
[picture p268: page 15]

Sinh viên | Minh Toàn | | MẶT BÍCH NỐI TRỤC 12MM (CT2-1)
Kiểm tra | Ths. Hoàng Văn Vinh

THÉP | 2:1

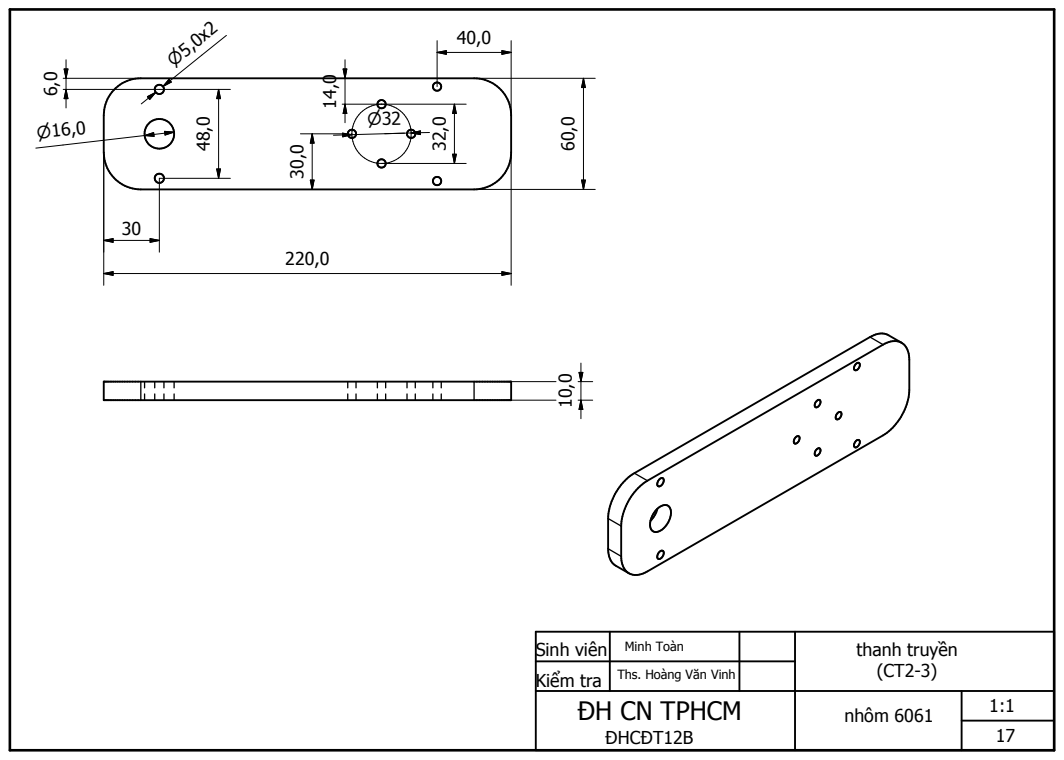
[picture p269: page 16]

Sinh viên | Minh Toàn | | thanh truyền (CT2-3)
Kiểm tra | Ths. Hoàng Văn Vinh

nhôm 6061 | 1:1

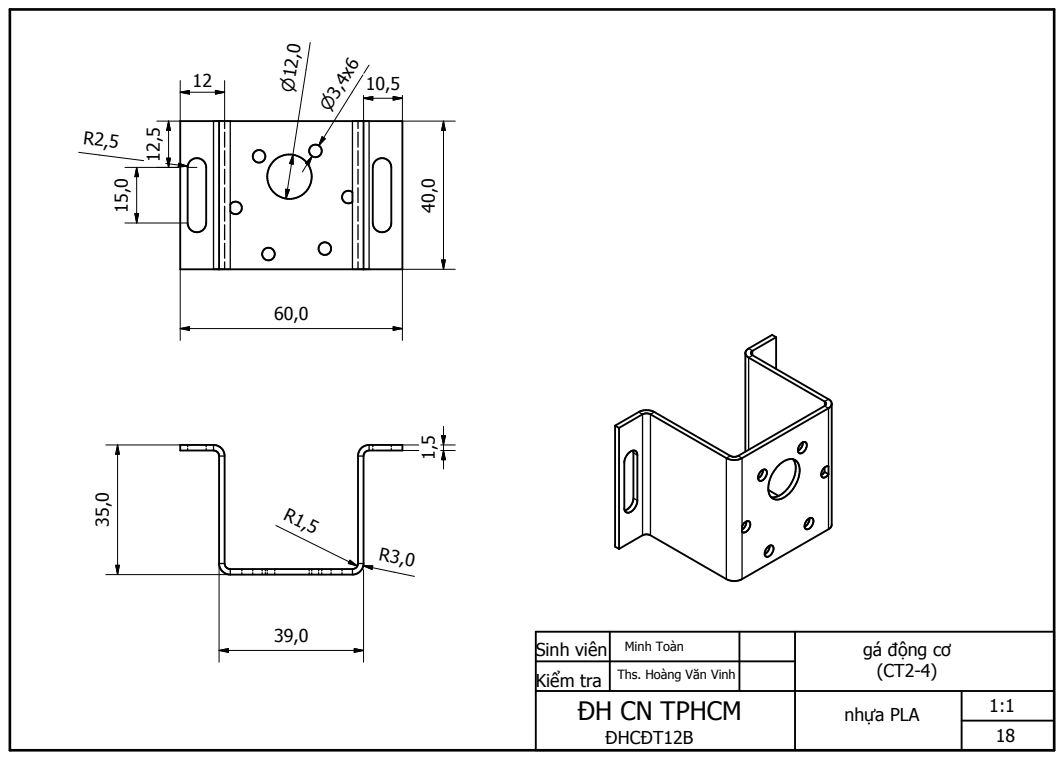
[picture p270: page 17]

Sinh viên | Minh Toàn | | gá động cơ (CT2-4)
Kiểm tra | Ths. Hoàng Văn Vinh

nhựa PLA | 1:1

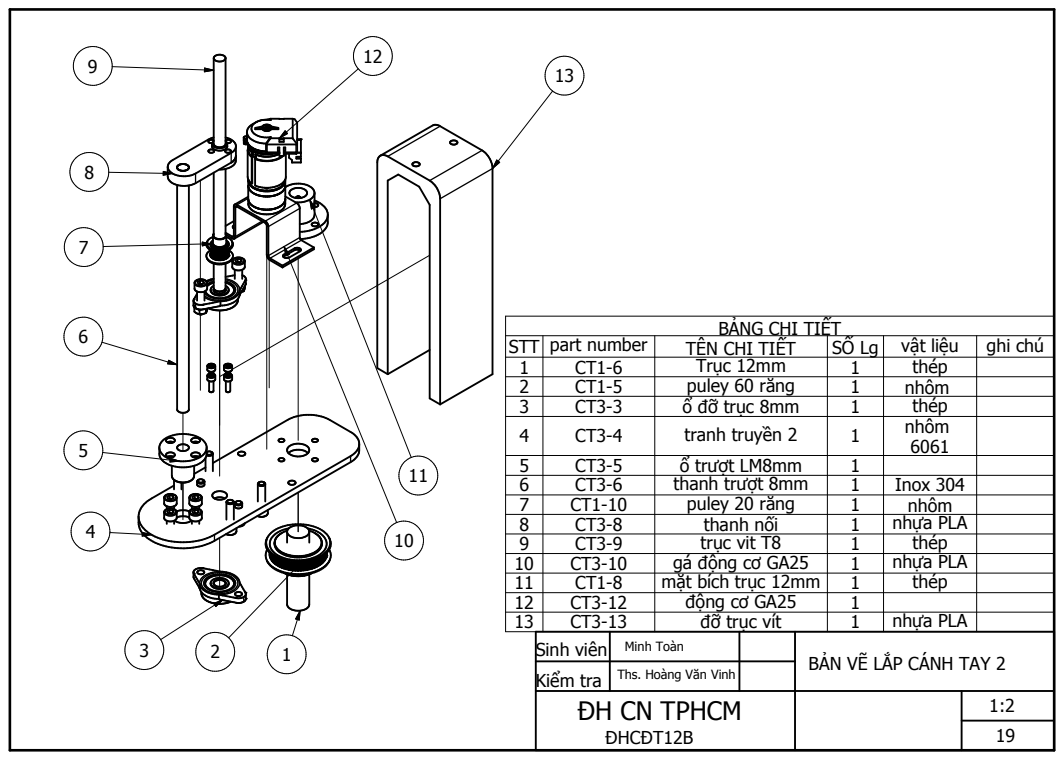
[picture p271: page 18]

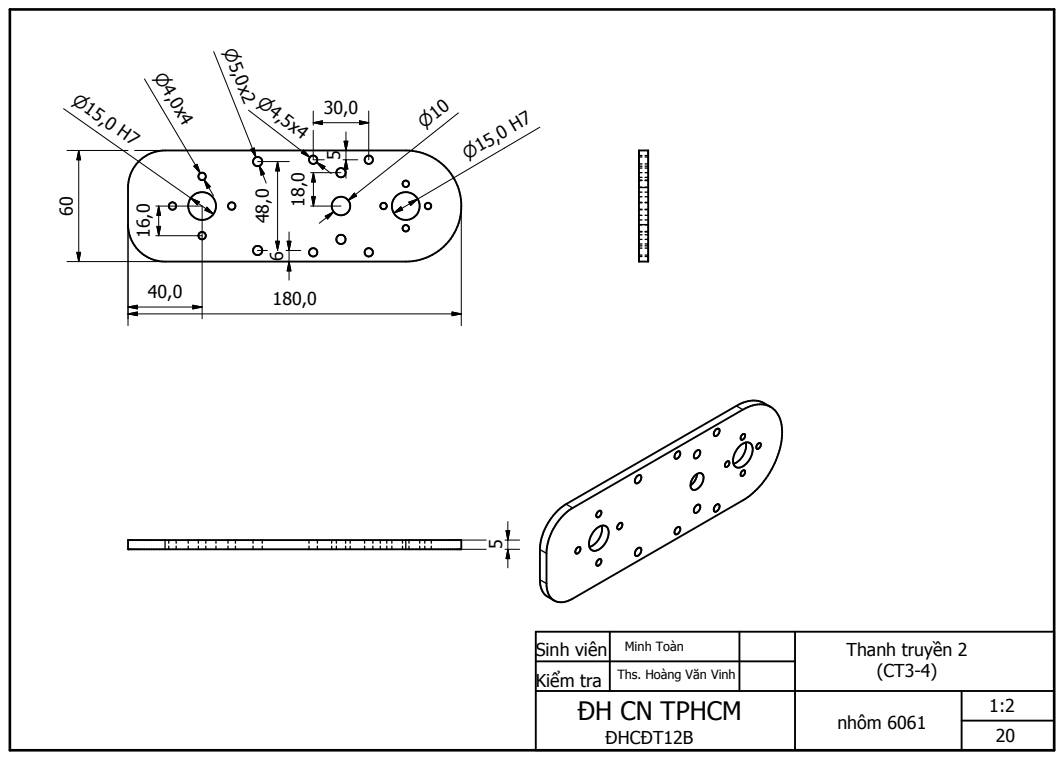
[picture p272: page 19]

Sinh viên | Minh Toàn | | Thanh truyền 2 (CT3-4)
Kiểm tra | Ths. Hoàng Văn Vinh

nhôm 6061 | 1:2

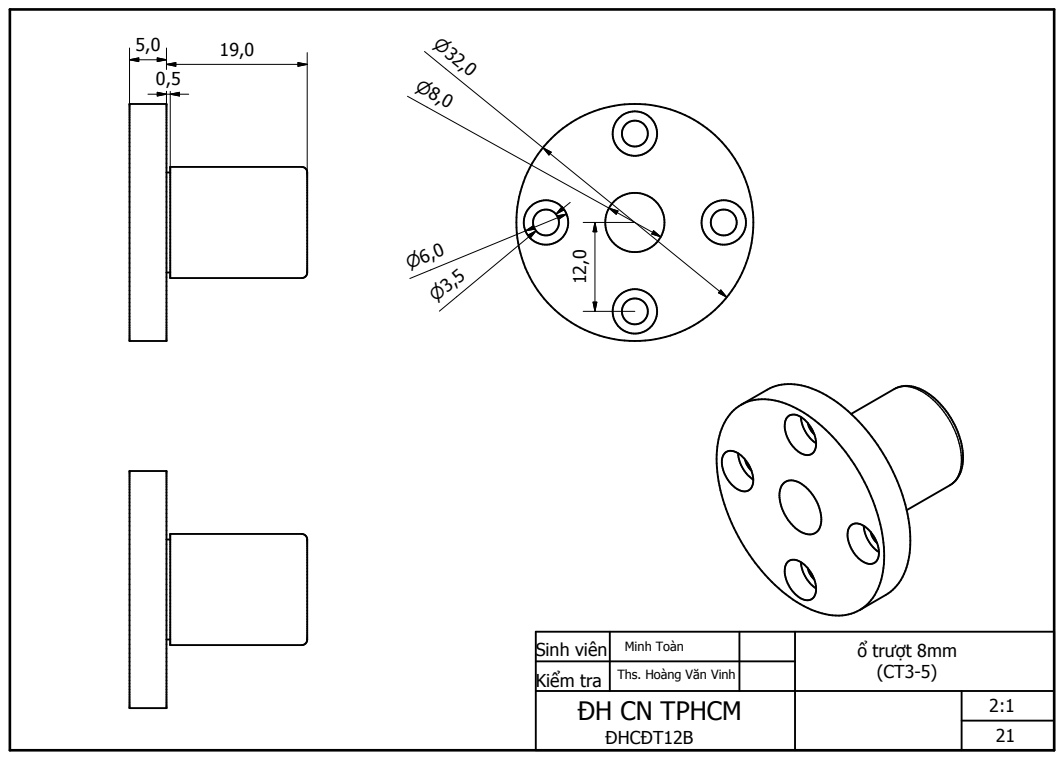
[picture p273: page 20]

Sinh viên | Minh Toàn | | ổ trượt 8mm (CT3-5)
Kiểm tra | Ths. Hoàng Văn Vinh

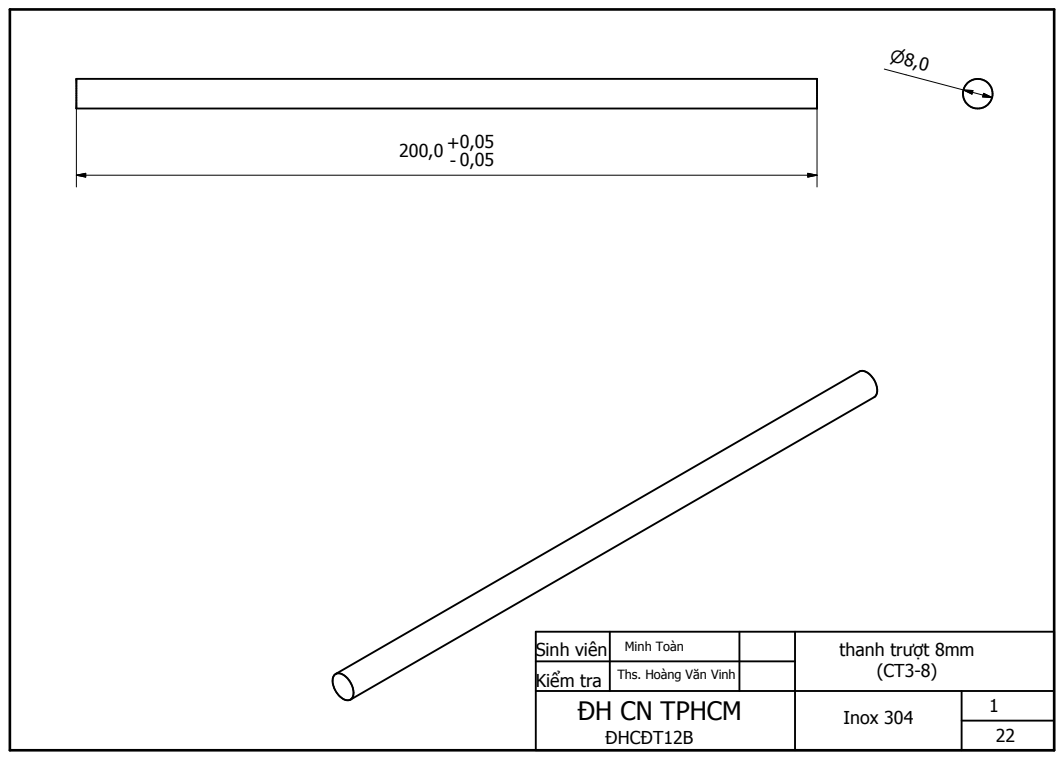
[picture p274: page 21]

Sinh viên | Minh Toàn | | thanh trượt 8mm (CT3-8)
Kiểm tra | Ths. Hoàng Văn Vinh

Inox 304 | 1

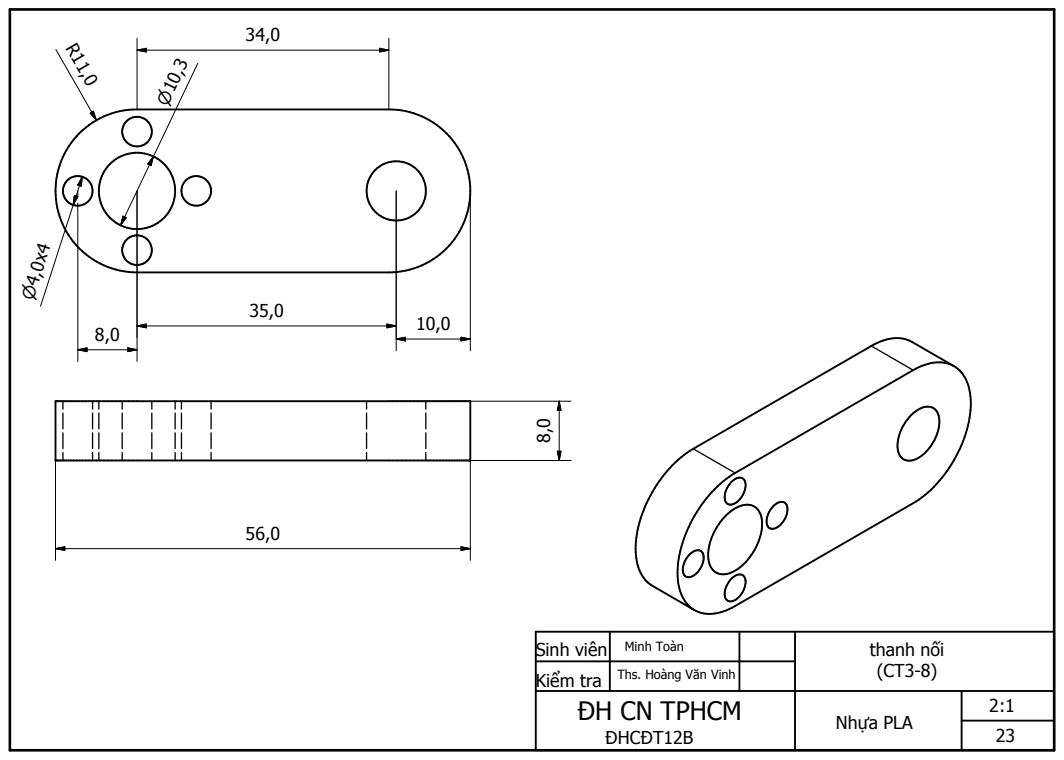
[picture p275: page 22]

Sinh viên | Minh Toàn | | thanh nối (CT3-8)
Kiểm tra | Ths. Hoàng Văn Vinh

Nhựa PLA | 2:1

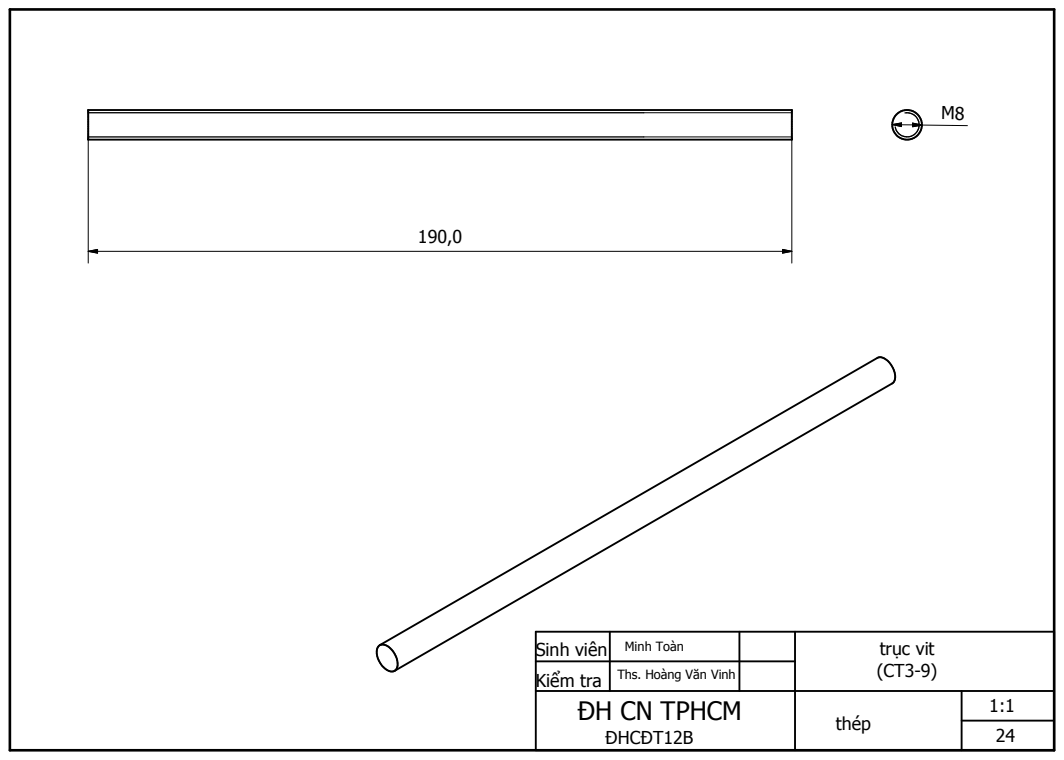
[picture p276: page 23]

Sinh viên | Minh Toàn | | trục vit (CT3-9)
Kiểm tra | Ths. Hoàng Văn Vinh

thép | 1:1

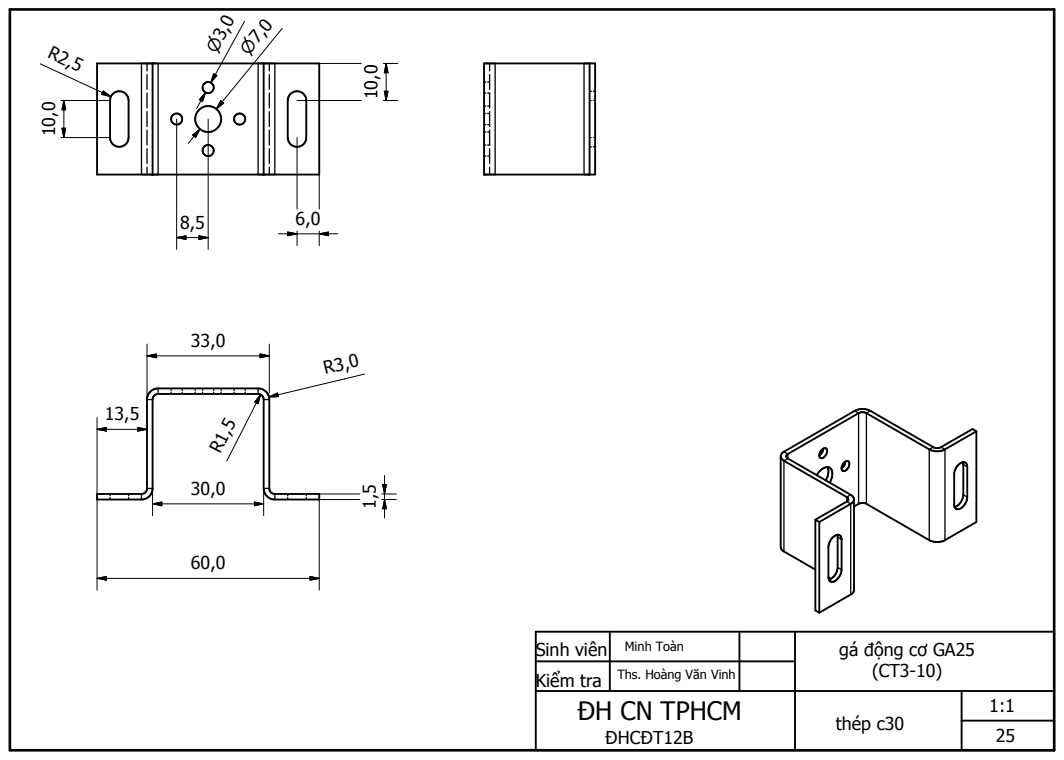
[picture p277: page 24]

Sinh viên | Minh Toàn | | gá động cơ GA25 (CT3-10)
Kiểm tra | Ths. Hoàng Văn Vinh

thép c30 | 1:1

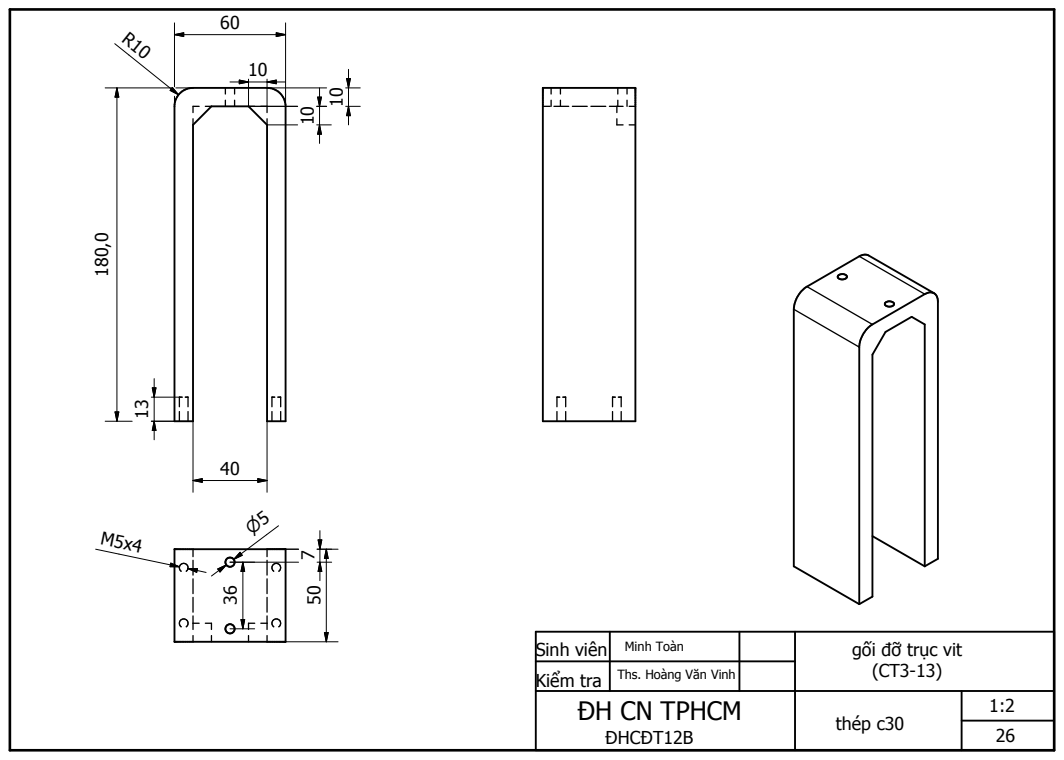
[picture p278: page 25]

Sinh viên | Minh Toàn | | gối đỡ trục vit (CT3-13)
Kiểm tra | Ths. Hoàng Văn Vinh

thép c30 | 1:2
