VVCi/Graduate_Thesis/01_Deliverable/01_Report/Report_v0.4/luong dua-Model.pdf

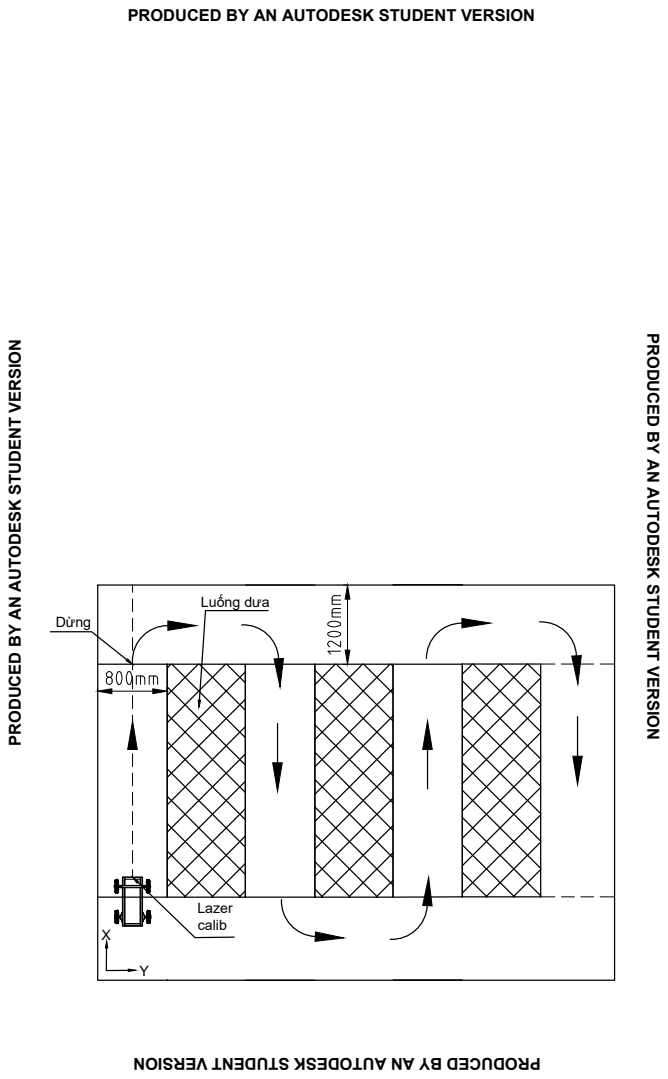
[picture p279: page 1]
Luống dưa X; Lazer calib Dừng

PRODUCED BY AN AUTODESK STUDENT VERSION
