VVCi/Graduate_Thesis/04_Multimedia/02_Images/Lab/Drawing1-Model11.pdf

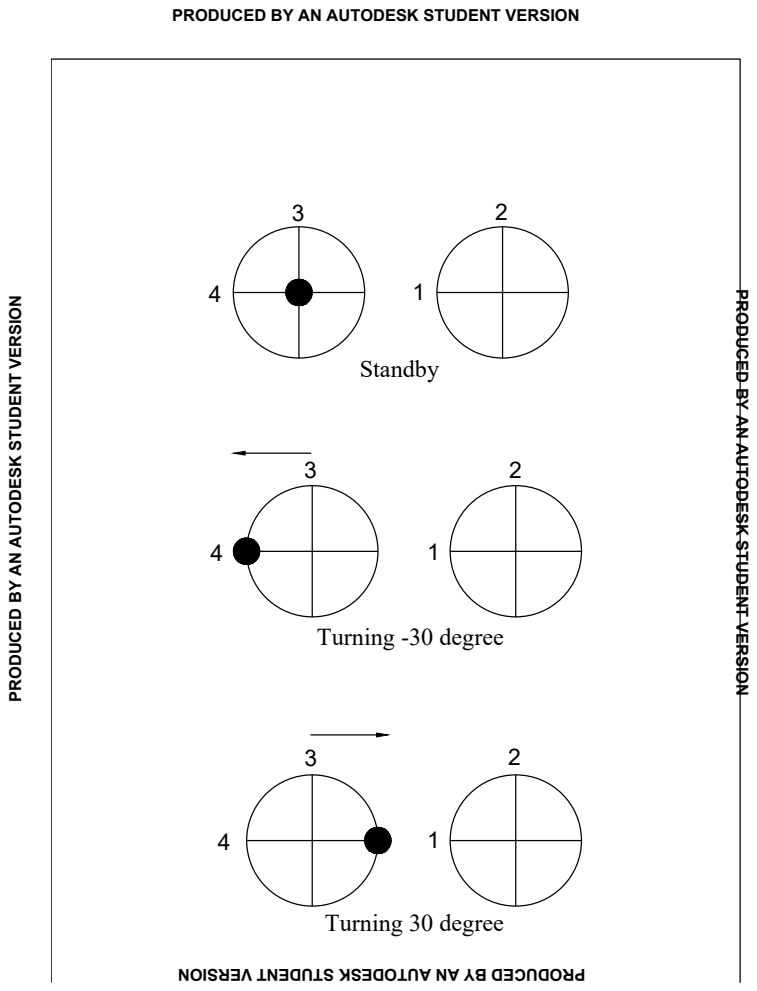
[picture p280: page 1]
Turning -30 degree; Turning 30 degree

PRODUCED BY AN AUTODESK STUDENT VERSION
