VVCi/Graduate_Thesis/04_Multimedia/02_Images/Open_Control_Lab/SF2.pdf

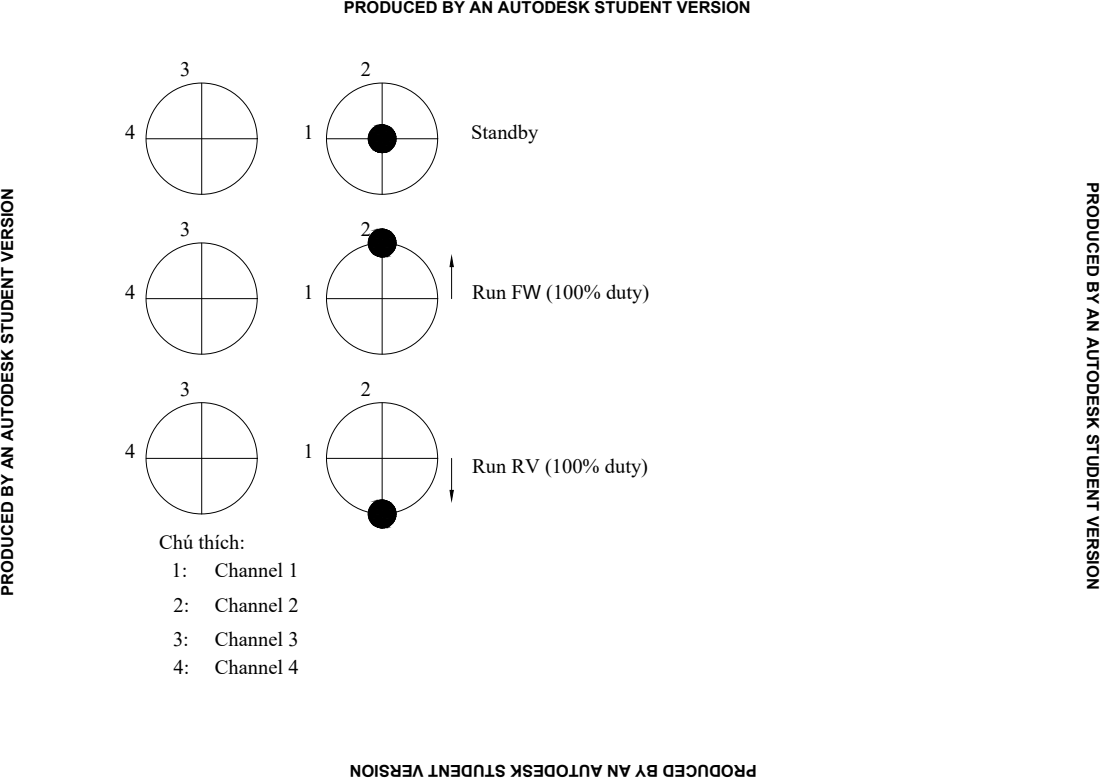
[picture p281: page 1]
Run F; W (100% duty); Run RV (100% duty) 1:; Channel 1 2:; Channel 2 3:; Channel 3 4:; Channel 4 Chú thích:

PRODUCED BY AN AUTODESK STUDENT VERSION
