VVCi/Graduate_Thesis/06_Src/Devo_7/Inc/main.h

#define RELAY_0_Pin GPIO_PIN_0
#define RELAY_0_GPIO_Port GPIOC
#define RELAY_1_Pin GPIO_PIN_1
#define RELAY_1_GPIO_Port GPIOC
#define RELAY_2_Pin GPIO_PIN_2
#define RELAY_2_GPIO_Port GPIOC
#define RELAY_3_Pin GPIO_PIN_3
#define RELAY_3_GPIO_Port GPIOC
#define AUX2_Pin GPIO_PIN_9
#define AUX2_GPIO_Port GPIOE
#define AUX2_EXTI_IRQn EXTI9_5_IRQn
#define ELEV_Pin GPIO_PIN_10
#define ELEV_GPIO_Port GPIOE
#define ELEV_EXTI_IRQn EXTI15_10_IRQn
#define AILE_Pin GPIO_PIN_11
#define AILE_GPIO_Port GPIOE
#define AILE_EXTI_IRQn EXTI15_10_IRQn
#define THRO_Pin GPIO_PIN_12
#define THRO_GPIO_Port GPIOE
#define THRO_EXTI_IRQn EXTI15_10_IRQn
#define RUDD_Pin GPIO_PIN_13
#define RUDD_GPIO_Port GPIOE
#define RUDD_EXTI_IRQn EXTI15_10_IRQn
#define GEAR_Pin GPIO_PIN_14
#define GEAR_GPIO_Port GPIOE
#define GEAR_EXTI_IRQn EXTI15_10_IRQn
#define AUX1_Pin GPIO_PIN_15
#define AUX1_GPIO_Port GPIOE
#define AUX1_EXTI_IRQn EXTI15_10_IRQn
#define PWM_1_Pin GPIO_PIN_6
#define PWM_1_GPIO_Port GPIOC
#define PWM_2_Pin GPIO_PIN_7
#define PWM_2_GPIO_Port GPIOC
#define PWM_3_Pin GPIO_PIN_8
#define PWM_3_GPIO_Port GPIOC
#define PWM_4_Pin GPIO_PIN_9
#define PWM_4_GPIO_Port GPIOC
#define DIR_1_Pin GPIO_PIN_0
#define DIR_1_GPIO_Port GPIOD
#define DIR_2_Pin GPIO_PIN_1
#define DIR_2_GPIO_Port GPIOD
#define DIR_3_Pin GPIO_PIN_5
#define DIR_3_GPIO_Port GPIOD
#define DIR_4_Pin GPIO_PIN_6
#define DIR_4_GPIO_Port GPIOD
