VVCi/Graduate_Thesis/06_Src/Devo_7/Src/main.c

/**
  ******************************************************************************
  * @file           : main.c
  * @brief          : Main program body
  ******************************************************************************
  ** This notice applies to any and all portions of this file
  * that are not between comment pairs USER CODE BEGIN and
  * USER CODE END. Other portions of this file, whether 
  * inserted by the user or by software development tools
  * are owned by their respective copyright owners.
  *
  * COPYRIGHT(c) 2019 STMicroelectronics
  *
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
  ******************************************************************************
  */
/* Includes ------------------------------------------------------------------*/
#include "main.h"
#include "stm32f4xx_hal.h"

TIM_HandleTypeDef htim2;
TIM_HandleTypeDef htim3;
TIM_HandleTypeDef htim4;
TIM_HandleTypeDef htim5;

/* USER CODE BEGIN PV */
__IO uint16_t u16_PwmLeft = 0, u16_PwmRight = 0;
__IO int16_t i16_PwmLeftTemp = 0, i16_PwmRightTemp = 0;
__IO float f_PwmLeftTemp = 0, f_PwmRightTemp = 0;
__IO float f_PwmLeftFilter = 0, f_PwmRightFilter = 0;
__I float f_Kfilter = 0.025f;
__IO int16_t i16_PwmDirTemp = 0;

extern int32_t HighPulse[];
extern int32_t LowPulse[];
/* USER CODE END PV */

void SystemClock_Config(void);
static void MX_GPIO_Init(void);
static void MX_TIM2_Init(void);
static void MX_TIM3_Init(void);
static void MX_TIM4_Init(void);
static void MX_TIM5_Init(void);
                                    
void HAL_TIM_MspPostInit(TIM_HandleTypeDef *htim);
                                

/* USER CODE BEGIN PFP */

/* USER CODE END PFP */

/**
  * @brief  The application entry point.
  *
  * @retval None
  */
int main(void)
{
  /* MCU Configuration----------------------------------------------------------*/

  /* Reset of all peripherals, Initializes the Flash interface and the Systick. */
  HAL_Init();

  /* Configure the system clock */
  SystemClock_Config();

  /* Initialize all configured peripherals */
  MX_GPIO_Init();
  MX_TIM2_Init();
  MX_TIM3_Init();
  MX_TIM4_Init();
  MX_TIM5_Init();
  /* USER CODE BEGIN 2 */
  /* Enable the Capture compare channel */
  TIM_CCxChannelCmd(htim3.Instance, TIM_CHANNEL_1, TIM_CCx_ENABLE);
  TIM_CCxChannelCmd(htim3.Instance, TIM_CHANNEL_2, TIM_CCx_ENABLE);
  TIM_CCxChannelCmd(htim3.Instance, TIM_CHANNEL_3, TIM_CCx_ENABLE);
  TIM_CCxChannelCmd(htim3.Instance, TIM_CHANNEL_4, TIM_CCx_ENABLE);
  /* Enable the main output */
  __HAL_TIM_MOE_ENABLE(&htim3);
  /* Clear the IT pending Bit */
  __HAL_TIM_CLEAR_IT(&htim3, TIM_IT_UPDATE);
  /* Disable the TIM Update interrupt */
  __HAL_TIM_DISABLE_IT(&htim3, TIM_IT_UPDATE);
__HAL_TIM_SET_COMPARE1(&htim3, 499);

__HAL_TIM_SET_COMPARE2(&htim3, 499);
__HAL_TIM_SET_COMPARE3(&htim3, 499);
__HAL_TIM_SET_COMPARE4(&htim3, 499);
__HAL_TIM_ENABLE(&htim3);
/*Enable Timer*/
__HAL_TIM_ENABLE(&htim2);
/* Clear the IT pending Bit */
__HAL_TIM_CLEAR_IT(&htim2, TIM_IT_UPDATE);
/* Disable the TIM Update interrupt */
__HAL_TIM_DISABLE_IT(&htim2, TIM_IT_UPDATE);

/*Enable Timer*/
__HAL_TIM_ENABLE(&htim4);
/* Clear the IT pending Bit */
__HAL_TIM_CLEAR_IT(&htim4, TIM_IT_UPDATE);
/* Disable the TIM Update interrupt */
__HAL_TIM_ENABLE_IT(&htim4, TIM_IT_UPDATE);

/*Enable Timer*/
__HAL_TIM_ENABLE(&htim5);
/* Clear the IT pending Bit */
__HAL_TIM_CLEAR_IT(&htim5, TIM_IT_UPDATE);
/* Disable the TIM Update interrupt */
__HAL_TIM_ENABLE_IT(&htim5, TIM_IT_UPDATE);
  /* USER CODE END 2 */

  /* Infinite loop */
  /* USER CODE BEGIN WHILE */
  while (1)
  {

  /* USER CODE END WHILE */

  /* USER CODE BEGIN 3 */

    i16_PwmLeftTemp = HighPulse[0] - HighPulse[3];
    if(i16_PwmLeftTemp >= 400)
    {
      i16_PwmLeftTemp = 400;
    }
    if(i16_PwmLeftTemp <= -400)
    {
      i16_PwmLeftTemp = -400;
    }
//    if(HighPulse[4] >= 0)
//    {}
//    else
//    {
//      i16_PwmLeftTemp = -i16_PwmLeftTemp;
//    }
    f_PwmLeftTemp = i16_PwmLeftTemp * 2.5f;
    f_PwmLeftFilter += f_Kfilter *(f_PwmLeftTemp - f_PwmLeftFilter);

    i16_PwmRightTemp = HighPulse[0] + HighPulse[3];
    if(i16_PwmRightTemp >= 400)
    {
      i16_PwmRightTemp = 400;
    }
    else if(i16_PwmRightTemp <= -400)
    {
      i16_PwmRightTemp = -400;
    }
//    if(HighPulse[4] >= 0)
//    {}
//    else
//    {
//      i16_PwmRightTemp = -i16_PwmRightTemp;
//    }
    f_PwmRightTemp = i16_PwmRightTemp * 2.5f;
    f_PwmRightFilter += f_Kfilter *(f_PwmRightTemp - f_PwmRightFilter);

    if(f_PwmLeftFilter >= 0)
    {
      u16_PwmLeft = f_PwmLeftFilter;
      __HAL_GPIO_RESET_GPIO(DIR_1_GPIO_Port, DIR_1_Pin);
    }
    else
    {
      u16_PwmLeft = -f_PwmLeftFilter;
      __HAL_GPIO_SET_GPIO(DIR_1_GPIO_Port, DIR_1_Pin);
    }
    if(f_PwmRightFilter >= 0)
    {
      u16_PwmRight = f_PwmRightFilter;
      __HAL_GPIO_RESET_GPIO(DIR_2_GPIO_Port, DIR_2_Pin);
    }
    else
    {
      u16_PwmRight = -f_PwmRightFilter;
      __HAL_GPIO_SET_GPIO(DIR_2_GPIO_Port, DIR_2_Pin);
    }
    __HAL_TIM_SET_COMPARE1(&htim3, u16_PwmLeft);
    __HAL_TIM_SET_COMPARE2(&htim3, u16_PwmRight);


    //RELAY
//    if(HighPulse[5] >= 0)
//    {
//      __HAL_GPIO_RESET_GPIO(RELAY_0_GPIO_Port, RELAY_0_Pin);
//      __HAL_GPIO_RESET_GPIO(RELAY_1_GPIO_Port, RELAY_1_Pin);
//      __HAL_GPIO_RESET_GPIO(RELAY_2_GPIO_Port, RELAY_2_Pin);
//      __HAL_GPIO_RESET_GPIO(RELAY_3_GPIO_Port, RELAY_3_Pin);
//    }
//    else
//    {
//      __HAL_GPIO_SET_GPIO(RELAY_0_GPIO_Port, RELAY_0_Pin);
//      __HAL_GPIO_SET_GPIO(RELAY_1_GPIO_Port, RELAY_1_Pin);
//      __HAL_GPIO_SET_GPIO(RELAY_2_GPIO_Port, RELAY_2_Pin);
//      __HAL_GPIO_SET_GPIO(RELAY_3_GPIO_Port, RELAY_3_Pin);
//    }
    HAL_Delay(1);
  }
  /* USER CODE END 3 */

}

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
