VVCi/Graduate_Thesis/06_Src/object_detect/MutiObjectDetection/MutiObjectDetection-master/mainwindow.h

/*@Author: NinhNN - CoVV
 *@Date: 2020
 *@Note: Open Source GNU/Linux
*/

#ifndef MAINWINDOW_H
#define MAINWINDOW_H

#include <QMainWindow>

namespace Ui {
class MainWindow;
}

class MainWindow : public QMainWindow
{
    Q_OBJECT

public:
    explicit MainWindow(QWidget *parent = 0);
    ~MainWindow();

private:
    Ui::MainWindow *ui;
};

#endif // MAINWINDOW_H
