VVCi/Graduate_Thesis/06_Src/object_detect/MutiObjectDetection/MutiObjectDetection-master/distance.h

/*@Author: NinhNN - CoVV
 *@Date: 2020
 *@Note: Open Source GNU/Linux
*/
#include <unistd.h>
#include <stdint.h>
#include <stdio.h>
#include <stdlib.h>
#include <math.h>
#include <QApplication>

#ifndef DISTANCE_H
#define DISTANCE_H

uint32_t distance(uint32_t w1, uint32_t w2, uint32_t f, uint32_t p);

#endif // DISTANCE_H
