VVCi/Graduate_Thesis/(commit log)

2020-12-15 Updated data
    Init project
    [de-camera-1.stl, de-camera-2.stl, de-camera-3.stl]
2020-12-28 update data
    [mesh-flipped.stl, mesh.stl]
2021-01-03 updated data
    [PID_TEST.xlsx]
