VVCi/Graduate_Thesis/(notices)

Notices in the files:
06_Src/Devo_7/Src/main.c:
(C) COPYRIGHT STMicroelectronics *****END OF FILE
