VVCi/Graduate_Thesis/04_Multimedia/02_Images/2_08_2020/2020_07_31_16_57_IMG_2598.JPG

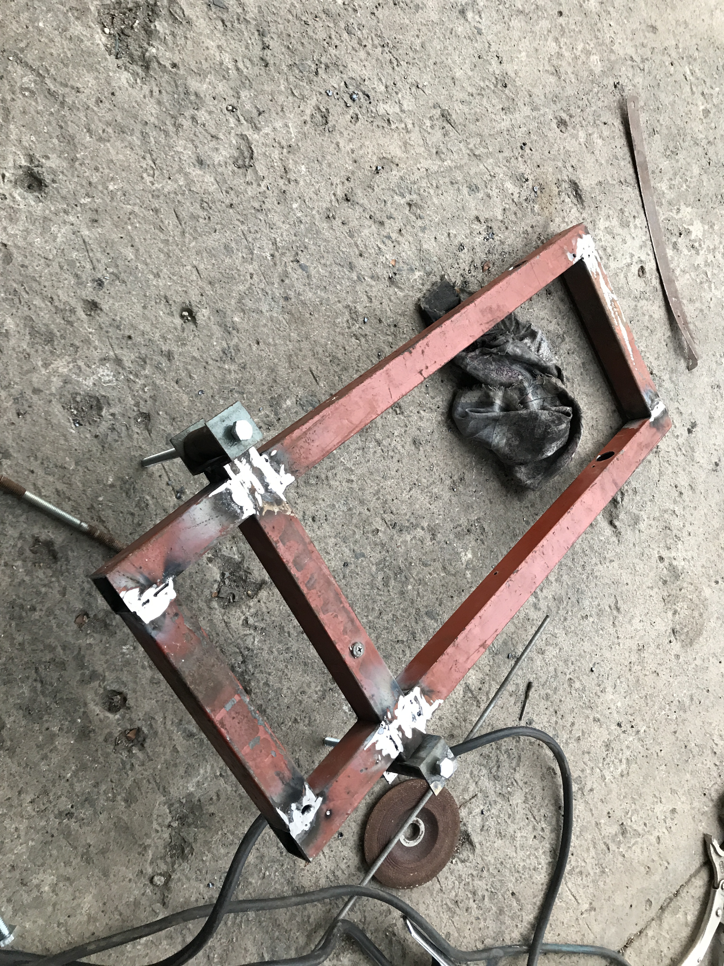
04_Multimedia/02_Images/2_08_2020/2020_07_31_16_57_IMG_2598.JPG
