VVCi/Graduate_Thesis/04_Multimedia/02_Images/10_18_2020/2020_08_10_12_54_IMG_2733.JPG

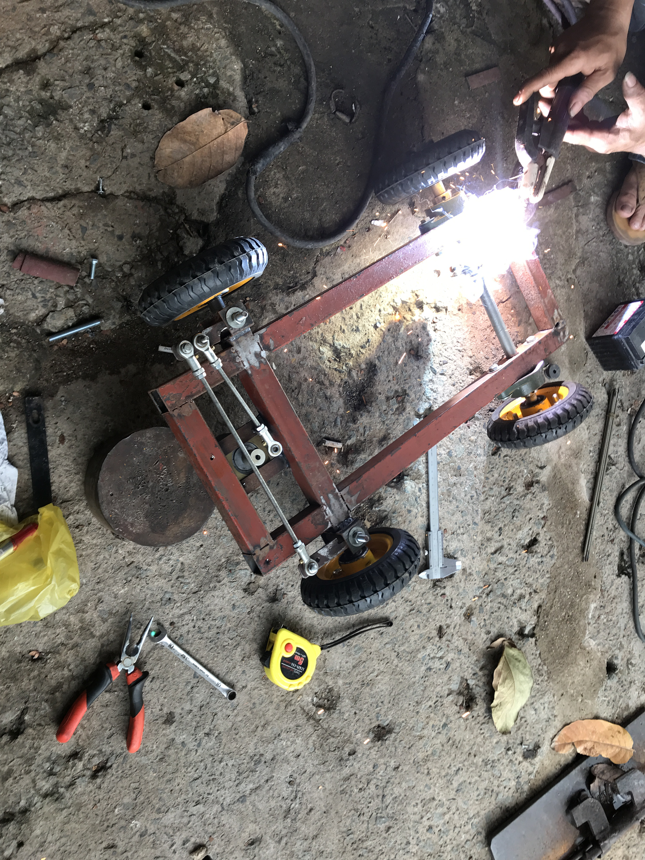
04_Multimedia/02_Images/10_18_2020/2020_08_10_12_54_IMG_2733.JPG
